eSpark-Consulting-Group/alastair-barones-salpha/Design-Files/Display-Interface-Board-v1.0/Deliverables/Renderings/3D-ISOMETRIC.png

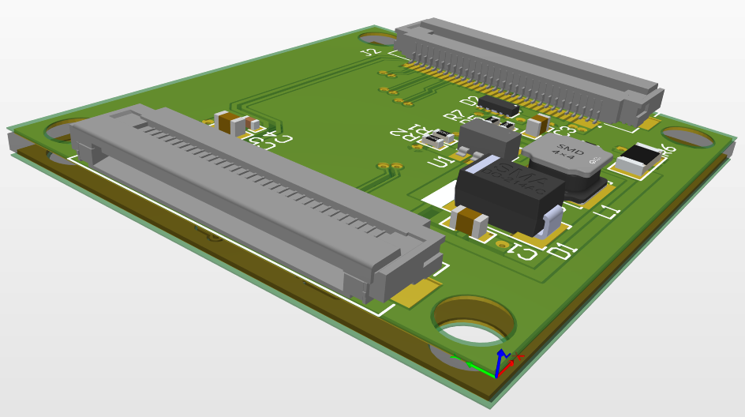
Design-Files/Display-Interface-Board-v1.0/Deliverables/Renderings/3D-ISOMETRIC.png
