eSpark-Consulting-Group/alastair-barones-salpha/README.md

# Baroness Alpha (Bike Gadget - Alastair)

## PRD
PRD is available at [this](https://github.com/eSpark-Consultants/alastair-baronessalpha/blob/main/docs/SD-MVP%20Hardware%20Build-290124-062334.pdf) link
