eSpark-Consulting-Group/alastair-barones-salpha/Design-Files/Breakout_Board/Breakout_Board/Deliverables/Renderings/Isometric_View.PNG

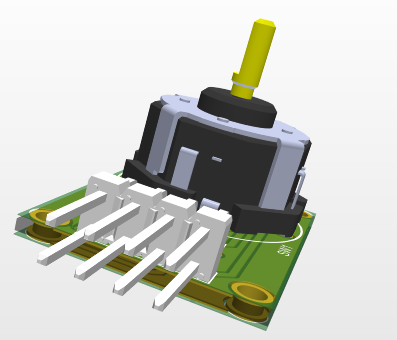
Design-Files/Breakout_Board/Breakout_Board/Deliverables/Renderings/Isometric_View.PNG
