eSpark-Consulting-Group/alastair-barones-salpha/Design-Files/Display-Interface-Board-v1.0/Deliverables/Renderings/2D-BOTTOM.png

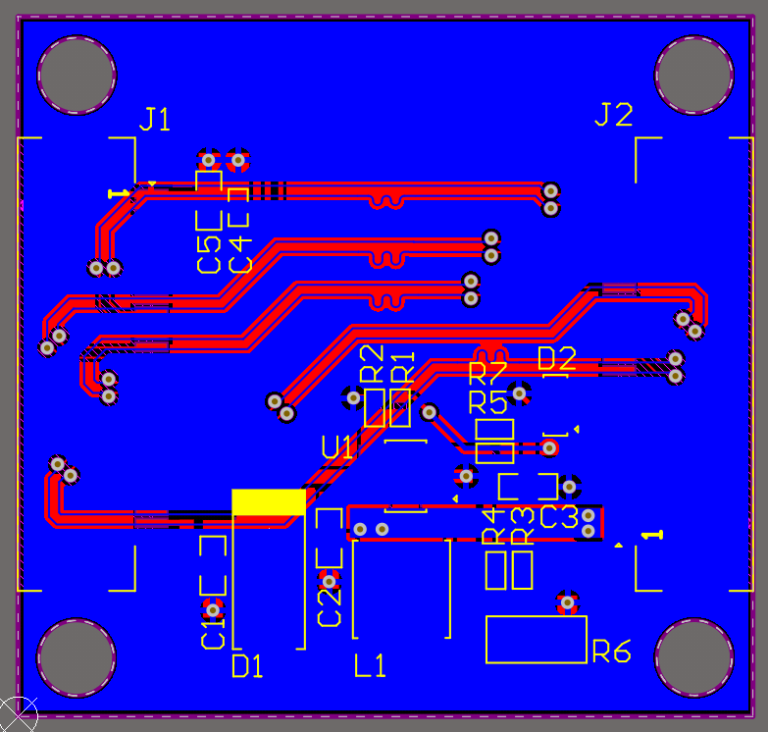
Design-Files/Display-Interface-Board-v1.0/Deliverables/Renderings/2D-BOTTOM.png
