eSpark-Consulting-Group/alastair-barones-salpha/Design-Files/Display-Interface-Board-v1.0/Deliverables/Renderings/2D-TOP.png

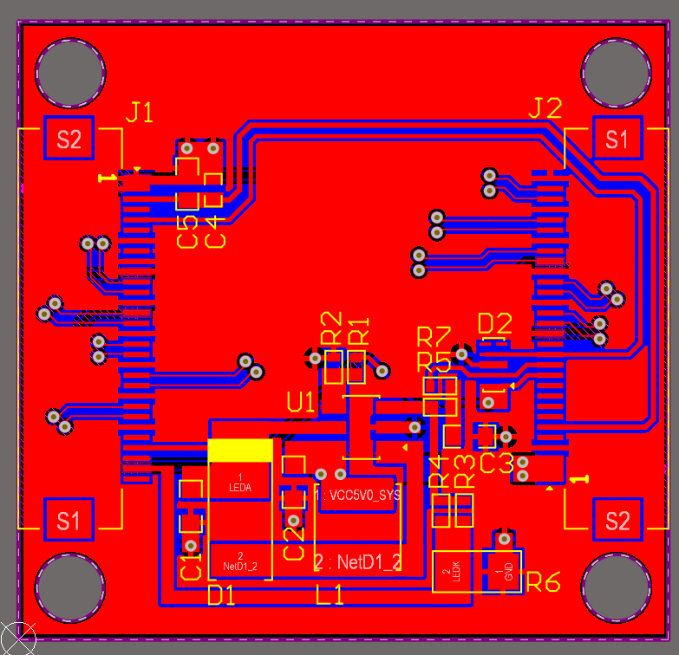
Design-Files/Display-Interface-Board-v1.0/Deliverables/Renderings/2D-TOP.png
