eSpark-Consulting-Group/alastair-barones-salpha/Design-Files/MVP-Dash-v1.0/Deliverables/Gerber File/Impedance Profile/Differential CAN (120 OHM).png

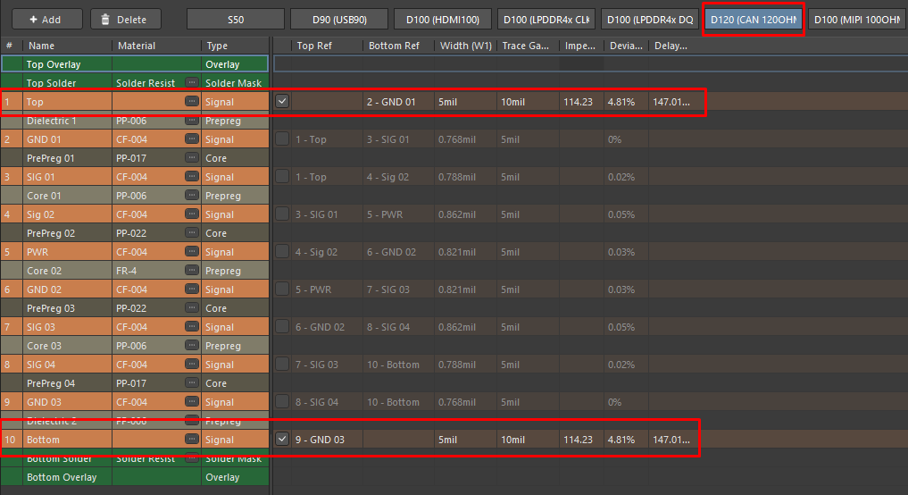
Design-Files/MVP-Dash-v1.0/Deliverables/Gerber File/Impedance Profile/Differential CAN (120 OHM).png
