eSpark-Consulting-Group/alastair-barones-salpha/Design-Files/MVP-Dash-v1.0/Deliverables/Gerber File/Impedance Profile/Differential HDMI (100 OHM).png

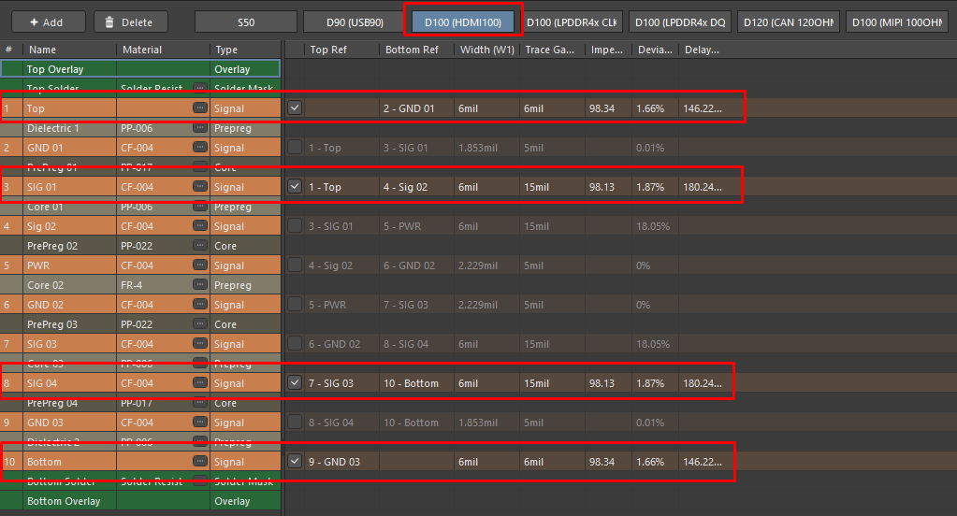
Design-Files/MVP-Dash-v1.0/Deliverables/Gerber File/Impedance Profile/Differential HDMI (100 OHM).png
