eSpark-Consulting-Group/alastair-barones-salpha/Design-Files/MVP-Dash-v1.0/Deliverables/Gerber File/Impedance Profile/DIfferential LPDDR4x CLK (100 OHM).png

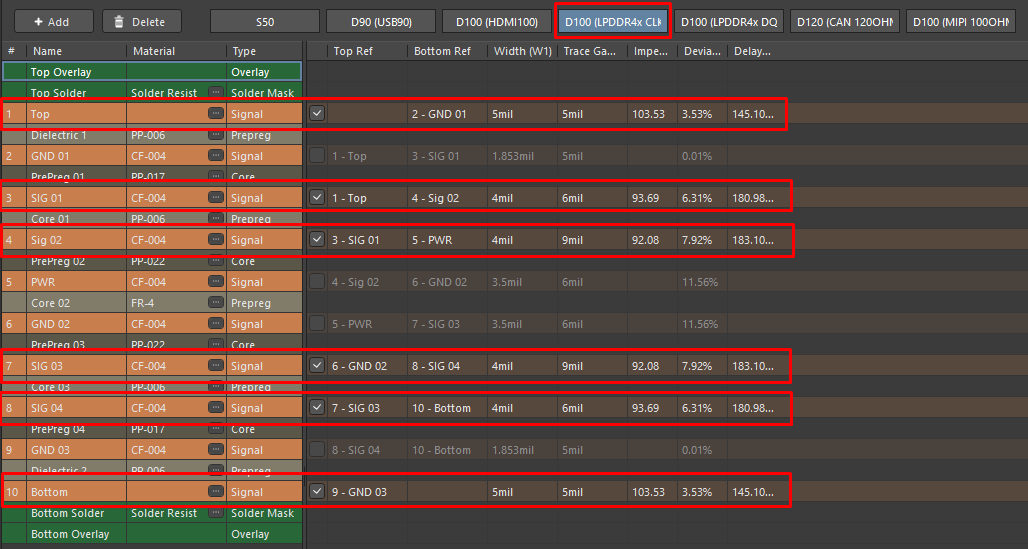
Design-Files/MVP-Dash-v1.0/Deliverables/Gerber File/Impedance Profile/DIfferential LPDDR4x CLK (100 OHM).png
