eSpark-Consulting-Group/alastair-barones-salpha/Design-Files/MVP-Dash-v1.0/Deliverables/Gerber File/Impedance Profile/Differential USB (90 OHM).png

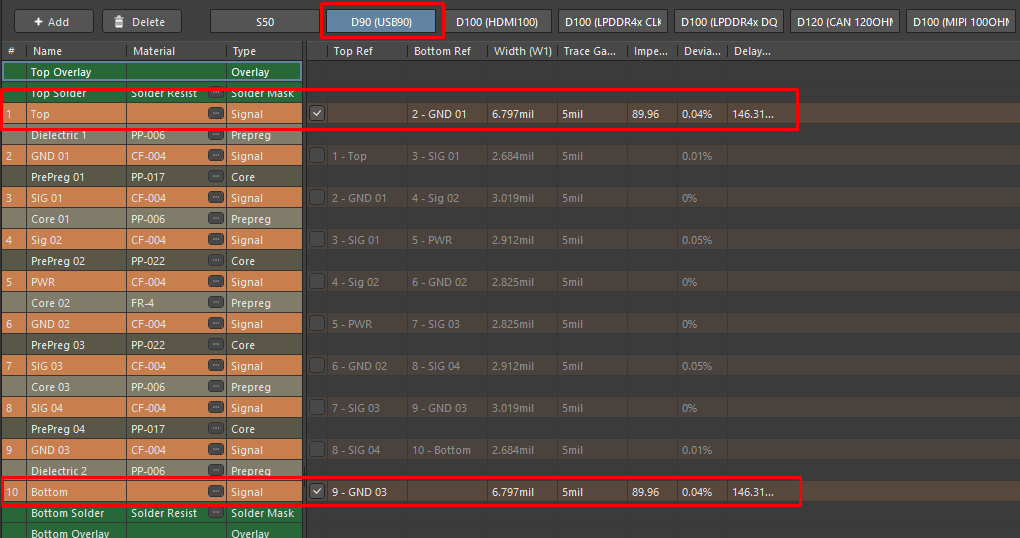
Design-Files/MVP-Dash-v1.0/Deliverables/Gerber File/Impedance Profile/Differential USB (90 OHM).png
