eSpark-Consulting-Group/alastair-barones-salpha/Design-Files/MVP-Dash-v1.0/Deliverables/Renderings/3D-BottomView.png

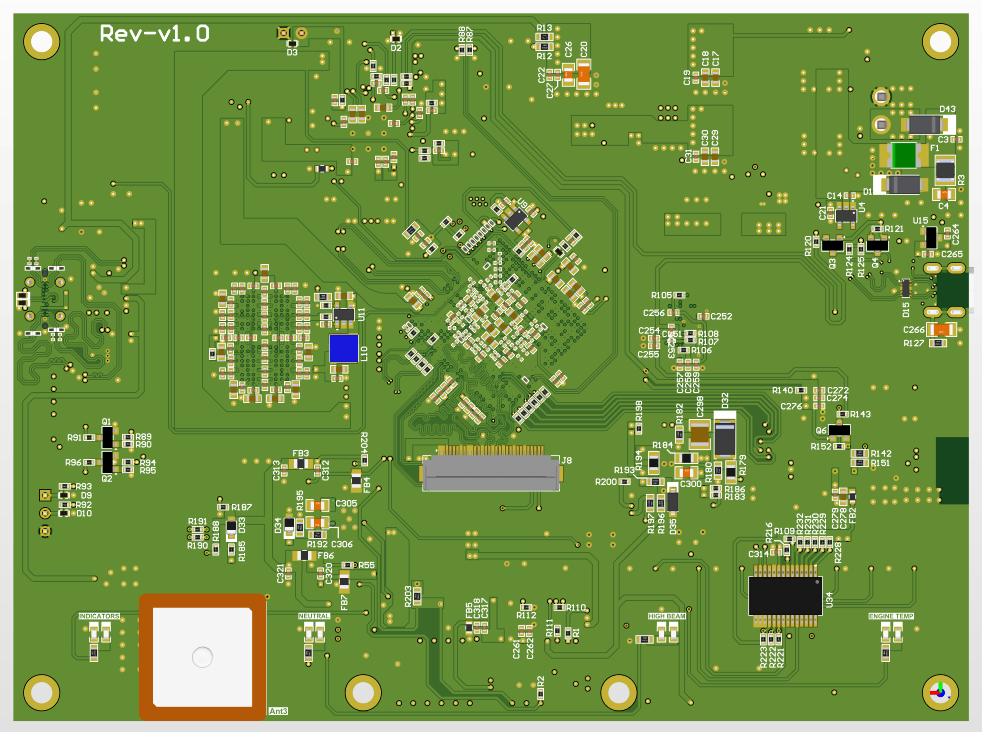
Design-Files/MVP-Dash-v1.0/Deliverables/Renderings/3D-BottomView.png
