eSpark-Consulting-Group/alastair-barones-salpha/Design-Files/MVP-Dash-v1.0/Deliverables/Renderings/3D-TopView.png

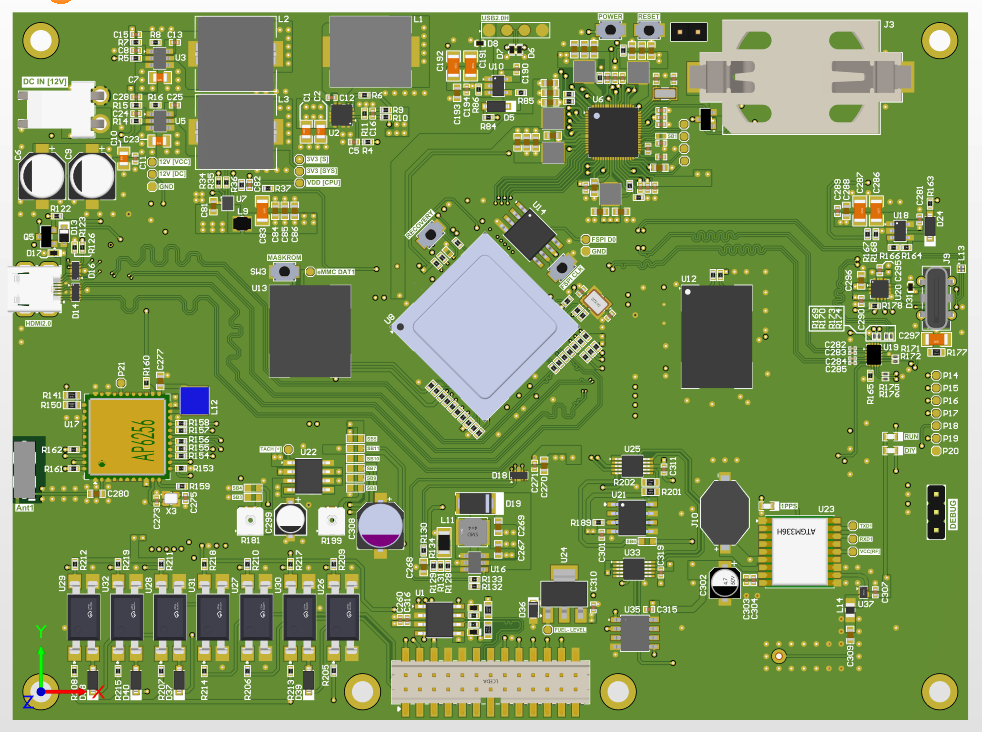
Design-Files/MVP-Dash-v1.0/Deliverables/Renderings/3D-TopView.png
