eSpark-Consulting-Group/alastair-barones-salpha/Design-Files/Pukk MVP Controller Module-v1.0/Deliverables/Renderings/2D Top View.png

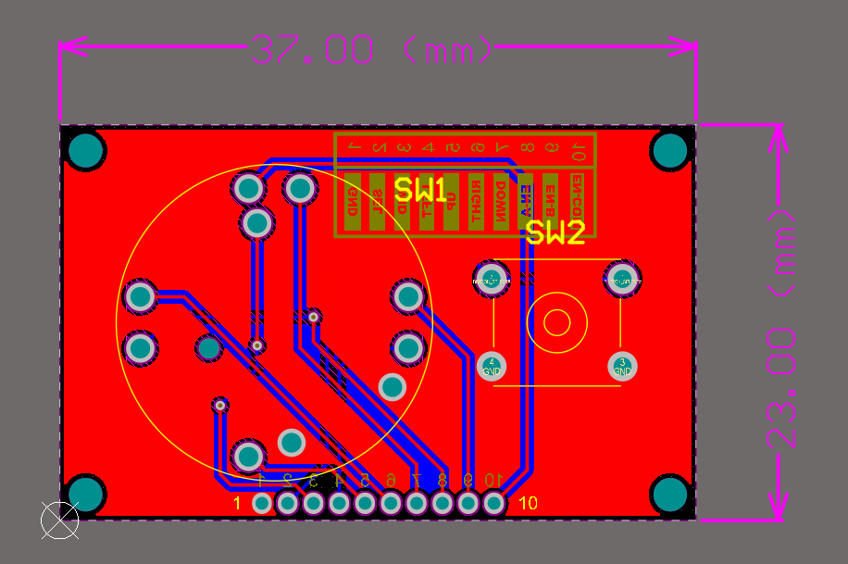
Design-Files/Pukk MVP Controller Module-v1.0/Deliverables/Renderings/2D Top View.png
