eSpark-Consulting-Group/alastair-barones-salpha/Design-Files/Pukk MVP Controller Module-v1.0/Deliverables/Renderings/3D Bottom View.png

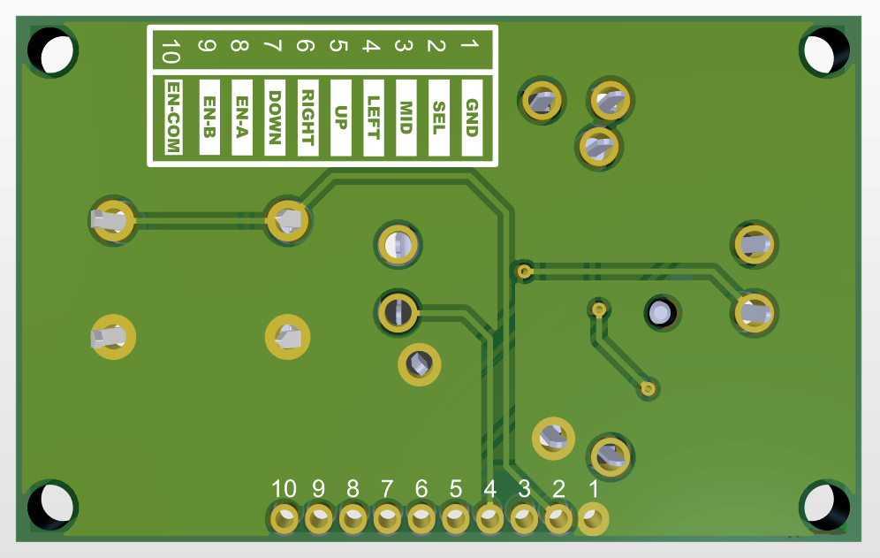
Design-Files/Pukk MVP Controller Module-v1.0/Deliverables/Renderings/3D Bottom View.png
