eSpark-Consulting-Group/alastair-barones-salpha/Design-Files/Pukk MVP Controller Module-v1.0/Deliverables/Renderings/Isometric View.png

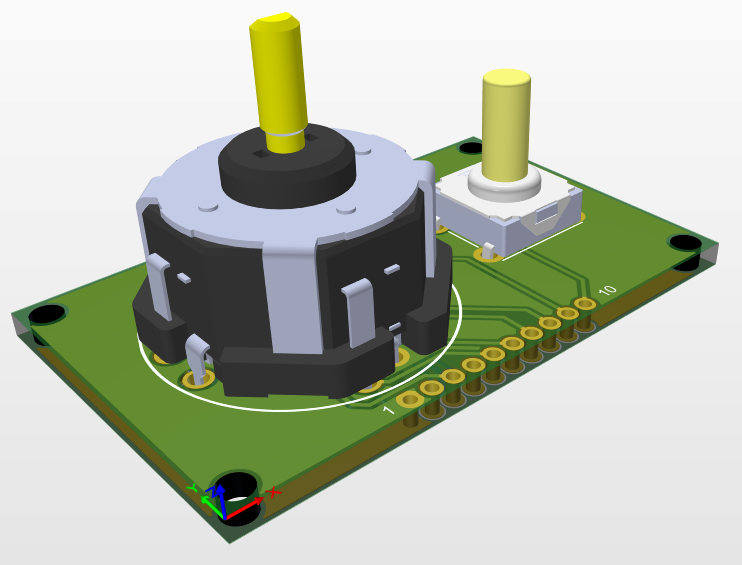
Design-Files/Pukk MVP Controller Module-v1.0/Deliverables/Renderings/Isometric View.png
