eSpark-Consulting-Group/alastair-barones-salpha/Design-Files/Pukk-Display-Module-v1.0/Deliverables/_Renderings/2D_Bottom_View.png

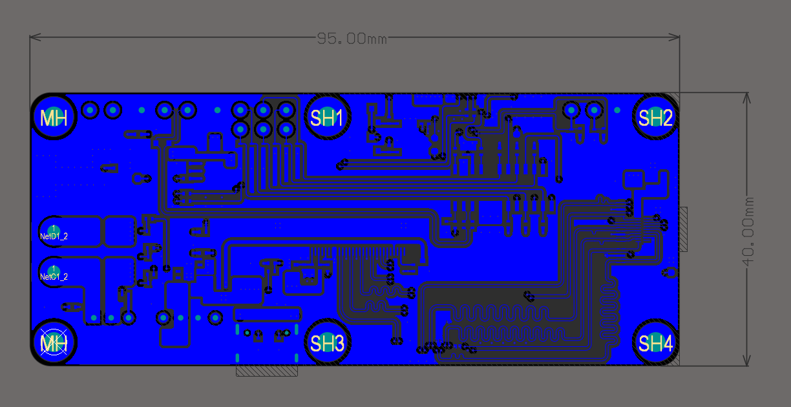
Design-Files/Pukk-Display-Module-v1.0/Deliverables/_Renderings/2D_Bottom_View.png
