eSpark-Consulting-Group/alastair-barones-salpha/Design-Files/Pukk-Display-Module-v1.0/Deliverables/_Renderings/3D_Isometric_View.png

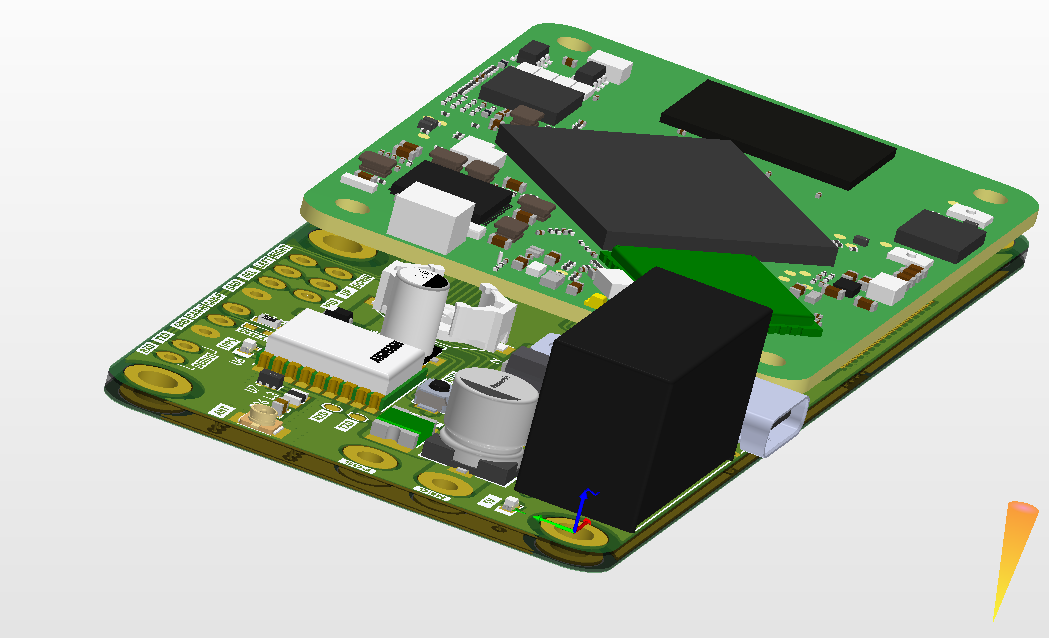
Design-Files/Pukk-Display-Module-v1.0/Deliverables/_Renderings/3D_Isometric_View.png
