eSpark-Consulting-Group/alastair-barones-salpha/Design-Files/Pukk-Display-Module-v1.0/BOM/Client-BOM-Pukk-Display-Module-v1.0.xlsx

# | Item Type | Designator | Description | Footprint | Manufacturer Part Number | Manufacturer | Value | Quantity | Link | Remarks
1 | Capacitor | C1 | CAP ALUM POLY 47UF 20% 25V SMD | 25SVPF47M | 25SVPF47M | Panasonic | 47uF | 1
2 | Capacitors | C2, C6 | CAP CER 10UF 25V X5R 0603 | Cap-0603 | GRM188R61E106MA73D | Murata | 10uF | 2
3 | Capacitors | C3 | CAP CER 1UF 25V X7R 0603 | Cap-0603 | C1608X7R1E105K080AB | TDK | 1uF | 1
4 | Capacitors | C4 | CAP CER 0.1UF 25V X7R 0603 | Cap-0603 | CC0603JRX7R8BB104 | Yageo | 0.1uF | 1
5 | Capacitor | C5 | CAP CER 22UF 10V X7R 0805 | Cap-0805 | GRM21BZ71A226ME15L | Murata | 22uF | 1
6 | Capacitor | C7, C9, C10, C12, C14, C15, C17 | CAP CER 0.1UF 16V X5R 0402 | Cap-0402 | CC0402KRX5R7BB104 | Yageo | 100nF | 7
7 | Capacitor | C8 | CAP CER 22UF 10V X5R 0402 | Cap-0402 | GRM158R61A226ME15D | Murata | 22uF | 1
8 | Capacitor | C11, C13, C24 | CAP CER 4.7UF 10V X5R 0402 | Cap-0402 | CC0402KRX5R6BB475 | Yageo | 4.7uF | 3
9 | Capacitor | C16, C18 | CAP CER 10UF 10V X5R 0402 | Cap-0402 | CC0402MRX5R6BB106 | Yageo | 10uF | 2
10 | Capacitor | C19, C20, C25, C33, C35 | CAP CER 0.1UF 50V X7R 0402 | Cap-0402 | GRM155R71H104ME14D | Murata | 0.1uF | 5
11 | Capacitor | C21, C22 | CAP CER 1UF 50V X5R 0603 | Cap-0603 | CL10A105KB8NNNC | Samsung | 1uF | 2
12 | Capacitor | C23 | CAP CER 0.22UF 25V X5R 0402 | Cap-0402 | CC0402KRX5R8BB224 | Yageo | 220nF | 1
13 | Capacitor | C26 | CAP CER 100PF 50V C0G/NPO 0603 | Cap-0603 | CC0603JRNPO9BN101 | Yageo | 100pF | 1
14 | Capacitor | C27, C29, C80 | CAP CER 0.1UF 10V X5R 0402 | Cap-0402 | CC0402KRX5R6BB104 | Yageo | 0.1uF | 3
15 | Capacitor | C28 | CAP ALUM 10uF 25V SMD | Custom | RVT1E100M0405 | ROQANG | 10uF | 1
16 | Capacitor | C30 | CAP CER 0.033UF 25V X7R 0402 | Cap-0402 | CC0402KRX7R8BB333 | Yageo | 33nF | 1
17 | Capacitor | C32, C34 | CAP CER 4.7UF 16V X5R 0402 | Cap-0402 | CL05A475MO5NUNC | Samsung | 4.7uF | 2
18 | Diode | D1 | DIODE SCHOTTKY 60V 5A SMA | SMA | SS56 | MDD | - | 1
19 | Diode | D2 | 24V 350W 13.3V 12V SOD-323 ESD and Surge Protection (TVS/ESD) ROHS | SOD-323 (Bi-directional) | SD12C.TCT | SEMTECH | - | 1
20 | Diode | D3 | TVS DIODE 5VWM 9.2VC SMA | SMA Bi Directional | SMAJ5.0CA | FTR | - | 1
21 | TVS Diodes | D4 | TVS DIODE 24VWM 40VC SOT23-3 | SOT-23 | CDSOT23-T24CAN-Q | Bourns | - | 1
22 | Diode | D5, D14, D15, D17, D18, D19, D20, D21, D22, D23 | DFN1006-2(0402) ESD Protection Devices ROHS | DFN1006-2L (Bi-Directional) | ESD5451N | TECH PUBLIC | - | 10
23 | Diode | D6, D7, D11 | 4A@8/20us 15V 7V 5V Unidirectional DFN1006-2L TVS ROHS | DFN1006-2L_ | ESD5341N-2/TR | WILLSEMI | - | 3
24 | Diode | D8, D9, D10 | 4A@8/20us 12V 7V 5V Unidirectional DFN2510-10L TVS ROHS | DFN2510-10L_ | ESD5304D-10/TR | WILLSEMI | - | 3
25 | Schottky Diode | D12 | 60V 700mV@1A 1A SMA(DO-214AC) Schottky Barrier Diodes (SBD) ROHS | SMA | SS16 | MDD | - | 1
26 | Diode | D13 | DIODE SCHOTTKY 40V 1A SOD323 | SOD-323 | B5819WS-TP | MDD | - | 1
27 | Fuse | F1 | 33V 1.5A 40A 3A 1812 Resettable Fuses ROHS | Fuse-1812_ | BSMD1812-150-33V | BHFUSE | - | 1
28 | Ferrite Bead | FB1 | 0603 180Ω ±25% DCR=0.09Ω 1.5A | IND-0603 (1608 Metric) | BLM18PG181SN1D | Murata | - | 1
29 | Connector | J2 | SMD HDMI Connectors ROHS | Custom | HDMI-101W | XUNPU | - | 1
30 | FFC / FPC Connector | J3 | CONN FFC BOTTOM 30POS 0.5MM R/A | Custom | TF31-30S-0.5SH(800) | Hirose | - | 1
31 | Battery Connector | J4 | SMD Button And Strip Battery Connector ROHS | Custom | PB-621SR13-TF | JST | - | 1
32 | RF / Coaxial Connectors | J6 | CONN U.FL RCPT STR 50 OHM SMD | Custom | U.FL-R-SMT-1(10) | Hirose | - | 1
33 | Common Mode Filter | L1 | 90Ω@100MHz 4Ω 2 0302 Common Mode Filters ROHS | 302 | SDMM0806H-2-900T | Sunlord | - | 1
34 | Inductors | L2 | FIXED IND 22UH 750MA 496MOHM SMD | Custom | VLCF5020T-220MR75-1 | TDK | 22uH | 1
35 | Inductor | L3 | 600mA 6.8nH ±5% 110mΩ 0805 Inductors (SMD) ROHS | Ind-0805 | BKW0805UC6N8JGT | FH-BK | 6.8nH | 1
36 | LED | LED1, LED4 | RED LED 0603 Light Emitting Diodes | LED-0603 | NCD0603R3 | Foshan NationStar Optoelectronics | - | 2
37 | LED | LED2 | Emerald 0603 Light Emitting Diodes (LED) ROHS | LED-0603 | NCD0603G2 | Foshan NationStar Optoelectronics | - | 1
38 | LED | LED3 | yellow 0603 Light Emitting Diodes (LED) ROHS | LED-0603 | NCD0603Y2 | Foshan NationStar Optoelectronics | - | 1
39 | Transistor | Q1, Q2 | Trans Gp Bjt NPN 25V 1.5A 300MW 3-PIN SOT-23 T/r | SOT-23 | SS8050-G | Comchip | - | 2
40 | Resistor | R1 | RES 499 OHM 1% 1/16W 0402 | Res-0402 | RC0402FR-07499RL | Yageo | 499R | 1
41 | Resistor | R2 | RES 0 OHM JUMPER 1/8W 0805 | Res-0805 | RC0805FR-070RL | Yageo | 0R | 1
42 | Resistor | R3, R19, R33, R34 | RES 10K OHM 1% 1/16W 0402 | Res-0402 | RC0402FR-0710KL | Yageo | 10K | 4
43 | Resistors | R4 | RES SMD 6.8K OHM 0.1% 1/16W 0402 | Res-0402 | RT0402BRC076K8L | Yageo | 6.8K | 1
44 | Resistor | R5 | RES 4.7K OHM 1% 1/16W 0402 | Res-0402 | RC0402FR-074K7L | Yageo | 4.7K | 1
45 | Resistor | R6, R7, R8, R9, R10, R17, R23, R24, R25, R27, R28, R32 | RES 0 OHM JUMPER 1/16W 0402 | Res-0402 | RC0402FR-070RL | Yageo | 0R | 12
46 | Resistor | R11 | RES 120 OHM 1% 1/10W 0603 | Res-0603 | RC0603FR-07120RL | Yageo | 120R | 1
47 | Resistor | ~~R12~~ | ~~RES 0 OHM JUMPER 1/8W 0805~~ | ~~Res-0805~~ | ~~RC0805FR-070RL~~ | ~~Yageo~~ | ~~DNP~~ | ~~1~~ |  | ~~DO NOT PLACE~~
48 | Resistor | R13, R14 | RES 5.1K OHM 1% 1/16W 0402 | Res-0402 | RC0402FR-075K1L | Yageo | 5.1K | 2
49 | Resistor | R15, R37, R121, R122, R123, R124, R125 | RES 1K OHM 1% 1/16W 0402 | Res-0402 | RC0402FR-071KL | Yageo | 1K | 7
50 | Resistors | ~~R16, R20~~ | ~~RES 0 OHM JUMPER 1/16W 0402~~ | ~~Res-0402~~ | ~~RC0402FR-070RL~~ | ~~Yageo~~ | ~~DNP~~ | ~~2~~ |  | ~~DO NOT PLACE~~
51 | Resistor | R18 | RES 5.1 OHM 5% 1/8W 0805 | RES-0805 | RC0805JR-075R1L | Yageo | 5.1R | 1
52 | Resistor | R21 | RES 1.5K OHM 1% 1/16W 0402 | Res-0402 | RC0402FR-071K5L | Yageo | 1.5K | 1
53 | Resistor | R22, R26, R29, R30, R31 | RES 100 OHM 1% 1/16W 0402 | Res-0402 | RC0402FR-07100RL | Yageo | 100R | 5
54 | Resistor | R35, R36 | RES 100K OHM 1% 1/16W 0402 | Res-0402 | RC0402FR-07100KL | Yageo | 100K | 2
55 | Switch | SW1, SW2, SW3 | SWITCH TACTILE SPST-NO 0.05A 12V | Custom | B3U-1000P | Omron | - | 3
56 | Power Module | U1 | SIP Isolated Power Modules ROHS | Custom | VRB1205S-10WR3 | YLPTEC | - | 1
57 | IC | U2 | IC TRANSCEIVER 1/1 8SOIC | SOIC-8(0.154", 3.90mm Width) | TCAN1044VDRQ1 | Texas Instruments | - | 1
58 | USB Connector | U3 | 5A 1 16P Female Type-C SMD USB Connectors ROHS | Custom | TYPE-C-31-M-12 | Korean Hroparts Elec | - | 1
59 | IC | U4 | IC CURRENT SWITCH SOT23-3 | SOT-23 | AP2331SA-7 | Diodes | - | 1
60 | IC | U5 | IC LED DRV RGLTR PWM 700MA 6WSON | WSON-6-EP(2x2) | TPS61161ADRVR | Texas Instruments | - | 1
61 | IC | U6 | SMD,10.1x9.7mm Satellite Positioning Modules ROHS | Custom | ATGM336H-6N-74 | ZHONGKEWEI | - | 1
62 | LNA | U7 | 1.4V~3.6V 4.3mA DFN-6(1x1.6) Low Noise Amplifiers (LNA) - RF ROHS | DFN-6(1x1.6) | AT2659 | ZHONGKEWEI | - | 1
63 | IC | U8 | IC REG LINEAR 3.3V 1.3A 6DFN | DFN-6(3x3) | ST1L05APU33R | STMicroelectronics | - | 1
64 | Headers and Wire Housings | U13A, U13B | CONN RCPT 100POS SMD GOLD | Custom | DF40C-100DS-0.4V(51) | Hirose | - | 2
65 | IC | U16 | IC INVERT SCHMITT 6CH 1IN 14SOIC | SOIC-14 | SN74HC14QDRQ1 | Texas Instruments | - | 1
66 | Peripheral | Compute Module | Radxa CM3J RK3568J 4-core CPU, Industrial Compute Module, GPU, NPU, 4K HDMI and 2x100-Pin B2B Connector | Custom | CM3J (Color: 2GB 8GB) | Radxa | - | 1 | Aliexpress (https://vi.aliexpress.com/item/1005008626884786.html) | Need to select the module with 2GB RAM and 8GB storage.
67 | Peripheral | Antenna | Active Antenna Active Ceramic Antenna With Our GPS MINI Use Ipex Interface 6M Series Universal | Custom | - | Mingwudianzi | - | 1 | Aliexpress (https://vi.aliexpress.com/i/1005004493081586.html?gatewayAdapt=glo2vnm4itemAdapt)
68 | Peripheral | Battery Cell | MC621 621 Button lithium Industrial Lithium Battery | Custom | MC621 | - | - | 1 | Aliexpress (https://vi.aliexpress.com/item/32855104889.html?pdp_)
69 | Peripheral | LCD | FHD 5.0 inch 1920x1080 SC5010 full viewing angle high brightness MIPI interface tft lcd panel display | Custom | KD050FHFID103 | - | - | 1 | Alibaba (https://www.alibaba.com/product-detail/FHD-5-0-inch-1920x1080-SC5010_1601156448052.html)
