eSpark-Consulting-Group/alastair-barones-salpha/Design-Files/Pukk-Sensor-Module-v1.0/BOM/JLCPCB-BOM-Pukk-Sensor-Module-v1.0.xlsx

Comment | Designator | Footprint | LCSC Part Number
22uF | C1, C9, C10 | Cap-0805 | C907991
100uF | C2 | EEE-FK1E101XP | C128510
330uF | C3, C43, C44, C45 | UWT1E331MNL1GS | C445067
10uF | C4 | Cap-0805 | C89831
1uF | C5 | Cap-0805 | C2167382
0.1uF | C6 | Cap-0805 | C1760
0.1uF | C7 | Cap-0603 | C307348
10uF | C8 | Cap-1210 | C596319
4.7uF | C11 | Cap-1206 | C92853
4.7uF | C12, C31, C34 | Cap-0603 | C90057
2.2uf | C13, C14 | Cap-0402 | C385032
4.7uF | C15, C30 | Cap-0402 | C326586
0.1uF | C16, C17, C18, C19, C20, C23, C25, C26, C29, C32, C33 | Cap-0402 | C541464
1uF | C21, C22, C24, C39, C40 | Cap-0402 | C326568
12pF | C27, C28 | Cap-0402 | C161305
0.1uF | C35, C36, C37, C38, C41, C42 | Cap-0402 | C105883
22uF | C46 | Cap-0805 | C86816
4.7uF | C47 | Cap-0805 | C354262
SS26 | D1 | SMA(DO-214AC) | C14238
SMAJ5.0CA | D2, D4 | SMA Bi Directional | C693487
SD15C.TCT | D3 | SOD-323 (Bi-directional) | C780130
MSP3V3HM3/89A | D5 | MicroSMP | C241899
ESDM2033MX4T5G | D6, D7, D8, D9, D10 | DFN-2(0.3x0.6) | C896720
ESDALC6V1W5 | D11 | SOT-323-5 | C703691
ESDALC6V1-1U2 | D12 | Diode-0201 | C1974498
1N4148W | D13, D16, D18, D19, D20, D22, D23, D24, D25 | SOD-123 | C917030
ES1B | D14 | SMA(DO-214AC) | C232818
1SMB5949BT3G | D15 | SMB_ | C150045
1N4148W-7-F | D17 | SOD-123 | C83528
MSP3V3HM3/89A | D21 | MicroSMP | C241899
CDSOT23-T24CAN-Q | D26, D27 | SOT-23 | C350941
1SMA4755A | D28 | SMA | C438373
0805L110SLYR | F1, F4 | Fuse-0805 | C207024
1210L075/24PR | F2 | FUSE-1210 | C207045
0805L050WR | F3 | Fuse-0805 | C207022
MMZ2012R102ATD25 | FB1, FB2 | Ind-0805 | C307765
X6511WV-03H-C60D30 | J1 | HDR1X3_ | C706875
U-E-051N-4BH21-S1B | J3 | U-E-051N-4BH21-S1B | C319153
5000 | J15 | 5000 | C5199900
5001 | J16 | 5001 | C238122
5012 | J17 | 5012 | C2906766
4.7uH | L1 | SRN4018-4R7M | C780206
RED | LED1, LED2, LED3, LED4 | LED-0603 | C3151730
Yellow | LED5 | LED-0603 | C89811
10K | R1, R11, R28, R47, R55, R61, R68, R74, R78, R83 | Res-0402 | C60490
3.9K | R2, R94 | Res-0402 | C131467
6.8K | R3 | Res-0402 | C852943
499R | R4, R6 | Res-0402 | C137970
240R | R5, R29 | Res-0402 | C114755
0R | R7, R8, R9, R10, R12, R13, R14, R15, R16, R17, R18, R19, R20, R21, R22, R23, R24, R25, R26, R27, R30, R31, R32, R33, R34, R35, R36, R37, R38, R39, R40, R41, R42, R43, R44, R45, R46, R48, R49, R50, R51, R52, R54, R56, R57, R58, R59, R84 | Res-0402 | C106231
120R | R53, R60 | Res-0603 | C114640
4.7K | R62, R72, R97, R98, R99, R100, R101 | Res-0402 | C105871
1K | R63, R69, R75, R80, R85, R89, R95 | Res-0402 | C106235
680R | R64, R65, R70, R71, R73, R76, R77, R81, R82, R86, R88, R90, R92, R96 | Res-0402 | C137948
1K | R66 | Res-1206 | C131398
330R | R67 | Res-1206 | C114944
75R | R79 | Res-0603 | C112309
49.9K | R87 | Res-0402 | C137969
10K | R91, R93 | Res-0603 | C95204
DNP | R102, R103 | Res-0603 | C95177
B3U-1000P | SW1, SW2 | B3U-1000P | C231329
VRB1205S-6WR3 | U1 | VRB1205S-6WR3 | C5369846
AP63205WU-7 | U2 | TSOT-23-6 | C2071056
ST1L05APU33R | U3 | DFN-6(3x3) | C283488
STM32H723VGT6 | U4 | LQFP-100 | C730142
USBLC6-2SC6 | U5 | SOT-23-6 | C2827654
TCAN3414DR | U6 | SOIC-8(0.154", 3.90mm Width) | C22396693
ISO1042DWR | U7 | SOIC-16-300mil | C1848126
SN74AHC1G14DBVR | U8, U14 | SOT-23-5 | C7469
VOS617A-4T | U9, U10, U11, U12, U13, U15, U16, U17, U19, U20, U21, U22, U24, U25, U27 | SOIC-4-175mil | C4749236
LM317MDCYR | U18 | SOT- 223 | C840113
ADS1115IDGSR | U23 | VSSOP-10 | C37593
ISO1540DR | U26 | SOIC-8(0.154", 3.90mm Width) | C179739
48MHz | X1 | SMD2016-4P | C3013790
