eSpark-Consulting-Group/alastair-barones-salpha/Design-Files/MVP-Dash-v1.0/BOM/Client_BOM.xlsx

# | Item Type | Designator | Description | Footprint | Manufacturer Part Number | Manufacturer | Comment | Quantity | #Column Name Error:' Remarks
1 | RF Antennas | Ant1 | RF ANT 2.4GHZ/5GHZ CHIP SLDR SMD | M830520 | M830520 | Kyocera AVX | 2.4GHZ/5GHZ | 1
2 | Antenna | Ant3 | GPS passive ceramic antenna, size 18*18* | KH-GPS181804-WY | KH-GPS181804-WY | Shenzhen Kinghelm Elec | KH-GPS181804-WY | 1
3 |  | C1, C2, C7, C10, C23, C26, C305, C306 | CAP CER 10UF 50V X5R 0805 | Cap-0805 | GRM21BR61H106ME43L | Murata | 10uF | 8
4 | Capacitor | C3, C5, C8, C11, C12, C13, C19, C22, C24, C25, C27, C31, C264, C265, C301 | CAP CER 0.1UF 50V X7R 0402 | Cap-0402 | GRM155R71H104ME14D | Murata | 0.1uF | 15
5 | Capacitor | C4 | CAP CER 2.2UF 50V X5R 0805 | Cap-0805 | CC0805KKX5R9BB225 | Yageo | 2.2uF | 1
6 | Capacitor | C6, C9 | 100uF 50V ±20% SMD,D6.3xL7.7mm Aluminum Electrolytic Capacitors - SMD ROHS | RVT1H101M0607 | RVT1H101M0607 | ROQANG | 100uF | 2
7 |  | C14, C21 | CAP CER 1UF 25V X5R 0402 | Cap-0402 | CC0402KRX5R8BB105 | Yageo | 1uF | 2
8 | Capacitor | C15, C28 | CAP CER 56PF 50V C0G/NPO 0402 | Cap-0402 | CC0402FRNPO9BN560 | Yageo | 56pF | 2
9 | Capacitor | C16 | CAP CER 100PF 50V C0G/NPO 0402 | Cap-0402 | CC0402JRNPO9BN101 | Yageo | 100pF | 1
10 | Capacitor | C17, C18, C29, C30, C43, C81, C193, C288 | CAP CER 22UF 10V X5R 0603 | Cap-0603 | CC0603MRX5R6BB226 | Yageo | 22uF | 8
11 | Capacitor | C20, C83, C191, C192, C286, C287 | CAP CER 47UF 25V X5R 1206 | Cap-1206 | GRM31CR61E476ME44L | Murata | 47uF | 6
12 | Capacitor | C32, C33, C38, C39, C45, C46, C52, C53, C55, C56, C66, C77, C80, C196 | CAP CER 10UF 10V X5R 0603 | Cap-0603 | CC0603KRX5R6BB106 | Yageo | 10uF | 14
13 | Capacitor | C34, C35, C44, C47, C49, C54, C82, C88, C194, C203, C206, C207, C208, C209, C210, C211, C212, C213, C214, C215, C217, C218, C219, C220, C221, C222, C223, C224, C225, C226, C227, C228, C229, C232, C233, C234, C235, C236, C237, C239, C240, C241, C242, C243, C244, C245, C246, C247, C248, C249, C250, C253, C254, C256, C257, C258, C261, C263, C271, C276, C279, C289, C303, C307, C314, C315, C316, C318 | CAP CER 0.1UF 10V X5R 0402 | Cap-0402 | CC0402KRX5R6BB104 | Yageo | 0.1uF | 68
14 |  | C36, C37, C50, C51, C78, C79, C84, C85, C86, C95, C96, C98, C99, C100, C101, C102, C103, C104, C197, C198, C216 | CAP CER 22UF 6.3V X5R 0603 | Cap-0603 | CC0603MRX5R5BB226 | Yageo | 22uF | 21
15 | Capacitor | C40, C41 | CAP CER 18PF 50V C0G/NP0 0402 | Cap-0402 | GCM1555C1H180GA16D | Murata | 18pF | 2
16 |  | C42, C87, C255, C259, C260, C262 | CAP CER 4.7UF 10V X5R 0402 | Cap-0402 | CC0402KRX5R6BB475 | Yageo | 4.7uF | 6
17 | Capacitor | C48, C57, C59, C60, C62, C63, C64, C65, C67, C68, C69, C71, C72, C73, C74, C75, C76, C119, C120, C121, C122, C132, C152, C153, C166, C167, C169, C173, C175, C176, C177, C183, C185, C188, C190, C204, C205, C272, C274, C281, C290, C295 | CAP CER 1UF 10V X5R 0402 | Cap-0402 | CC0402KRX5R6BB105 | Yageo | 1uF | 42
18 | Capacitor | C58, C61, C252 | CAP CER 2.2UF 6.3V X5R 0402 | Cap-0402 | C1005X5R0J225KTJA0E | TDK | 2.2uF | 3
19 | Capacitor | C70, C92, C93, C94, C112, C113, C114, C115, C117, C139, C142, C148, C149, C182, C184 | CAP CER 4.7UF 6.3V X5R 0402 | Cap-0402 | CC0402KRX5R5BB475 | Yageo | 4.7uF | 15
20 |  | C89, C90, C91, C108, C109, C110, C111, C124, C125, C126, C127, C128, C129, C130, C131, C133, C134, C135, C136, C137, C138, C140, C141, C143, C144, C145, C146, C147, C150, C151, C154, C155, C164, C165, C168, C170, C171, C172, C174, C178, C179, C180, C181, C186, C187, C189, C251, C282, C283, C284, C285, C291, C292, C293, C294 | CAP CER 0.1UF 10V X5R 0201 | CAP-0201 | CC0201KRX5R6BB104 | Yageo | 100nF | 55
21 | Capacitor | C97 | CAP CER 1UF 6.3V X5R 0201 | Cap-0201 | CC0201KRX5R5BB105 | Yageo | 1uF | 1
22 | Capacitor | C105, C106, C107, C116, C199, C200, C201, C202, C230, C231, C270, C278 | CAP CER 10UF 6.3V X5R 0603 | Cap-0603 | GRM188R60J106ME47D | Murata | 10uF | 12
23 | Capacitor | C118, C123 | CAP CER 10PF 50V C0G/NP0 0402 | Cap-0402 | GRM1555C1H100JA01D | Murata | 10pF | 2
24 | Capacitor | C156, C157, C158, C159, C160, C161, C162, C163 | 50V 1nF X7R ±10% 0201 Multilayer Ceramic Capacitors MLCC - SMD/SMT ROHS | CAP-0201 | 0201B102K500NT | FH | 1nF | 8
25 | Capacitor | C195 | CAP CER 1000PF 50V C0G/NP0 0402 | Cap-0402 | GRM1555C1H102JA01D | Murata | 1nF | 1
26 | Capacitor | C238 | CAP CER 1000PF 50V C0G/NP0 0402 | Cap-0402 | GRM1555C1H102JA01D | Murata | DNP | 1 | Do Not Place
27 | Capacitor | C266, C297 | CAP CER 4700PF 1KV X7R 1206 | Cap-1206 | CC1206KKX7RCBB472 | Yageo | 4.7nF | 2
28 | Capacitor | C267 | CAP CER 2.2UF 25V X5R 0603 | CAP-0603 | CC0603KRX5R8BB225 | Yageo | 2.2uF | 1
29 | Capacitor | C268, C269, C296 | CAP CER 1UF 50V X5R 0603 | Cap-0603 | CL10A105KB8NNNC | Samsung | 1uF | 3
30 |  | C273, C275 | CAP CER 12PF 50V C0G/NP0 0402 | Cap-0402 | GJM1555C1H120GB01D | Murata | 12pF | 2
31 | Capacitor | C277 | CAP CER 4.7UF 16V X5R 0603 | Cap-0603 | CC0603KRX5R7BB475 | Yageo | 4.7uF | 1
32 |  | C280 | CAP CER 10PF 50V C0G/NPO 0603 | Cap-0603 | CC0603JRNPO9BN100 | Yageo | 10pF | 1
33 | Capacitors | C298 | CAP CER 0.22UF 250V X7R 1210 | Cap-1210 | CC1210KKX7RYBB224 | Yageo | 220nF | 1
34 |  | C299 | 1uF 50V 8mA@120Hz ±20% SMD,D4xL5.4mm Aluminum Electrolytic Capacitors - SMD ROHS | RVT1H1R0M0405 | RVT1H1R0M0405 | Roqang | 1uF | 1
35 | Capacitor | C300 | CAP CER 10000PF 200V X7R 0805 | Cap-0805 | CC0805KKX7RABB103 | Yageo | 10nF | 1
36 | Capacitor | C302 | CAP ALUM 10uF 25V SMD | RVT1E100M0405_ | RVT1E100M0405 | ROQANG | 10uF | 1
37 | Capacitor | C304 | CAP CER 0.033UF 25V X7R 0402 | Cap-0402 | CC0402KRX7R8BB333 | Yageo | 33nF | 1
38 | Capacitor | C308 | CAP ALUM POLY 10UF 20% 50V SMD | 50SVPF10M | 50SVPF10M | Panasonic | 10uF | 1
39 |  | C309 | CAP CER 100PF 50V C0G/NPO 0603 | Cap-0603 | CC0603JRNPO9BN101 | Yageo | 100pF | 1
40 |  | C310, C311, C319 | CAP CER 0.1UF 50V X7R 0402 | Cap-0402 | CL05B104KB54PNC | Samsung | 0.1uF | 3
41 | Capacitor | C312, C313, C320, C321 | CAP CER 1UF 25V X5R 0402 | Cap-0402 | CL05A105KA5NQNC | Samsung | 1uF | 4
42 | Capacitor | C317 | CAP CER 4700PF 50V X7R 0402 | Cap-0402 | CC0402KRX7R9BB472 | Yageo | 4.7nF | 1
43 | Diode | D1, D43 | 0.5mA@40V 40V Single 3A 0.55V@3A SMA(DO-214AC) Schottky Barrier Diodes (SBD) ROHS | SMA | SS34 | MDD | SS34 | 2
44 |  | D2, D3, D6, D7, D8, D9, D10, D11, D31 | DFN1006-2(0402) ESD Protection Devices ROHS | DFN1006-2L (Bi-Directional) | ESD5451N | TECH PUBLIC | ESD5451N | 9
45 | Diode | D4 | 30V Dual Common Cathode 1V@100mA 200mA SOT-23(TO-236) Schottky Barrier Diodes (SBD) ROHS | SOT-23 | BAT54C | Shandong Jingdao Microelectronics | BAT54C | 1
46 | Diode | D5, D24 | DIODE SCHOTTKY 40V 1A SOD123 | SOD-123 | 1N5819HW-7-F | Diodes | 1N5819HW-7-F | 2
47 | Diode | D12, D17, D29, D30, D42 | 4A@8/20us 15V 7V 5V Unidirectional DFN1006-2L TVS ROHS | DFN1006-2L_ | ESD5341N-2/TR | WILLSEMI | ESD5341N-2/TR | 5
48 | Diode | D13, D33 | DIODE SCHOTTKY 40V 1A SOD323 | SOD-323 | B5819WS-TP | MDD | B5819WS | 2
49 | Diode | D14, D15, D16, D18 | 4A@8/20us 12V 7V 5V Unidirectional DFN2510-10L TVS ROHS | DFN2510-10L_ | ESD5304D-10/TR | WILLSEMI | ESD5304D-10/TR | 4
50 | Diode | D19 | 60V 700mV@2A 2A SMA(DO-214AC) Schottky Barrier Diodes (SBD) ROHS | SMA(DO-214AC) | SS26 | MDD | SS26 | 1
51 | Diode | D20, D21, D22, D23, D25, D26, D27, D28 | DFN0603-D ESD Protection Devices ROHS | DFN0603-D | ESD5311Z-2/TR | WILLSEMI | ESD5311Z-2/TR | 8
52 | Diode | D32 | 1A Single 1kV 1.1V@1A SMA(DO-214AC) Diodes - General Purpose ROHS | SMA(DO-214AC) | 1N4007 | TWGMC | 1N4007- SMD | 1
53 | Diode | D34 | 15A@8/20us 9V 5V 3.3V Unidirectional SOD-323 TVS ROHS | SOD-323 | PESDHC3D3V3U | Shanghai Prisemi Elec | PESDHC3D3V3U | 1
54 | Zener Diode | D35 | ±5% Single 15.3V~17.1V 500mW 16V SOD-123 Zener Diodes ROHS | SOD-123 | BZT52C16 | Shikues | BZT52C16 | 1
55 | TVS Diode | D36 | TVS DIODE 3.3VWM 11.5VC MICROSMP | MicroSMP |  |  | MSP3V3HM3/89A | 1
56 | Diode | D37, D38, D39, D40 | 100V 400mW Single 1.25V@150mA 8ns 300mA SOD-123 Switching Diode ROHS | SOD-123 | 1N4148W | JSMSEMI | 1N4148W | 4
57 | Fuse | F1 | 24V 3A 40A 6A 1812 Resettable Fuses ROHS | Fuse-1812_ | BSMD1812-300-24V | BHFUSE | BSMD1812-300-24V | 1
58 | Ferrite Bead | FB1, FB5 | Ferrite Beads Multi-Layer 120Ohm 25% 100MHz 2A 50mOhm DCR 0603 Paper T/R | IND-0603 (1608 Metric) | BLM18PG121SN1D | Murata Electronics | 120R | 2
59 | Ferrite Bead | FB2 | 0603 180Ω ±25% DCR=0.09Ω 1.5A | IND-0603 (1608 Metric) | BLM18PG181SN1D | Murata | BLM18PG181SN1D | 1
60 | Ferrite Bead | FB3, FB4, FB6, FB7 | FERRITE BEAD 1K OHM 0805 1LN | Ind-0805 | MMZ2012R102ATD25 | TDK | MMZ2012R102ATD25 | 4
61 | Male Header | J2 | Gold 250V 3A Straight Square Pins 2.5mm 2P 260℃ 6mm -40℃~+105℃ 3mm 2.54mm Plugin Black Brass 1x2P Plugin,P=2.54mm Pin Headers ROHS | HDR1X2_ | X6511WV-02H-C60D30 | XKB | X6511WV-02H-C60D30 | 1
62 | Connector | J3 | Battery base CR2032 SMD Battery Connectors ROHS | CR2032-BS-6-1 | CR2032-BS-6-1 | Q&J | CR2032-BS-6-1 | 1
63 | Pogo Connector | J4 | Pogo Pad 2.5mm 4 Pin | Pogo 4 Pin | POGO Connector 4 Pin |  | POGO Connector 4 Pin | 1 | Do Not Place
64 | Male Header | J5 | Gold 250V 3A Straight Square Pins 2.5mm 3P 260℃ 6mm -40℃~+105℃ 3mm 2.54mm Plugin Black Brass 1x3P Plugin,P=2.54mm Pin Headers ROHS | HDR1X3_ | X6511WV-03H-C60D30 | XKB | X6511WV-03H-C60D30 | 1
65 | Headers and Wire Housings | J6 | CONN HEADER SMD 26POS 2MM | 98424-G52-26ALF | 98424-G52-26ALF | Amphenol ICC / FCI | 98424-G52-26ALF | 1
66 | Connector | J7 | CONN RCP MICRO HDMI 19POS SMD RA | 46765-1001 | 46765-1001 | Molex | 46765-1001 | 1
67 | FFC / FPC Connector | J8 | CONN FFC BOTTOM 30POS 0.5MM R/A | TF31-30S-0.5SH(800) | TF31-30S-0.5SH(800) | Hirose | TF31-30S-0.5SH(800) | 1
68 | Type-C SMD USB Connector | J9 | 5A USB 3.1 1 260℃ Brick nogging 24P Female -45℃~+85℃ Type-C SMD USB Connectors ROHS | TYPEC-501S-ACP24H92 | TYPEC-501S-ACP24H92 | XUNPU | TYPEC-501S-ACP24H92 | 1
69 | Battery Connector | J10 | SMD Button And Strip Battery Connector ROHS | PB-621SR13-TF | PB-621SR13-TF | JST | PB-621SR13-TF | 1
70 | Wire To Board Connector | J11 | 2.00mm Pitch MicroClasp Wire-to-Board Header, Dual Row, Vertical, 24 Circuits, with PCB Locator | VH-2A | VH-2A | BOOMELE | VH-2A | 1
71 | Inductor | L1 | 13A 3.3uH Molding Choke ±20% 16A - Power Inductors ROHS | FAUL1050-3R3MT | FAUL1050-3R3MT | cjiang | 3.3uH | 1
72 | Inductor | L2, L3 | 8A 4.7uH ±20% SMD,10x10.1mm Power Inductors ROHS | YSPI1050-4R7M | YSPI1050-4R7M | YJYCOIN | 4.7uH | 2
73 | Inductor | L4, L5, L6, L7, L8 | 4.2A 470nH 合金磁胶电感 ±20% 8A SMD,3x3mm Power Inductors ROHS | YHNR3012-R47M | YHNR3012-R47M | YJYCOIN | 470nH | 5
74 | Inductor | L9 | 4.05A 240nH ±20% 19mΩ SMD Power Inductors ROHS | WPN252012HR24MT_ | WPN252012HR24MT | Sunlord | 240nH | 1
75 | Inductor | L10 | Fixed Ind 2.2UH 4.3A 48MOHM SMD | WPN4020H2R2MT_ | WPN4020H2R2MT | Sunlord | 2.2uH | 1
76 | Inductor | L11 | 590mA 22uH ±20% SMD,4x4x1.8mm Power Inductors ROHS | YNR4018-220M | YNR4018-220M | YJYCOIN | 22uH | 1
77 |  | L12 | Fixed Ind 3.3UH 2A 66 Mohm SMD | SPH4018H3R3MT_ | SPH4018H3R3MT | Sunlord | 3.3uH | 1
78 | Common Mode Filter | L13 | 90Ω@100MHz 4Ω 2 0302 Common Mode Filters ROHS | 302 | SDMM0806H-2-900T | Sunlord | SDMM0806H-2-900T | 1
79 | Inductor | L14 | 600mA 6.8nH ±5% 110mΩ 0805 Inductors (SMD) ROHS | Ind-0805 | BKW0805UC6N8JGT | FH-BK | 6.8nH | 1
80 | LED | LED1 | yellow 0603 Light Emitting Diodes (LED) ROHS | LED-0603 | NCD0603Y2 | Foshan NationStar Optoelectronics | Yellow | 1
81 | LED | LED2, LED6, LED7 | RED LED 0603 Light Emitting Diodes | LED-0603 | NCD0603R3 | Foshan NationStar Optoelectronics | Red | 3
82 | LED | LED3, LED8, LED9 | Emerald 0603 Light Emitting Diodes (LED) ROHS | LED-0603 | NCD0603G2 | Foshan NationStar Optoelectronics | Emerald | 3
83 | LED | LED4, LED5 | 20mA 100mcd~220mcd 600nm~610nm -30℃~+85℃ Orange 130° 65mW 1.6V~2.6V 0603 Light Emitting Diodes (LED) ROHS | LED-0603 | NCD0603O2 | FOSHAN Nationstar Optoelectronics | NCD0603O2 | 2
84 | LED | LED10, LED11 | blue 0603 Light Emitting Diodes (LED) ROHS | LED-0603 | NCD0603B3 | Foshan NationStar Optoelectronics | Blue | 2
85 | Transistor | Q1, Q2 | Trans Gp Bjt NPN 25V 1.5A 300MW 3-PIN SOT-23 T/r | SOT-23 | SS8050-G | Comchip | S8050 | 2
86 | MOSFET | Q3, Q4, Q5, Q6 | 30V 100mA 200mW 8Ω@4V,10mA N Channel SOT-23 MOSFETs ROHS | SOT-23 | 2SK3018 | KUU | 2SK3018 | 4
87 |  | R1, R33, R37, R45, R56, R104, R115, R116, R133, R140, R188, R190, R191 | RES 0 OHM JUMPER 1/16W 0402 | Res-0402 | RC0402FR-070RL | Yageo | 0R | 13
88 | Resistor | R2 | RES 49.9K OHM 1% 1/16W 0402 | Res-0402 | RC0402FR-0749K9L | Yageo | 49.9K | 1
89 |  | R3 | RES 2 OHM 5% 1/2W 1210 | Res_1210 | RC1210JR-072RL | Yageo | 2R | 1
90 | Resistor | R4, R5, R14, R17, R23, R30, R31, R39, R42, R52, R55, R59, R84, R89, R94, R97, R105, R106, R107, R108, R109, R117, R118, R119, R120, R121, R131, R132, R143, R152, R153, R163, R165, R167, R178, R198, R200, R204, R209, R210, R211, R212, R216, R217, R218, R219, R221, R222, R223, R228, R229, R230, R231, R232 | RES 10K OHM 1% 1/16W 0402 | Res-0402 | RC0402FR-0710KL | Yageo | 10K | 54
91 | Resistor | R6, R50, R85, R90, R95, R99, R126, R164, R186 | RES 100K OHM 1% 1/16W 0402 | Res-0402 | RC0402FR-07100KL | Yageo | 100K | 9
92 | Resistor | R7, R15 | RES SMD 93.1KOHM 0.1% 1/16W 0402 | Res-0402 | RT0402BRE0793K1L | Yageo | 93.1K | 2
93 | Resistor | R8, R16 | RES SMD 30.1KOHM 0.1% 1/16W 0402 | Res-0402 | RT0402BRD0730K1L | Yageo | 30.1K | 2
94 | Resistor | R9 | RES 20K OHM 1% 1/16W 0402 | Res-0402 | RC0402FR-0720KL | Yageo | 20K | 1
95 | Resistor | R10 | RES SMD 73.2KOHM 0.1% 1/16W 0402 | Res-0402 | RT0402BRD0773K2L | Yageo | 73.2K | 1
96 | Resistor | R11 | RES SMD 10K OHM 0.1% 1/16W 0402 | Res-0402 | RT0402BRD0710KL | Yageo | 10K | 1
97 | Resistor | R12, R13 | RES 0 OHM JUMPER 1/10W 0603 | Res-0603 | RC0603JR-070RL | Yageo | 0R | 2
98 | Resistor | R18, R19, R29, R32, R36, R91, R92, R93, R96, R187 | RES 100 OHM 1% 1/16W 0402 | Res-0402 | RC0402FR-07100RL | Yageo | 100R | 10
99 | Resistor | R20 | RES 560 OHM 1% 1/16W 0402 | Res-0402 | RC0402FR-07560RL | Yageo | 560R | 1
100 | Resistor | R21 | RES 9.1K OHM 1% 1/16W 0402 | Res-0402 | RC0402FR-079K1L | Yageo | 9.1K | 1
101 | Resistor | R22, R24, R25, R26, R35, R41, R53, R54, R98, R110, R111, R144, R145, R146, R147, R148, R149, R159, R160, R161, R162 | RES 22 OHM 1% 1/16W 0402 | Res-0402 | RC0402FR-0722RL | Yageo | 22R | 21
102 | Resistor | R27 | RES 51K OHM 0.1% 1/16W 0402 | Res-0402 | AT0402BRD0751KL | Yageo | 51K | 1
103 | Resistor | R28 | RES SMD 120K OHM 0.1% 1/16W 0402 | Res-0402 | RT0402BRD07120KL | Yageo | 120K | 1
104 | Resistor | R34 | RES 51K OHM 1% 1/16W 0402 | Res-0402 | RC0402FR-0751KL | Yageo | 51K | 1
105 | Resistor | R38 | RES SMD 0R, 1%, 0.1W, 0603 | Res-0603 | RC0603FR-070RL | Yageo | 0R | 1
106 | Resistor | R40, R44, R58, R68 | RES 120 OHM 1% 1/20W 0201 | Res-0201 | RC0201FR-07120RL | Yageo | 120R | 4
107 | Resistor | R43 | RES 1M OHM 1% 1/16W 0402 | Res-0402 | RC0402FR-071ML | Yageo | 1M | 1
108 |  | R46, R47, R48, R49, R69, R70, R80, R81, R82, R83 | RES SMD 2.2K OHM 1% 1/16W 0402 | Res-0402 | RC0402FR-072K2L | Yageo | 2.2K | 10
109 | Resistor | R51, R112, R166 | RES 4.7K OHM 1% 1/16W 0402 | Res-0402 | RC0402FR-074K7L | Yageo | 4.7K | 3
110 | Resistor | R57 | RES 200 OHM 1% 1/20W 0201 | Res-0201 | RC0201FR-07200RL | Yageo | 200R | 1
111 | Resistor | R60, R61, R62, R63, R64, R65, R66 | RES SMD 10K OHM 1% 1/20W 0201 | Res-0201 | RC0201FR-0710KL | Yageo | 10K | 7
112 | Resistor | R67 | RES SMD 10K OHM 1% 1/20W 0201 | Res-0201 | RC0201FR-0710KL | Yageo | DNP | 1 | Do Not Place
113 |  | R71, R72, R73, R74, R75, R76, R77, R78, R87, R88 | RES 2.2 OHM 1% 1/16W 0402 | Res-0402 | RC0402FR-072R2L | Yageo | 2.2R | 10
114 | Resistor | R79 | RES 1.62K OHM 0.5% 1/20W 0201 | Res-0201 | RC0201DR-071K62L | Yageo | 1.62K | 1
115 | Resistor | R86 | RES 3.3K OHM 1% 1/16W 0402 | Res-0402 | RC0402FR-073K3L | Yageo | 3.3K | 1
116 | Resistor | R100 | RES SMD 2K OHM 0.1% 1/10W 0603 | Res-0603 | RT0603BRE072KL | Yageo | 2K | 1
117 | Resistor | R101 | RES SMD 100K OHM 0.1% 1/16W 0402 | Res-0402 | RT0402BRD07100KL | Yageo | 100K | 1
118 |  | R102, R103 | RES 240 OHM 1% 1/16W 0402 | Res-0402 | RC0402FR-07240RL | Yageo | 240R | 2
119 |  | R113, R114 | 100mW Thick Film Resistors ±100ppm/℃ ±1% 60.4Ω 0603 Chip Resistor - Surface Mount ROHS | Res-0603 | RTT0360R4FTP |  | 60.4R | 2
120 |  | R122 | RES 27K OHM 0.5% 1/16W 0402 | Res-0402 | RC0402DR-0727KL | Yageo | 27K | 1
121 | Resistor | R123, R189, R205, R206, R207, R208, R213, R214, R215 | RES 1K OHM 1% 1/16W 0402 | Res-0402 | RC0402FR-071KL | Yageo | 1K | 9
122 | Resistors | R124, R125 | RES 1.8K OHM 1% 1/16W 0402 | Res-0402 | RC0402FR-071K8L | Yageo | 1.8K | 2
123 | Resistor | R127, R177 | RES SMD 1M OHM 1% 1/10W 0603 | Res-0603 | RC0603FR-071ML | Yageo | 1M | 2
124 |  | R128 | RES 0 OHM JUMPER 1/16W 0402 | Res-0402 | RC0402FR-070RL | Yageo | DNP | 1 | Do Not Place
125 | Resistor | R129 | RES 3K OHM 1% 1/16W 0402 | Res-0402 | RC0402FR-073KL | Yageo | 3K | 1
126 | Resistor | R130 | RES 82K OHM 1% 1/16W 0402 | Res-0402 | RC0402FR-0782KL | Yageo | 82K | 1
127 | Resistors | R134 | RES 8.2 OHM 1% 1/4W 1206 | Res-1206 | RC1206FR-078R2L | Yageo | 8.2R | 1
128 |  | R135, R136, R137, R138, R139 | RES 30K OHM 1% 1/16W 0402 | Res-0402 | RC0402FR-0730KL | Yageo | 30K | 5
129 | Resistor | R141, R142 | RES 15K OHM 1% 1/10W 0603 | Res-0603 | RC0603FR-0715KL | Yageo | 15K | 2
130 | Resistor | R150, R151 | RES 20K OHM 1% 1/10W 0603 | Res-0603 | RC0603FR-0720KL | Yageo | 20K | 2
131 |  | R154, R155, R156, R157, R158 | RES 33 OHM 1% 1/16W 0402 | Res-0402 | RC0402FR-0733RL | Yageo | 33R | 5
132 | Resistor | R168 | RES SMD 15K OHM 0.1% 1/16W 0402 | Res-0402 | RT0402BRD0715KL | Yageo | 15K | 1
133 |  | R169, R170, R171, R172, R173, R174, R175, R176 | RES SMD 0 OHM JUMPER 1/20W 0201 | Res-0201 | RC0201JR-070RL | Yageo | 0R | 8
134 | Resistor | R179 | RES 100K OHM 1% 1/8W 0805 | RES-0805 | RC0805FR-07100KL | Yageo | 100K | 1
135 | Resistor | R180, R197 | RES SMD 22K OHM 0.1% 1/10W 0603 | Res-0603 | RT0603BRD0722KL | Yageo | 22K | 2
136 | Potentiometer | R181, R199 | TRIMMER 100K OHM 0.1W J LEAD TOP | TC33X-2-104E_ | TC33X-2-104E | Bourns | 100k | 2
137 | Resistor | R182 | RES SMD 47K OHM 0.1% 1/10W 0603 | Res-0603 | RT0603BRD0747KL | Yageo | 47K | 1
138 |  | R183 | RES 200K OHM 0.5% 1/16W 0402 | Res-0402 | RC0402DR-07200KL | Yageo | 200K | 1
139 | Resistor | R184 | RES 1M OHM 1% 1/8W 0805 | RES-0805 | RC0805FR-071ML | Yageo | 1M | 1
140 |  | R185 | RES 1.5K OHM 1% 1/16W 0402 | Res-0402 | RC0402FR-071K5L | Yageo | 1.5K | 1
141 | Resistor | R192, R195 | RES SMD 1K OHM 0.1% 1/10W 0603 | Res-0603 | RT0603BRD071KL | Yageo | 1K | 2
142 |  | R193 | RES 470 OHM 1% 1/10W 0603 | Res-0603 | RC0603FR-07470RL | Yageo | 470R | 1
143 | Resistor | R194 | RES 0 OHM JUMPER 1/8W 0805 | Res-0805 | RC0805FR-070RL | Yageo | 0R | 1
144 | Resistor | R196 | RES SMD 10 OHM 1% 1/10W 0603 | Res-0603 | RC0603FR-0710RL | Yageo | 10R | 1
145 | Resistor | R201 | RES SMD 10K OHM 0.1% 1/10W 0603 | Res-0603 | RT0603BRD0710KL | Yageo | 10K | 1
146 | Resistor | R202 | RES SMD 2.7K OHM 0.1% 1/10W 0603 | Res-0603 | RT0603BRD07-2K7L | Yageo | 2.7K | 1
147 | Resistor | R203 | RES 75 OHM 1% 1/10W 0603 | Res-0603 | RC0603FR-0775RL | Yageo | 75R | 1
148 | Resistor | R224, R225 | RES SMD 100 OHM 1% 1/10W 0603 | Res-0603 | RC0603FR-07100RL | Yageo | 100R | 2
149 | Resistor | R226 | RES 22 OHM 1% 1/10W 0603 | Res-0603 | RC0603FR-0722RL | Yageo | 22R | 1
150 | Resistor | R227 | RES SMD 6.8 OHM 1% 1/10W 0603 | Res-0603 | RC0603FR-076R8L | Yageo | 6.8R | 1
151 | Switch | SW1, SW2, SW3, SW4, SW5 | SWITCH TACTILE SPST-NO 0.05A 12V | B3U-1000P | B3U-1000P | Omron | B3U-1000P | 5
152 | IC | U1 | IC TRANSCEIVER 1/1 8SOIC | SOIC-8(0.154", 3.90mm Width) | TCAN1044VDRQ1 | Texas Instruments | TCAN1044VDRQ1 | 1
153 | IC | U2 | IC REG BUCK ADJ 6A 10VQFN | 10-VQFN-HR (3x3) | TPS56637RPAR | Texas Instruments | TPS56637RPAR | 1
154 | IC | U3, U5 | IC REG BUCK ADJ 3A TSOT26 | SOT-23-6 | AP63300WU-7 | Diodes | AP63300WU-7 | 2
155 | IC | U4 | IC REG LIN 5V 150MA SOT25 T&R 3K | SOT-23-5 | AP7383-50WR-7 | Diodes | AP7383-50WR-7 | 1
156 | IC | U6 | QFN-68-EP(7x7) Power Management Specialized - PMIC ROHS | 68-QFN-(7x7) | RK809-5 | Rockchip | RK809-5 | 1
157 |  | U7 | Step-down type CSP1.56*1.96-20 DC-DC Converters ROHS | CSP1.56*1.96-20 | SYR838PKC | Silergy | SYR838PKC | 1
158 | IC | U8 | FCCSP-636L Microcontroller Units (MCUs/MPUs/SOCs) ROHS | FCCSP-636L | RK3568B2 | Rockchip | RK3568B2 | 1
159 | IC | U9 | IC REG LINEAR 1.8V 300MA SOT25 | SOT-23-5 | AP7331-18WG-7 | Diodes | AP7331-18WG-7 | 1
160 | IC | U10, U18 | SOT-23-5 Power Distribution Switches ROHS | SOT-23-5 | SY6280AAC | Silergy | SY6280AAC | 2
161 | IC | U11 | Step-down type SOT-23-5 DC-DC Converters ROHS | SOT-23-5 | SY8089AAAC | Silergy | SY8089AAAC | 1
162 | IC | U12 | FBGA-200 DDR SDRAM ROHS | 200-WFBGA (10x14.5) | K4UBE3D4AA-MGCL | Samsung | K4UBE3D4AA-MGCL | 1
163 | IC | U13 | eMMC 5.1 FBGA-153 eMMC ROHS | FBGA-153(11.5x13) | KLMAG1JETD-B041 | Samsung | KLMAG1JETD-B041 | 1
164 | IC | U14 | IC FLASH 128MBIT SPI/QUAD 8SOIC | SOIC-8 (208 mil) | W25Q128JWSIQ | Winbond | W25Q128JWSIQ | 1
165 | IC | U15 | IC CURRENT SWITCH SOT23-3 | SOT-23 | AP2331SA-7 | Diodes | AP2331SA-7 | 1
166 | IC | U16 | IC LED DRVR RGLTR PWM TSOT23-6 | SOT-23-6 | RT9293BGJ6 | Richtek | RT9293BGJ6 | 1
167 | IC | U17 | 802.11ac/a/b/g/n WiFi Combo Sip Module (WiFi 5), 1T1R | AP6256_ | AP6256 | SparkLan | AP6256 | 1
168 | USB Interface ICs | U19 | IC USB TYPE C CTLR PROGR 18TMLP | X2-QFN-18 | FUSB340TMX | ON Semiconductor / Fairchild | FUSB340TMX | 1
169 | IC | U20 | IC USB TYPE C CTLR PROGR 14-MLP | WFQFN-14(2.5x2.5) | FUSB302BMPX | ON Semiconductor / Fairchild | FUSB302BMPX | 1
170 | IC | U21 | ESOP-8 ADC/DAC - Specialized ROHS | ESOP-8 | GP8101S-TC50-EW | Guestgood | GP8101S-TC50-EW | 1
171 | IC | U22 | IC F/V CONV 10KHZ 8SOIC | SOIC-8(0.154", 3.90mm Width) | LM2917MX-8 | TI National Semiconductor | LM2917MX-8 | 1
172 |  | U23 | SMD,10.1x9.7mm Satellite Positioning Modules ROHS | ATGM336H-6N-74 | ATGM336H-6N-74 | ZHONGKEWEI | ATGM336H-6N-74 | 1
173 | IC | U24 | IC REG LIN POS ADJ 500MA SOT223 | SOT- 223 | LM317MDCYR | Texas Instruments | LM317MDCYR | 1
174 | IC | U25 | IC ADC 16BIT SIGMA-DELTA 10VSSOP | VSSOP-10 | ADS1115IDGSR | Texas Instruments | ADS1115IDGSR | 1
175 | IC | U26, U27, U28, U29, U30, U31, U32 | 70V 5kV 50mA 100mV@1mA,20mA 1 6V 1.2V DC SMD-4 Transistor Output Optocoupler ROHS | PC817C | PC817C | Slkor | PC817C | 7
176 | IC | U33 | IC ADC 12BIT SIGMA-DELTA 10VSSOP | VSSOP-10 | ADS1015IDGSR | Texas Instruments | ADS1015IDGSR | 1
177 | IC | U34 | IC XPNDR 1.7MHZ I2C 28SSOP | SSOP-28-208mil | MCP23017T-E/SS | Microchip | MCP23017T-E/SS | 1
178 | IC | U35 | 400kHz SO-8 I/O Expanders ROHS | SOP-8 | PCA9536D,118 | NXP Semiconductors | PCA9536D,118 | 1
179 | LNA | U37 | 1.4V~3.6V 4.3mA DFN-6(1x1.6) Low Noise Amplifiers (LNA) - RF ROHS | DFN-6(1x1.6) | AT2659 | ZHONGKEWEI | AT2659 | 1
180 | Crystal | X1 | 32.768kHz 贴片晶振 12.5pF ±20ppm ±20ppm SMD3215-2P Crystals ROHS | SMD3215-2P | XDMCZLNDDF-0.032768MHZ | TAITIEN Elec | 32.768kHz | 1
181 | Crystal | X2 | 24MHz 8pF ±10ppm SMD3225-4P Crystals ROHS | SMD3225-4P | E3SB24E000009E | Hosonic Elec | 24MHz | 1
182 |  | X3 | 37.4MHz SMD Crystal Resonator 9pF 60Ω ±10ppm -40℃~+85℃ SMD2016-4P Crystals | Q22FA12800078_ | Q22FA12800078 | Seiko | 37.4MHz | 1
183 | Peripherals | LCD | 7.0 inch 280*1424,HDMI Interfac | Custom | KD050FHFID103 | SHENZHEN STARTEK ELECTRONIC TECHNOLOGYCO.,LTD | - | 1
184 | Peripherals | Mating Connector | Rectangular Connector Housings Receptacle | Custom | 90311-026LF | Amphenol ICC | - | 1
185 | Peripherals | Mating pin Terminal | Rectangular Connector Pin | Custom | 77138-101LF | Amphenol ICC | - | 26
