eSpark-Consulting-Group/alastair-barones-salpha/Design-Files/Pukk MVP Controller Module-v1.0/Deliverables/BOM/JLCPCB-BOM-Pukk MVP Controller Module-v1.0.xlsx

Comment | Designator | Footprint | #Column Name Error:' LCSC Part Number
RKJXT1F42001 | SW1 | RKJXT1F42001
KSL0M512LFT | SW2 | KSL0M512 LFT
