eSpark-Consulting-Group/alastair-barones-salpha/Design-Files/Pukk MVP Controller Module-v1.0/Deliverables/BOM/Client-BOM-Pukk MVP Controller Module-v1.0.xlsx

# | Item Type | Designator | Description | Footprint | Manufacturer Part Number | Manufacturer | Value | Quantity | Remarks
1 | Switch | SW1 | Electromechanical Switch 4-Directional Stick Switch 0.01A Bulk | Custom | RKJXT1F42001 | Alps Alpine | - | 1
2 | Tactile Switches | SW2 | SWITCH TACTILE SPST-NO 0.05A 32V | Custom | KSL0M512LFT | ITT C&K | - | 1
