eSpark-Consulting-Group/alastair-barones-salpha/Design-Files/Breakout_Board/Breakout_Board/BOM/Client_Bom .xlsx

# | Item Type | Designator | Description | Footprint | Manufacturer Part Number | Manufacturer | Comment | Quantity | Remarks
1 | Header | J1 | 3A Right-Angle Square Pins 2.5mm 260℃@10S 8P 6mm -40℃~+105℃ 2.54mm 双排 Black 2.54mm 2x4P Push-Pull,P=2.54mm Pin Headers ROHS | Custom | PZ254-2-04-W-8.5 | HCTL | PZ254-2-04-W-8.5 | 1
2 | Switch | SW1 | Electromechanical Switch 4-Directional Stick Switch 0.01A Bulk | Custom | RKJXT1F42001 | Alps Alpine | RKJXT1F42001 | 1
