eSpark-Consulting-Group/alastair-barones-salpha/Design-Files/Breakout_Board/Breakout_Board/Deliverables/Supporting_Files/Breakout_Board.step

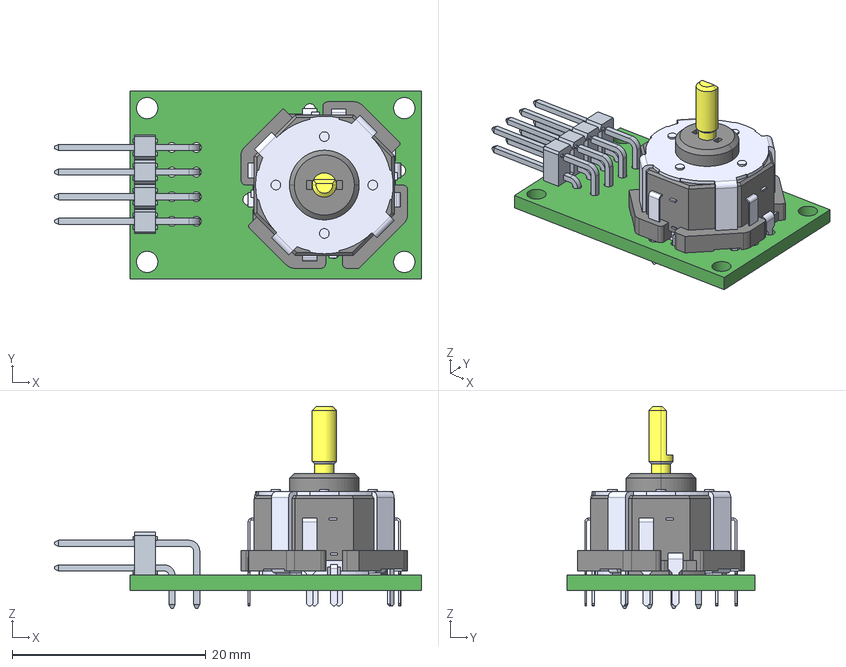
[picture p42: CAD file, 2024-06-10]
Design-Files/Breakout_Board/Breakout_Board/Deliverables/Supporting_Files/Breakout_Board.step
37.9 x 19.4 x 20.9 mm
s10129382-X08003XLF
RKJXT1F42001
