eSpark-Consulting-Group/alastair-barones-salpha/Design-Files/Pukk MVP Controller Module-v1.0/Deliverables/Supporting Files/Pukk MVP Controller_PCB.step

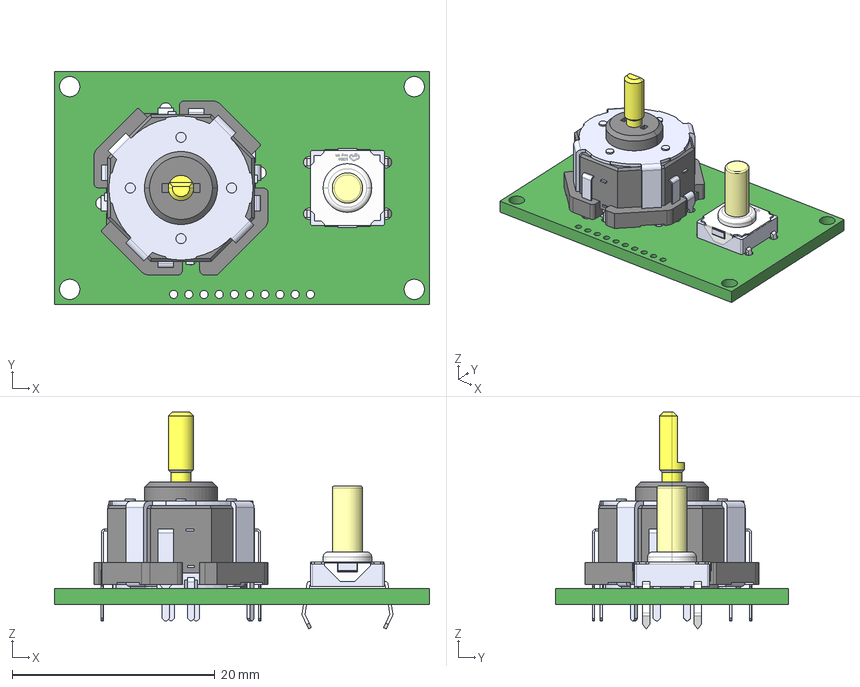
[picture p43: CAD file, 2025-04-28]
Design-Files/Pukk MVP Controller Module-v1.0/Deliverables/Supporting Files/Pukk MVP Controller_PCB.step
37.0 x 23.0 x 21.4 mm
KSL0M512 LFT
RKJXT1F42001
