eSpark-Consulting-Group/alastair-barones-salpha/Design-Files/Pukk-Display-Module-v1.0/Deliverables/_Supporting Files/Pukk-Display-Module-v1.0.DXF

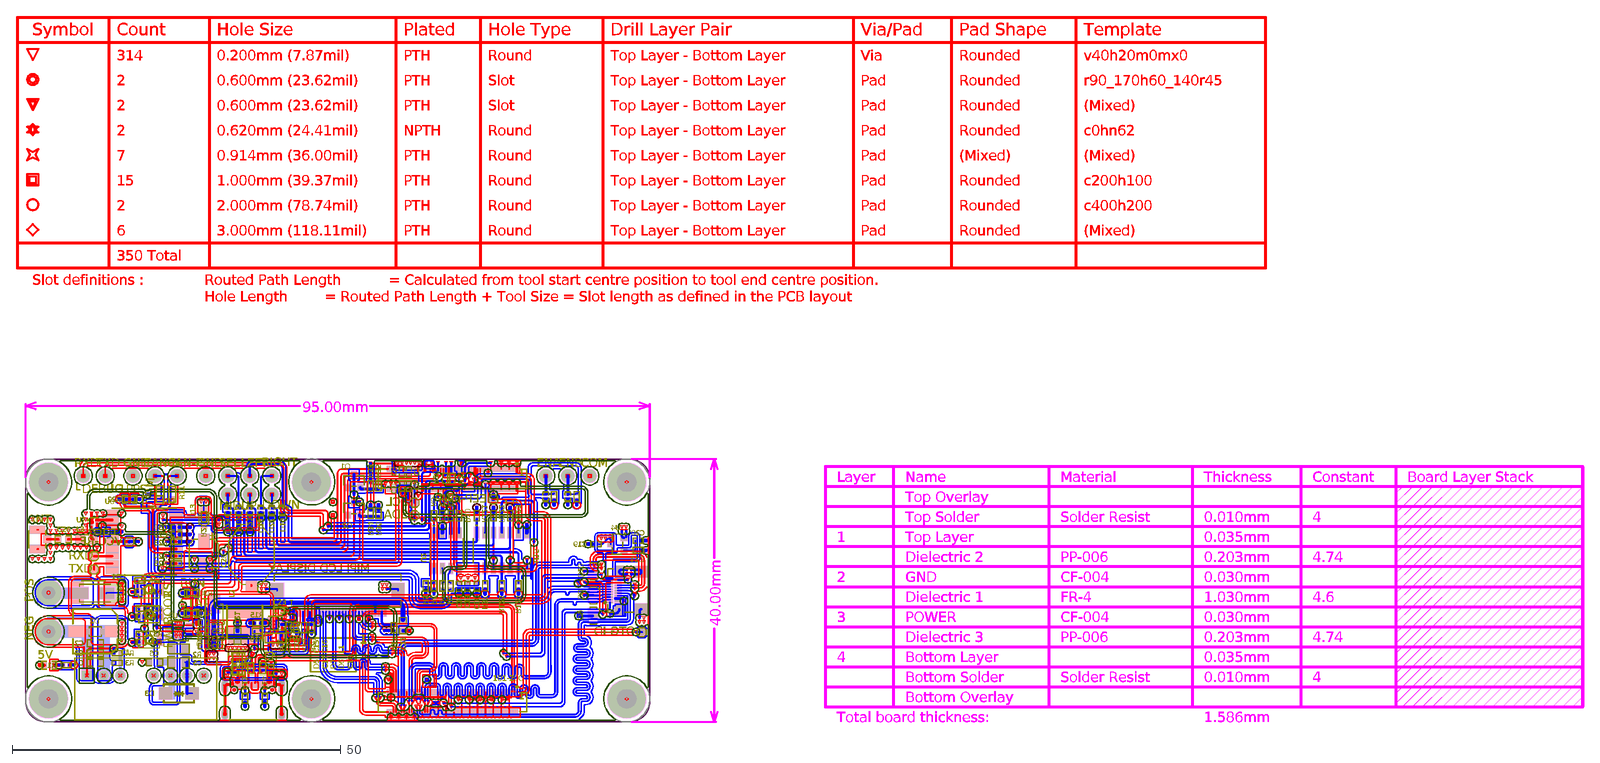
[picture p44: CAD file, 2025-04-28]
Design-Files/Pukk-Display-Module-v1.0/Deliverables/_Supporting Files/Pukk-Display-Module-v1.0.DXF
UP
CAN-N
FUSE
SEL
STAT
GND
TXD
RUN
RXD
TRM
5V
POS
DEBUG
NEG
MID
1PPS
BOOT
RST
CAN-P
PWR
ANT
LEFT
COM
ENA
ENB
1-100
101-200
1
DOWN
RIGHT
Layer
4
3
2
Name
Bottom Overlay
Bottom Solder
Bottom Layer
Dielectric 3
POWER
Dielectric 1
Dielectric 2
Top Layer
Top Solder
Top Overlay
Material
Solder Resist
PP-006
CF-004
FR-4
Thickness
0.010mm
0.035mm
0.203mm
0.030mm
1.030mm
Constant
4.74
4.6
Board Layer Stack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
