eSpark-Consulting-Group/alastair-barones-salpha/Design-Files/Pukk-Sensor-Module-v1.0/Deliverables/_Supporting Files/Pukk-Sensor-PCB.step

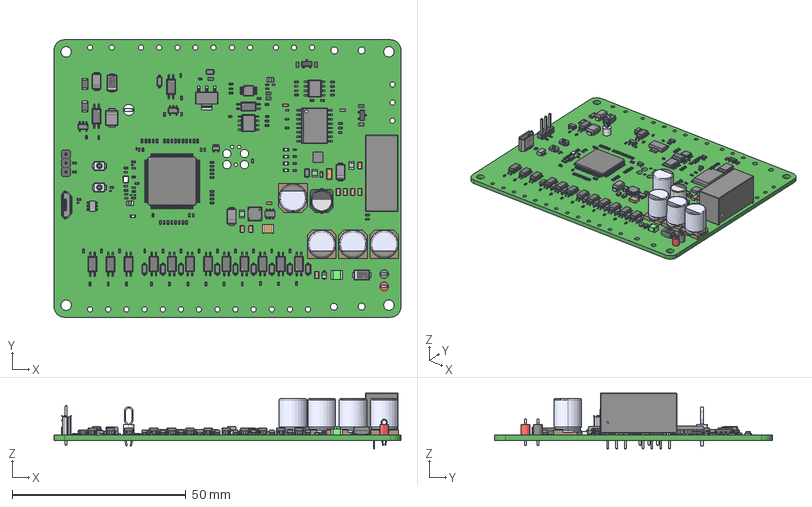
[picture p45: CAD file, 2025-03-27]
Design-Files/Pukk-Sensor-Module-v1.0/Deliverables/_Supporting Files/Pukk-Sensor-PCB.step
100.0 x 80.0 x 16.1 mm
User Library-RESC1608X05N x 7
UWT1E331MNL1GS x 4
ISO1050DWR
5012--3DModel-STEP-630548
5001--3DModel-STEP-630548
5000--3DModel-STEP-630548
User Library-DO-214AC SMA x 3
CircuitWorks-SOT-23 x 2
User Library-0805 SMD Capacitor x 8
BODY-SO x 2
LEAD-D0008A x 16
LTC2634HMSE-LMI10#PBF
User Library-SOT-223-1
SN74LV1T34DBVR x 2
21-0058I_MXM
User Library-LQFP100_05
ST1L05APU33R
User Library-TSOT-23-6(S6)
User Library-OMRON B3U1000P x 2
User Library-RES_1005-0402 x 94
User Library-CR3216-1206 x 2
User Library-LED SMD0603 x 5
User Library-Header_Male_3Pin_PinArray
User Library-Header_Male_3Pin_BodyArray
User Library-fuse0805L050WR x 3
term1
term2
1N5819HW-7-F--3DModel-STEP-56544 x 10
SOLID.step x 2
User Library-DO-214AA SMB
SMA (DO-214AC) x 2
User Library-SOT-323-5L
ESDM2032MX4T5G x 5
User Library-SOD323-1
User Library-Capacitor 0402 x 28
User Library-CAPC1608X09 x 4
User Library-1206 SMD Capacitor
User Library-CAPC3225X10
