eSpark-Consulting-Group/alastair-barones-salpha/Design-Files/Display-Interface-Board-v1.0/Deliverables/Supporting Files/DXF.DXF

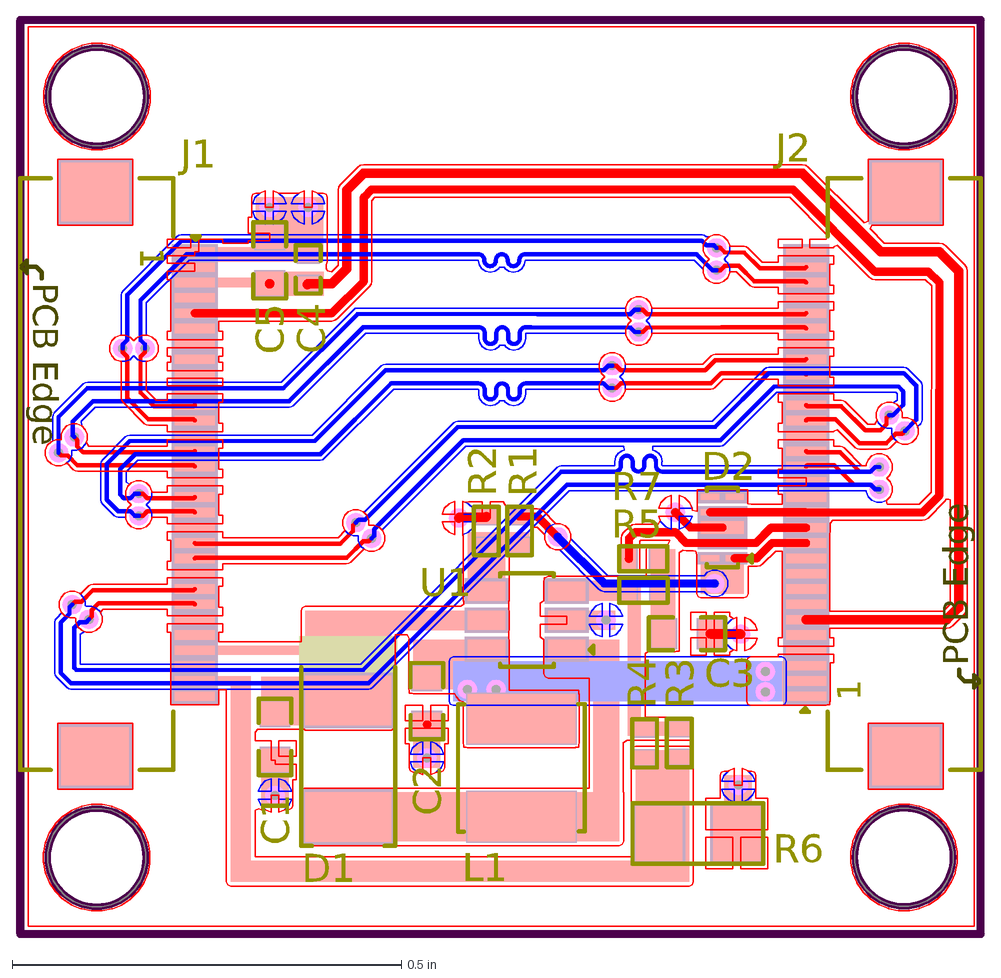
[picture p46: CAD file, 2024-05-16]
Design-Files/Display-Interface-Board-v1.0/Deliverables/Supporting Files/DXF.DXF
U1
R7
R6
R5
R4
R3
R2
R1
L1
1
PCB Edge
J2
J1
D2
D1
C5
C4
C3
C2
C1
