eSpark-Consulting-Group/alastair-barones-salpha/Design-Files/Display-Interface-Board-v1.0/Deliverables/Supporting Files/3D Step.step

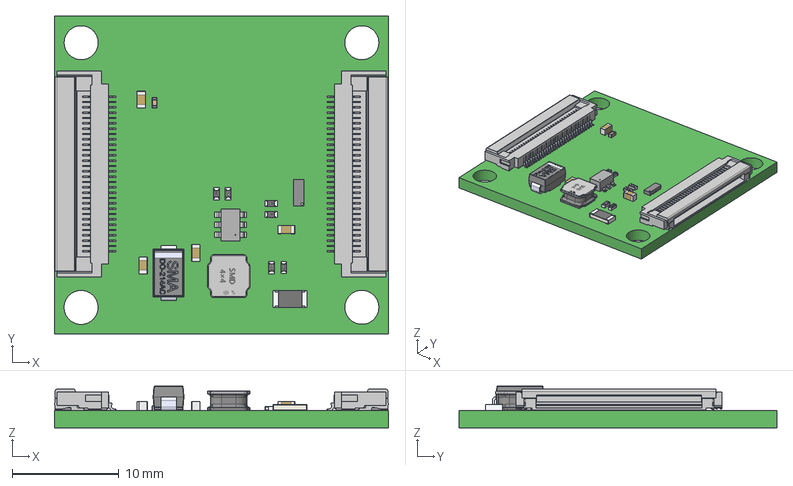
[picture p47: CAD file, 2024-05-16]
Design-Files/Display-Interface-Board-v1.0/Deliverables/Supporting Files/3D Step.step
31.3 x 29.8 x 3.90 mm
21-0058I_MXM
User Library-RES_1005-0402 x 6
User Library-CR3216-1206
TF31-30S-0_5SH-300930.PRT x 2
TPD4E05U06DQAR--3DModel-STEP-56544
SMA (DO-214AC)
User Library-CAPC1608X09 x 4
User Library-Capacitor 0402
