eSpark-Consulting-Group/alastair-barones-salpha/(list of files, cad)

Other CAD files:
Design-Files/Display-Interface-Board-v1.0/Deliverables/Supporting Files/DWG.DWG
Design-Files/Pukk MVP Controller Module-v1.0/Deliverables/Supporting Files/Pukk MVP Controller_PCB.DXF
Design-Files/Pukk-Display-Module-v1.0/Deliverables/_Supporting Files/Pukk-Display-Module-v1.0..DWG
Design-Files/Pukk-Sensor-Module-v1.0/Deliverables/_Supporting Files/Pukk-Sensor-PCB.DWG
Design-Files/Pukk-Sensor-Module-v1.0/Deliverables/_Supporting Files/Pukk-Sensor-PCB.DXF
