eSpark-Consulting-Group/alastair-barones-salpha/Design-Files/Pukk-Sensor-Module-v1.0/Schematic/Pukk-Sensor-Module-v1.0.pdf

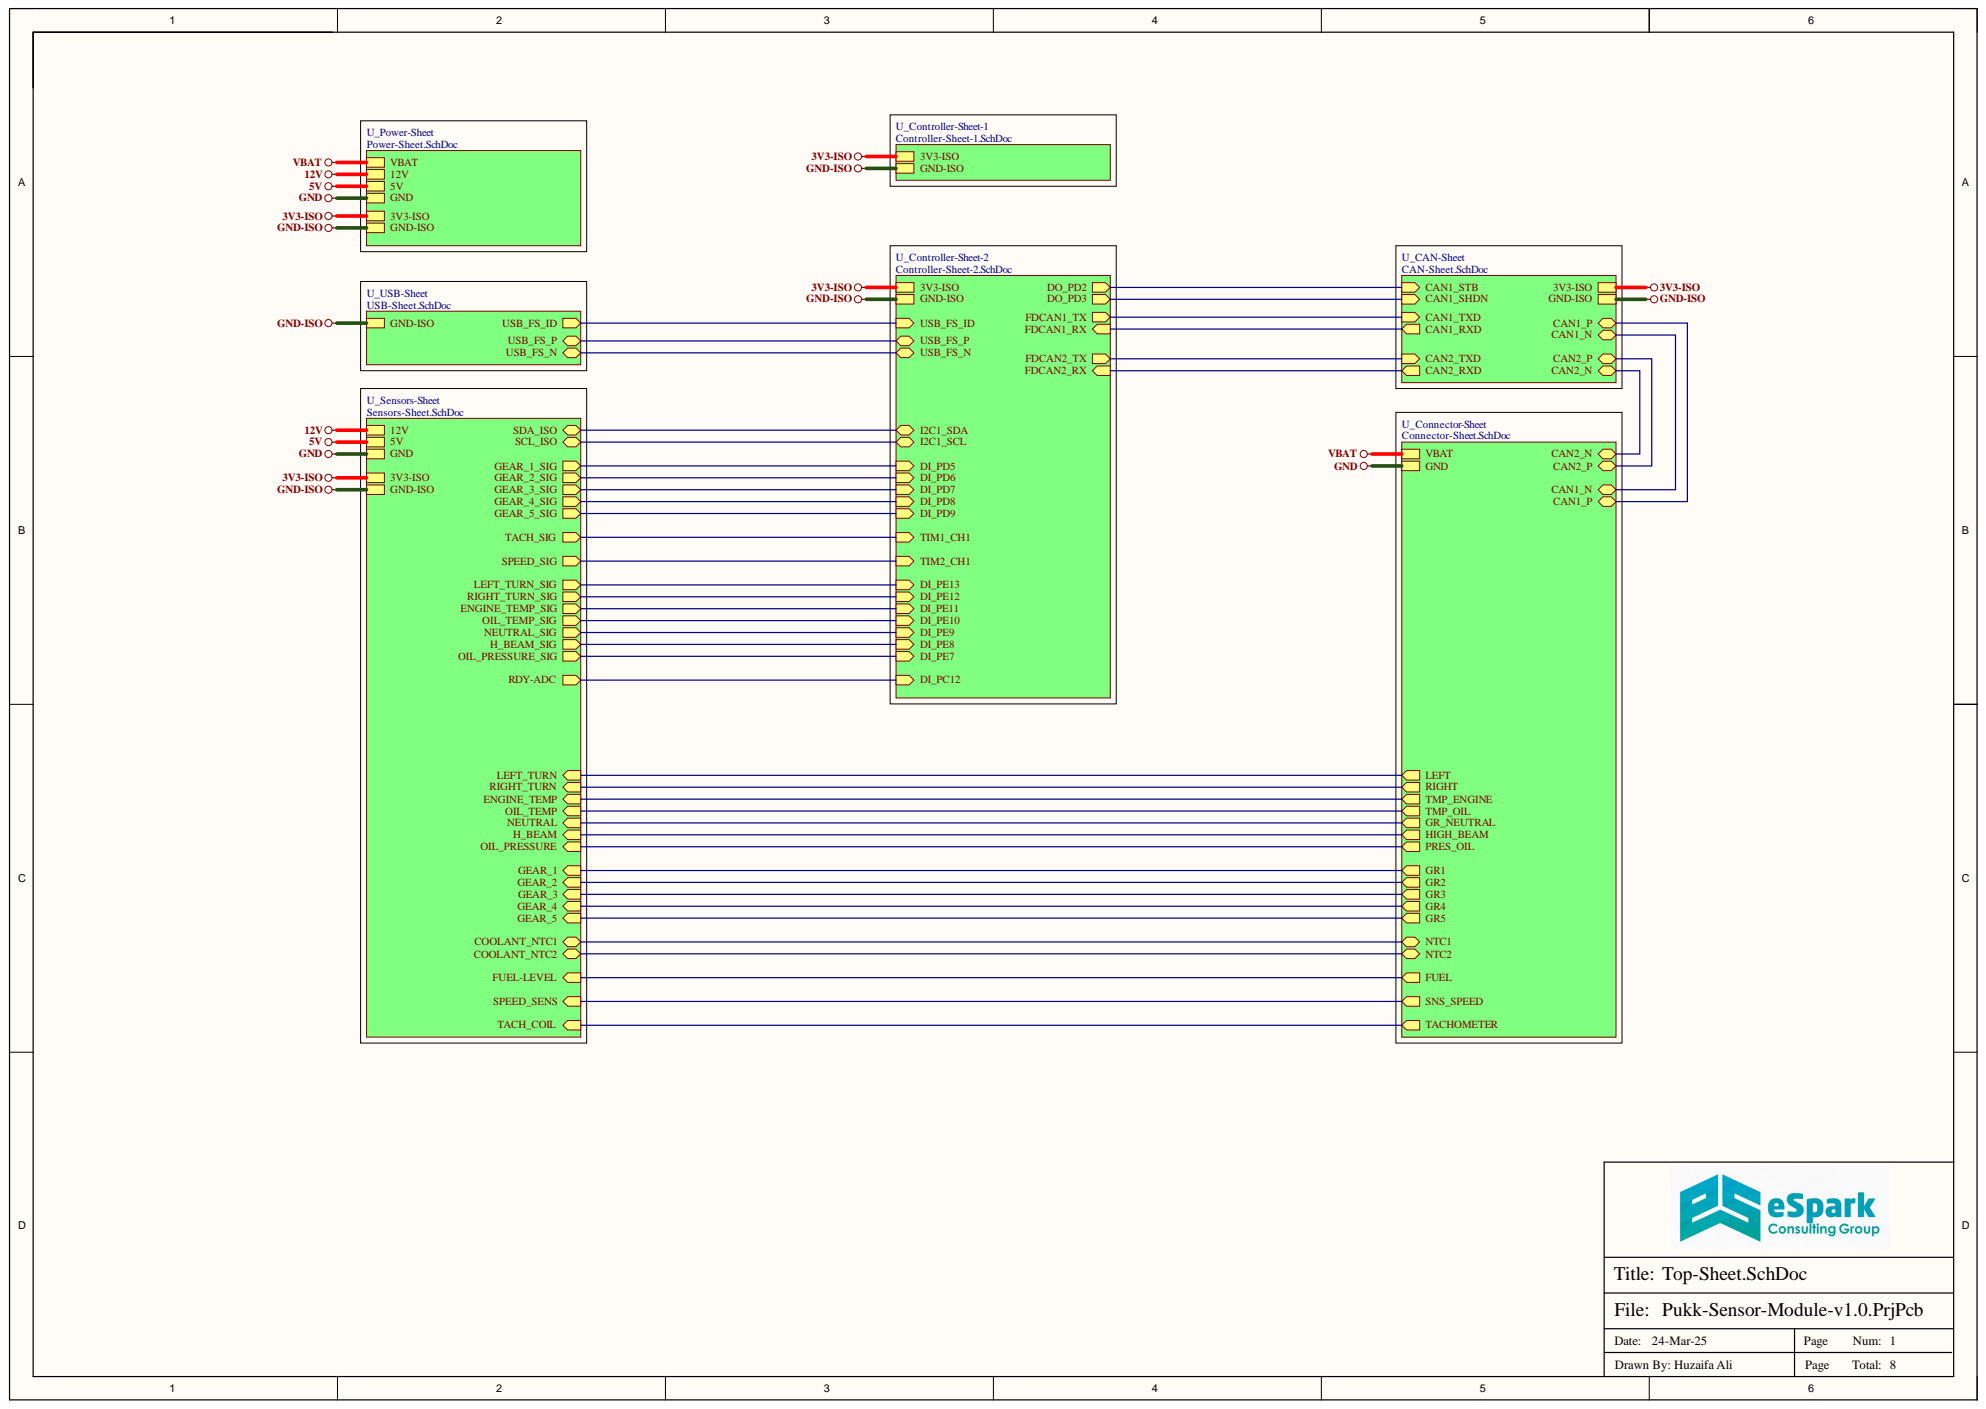
[picture p51: page 1]

Pukk-Sensor-Module-v1.0.PrjPcb

Date: 24-Mar-25 | Page Num: 1

Drawn By: Huzaifa Ali | Page Total:

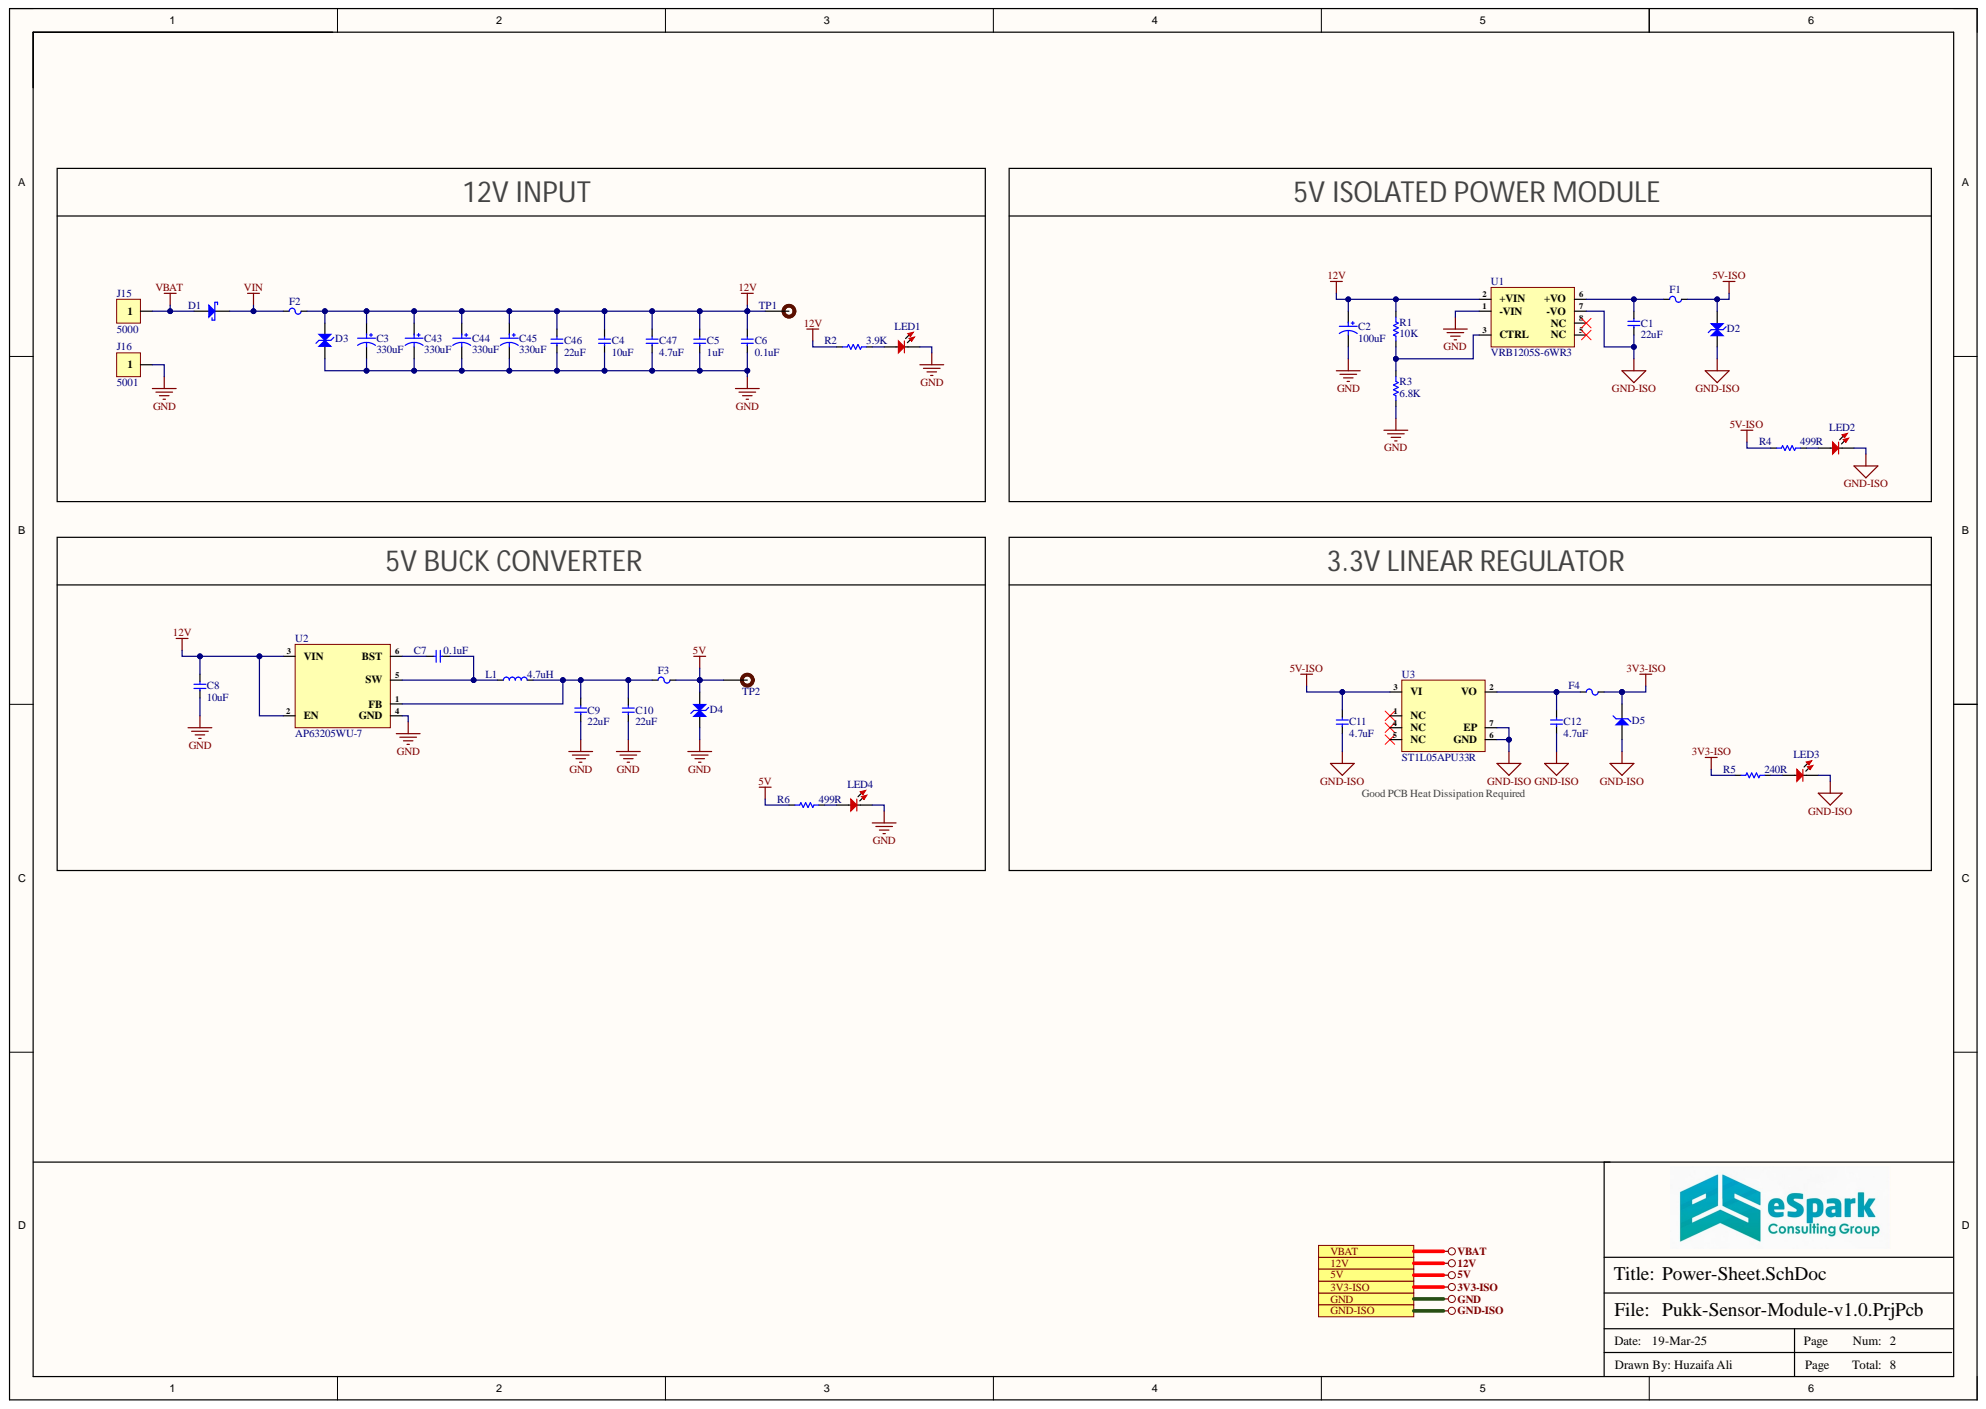
[picture p52: page 2]

Good PCB Heat Dissipation Required

Pukk-Sensor-Module-v1.0.PrjPcb

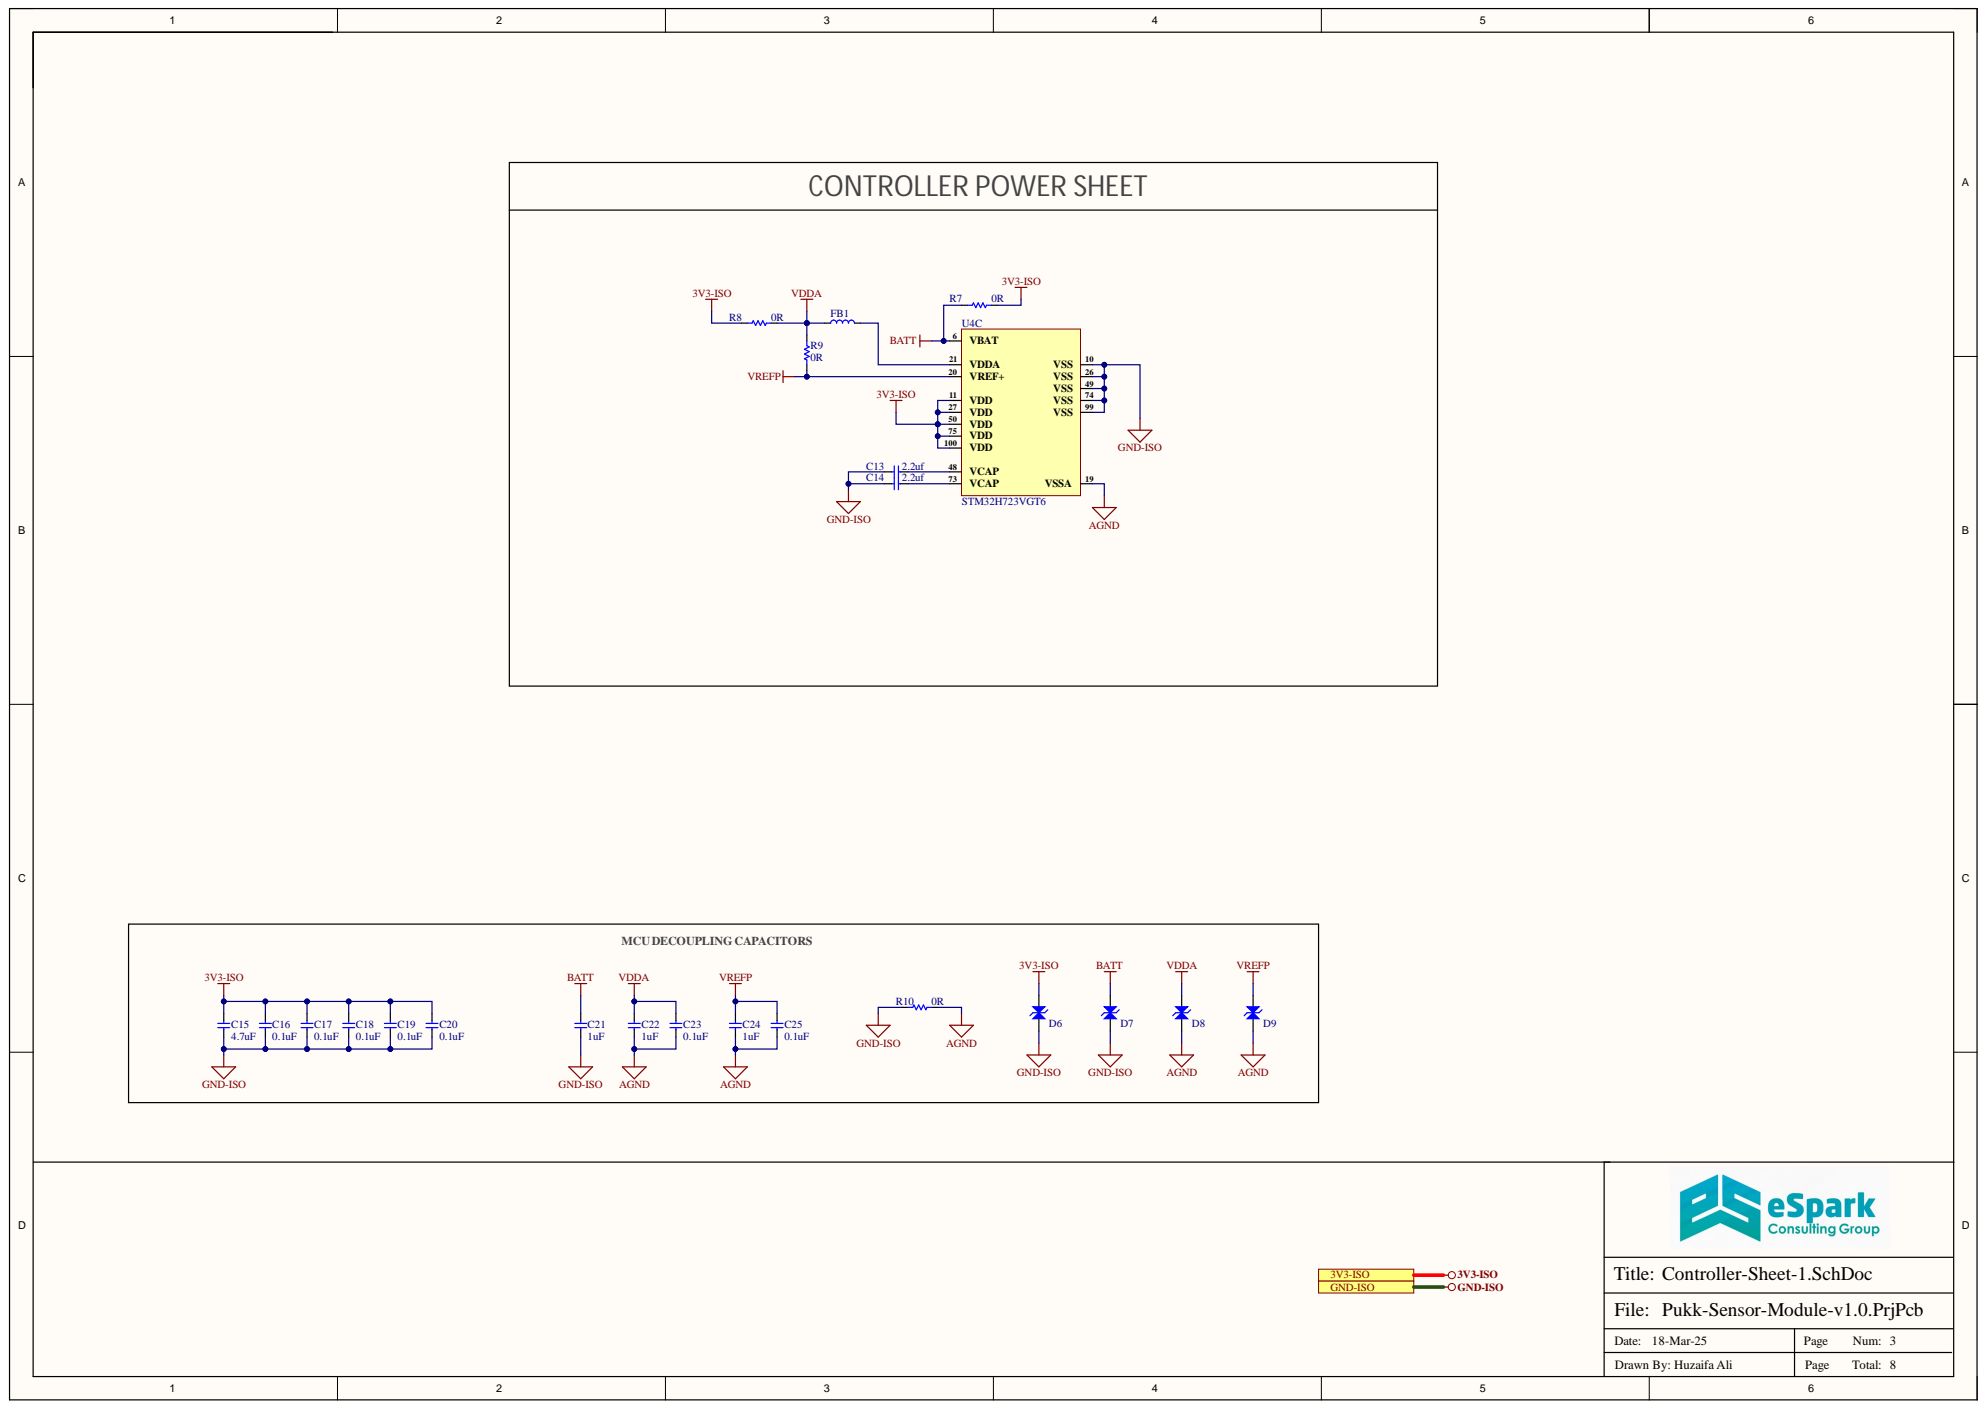
[picture p53: page 3]

VDD 27
VDD 50
VDD 75

Pukk-Sensor-Module-v1.0.PrjPcb

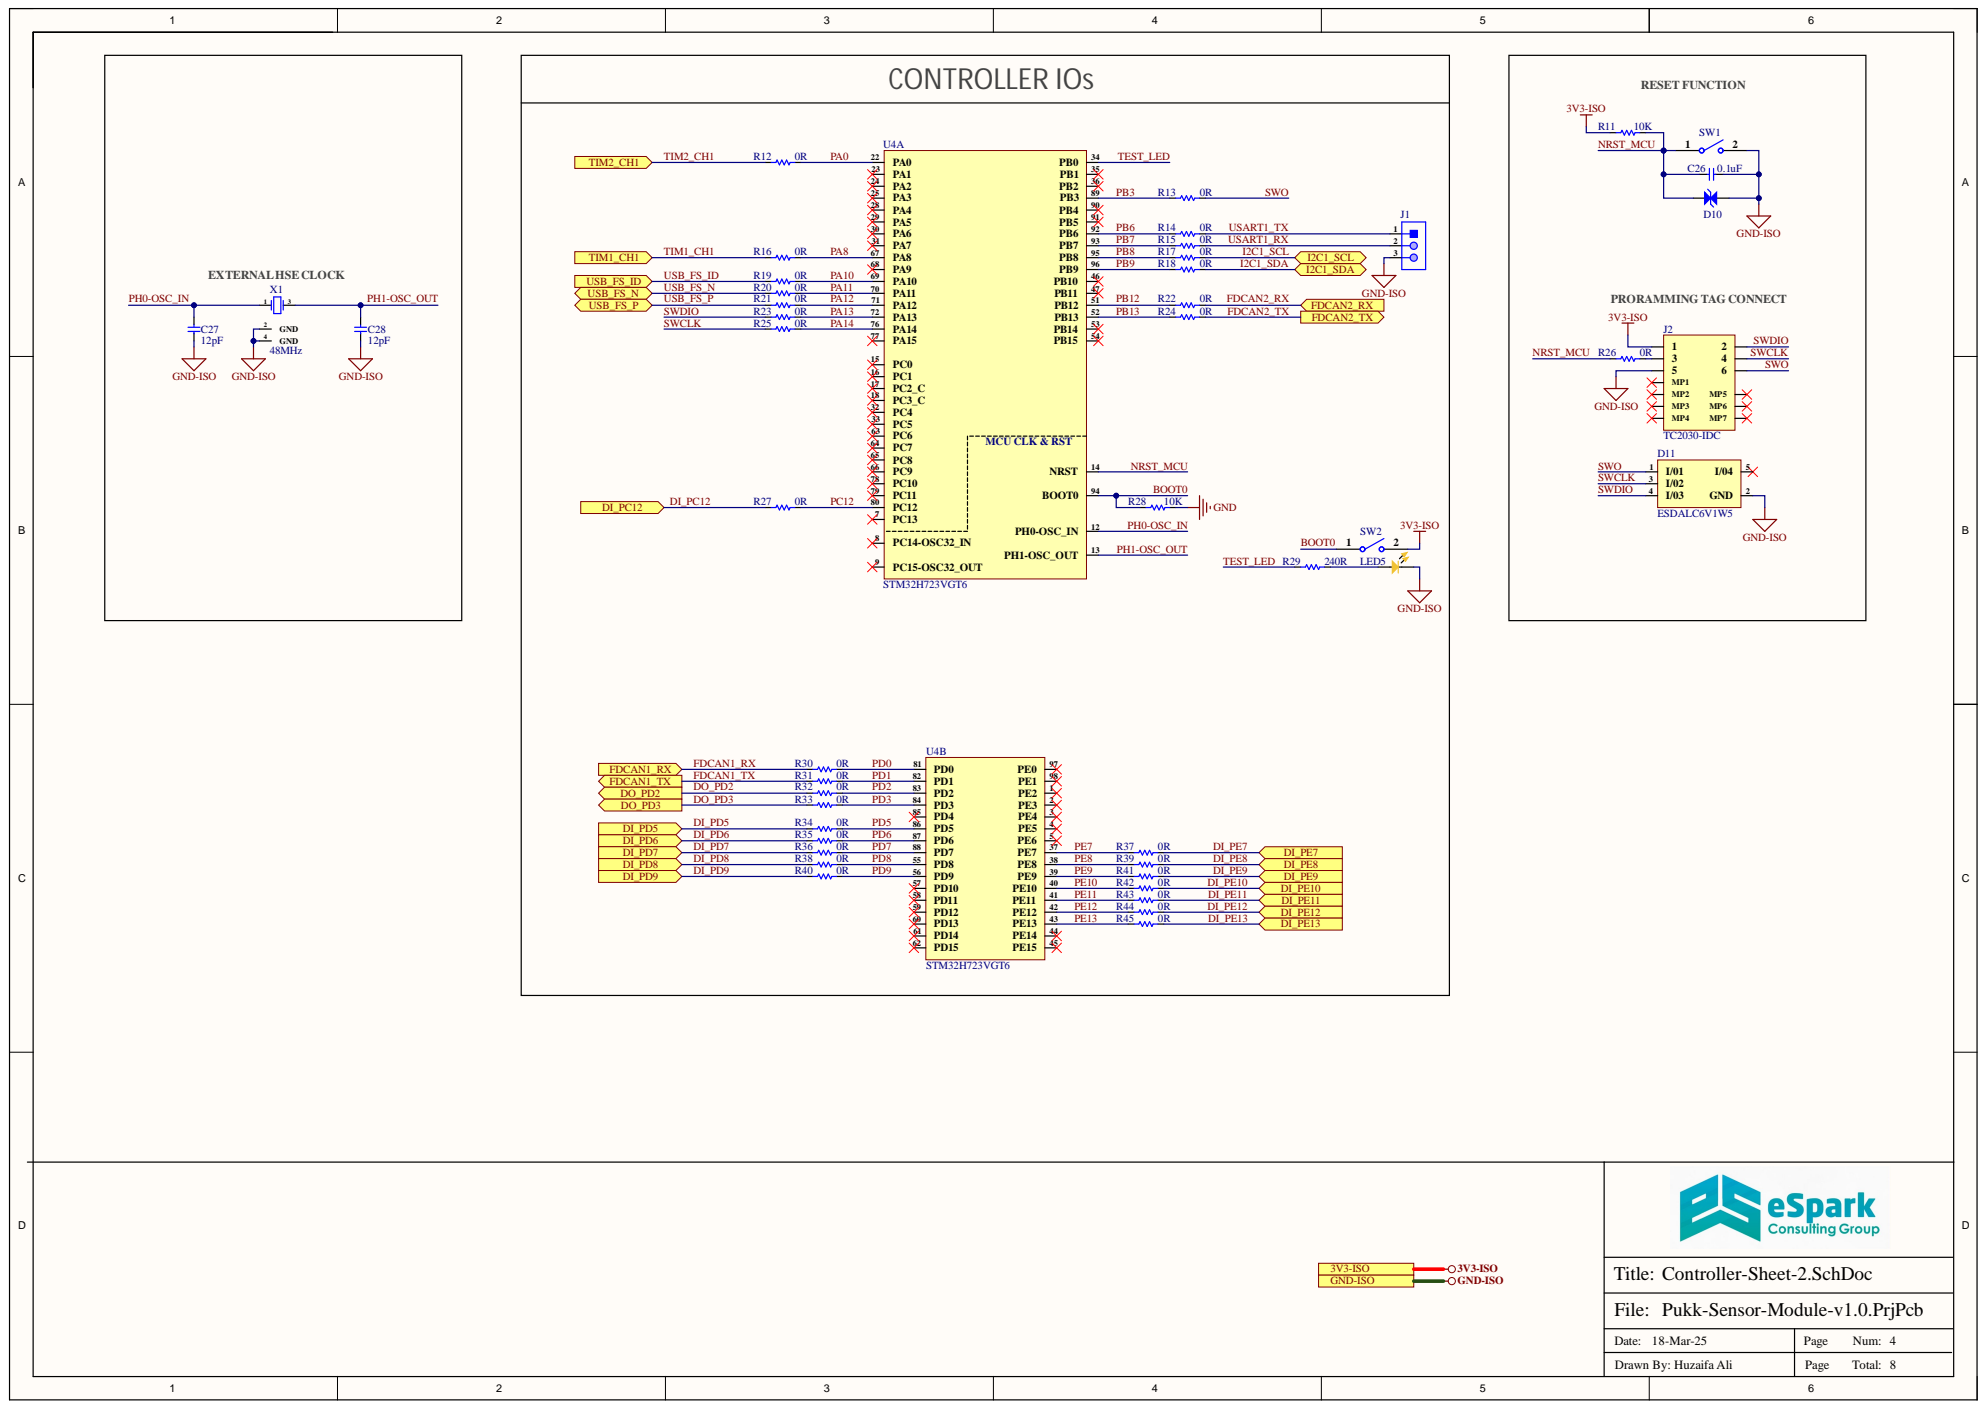
[picture p54: page 4]

Pukk-Sensor-Module-v1.0.PrjPcb

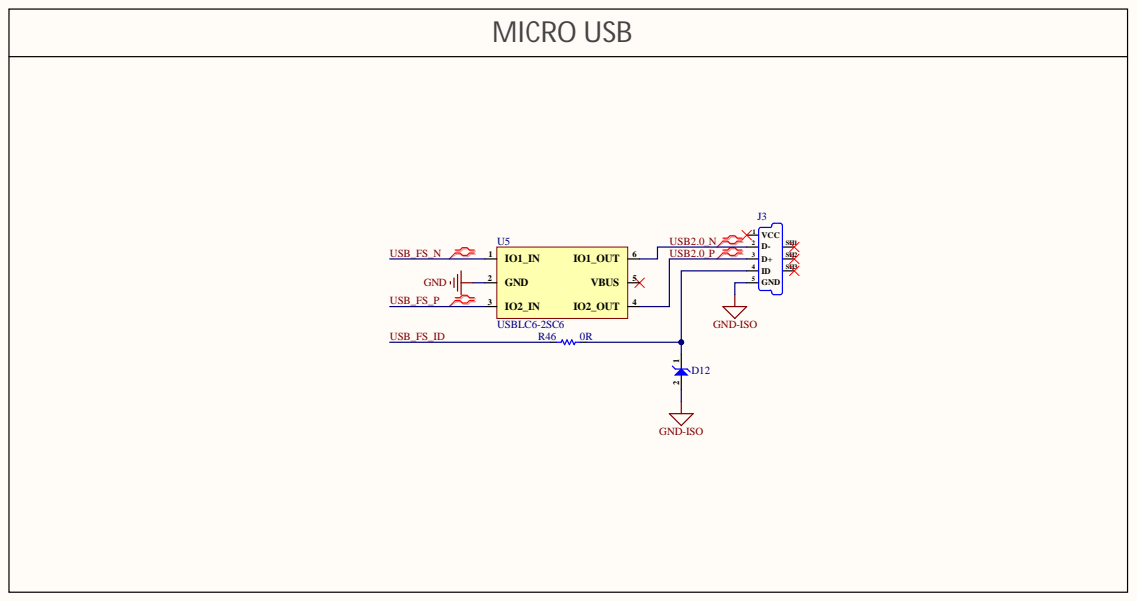
[picture p55: page 5]

Pukk-Sensor-Module-v1.0.PrjPcb

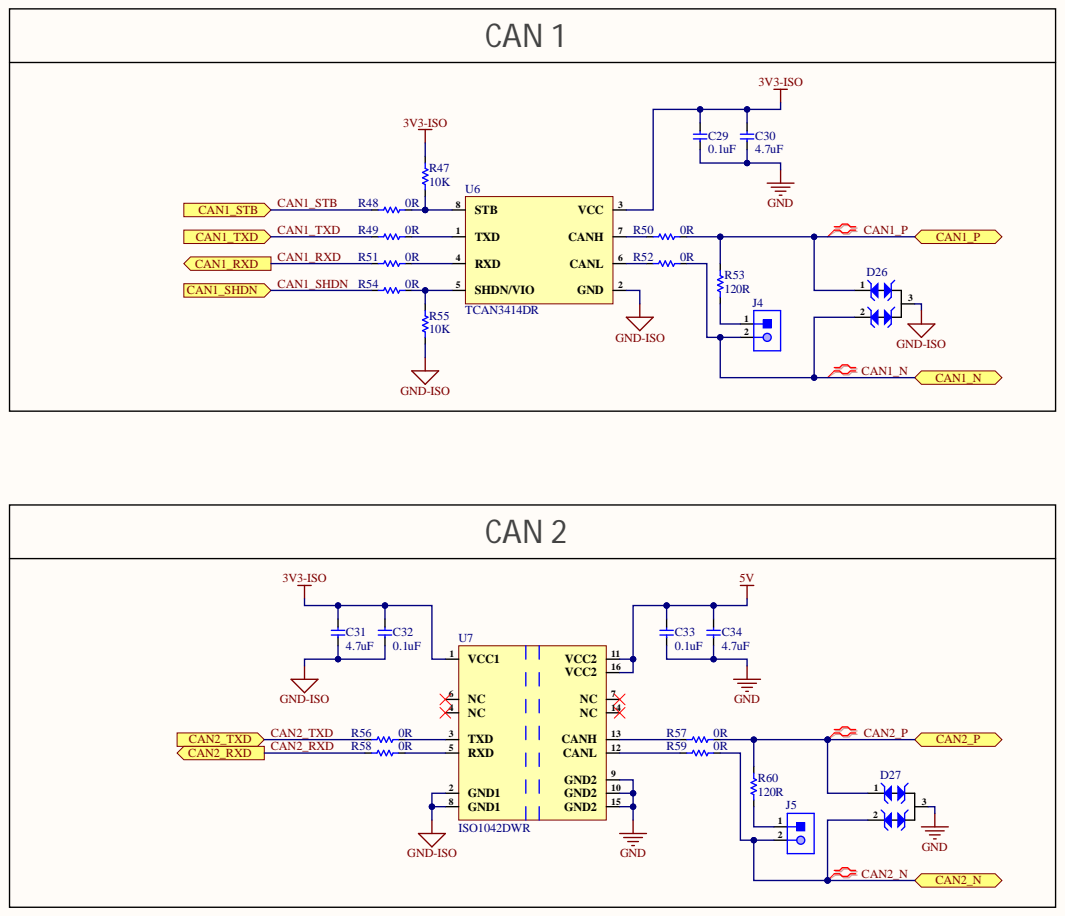
[picture p56: page 6]

Pukk-Sensor-Module-v1.0.PrjPcb

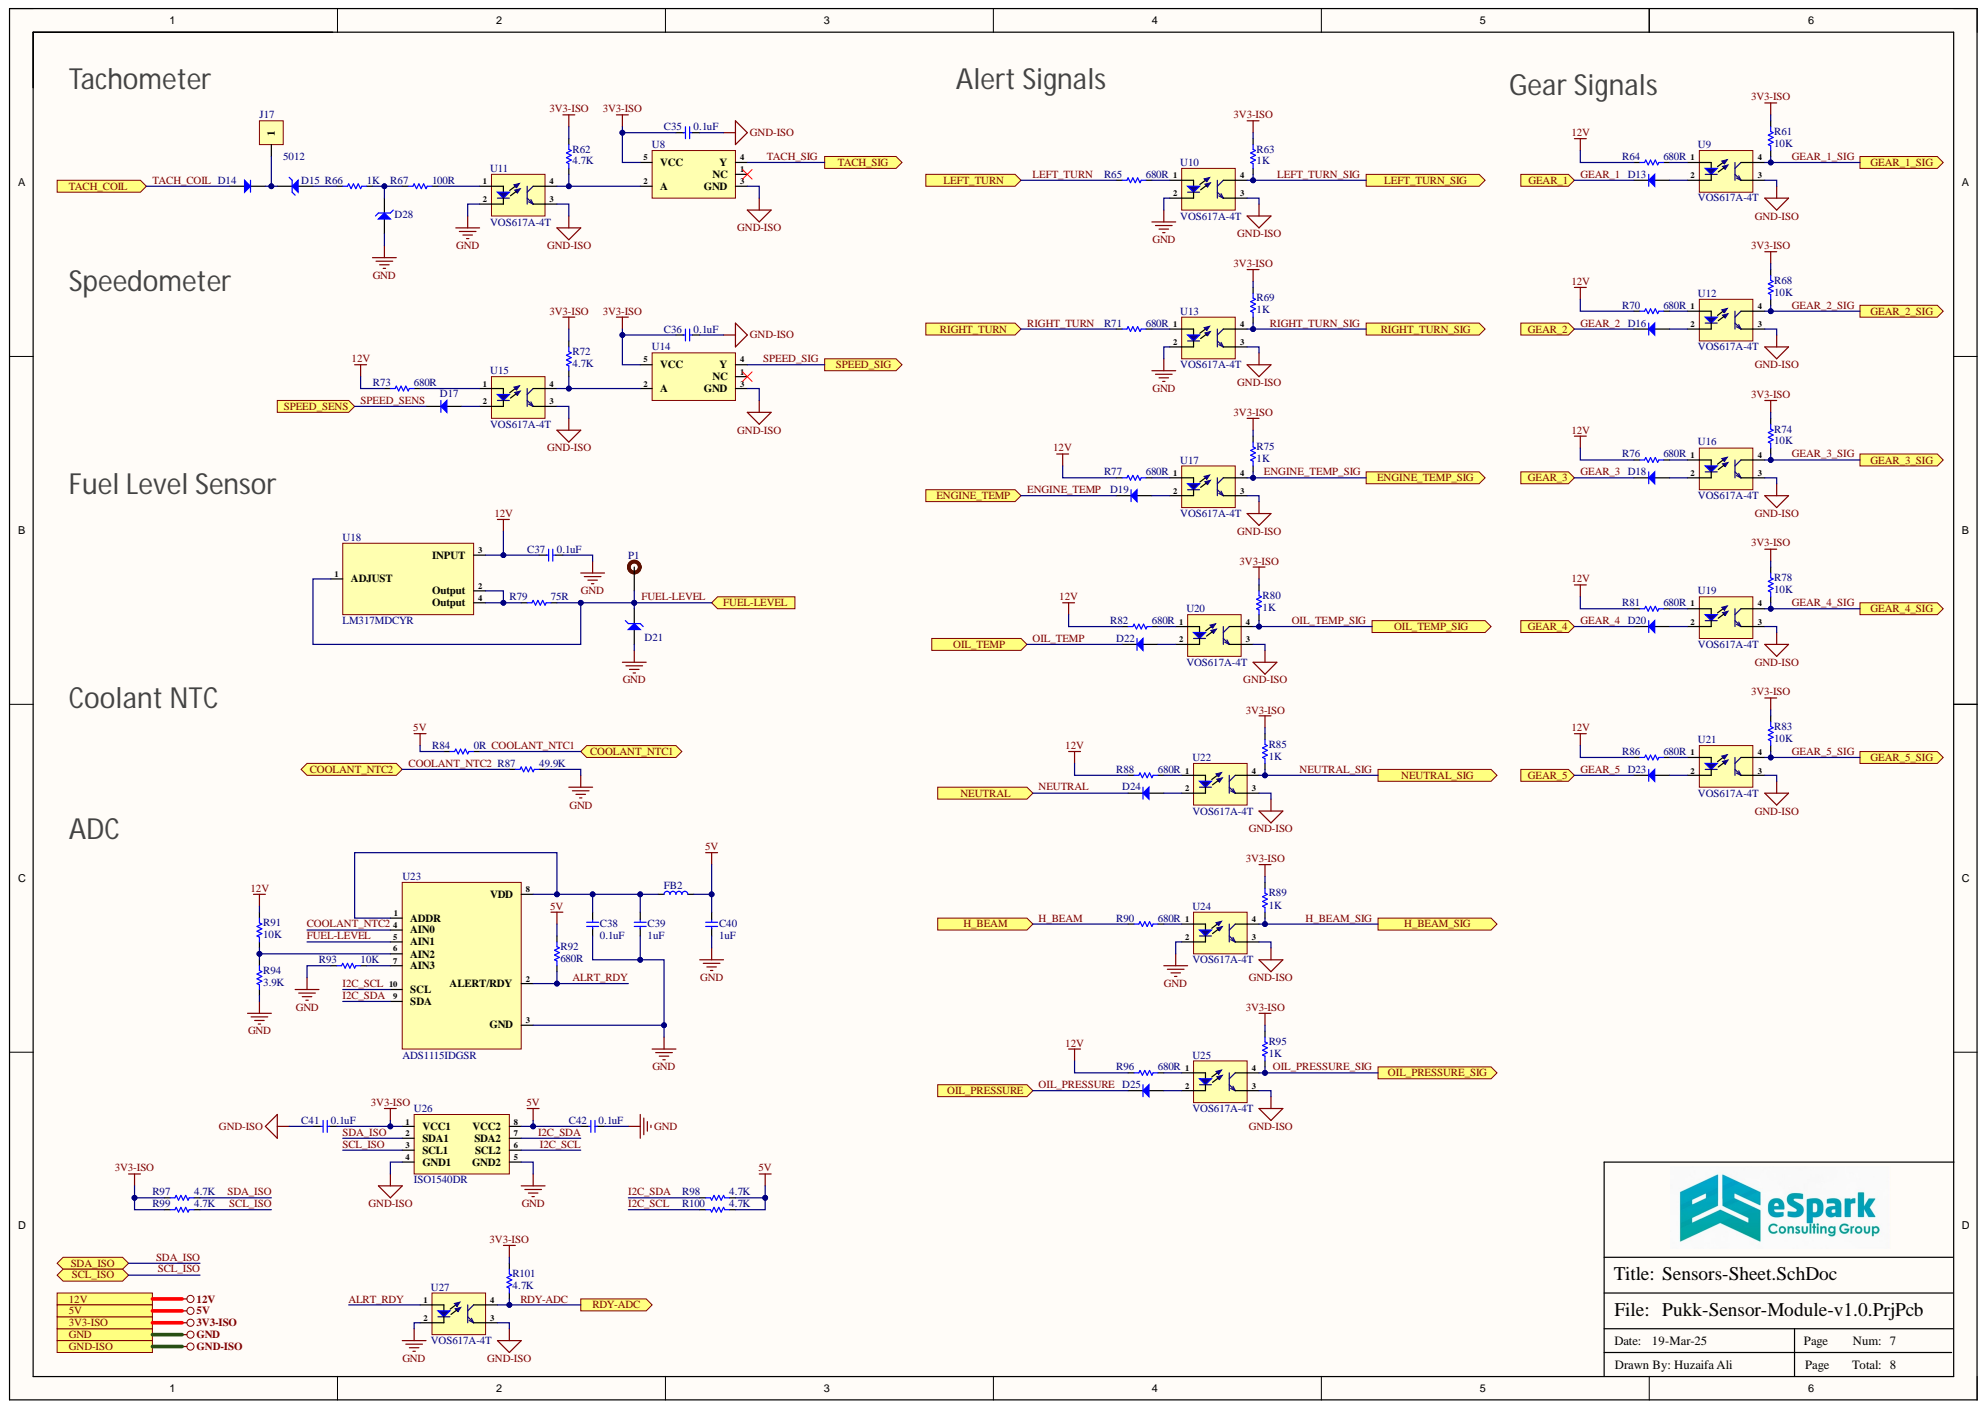
[picture p57: page 7]

AIN0 4

Pukk-Sensor-Module-v1.0.PrjPcb

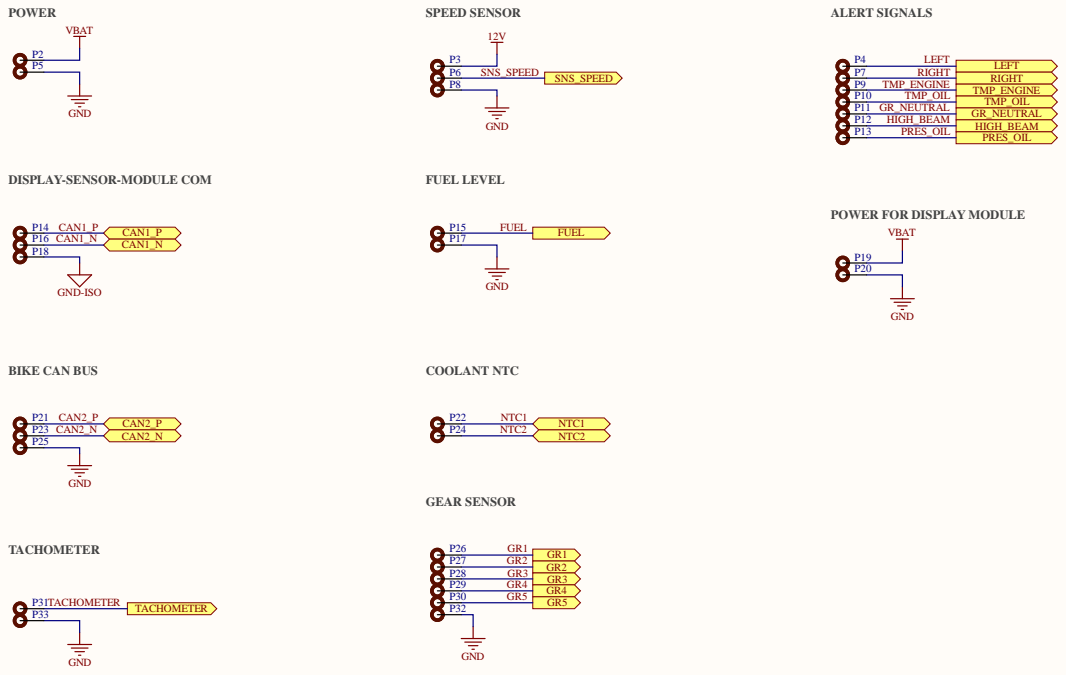
[picture p58: page 8]

DISPLAY-SENSOR-MODULE COM

POWER FOR DISPLAY MODULE

Pukk-Sensor-Module-v1.0.PrjPcb
