eSpark-Consulting-Group/alastair-barones-salpha/Design-Files/MVP-Module-Dash-v2.0/Schematic/MVP-Module-Dash-v1.0.pdf

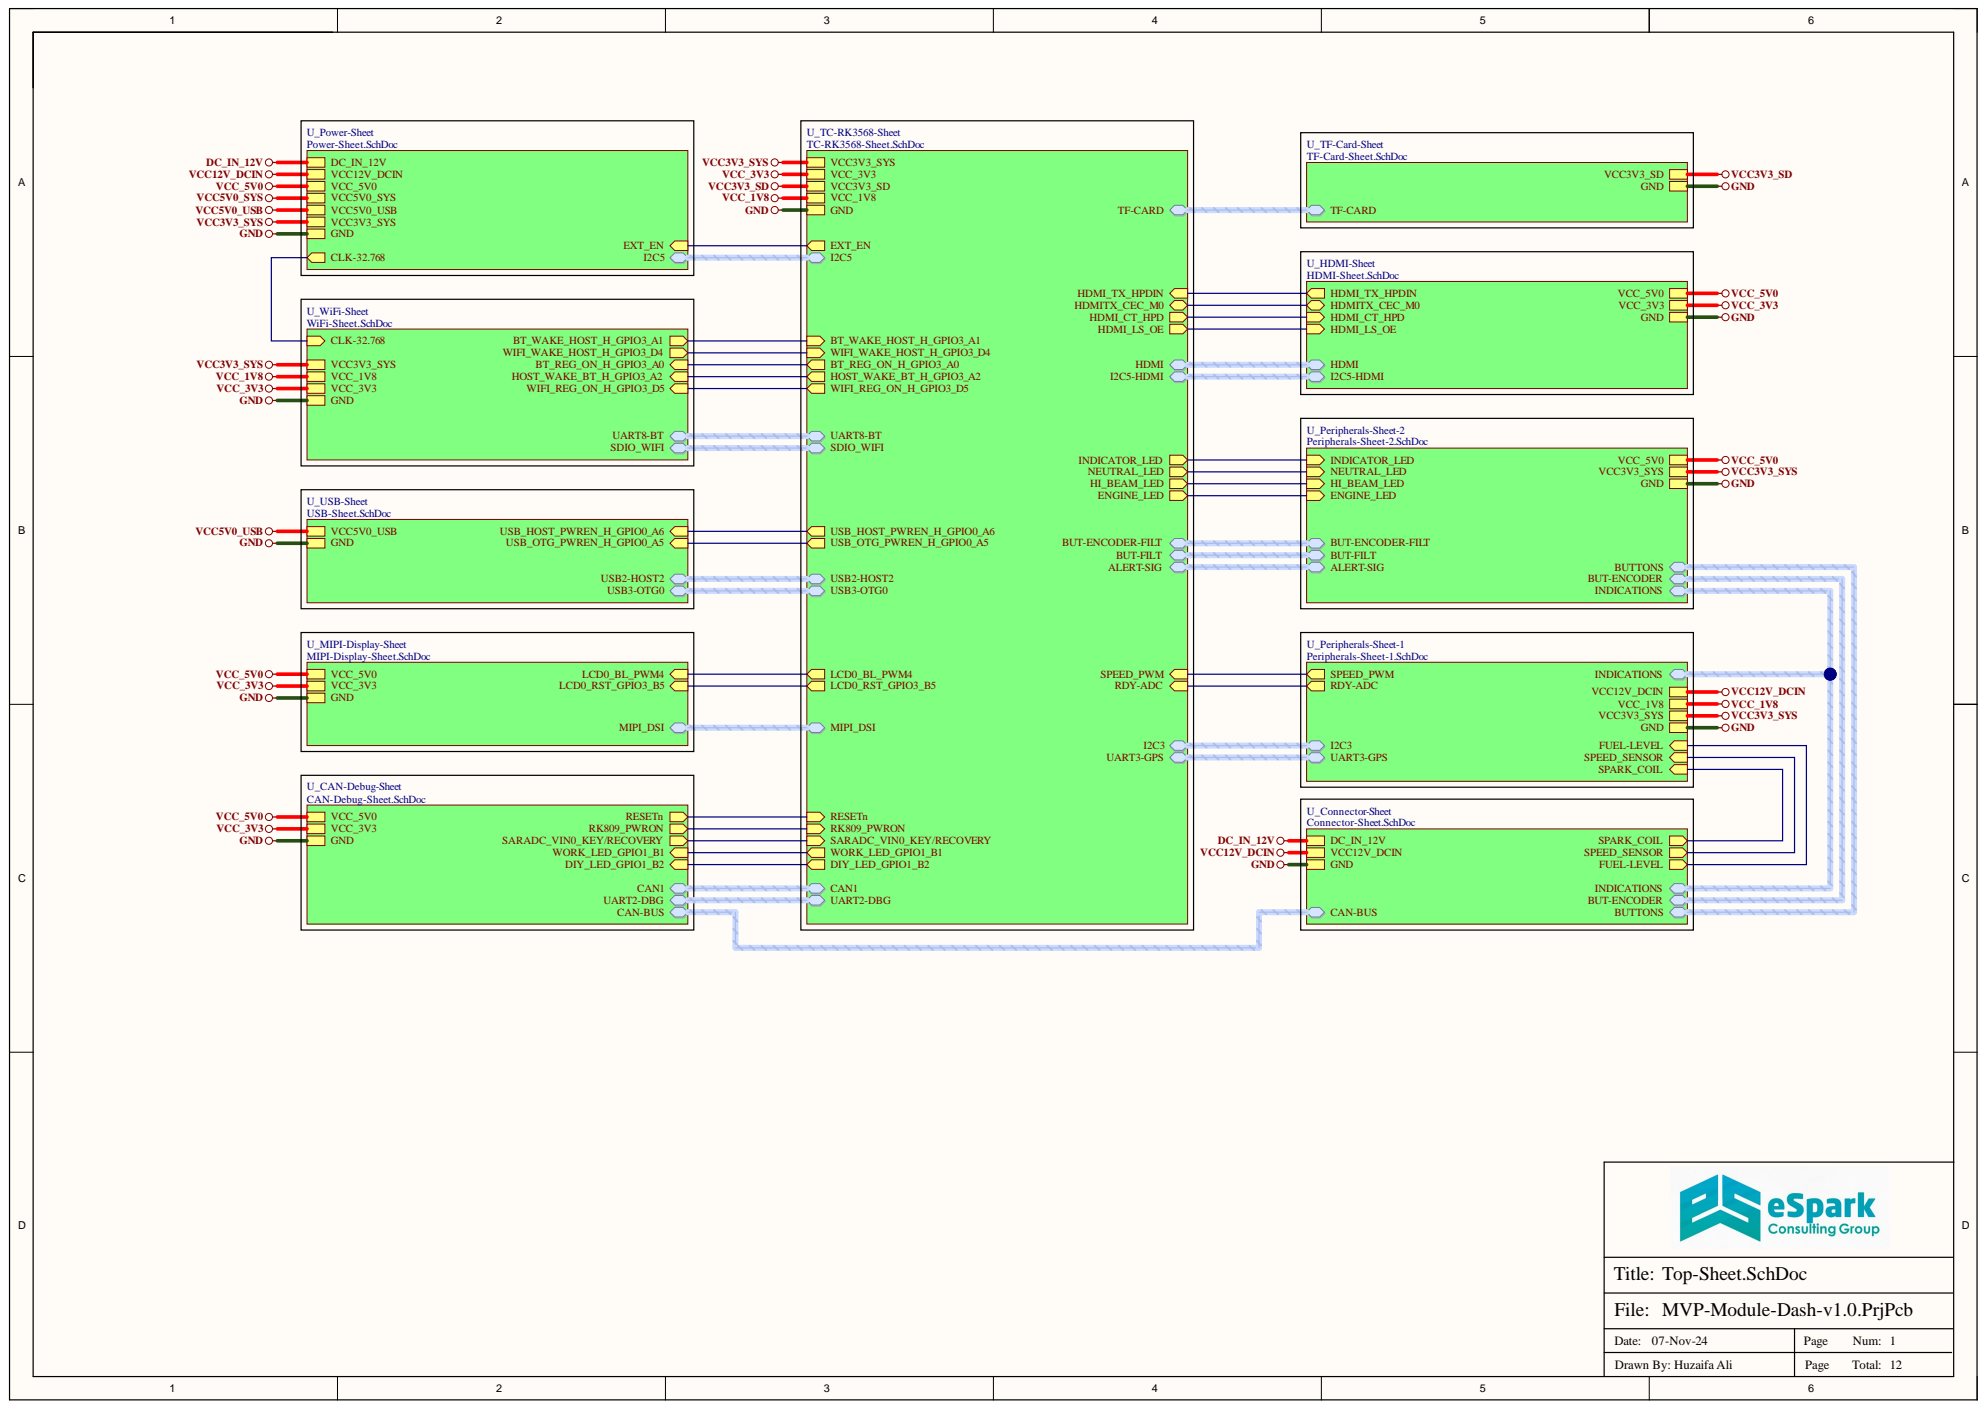
[picture p59: page 1]

U_TF-Card-Sheet
TF-Card-Sheet.SchDoc

MVP-Module-Dash-v1.0.PrjPcb

Date: 07-Nov-24 | Page Num: 1

Drawn By: Huzaifa Ali | Page Total:

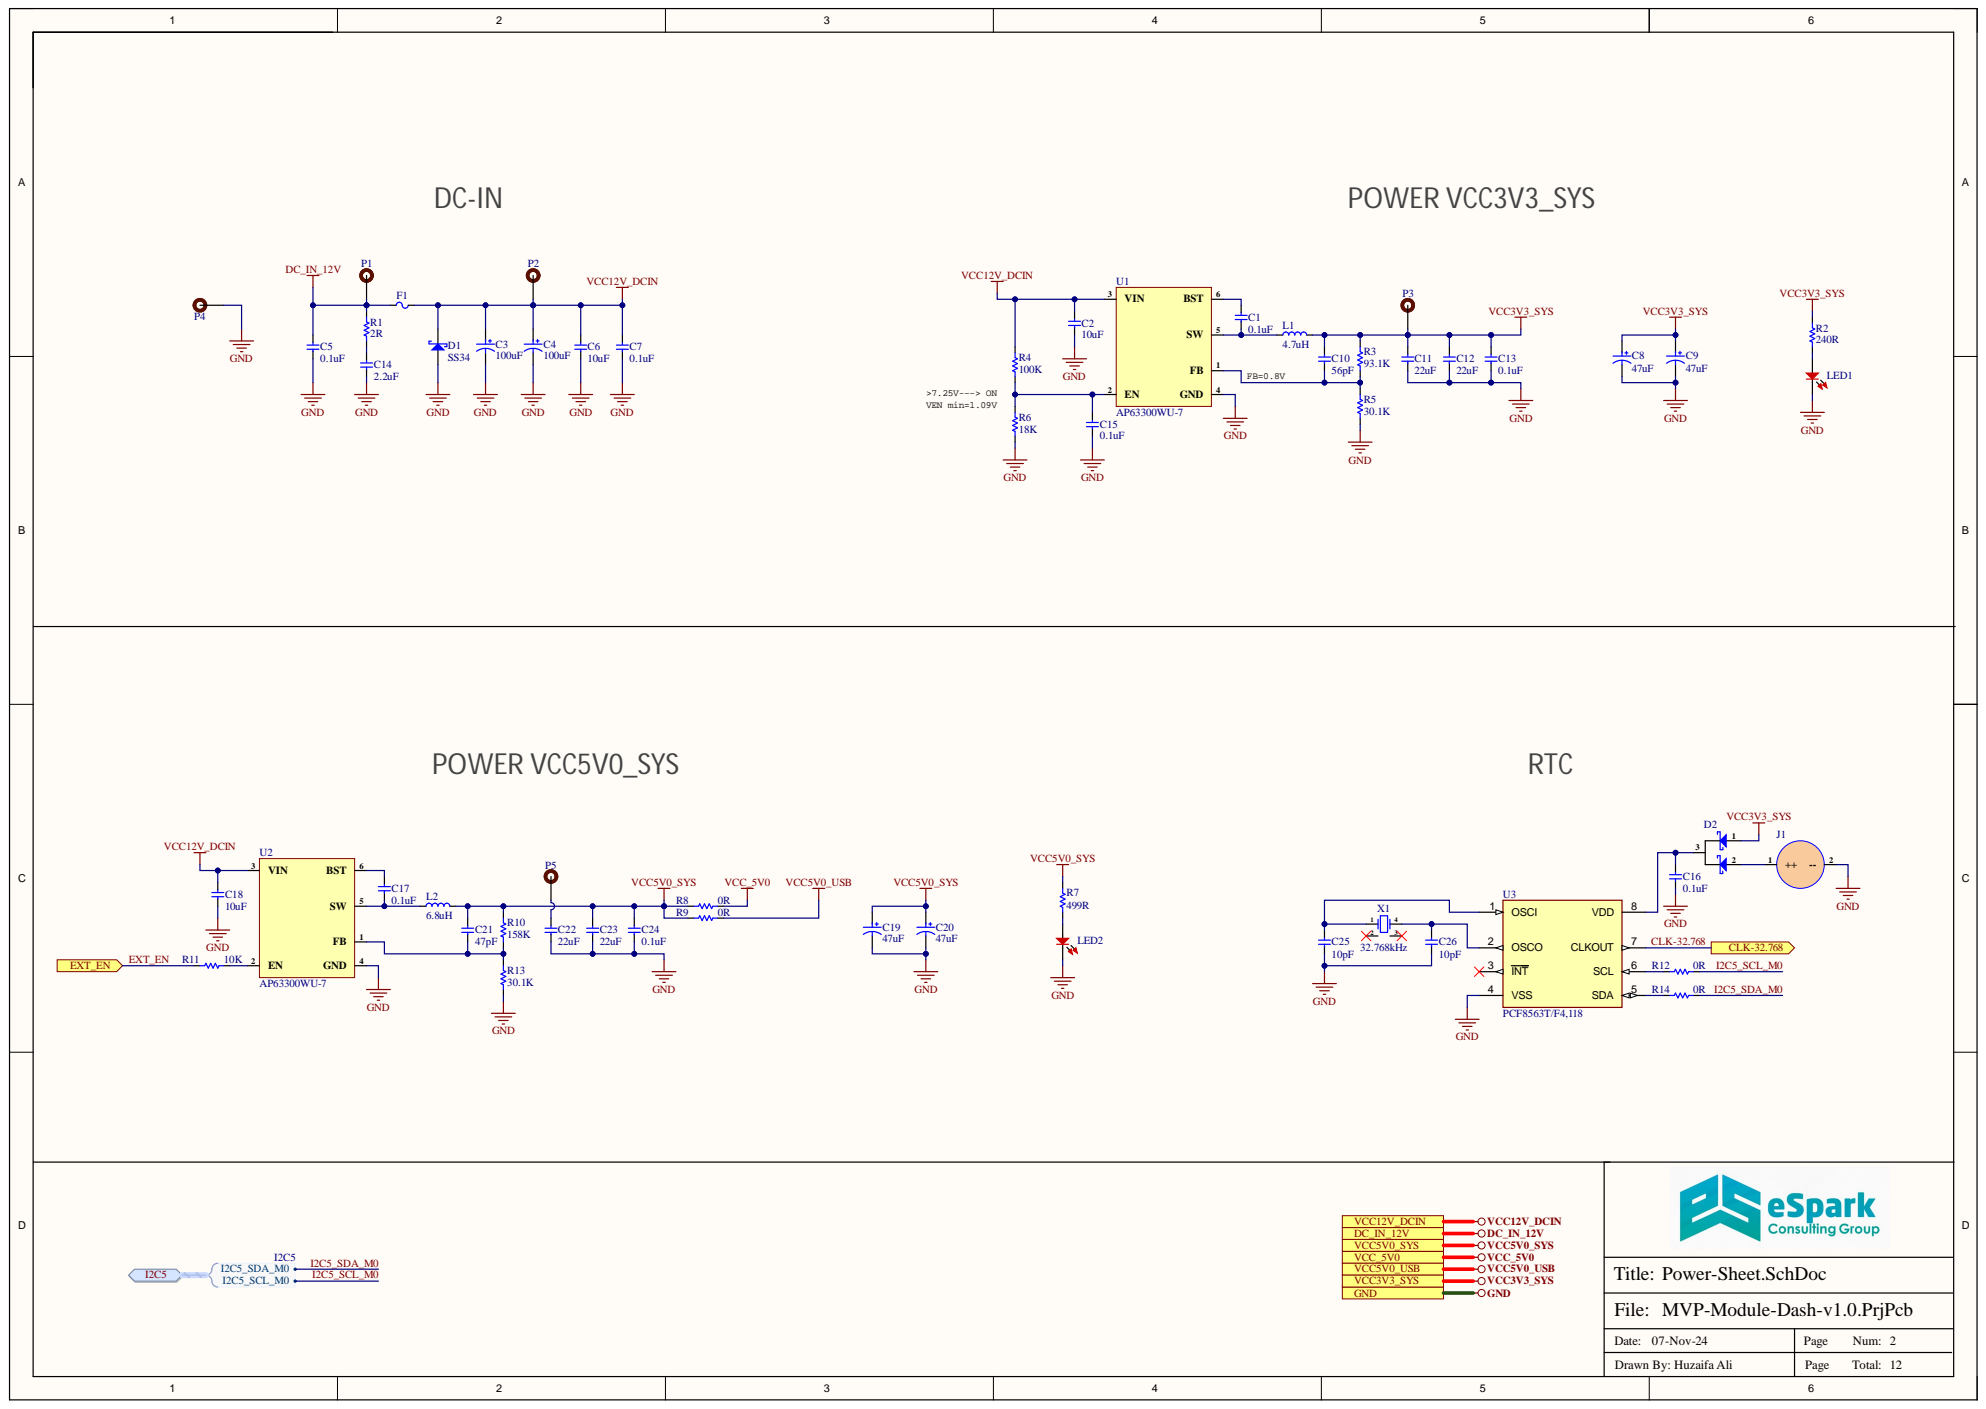
[picture p60: page 2]

MVP-Module-Dash-v1.0.PrjPcb

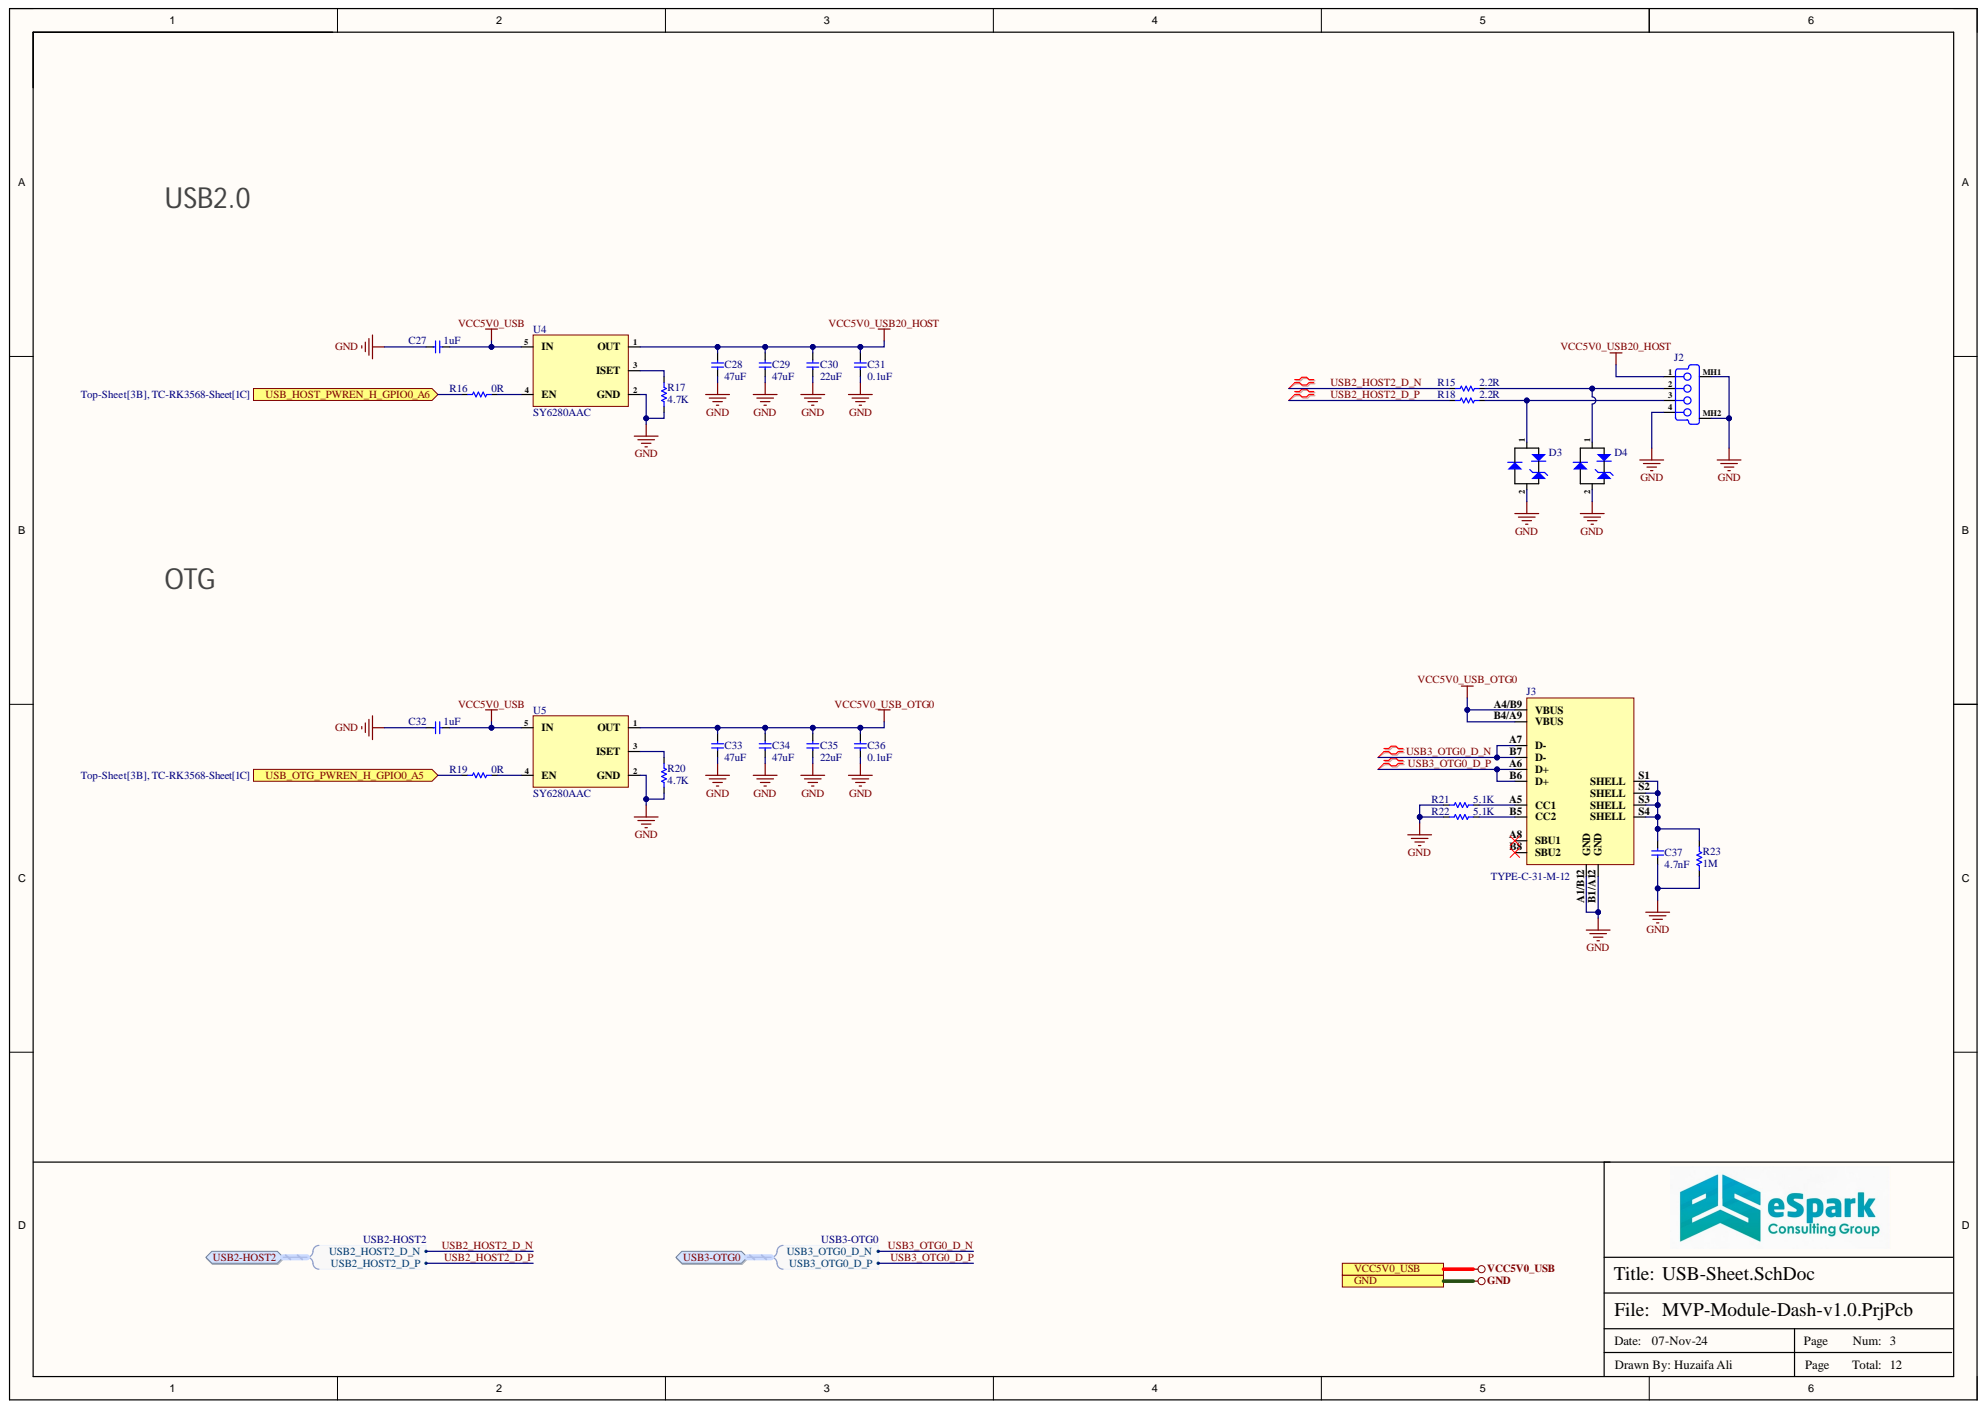
[picture p61: page 3]

MVP-Module-Dash-v1.0.PrjPcb

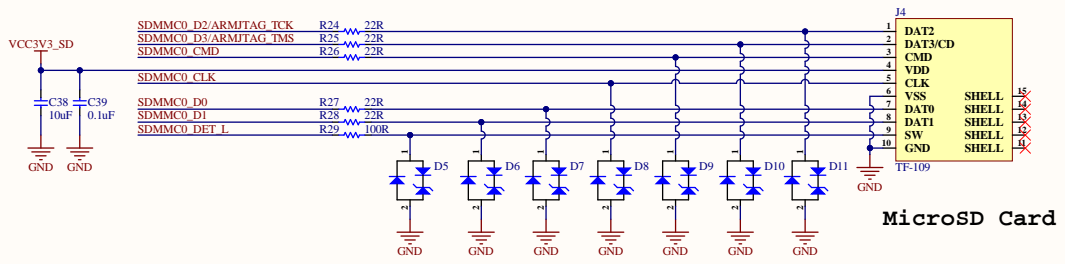
[picture p62: page 4]

TF-Card-Sheet.SchDoc

MVP-Module-Dash-v1.0.PrjPcb

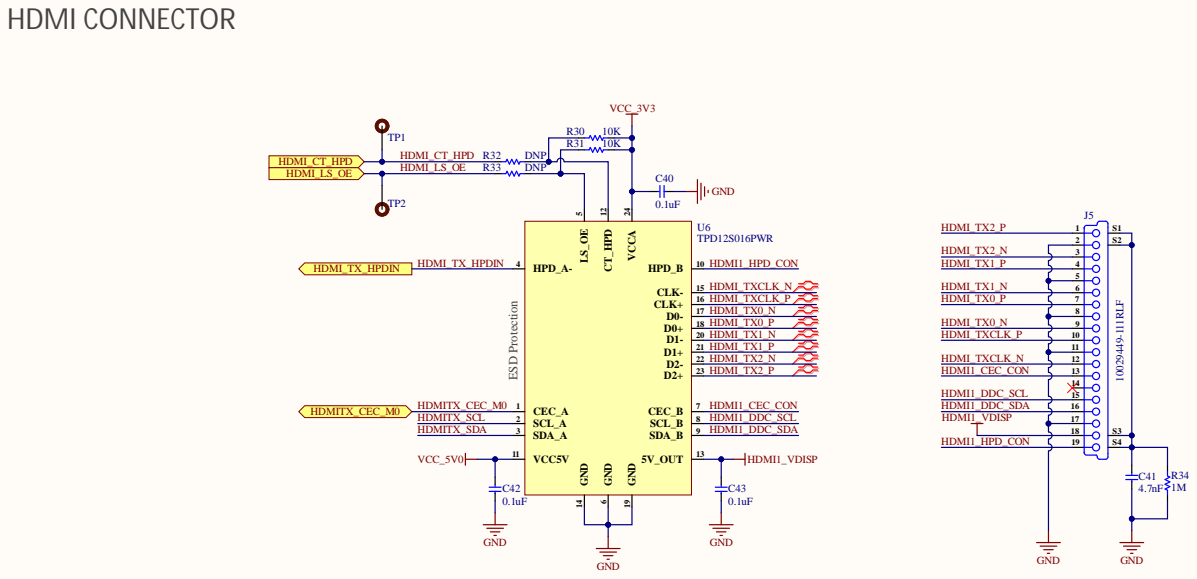
[picture p63: page 5]

MVP-Module-Dash-v1.0.PrjPcb

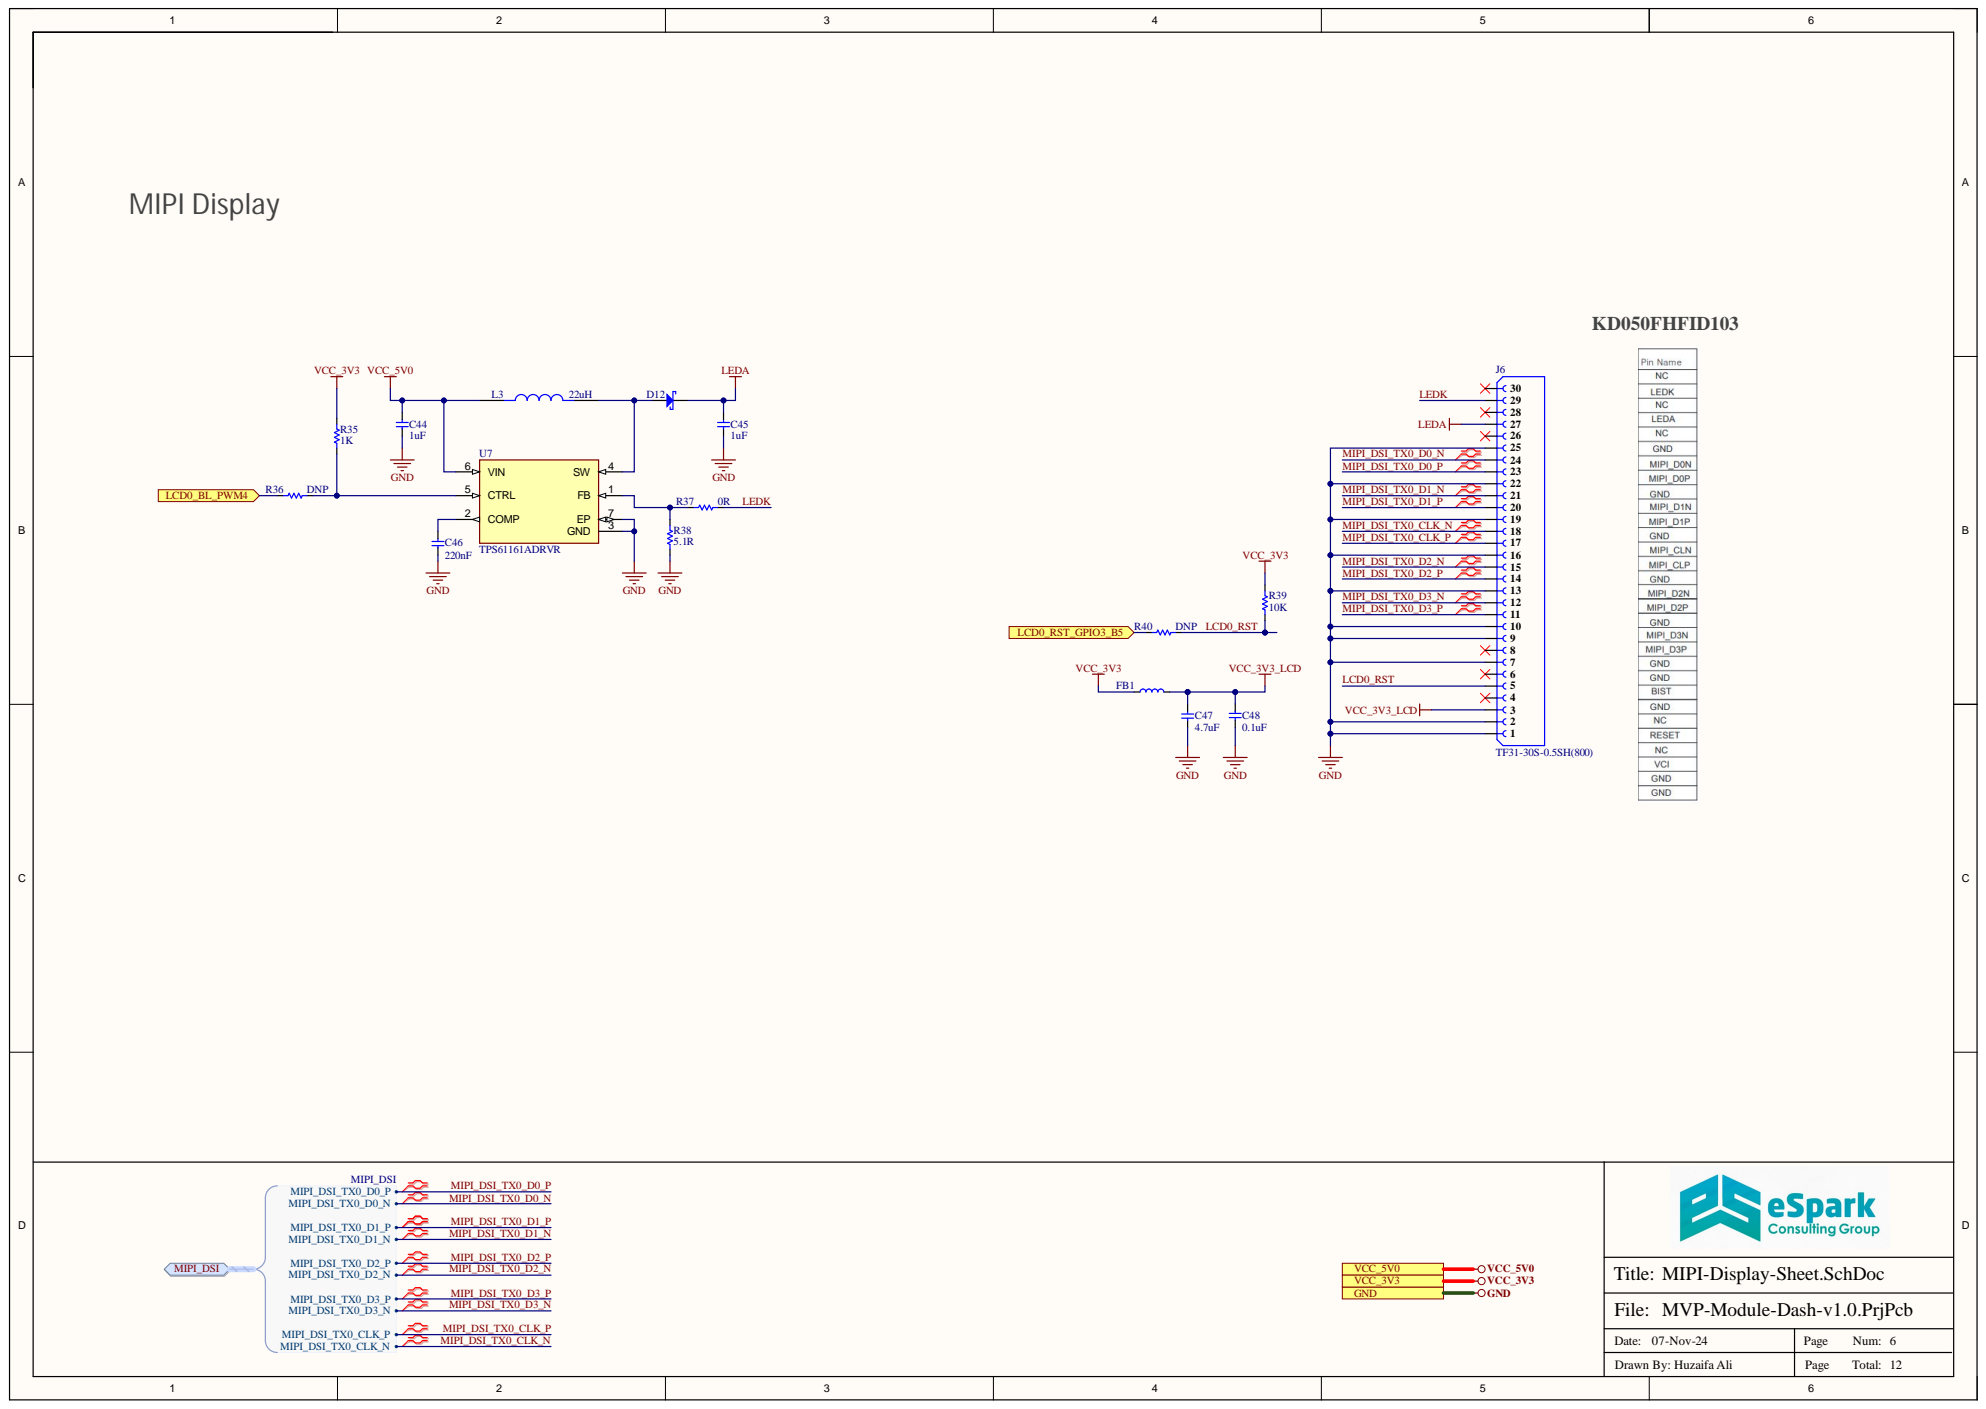
[picture p64: page 6]

MIPI-Display-Sheet.SchDoc

MVP-Module-Dash-v1.0.PrjPcb

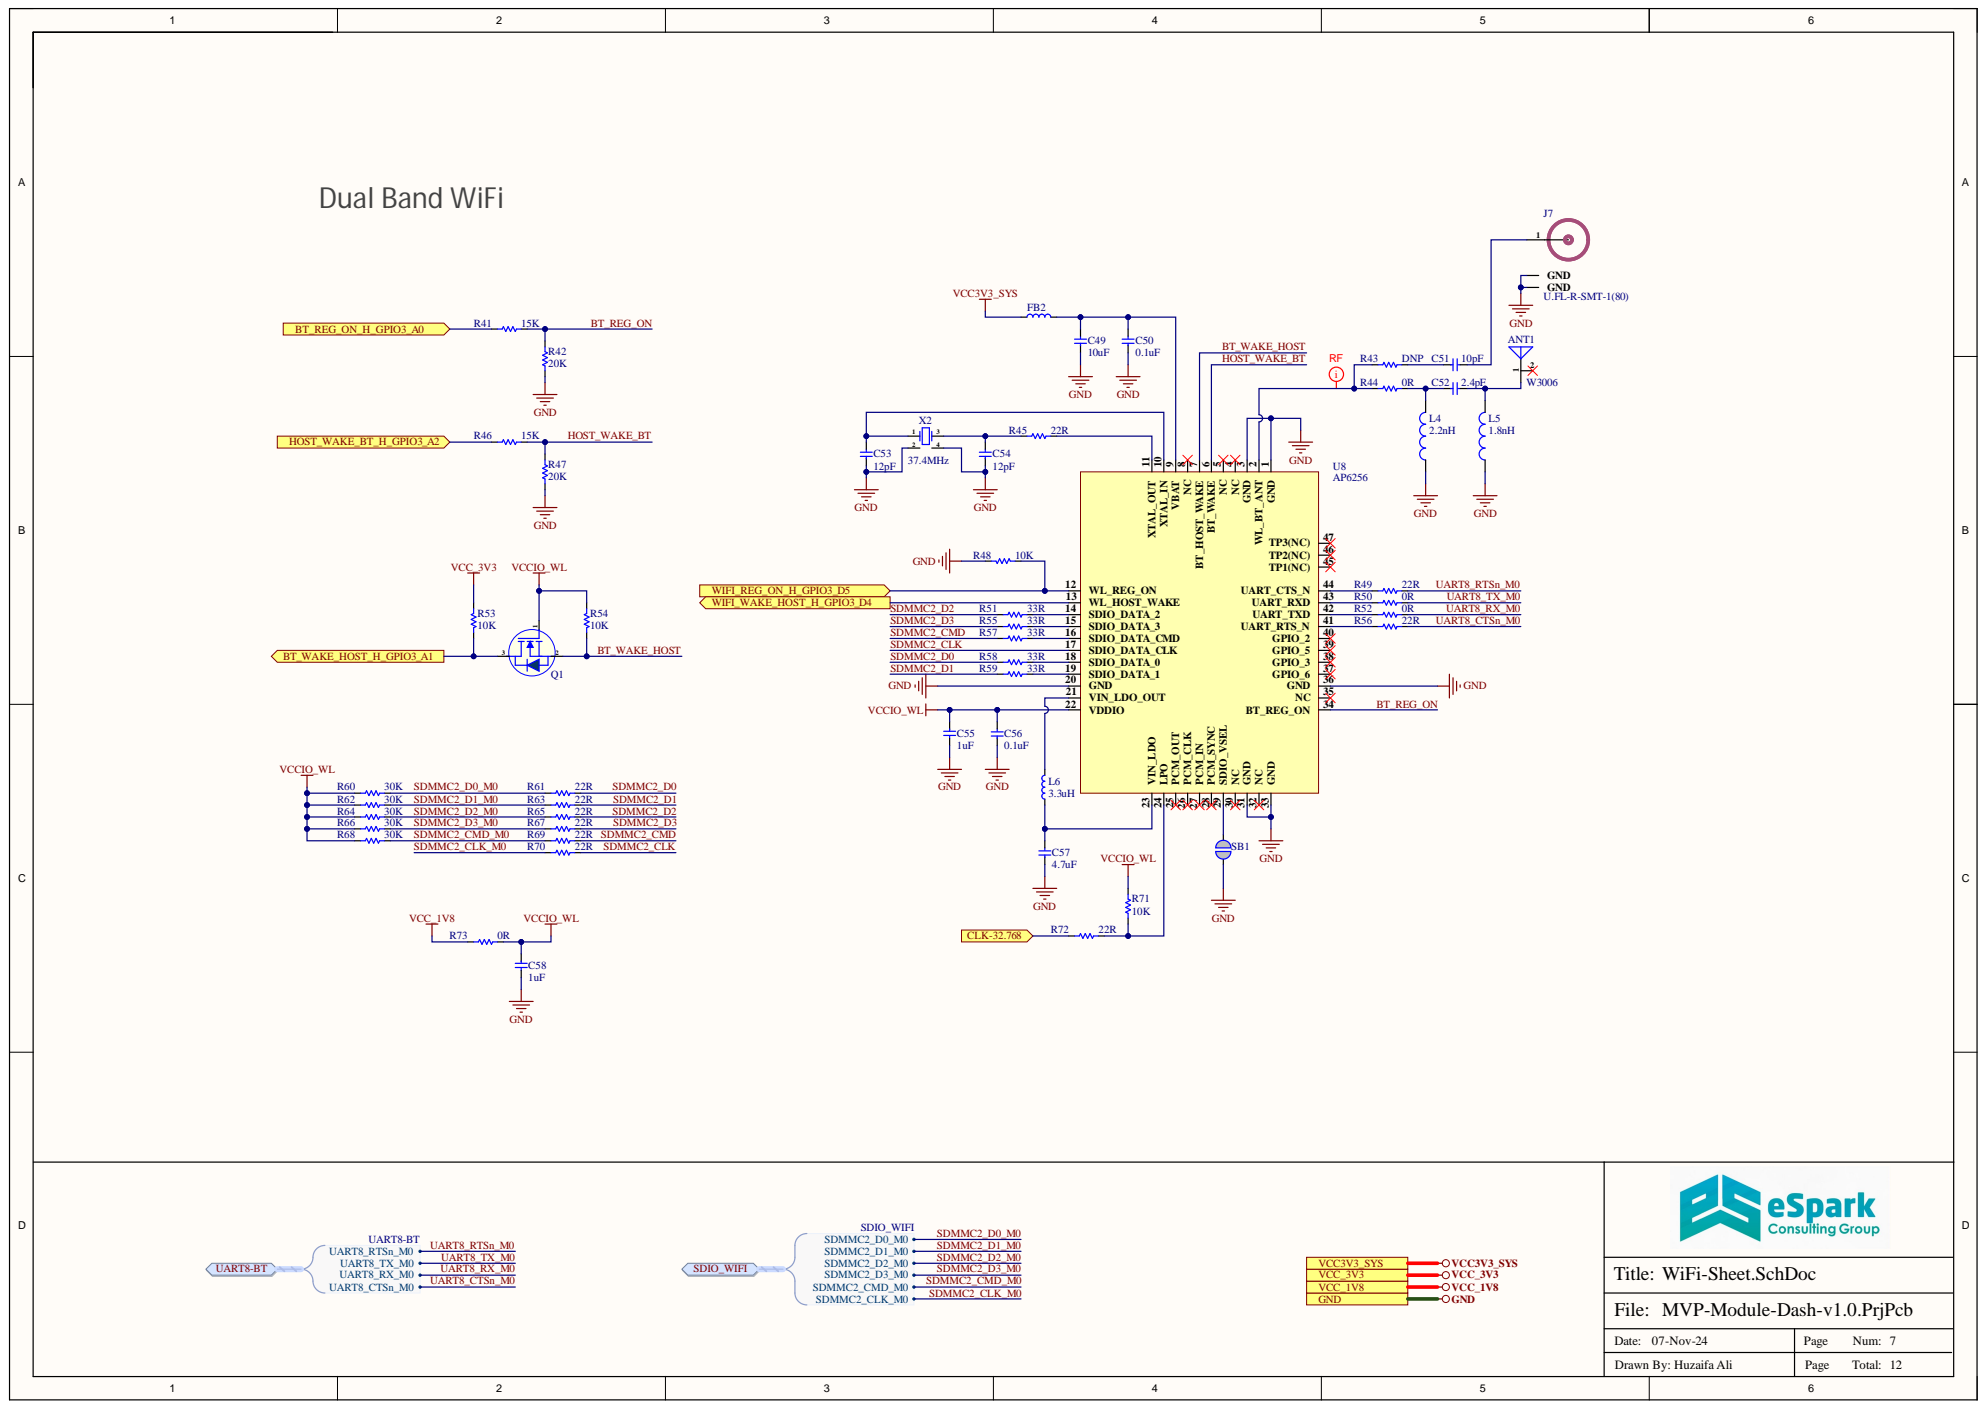
[picture p65: page 7]

GND 1 WL_BT_ANT 2 GND 3 NC 4 NC 5 BT_WAKE 6 BT_HOST_WAKE 7 NC 8 VBAT 9 XTAL_IN 10 XTAL_OUT 11

MVP-Module-Dash-v1.0.PrjPcb

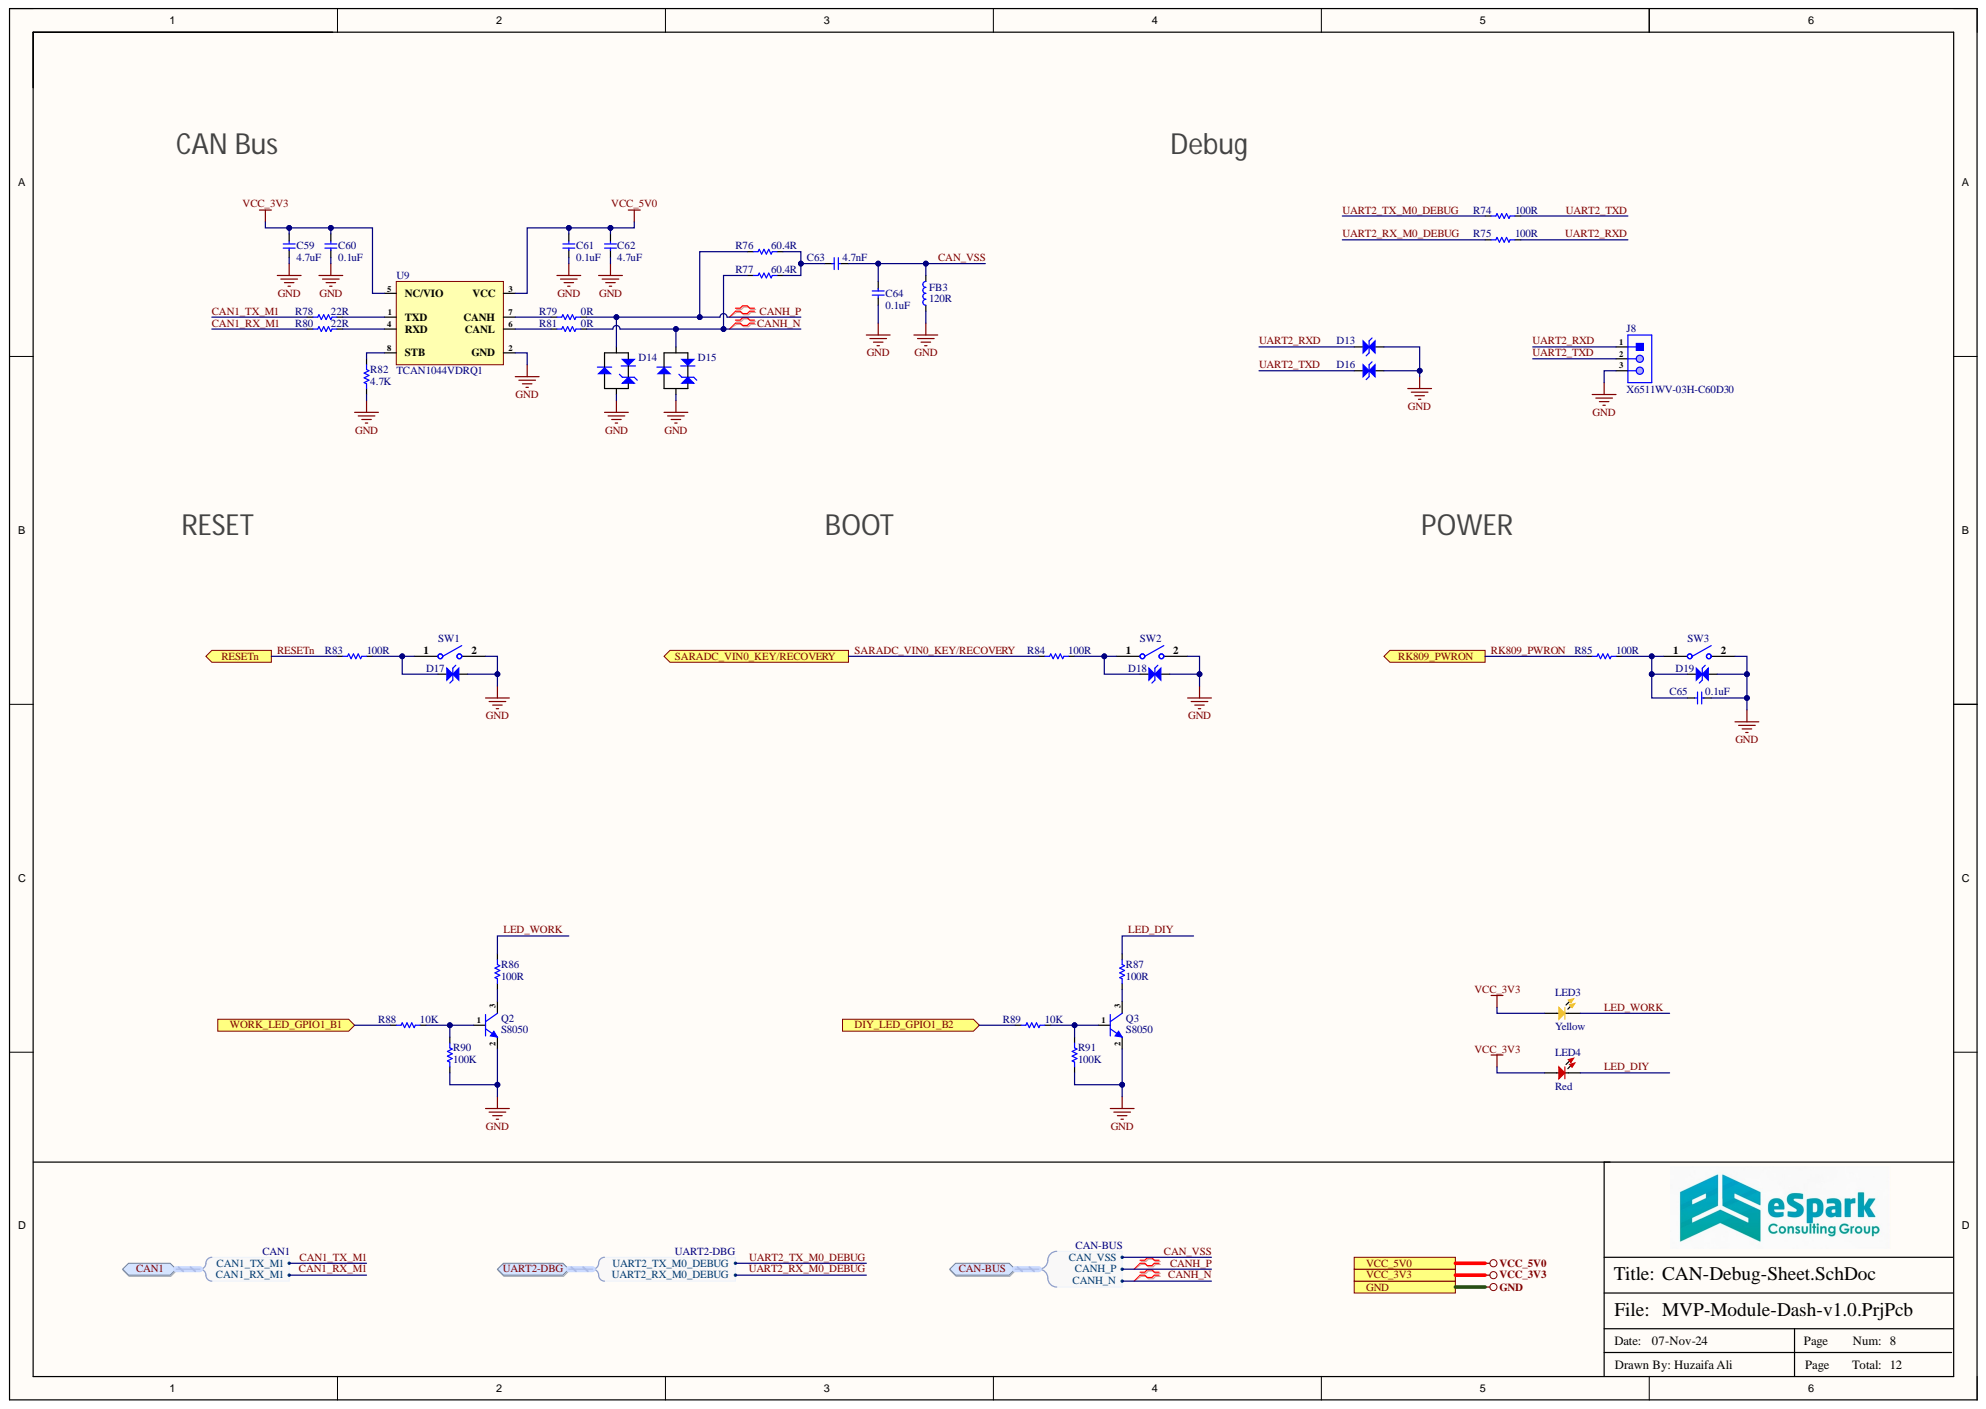
[picture p66: page 8]

CAN-Debug-Sheet.SchDoc

MVP-Module-Dash-v1.0.PrjPcb

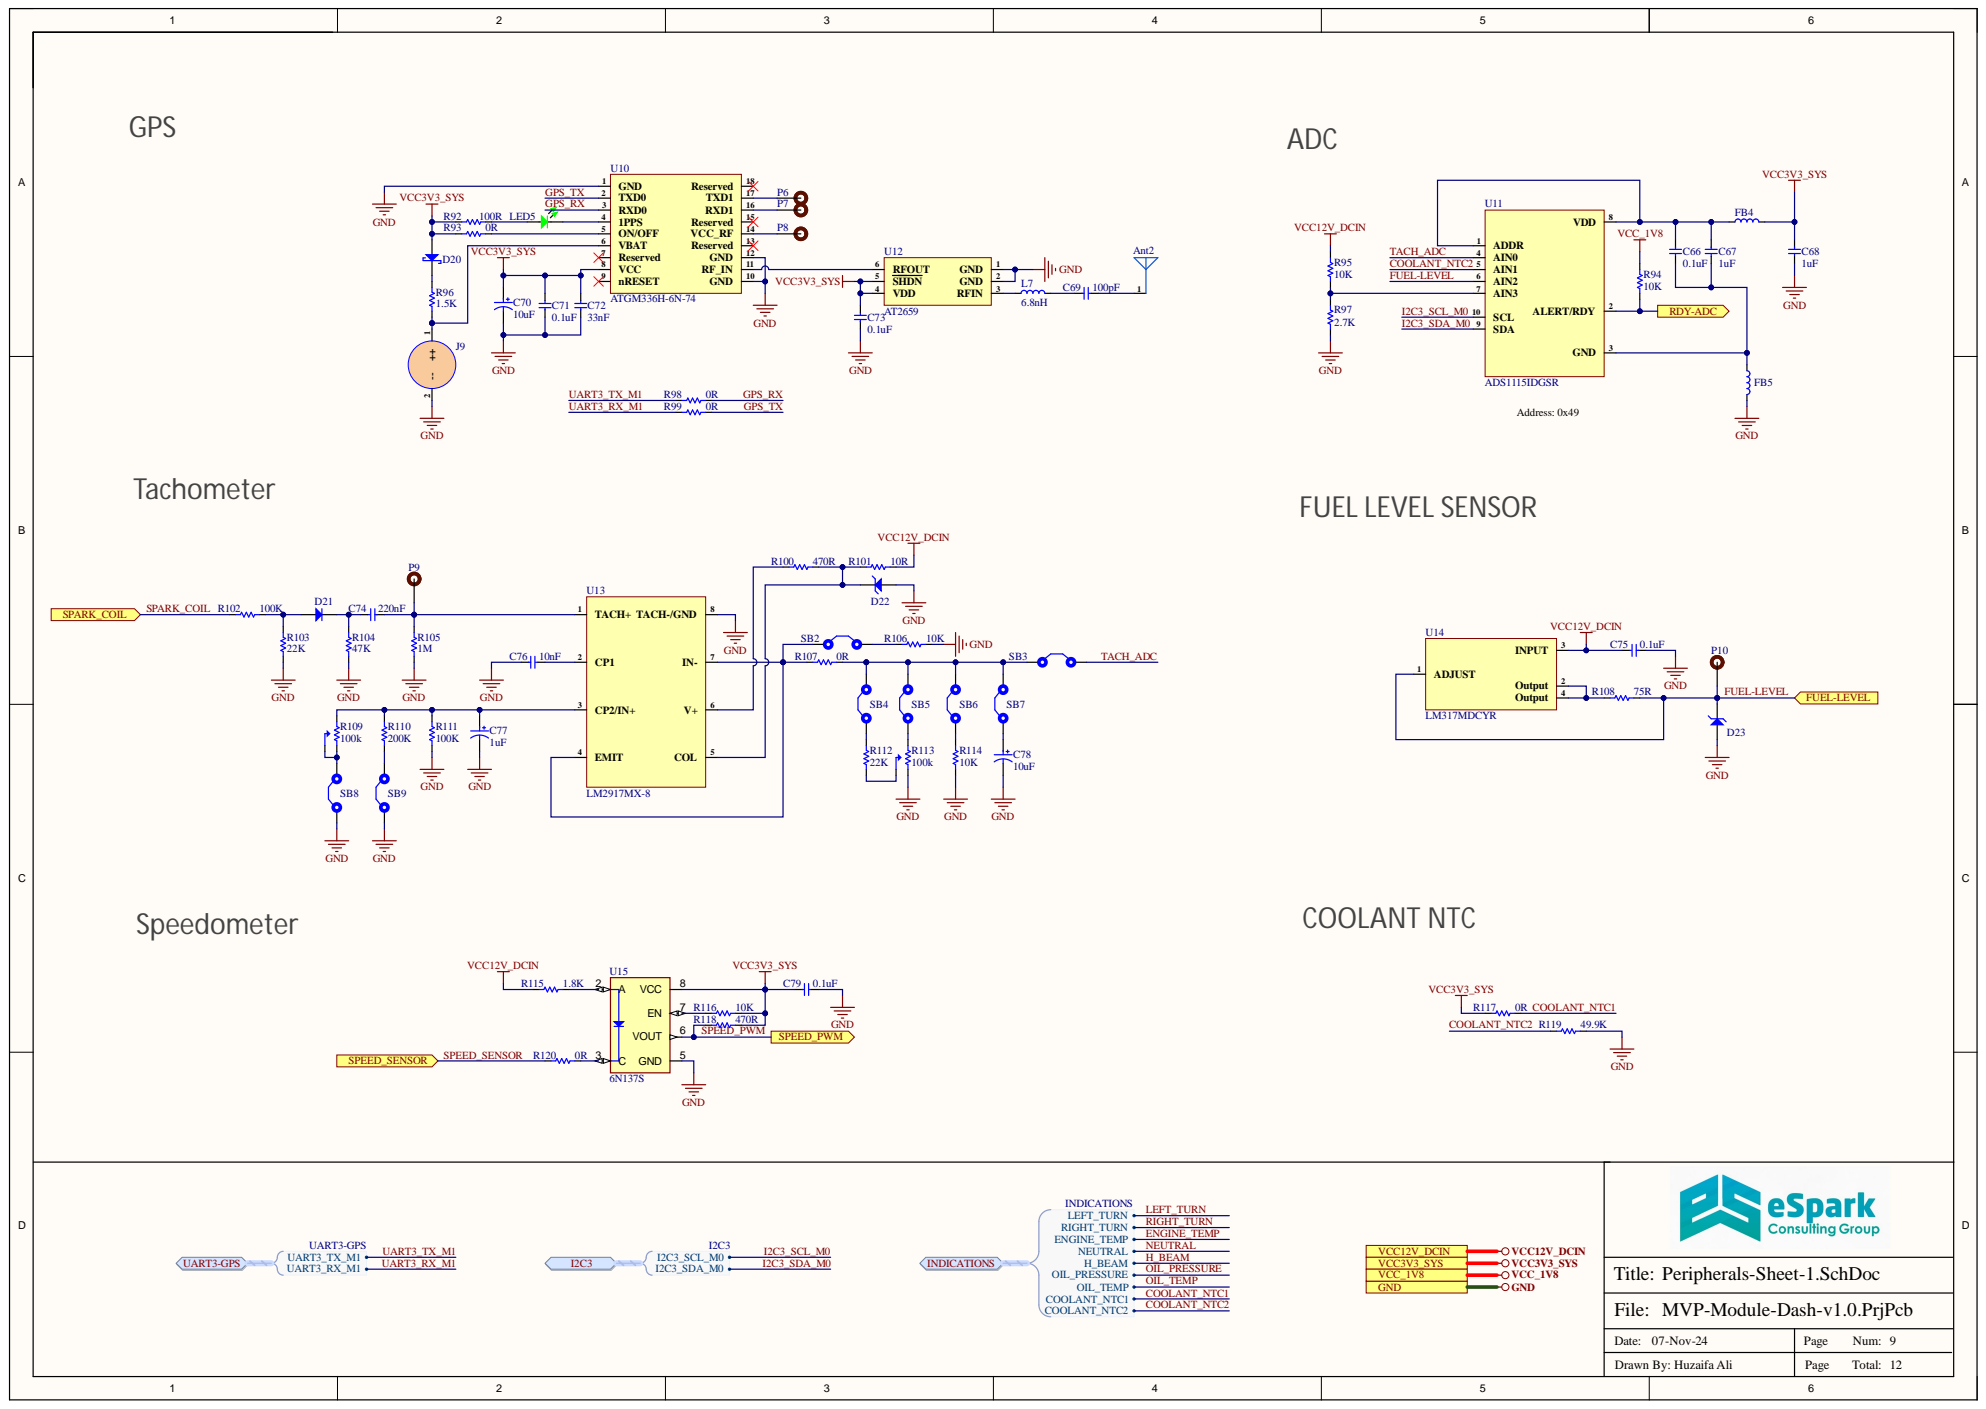
[picture p67: page 9]

MVP-Module-Dash-v1.0.PrjPcb

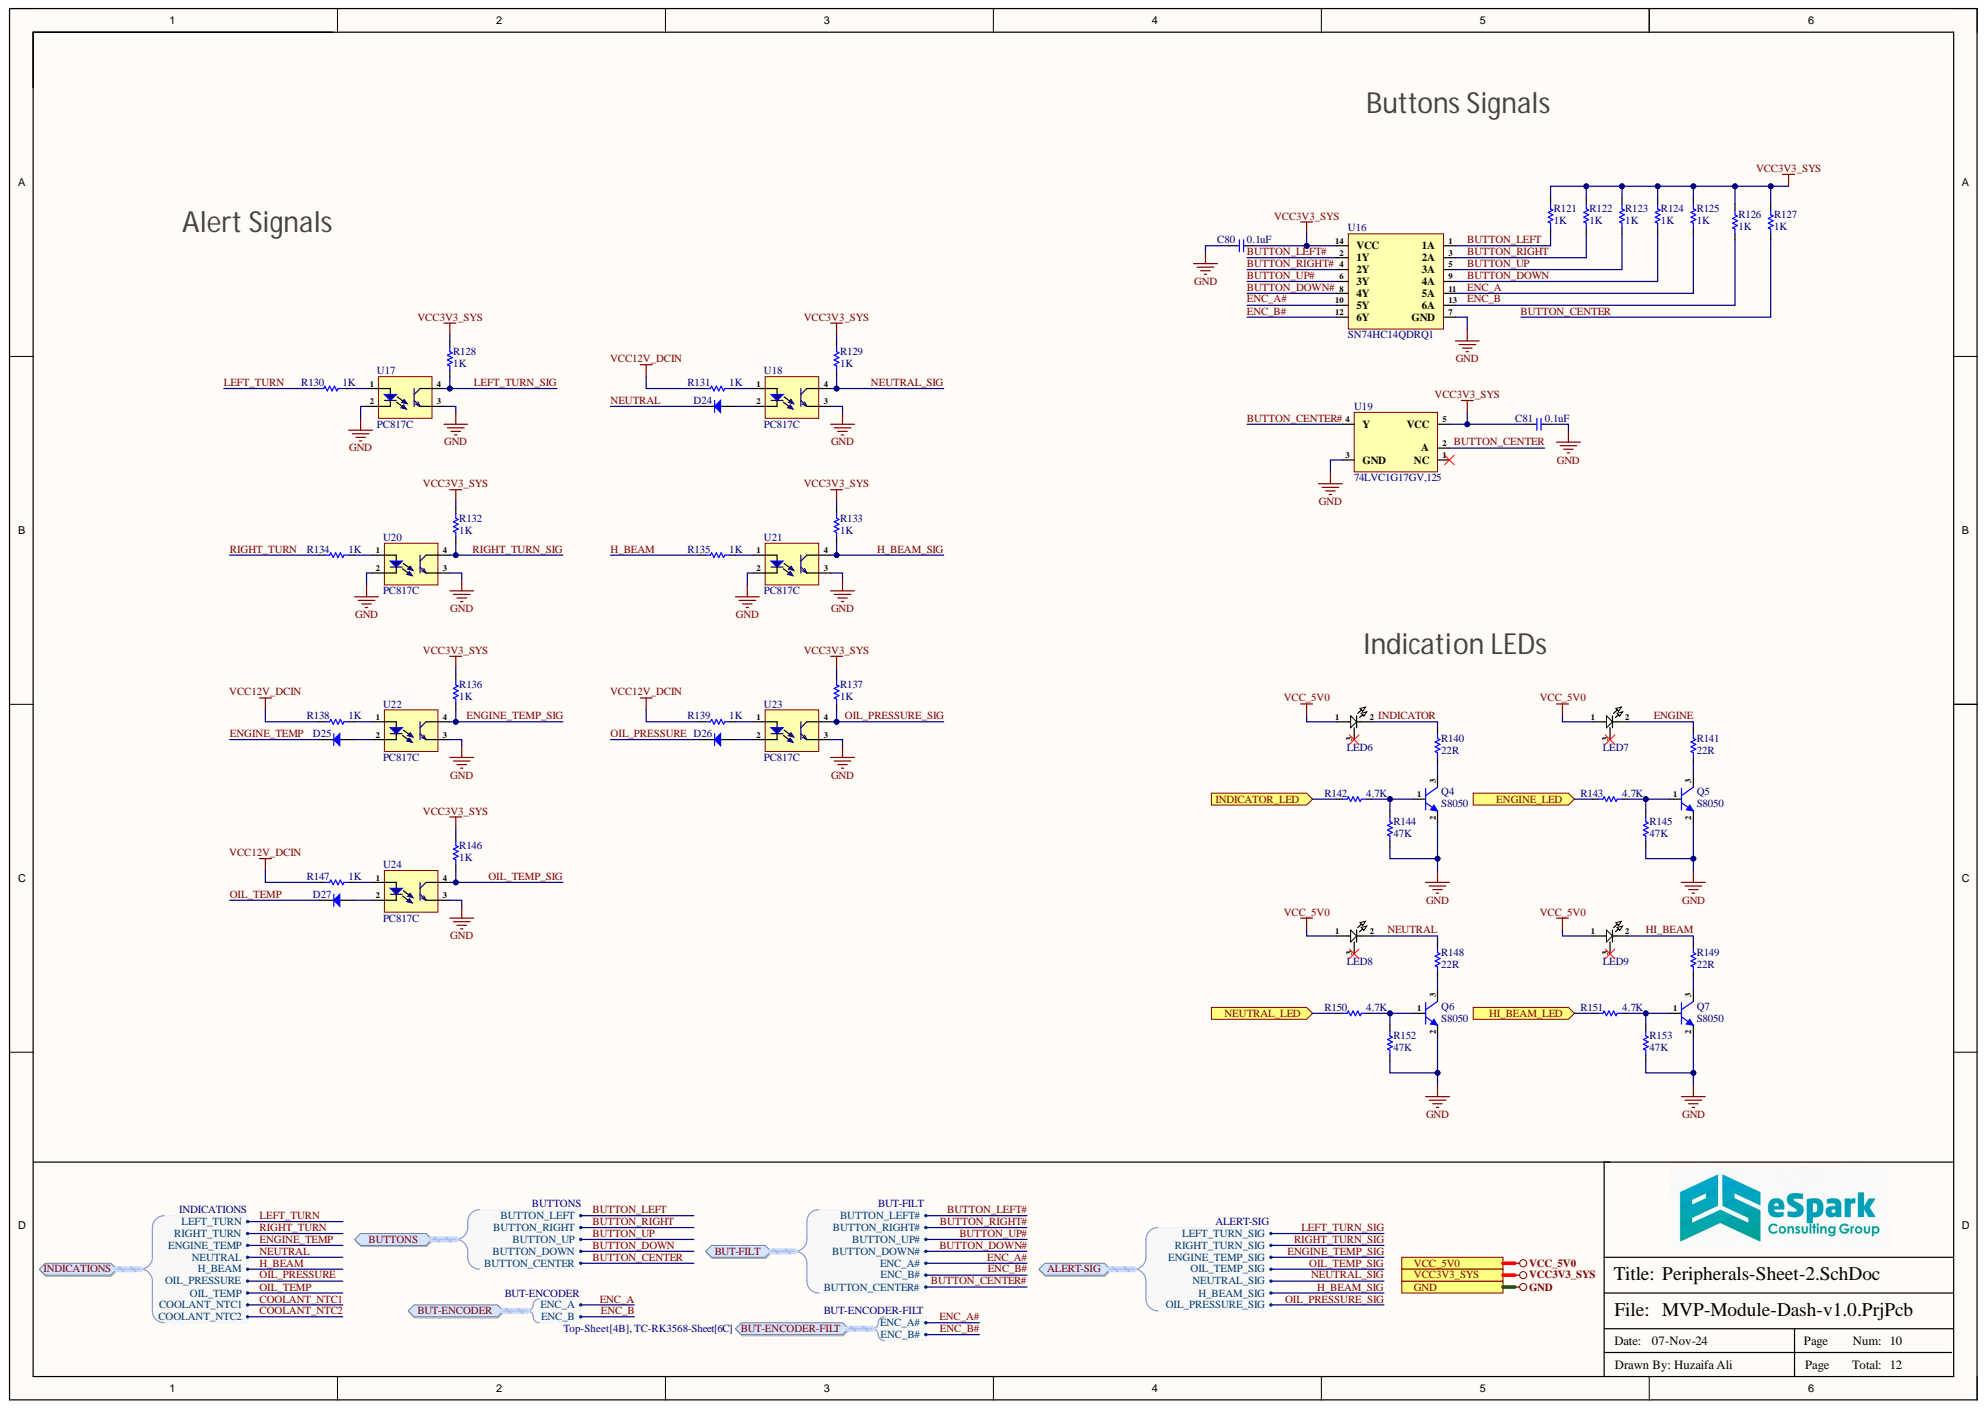
[picture p68: page 10]

ENC_A
ENC_B
Top-Sheet[4B], TC-RK3568-Sheet[6C] BUT-ENCODER-FILT

MVP-Module-Dash-v1.0.PrjPcb

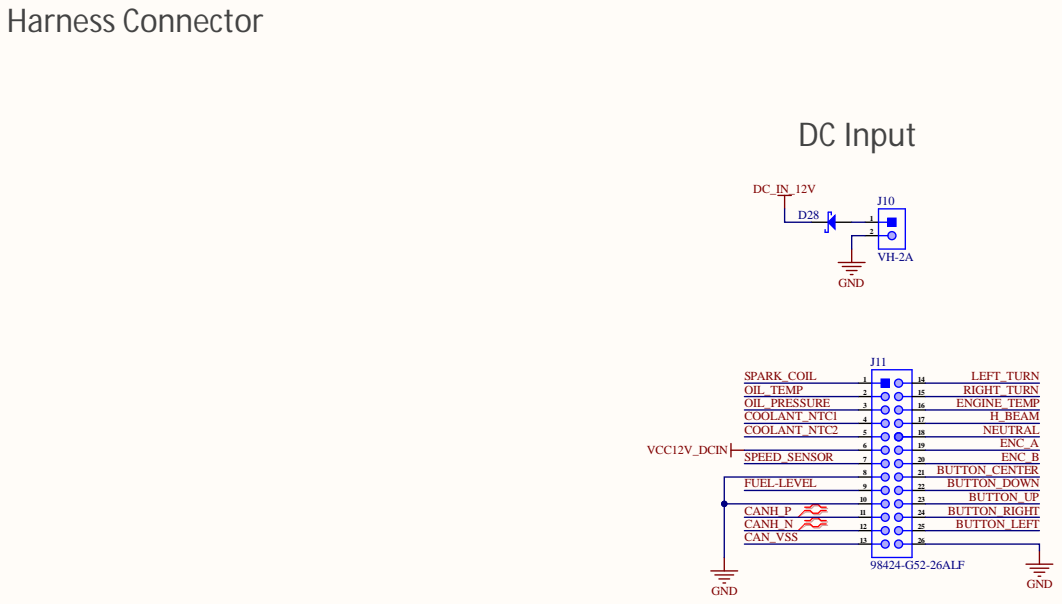
[picture p69: page 11]

C | GND | C

MVP-Module-Dash-v1.0.PrjPcb

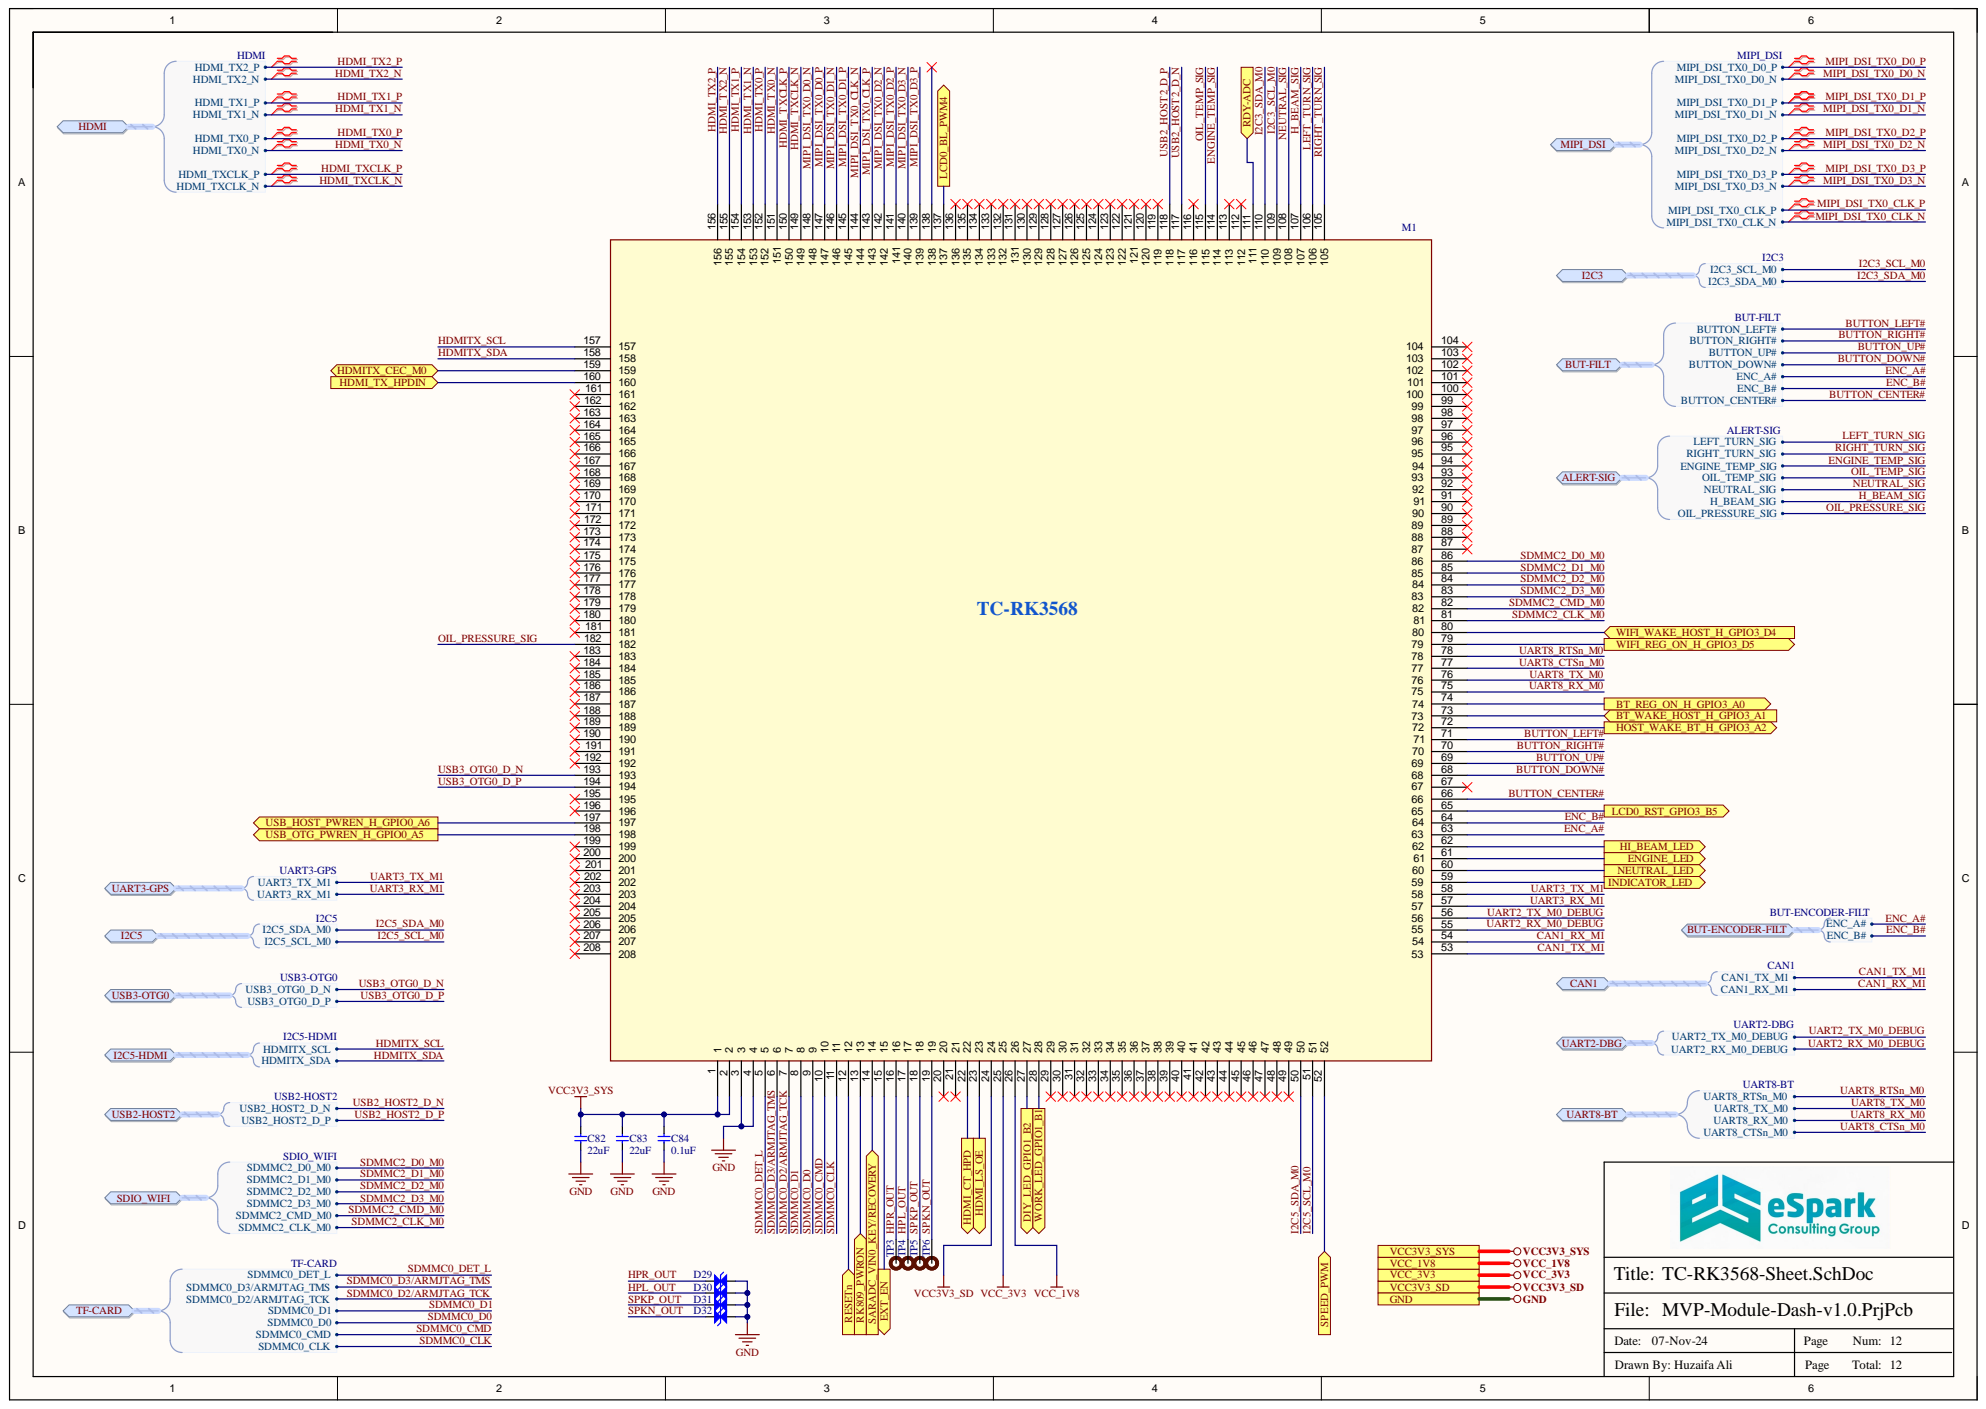
[picture p70: page 12]

MVP-Module-Dash-v1.0.PrjPcb
