eSpark-Consulting-Group/alastair-barones-salpha/Design-Files/MVP-Dash-v1.0/Schematic/MVP-Dash-v1.0.pdf

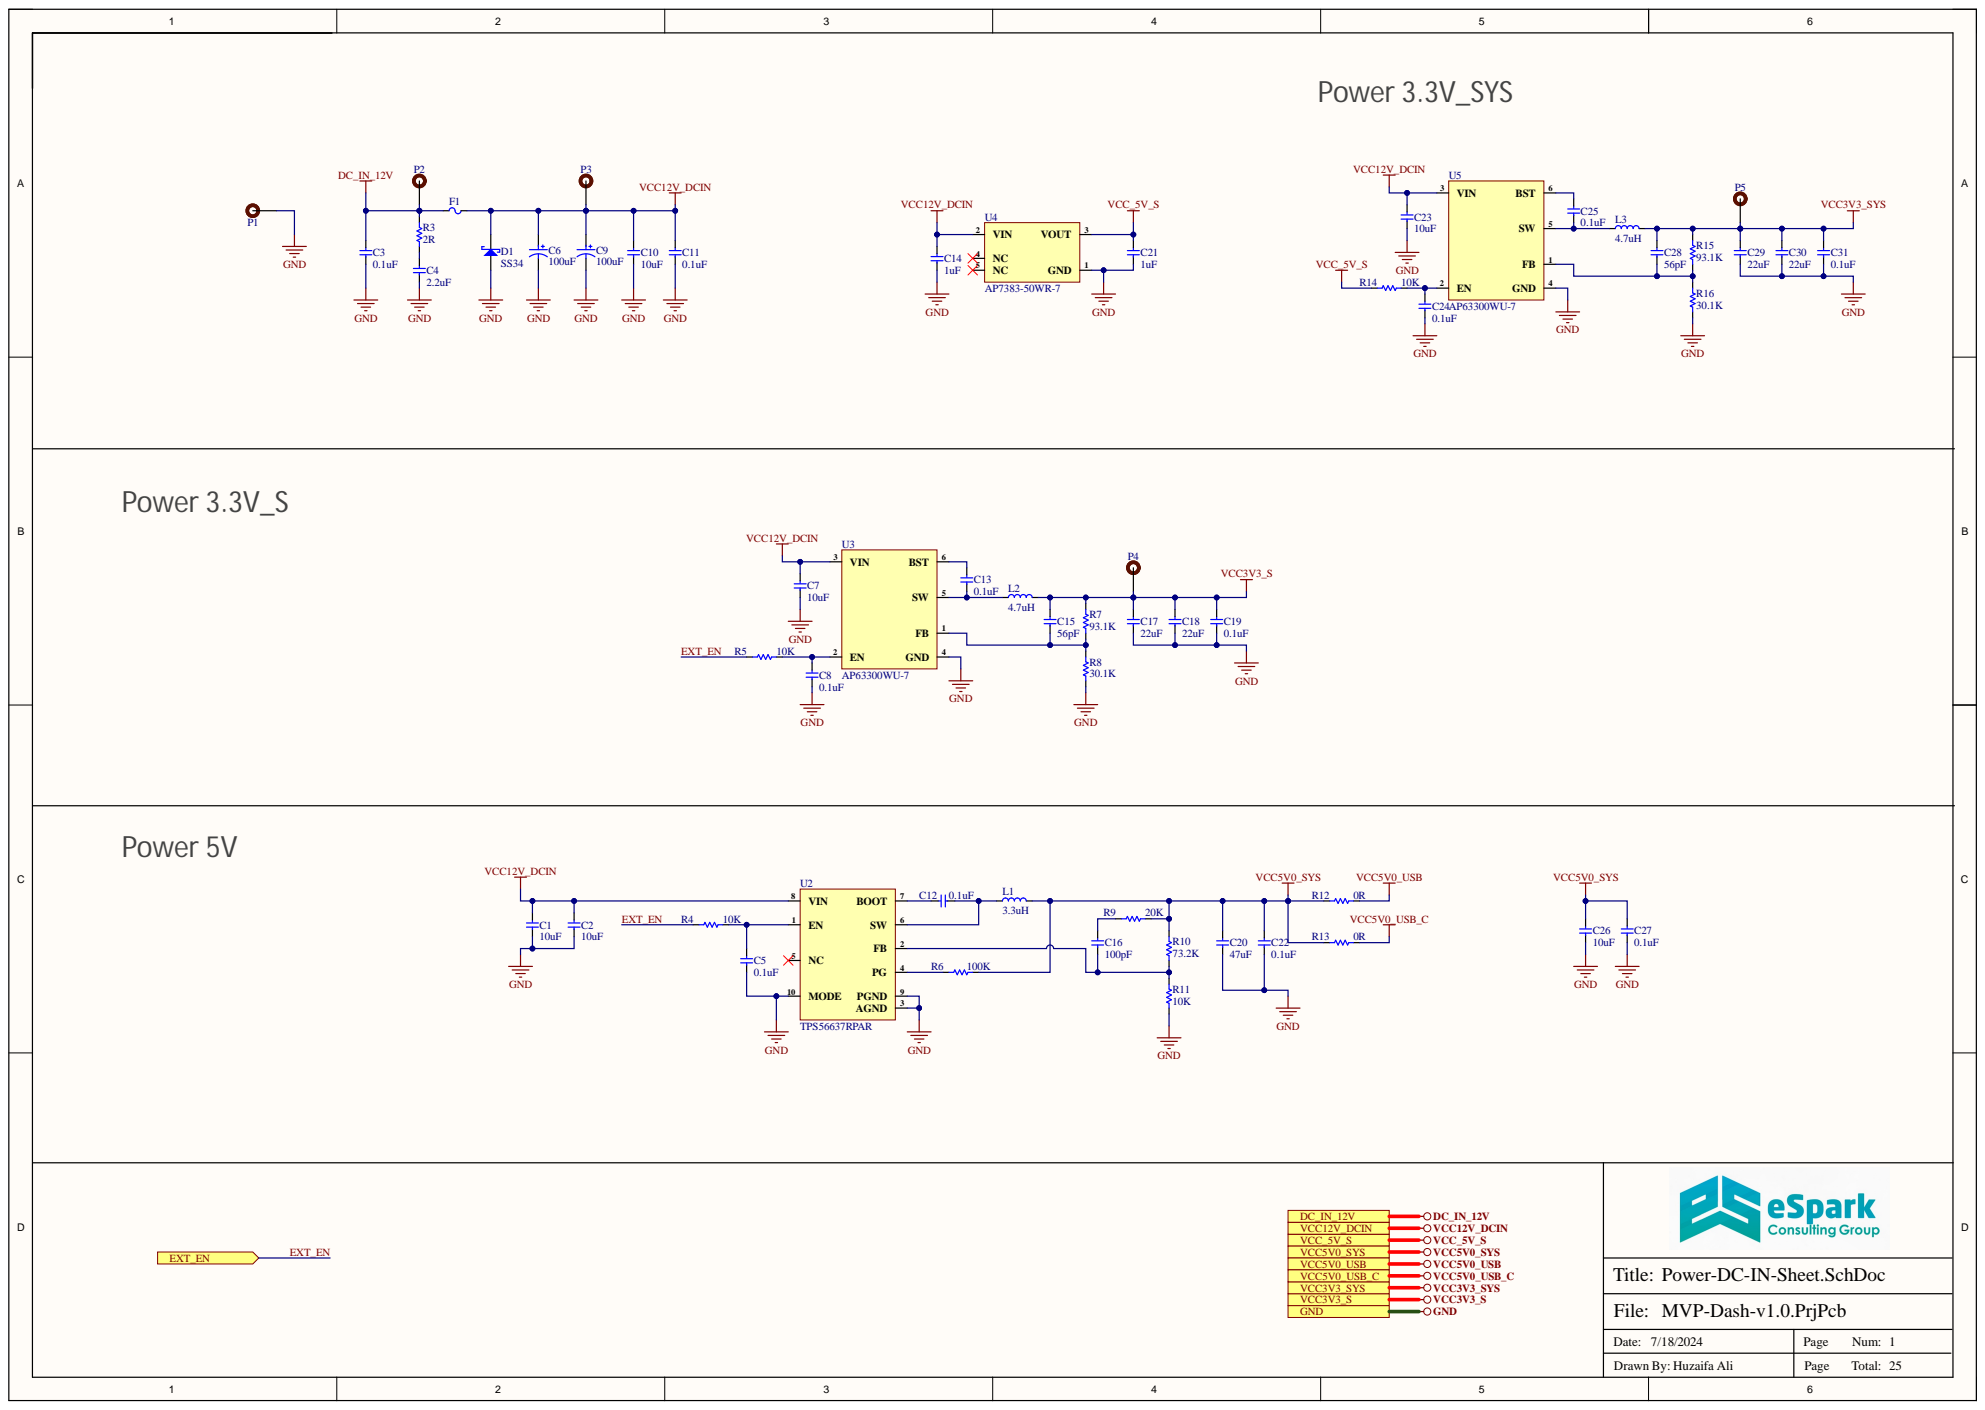
[picture p71: page 1]

C | GND | C

Power-DC-IN-Sheet.SchDoc

Date: 7/18/2024 | Page Num: 1

Drawn By: Huzaifa Ali | Page Total:

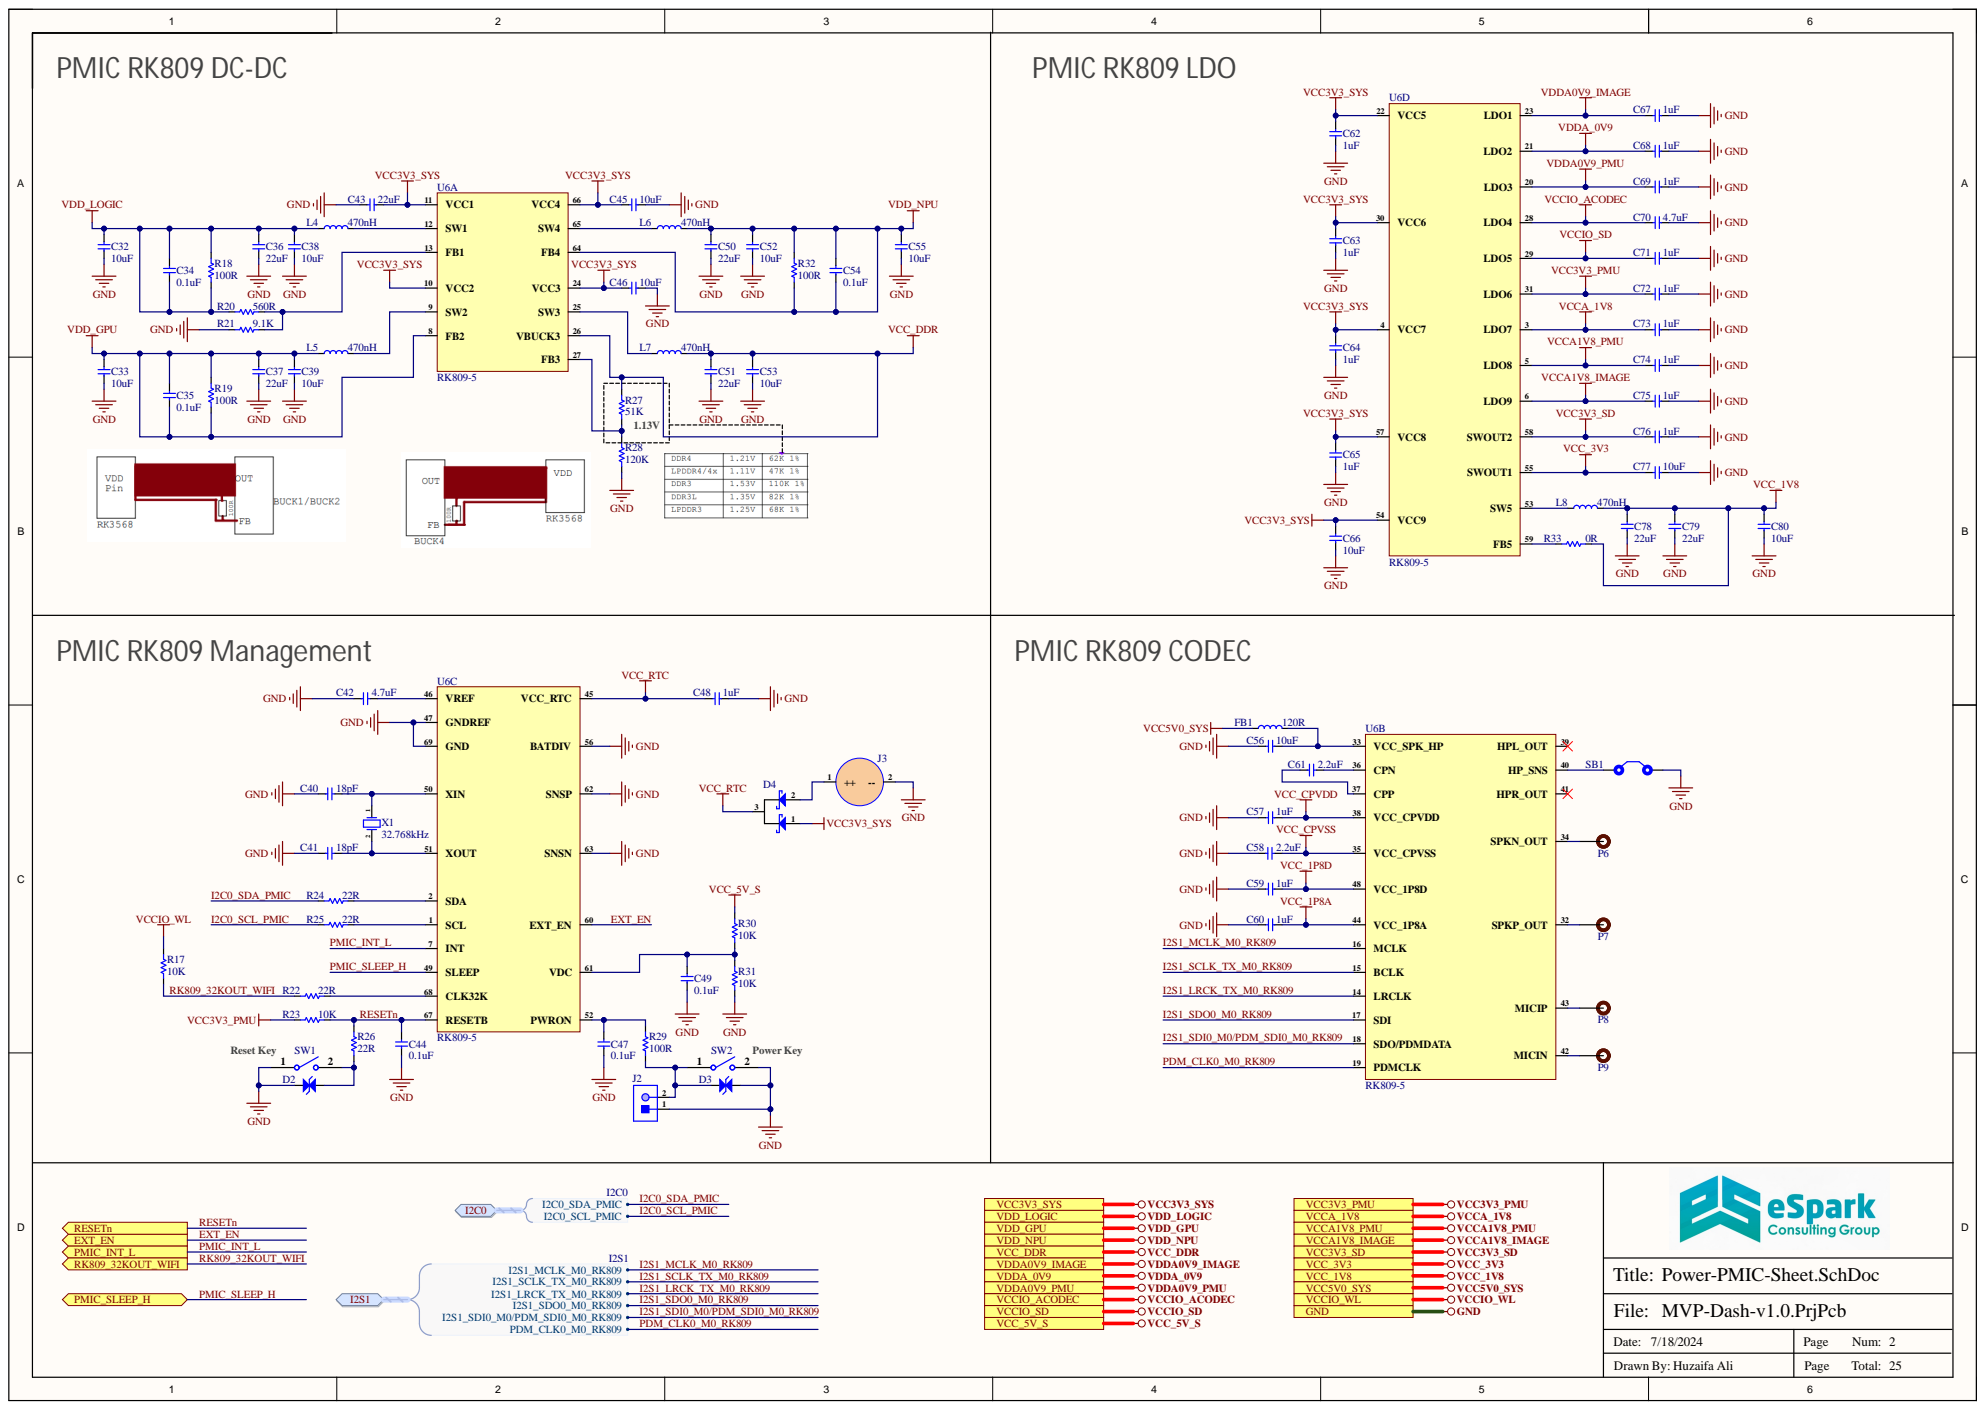
[picture p72: page 2]

Power-PMIC-Sheet.SchDoc

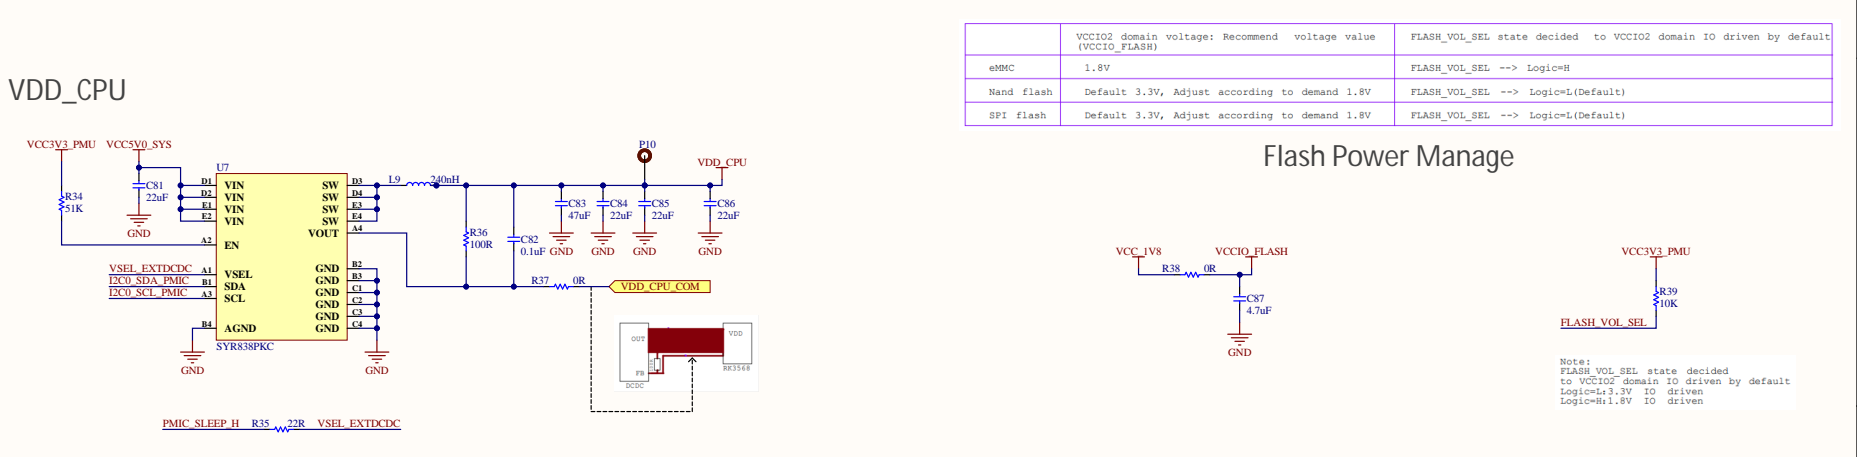
[picture p73: page 3]

Power-Others-Sheet.SchDoc

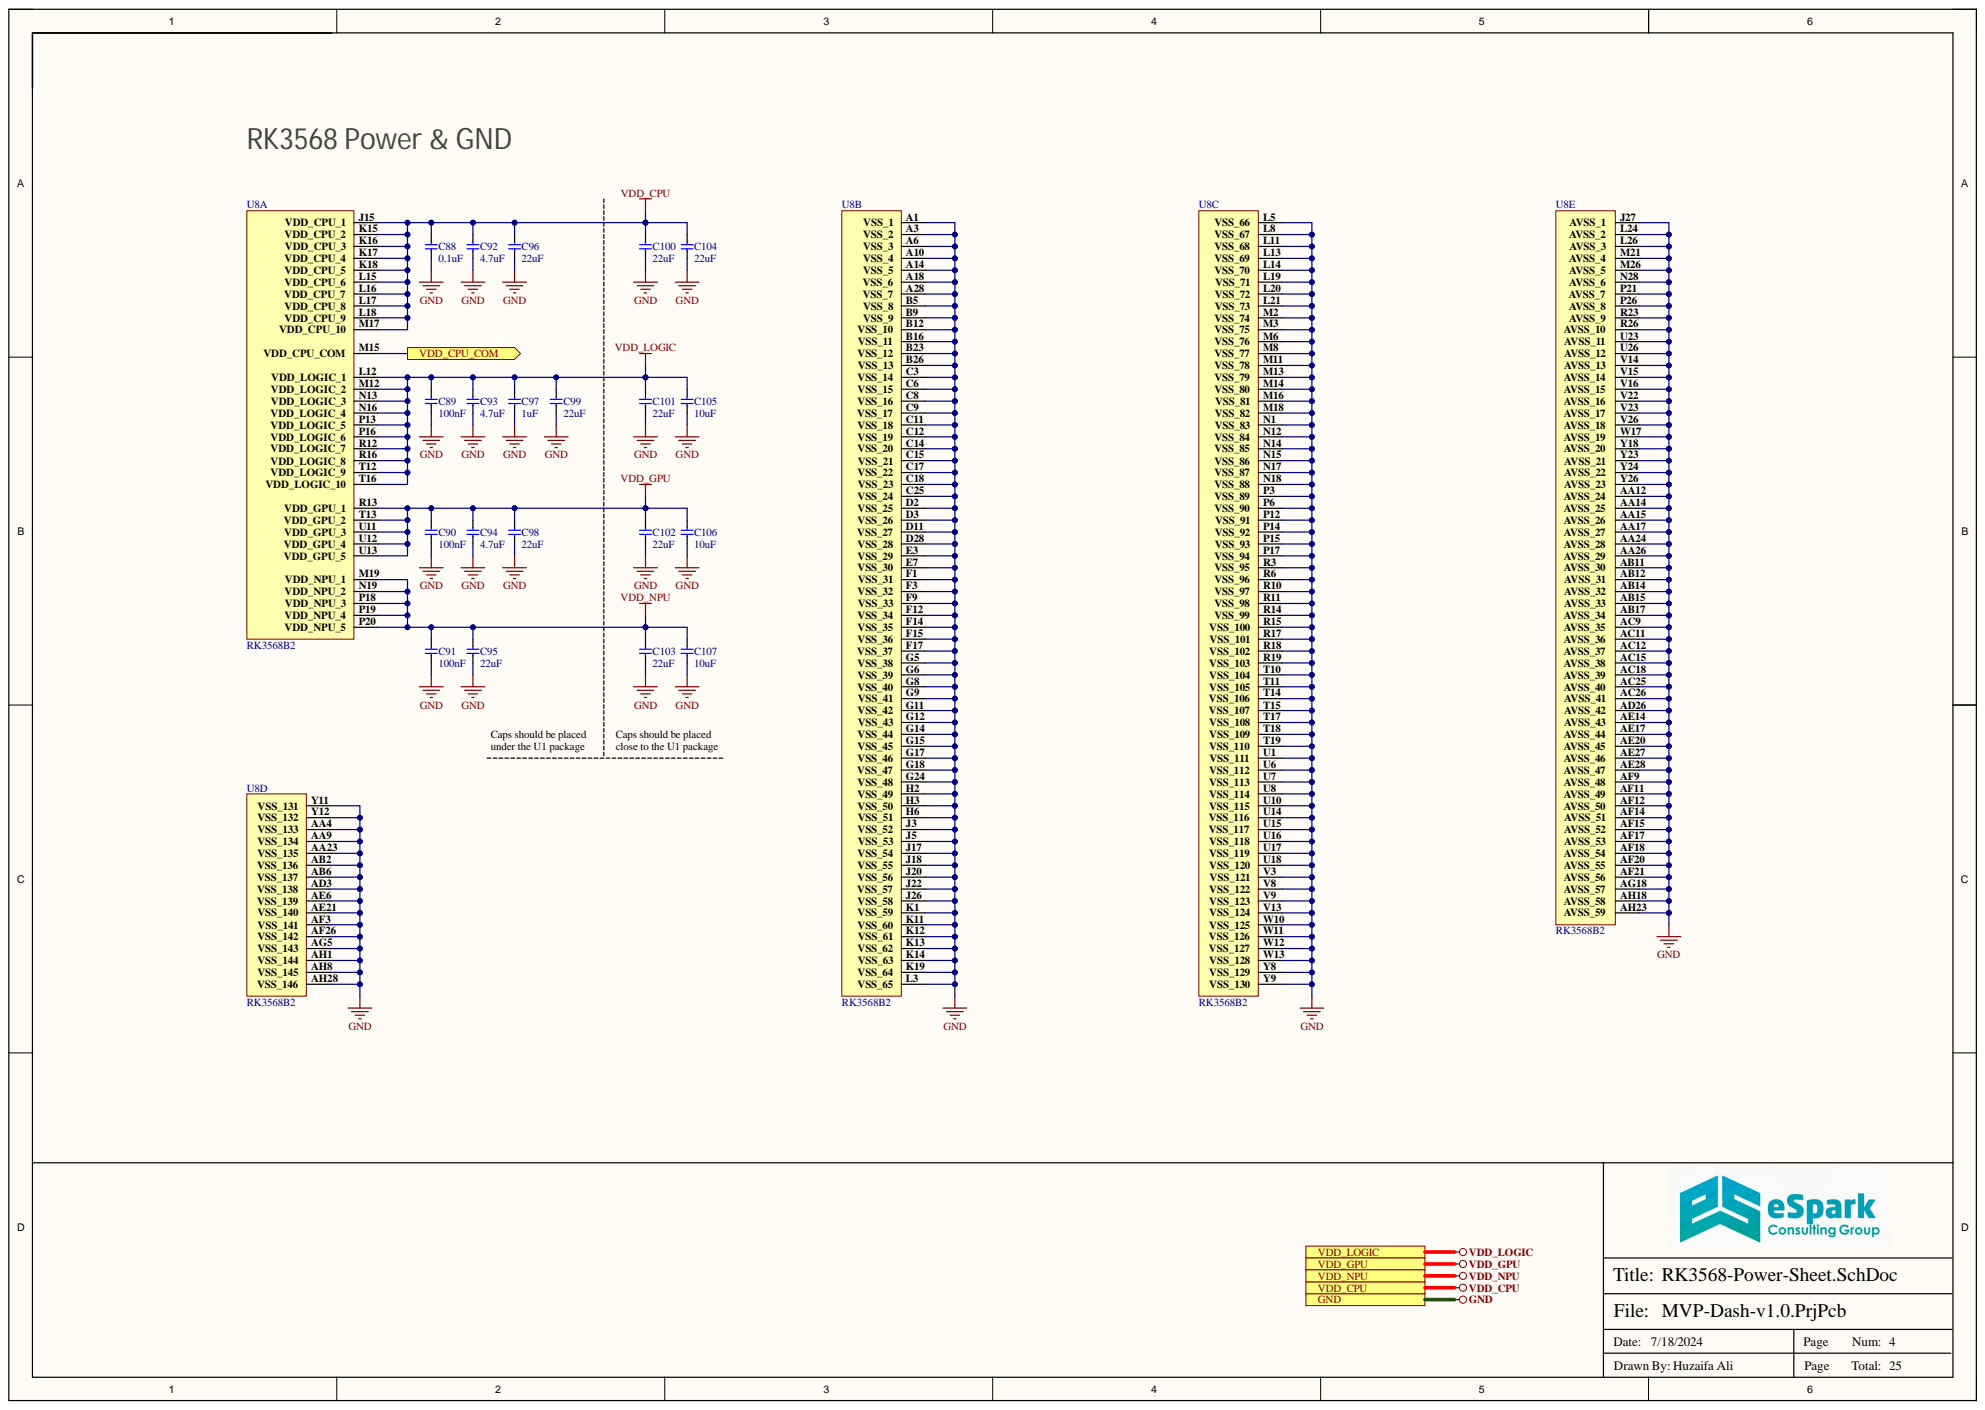
[picture p74: page 4]

Caps should be placed
under the U1 package

close to the U1 package

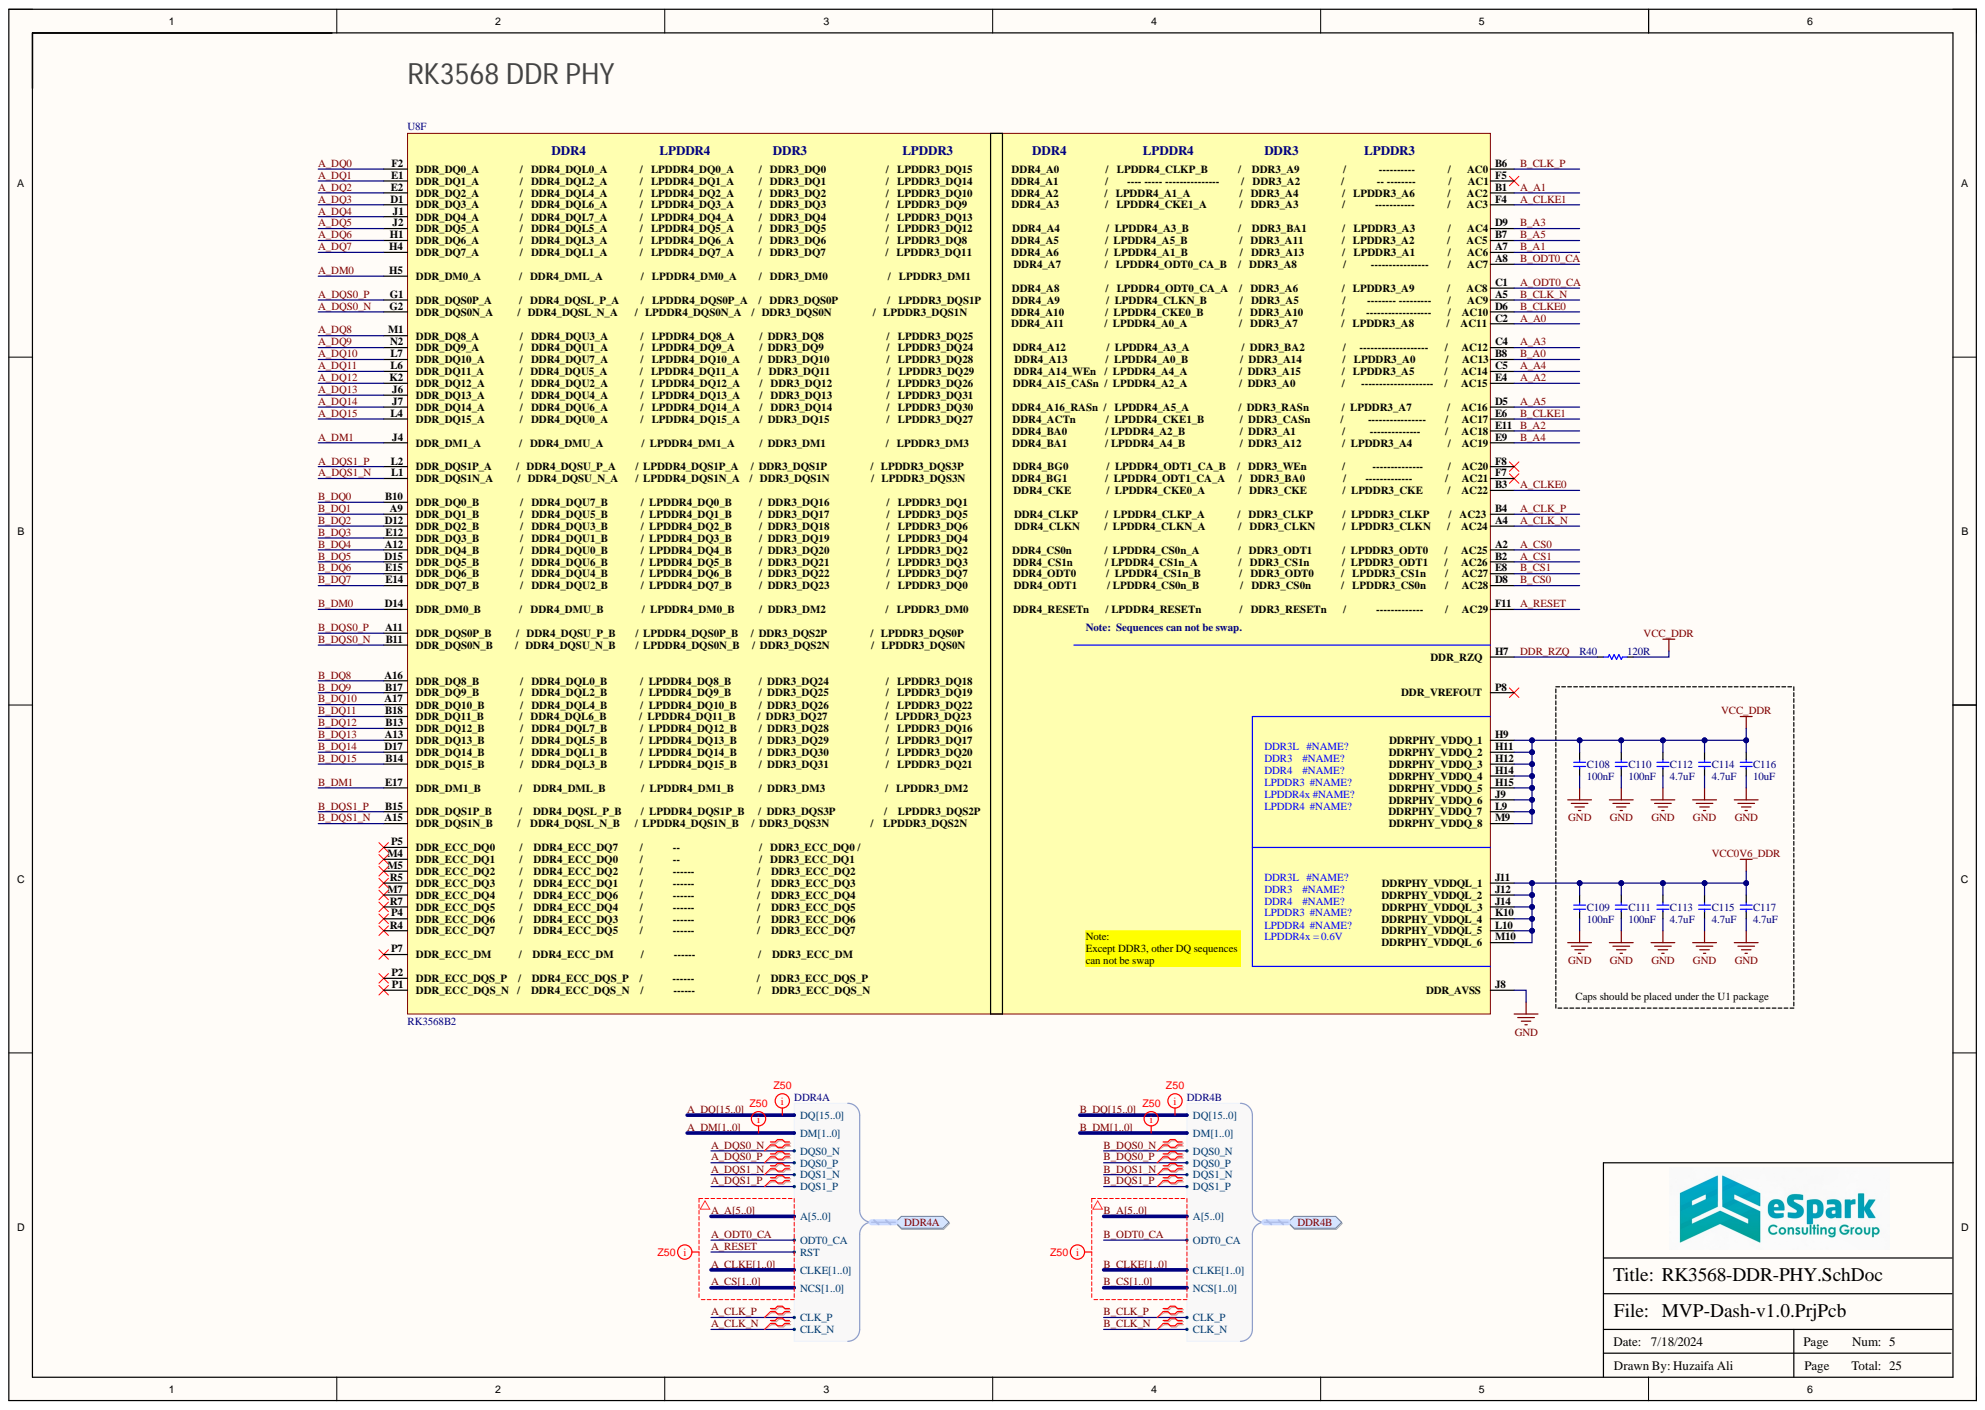
[picture p75: page 5]

Note: Sequences can not be swap.

Note
Except DDR3, other DQ sequences
can not be swap

Caps should be placed under the U1 package

Date : 7/1 8 /2 0 2 4 | Pag e Nu m : 52

Drawn By: Huzaifa Ali | Pag e Total :

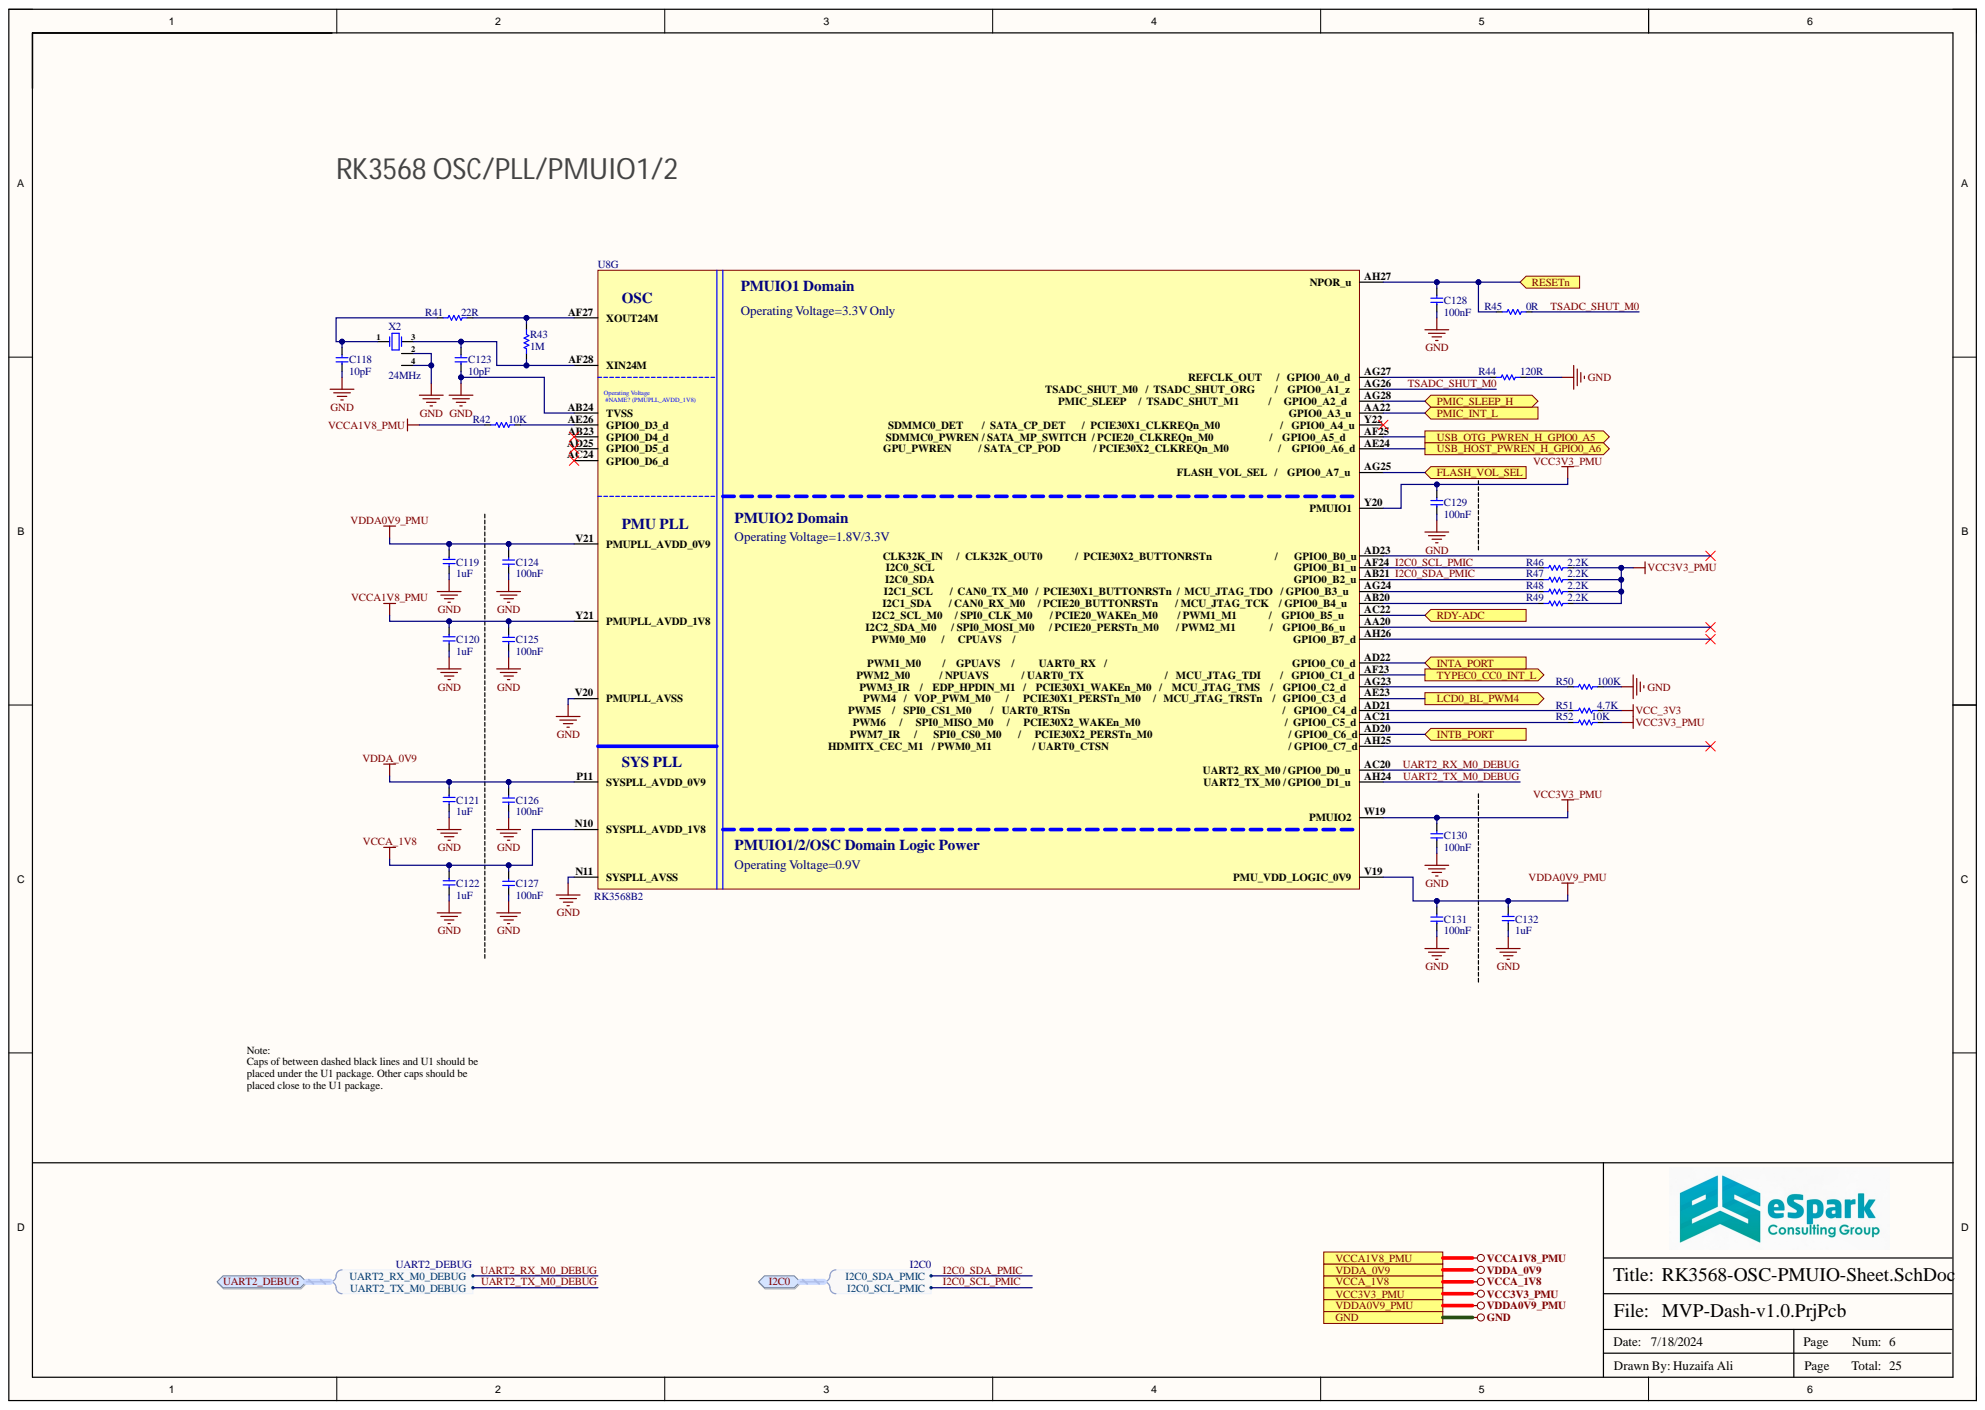
[picture p76: page 6]

PMUIO1/2/OSC Domain Logic Power
Operating Voltage=0.9V

Note:
Caps of between dashed black lines and U1 should be
placed under the U1 package. Other caps should be
placed close to the U1 package.

RK3568-OSC-PMUIO-Sheet.SchDoc

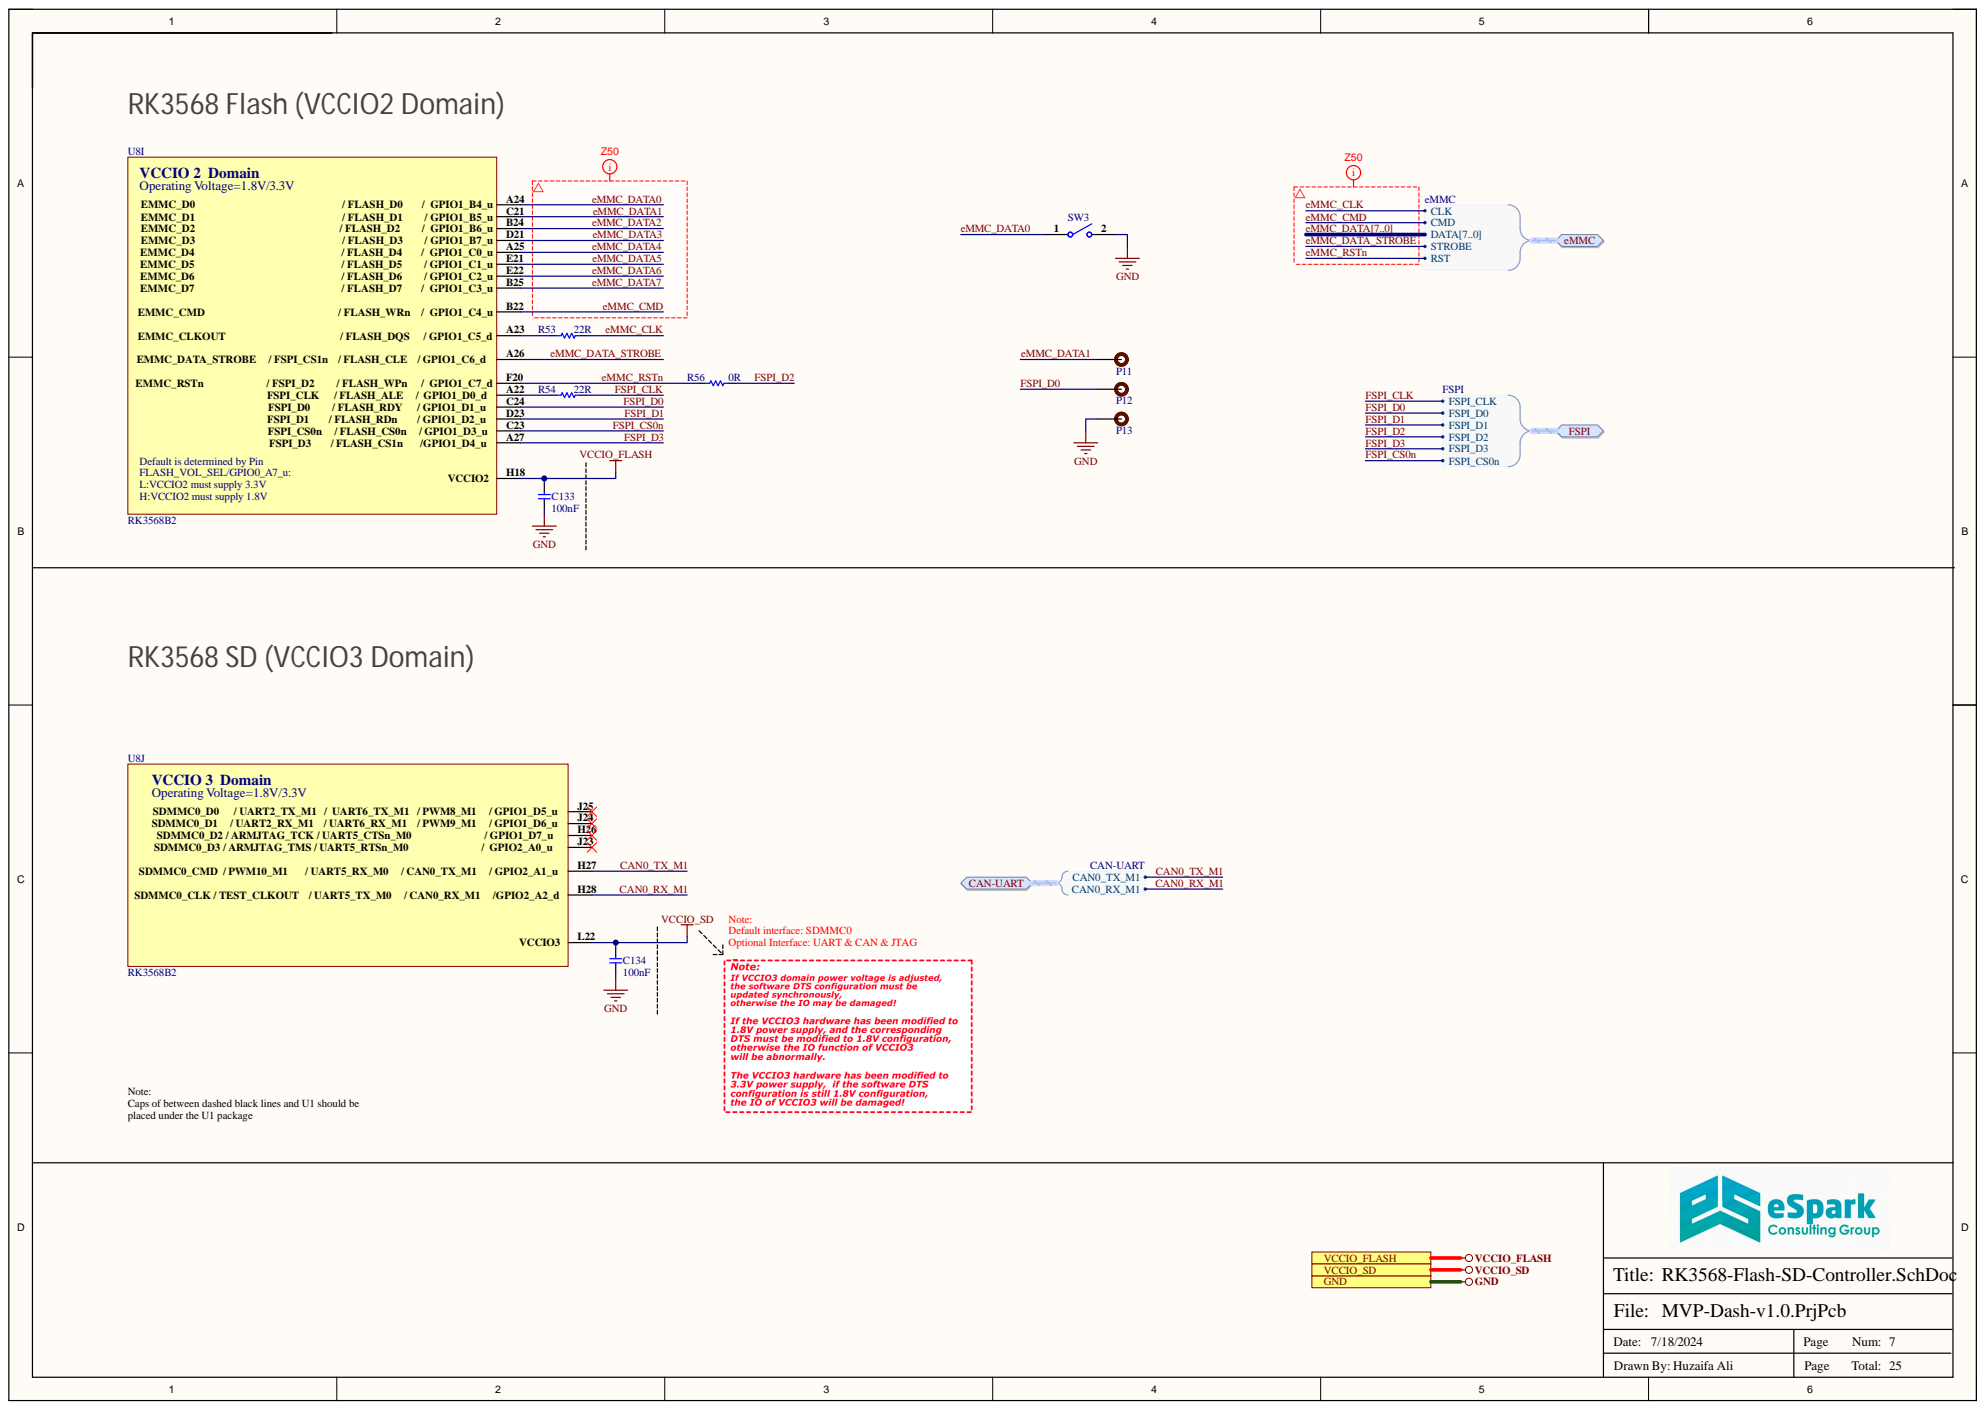
[picture p77: page 7]

VCCIO 2 Domain Operating Voltage=1.8V/3.3V

Default is determined by Pin
FLASH_VOL_SEL/GPIO0_A7_u:
L:VCCIO2 must supply 3.3V
H:VCCIO2 must supply 1.8V

VCCIO 3 Domain Operating Voltage=1.8V/3.3V

Note:
Default interface: SDMMC0
Optional Interface: UART & CAN & JTAG

Caps of between dashed black lines and U1 should be
placed under the U1 package

RK3568-Flash-SD-Controller.SchDoc

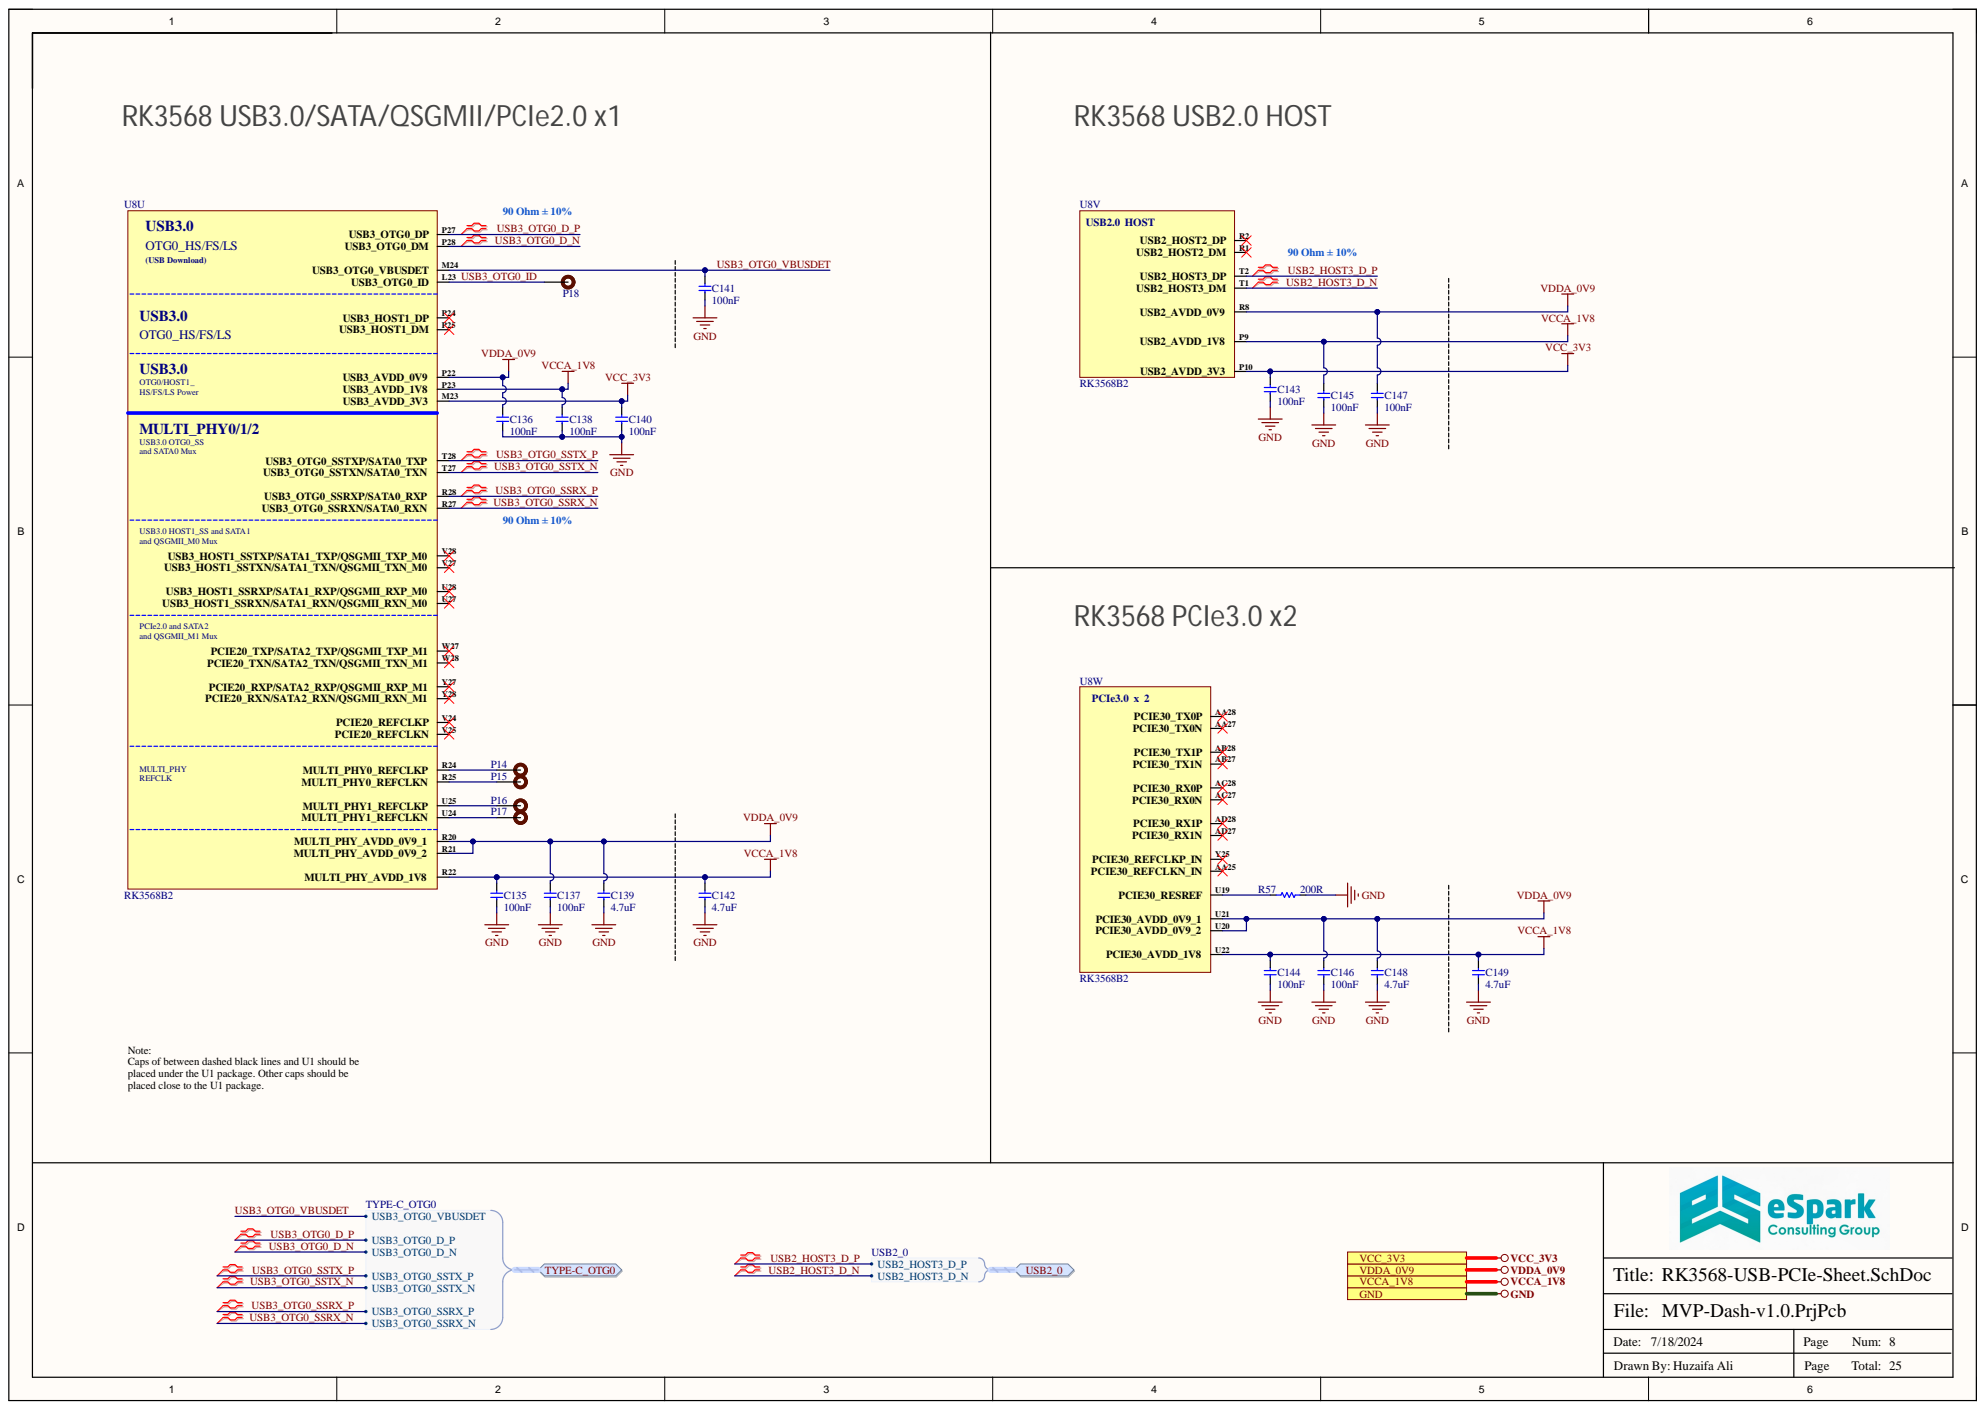
[picture p78: page 8]

HS/FS/LS Power

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

RK3568-USB-PCIe-Sheet.SchDoc

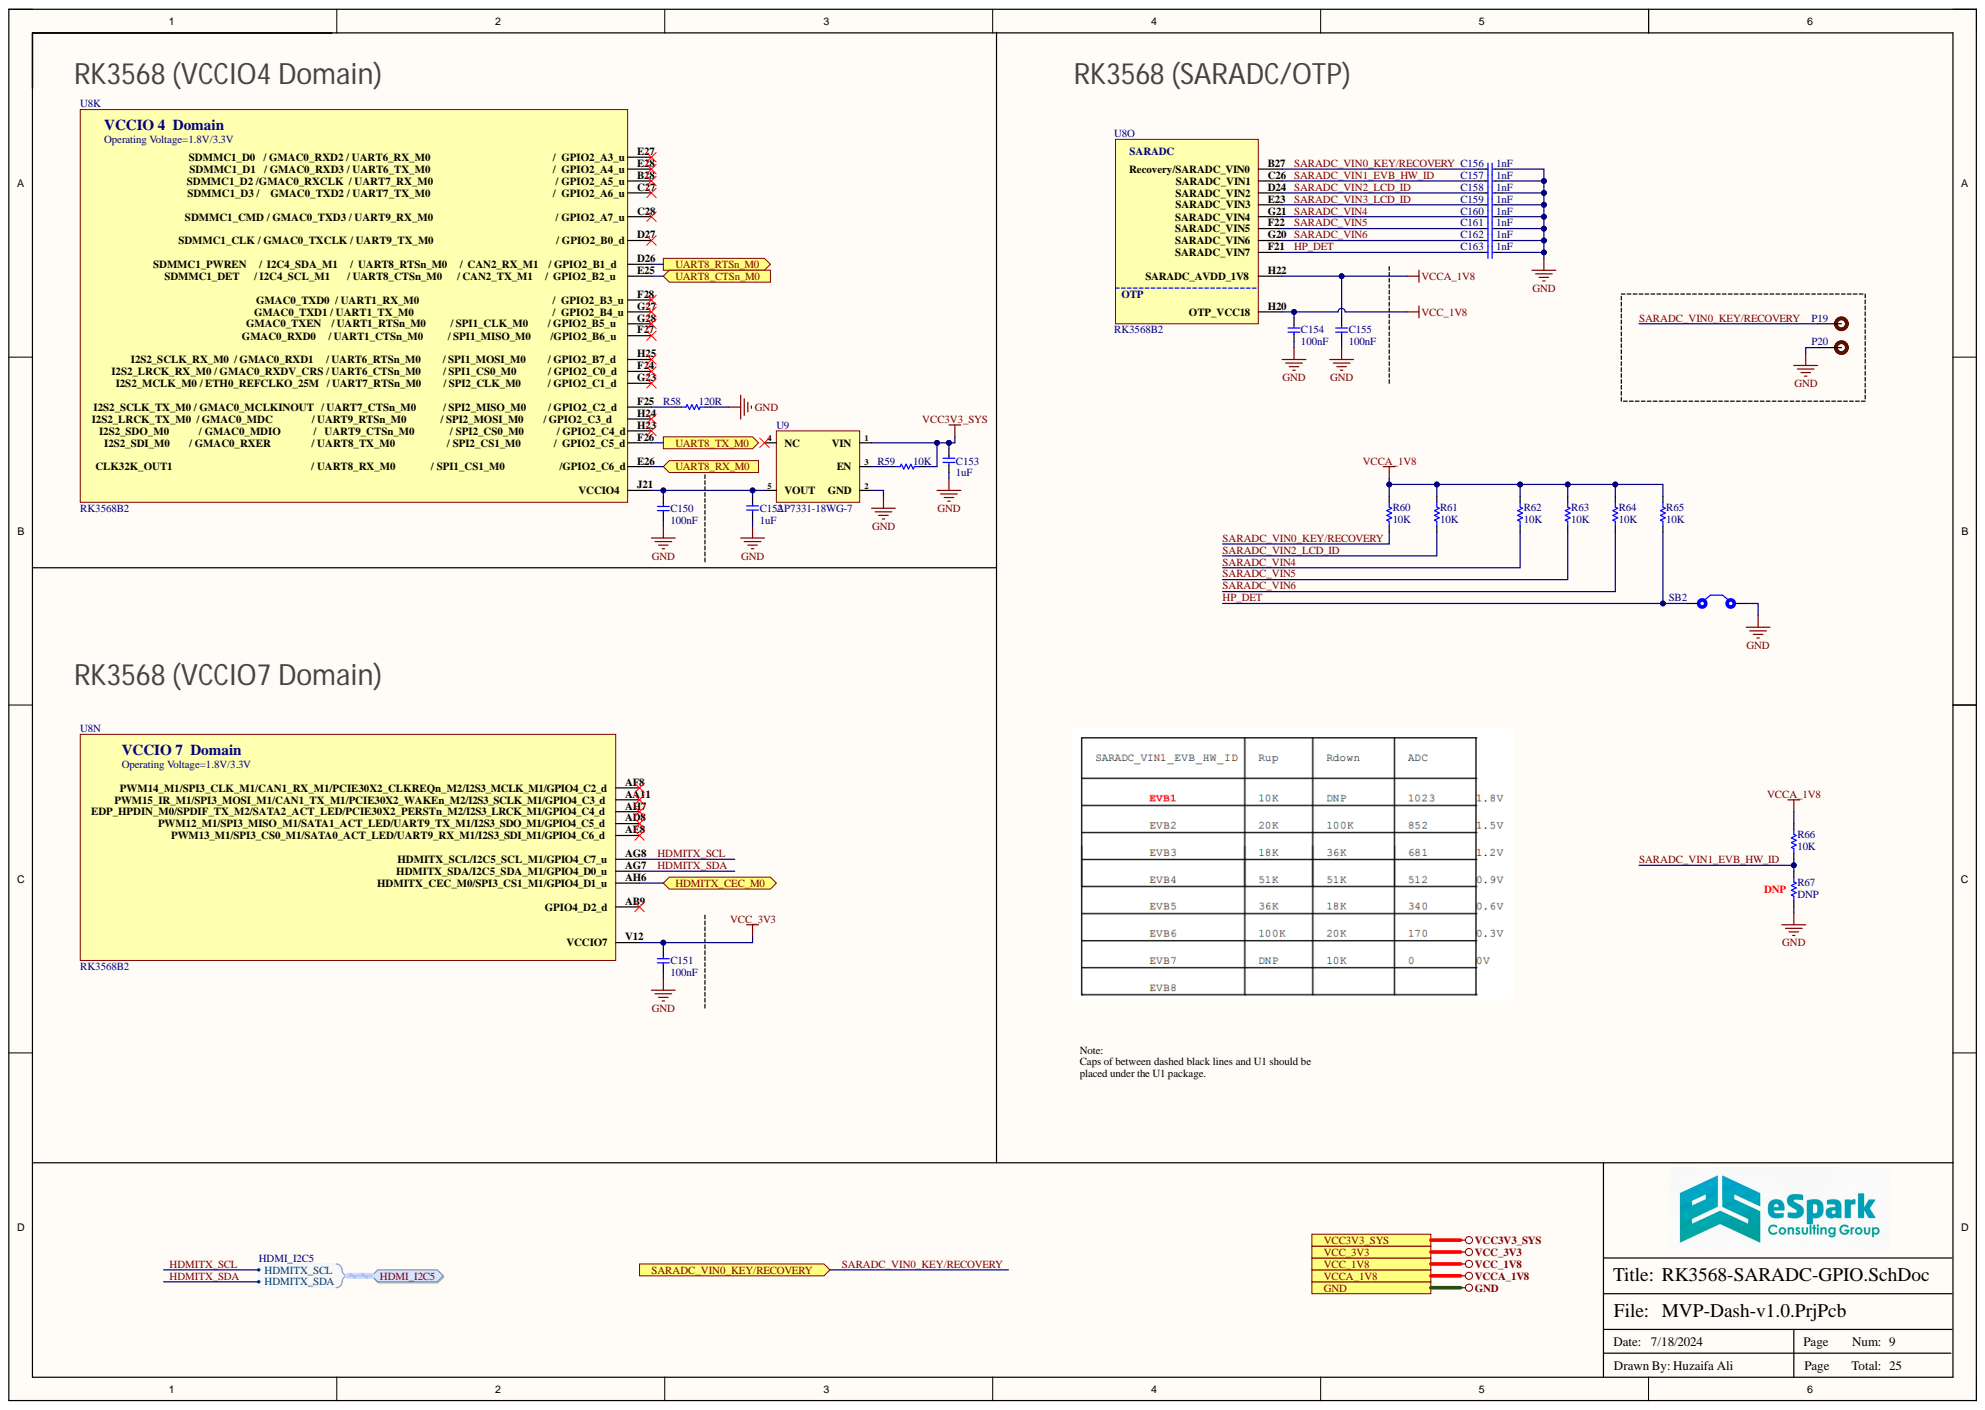
[picture p79: page 9]

VCCIO 4 Domain Operating Voltage=1.8V/3.3V

VCCIO 7 Domain Operating Voltage=1.8V/3.3V

Note:
Caps of between dashed black lines and U1 should be
placed under the U1 package.

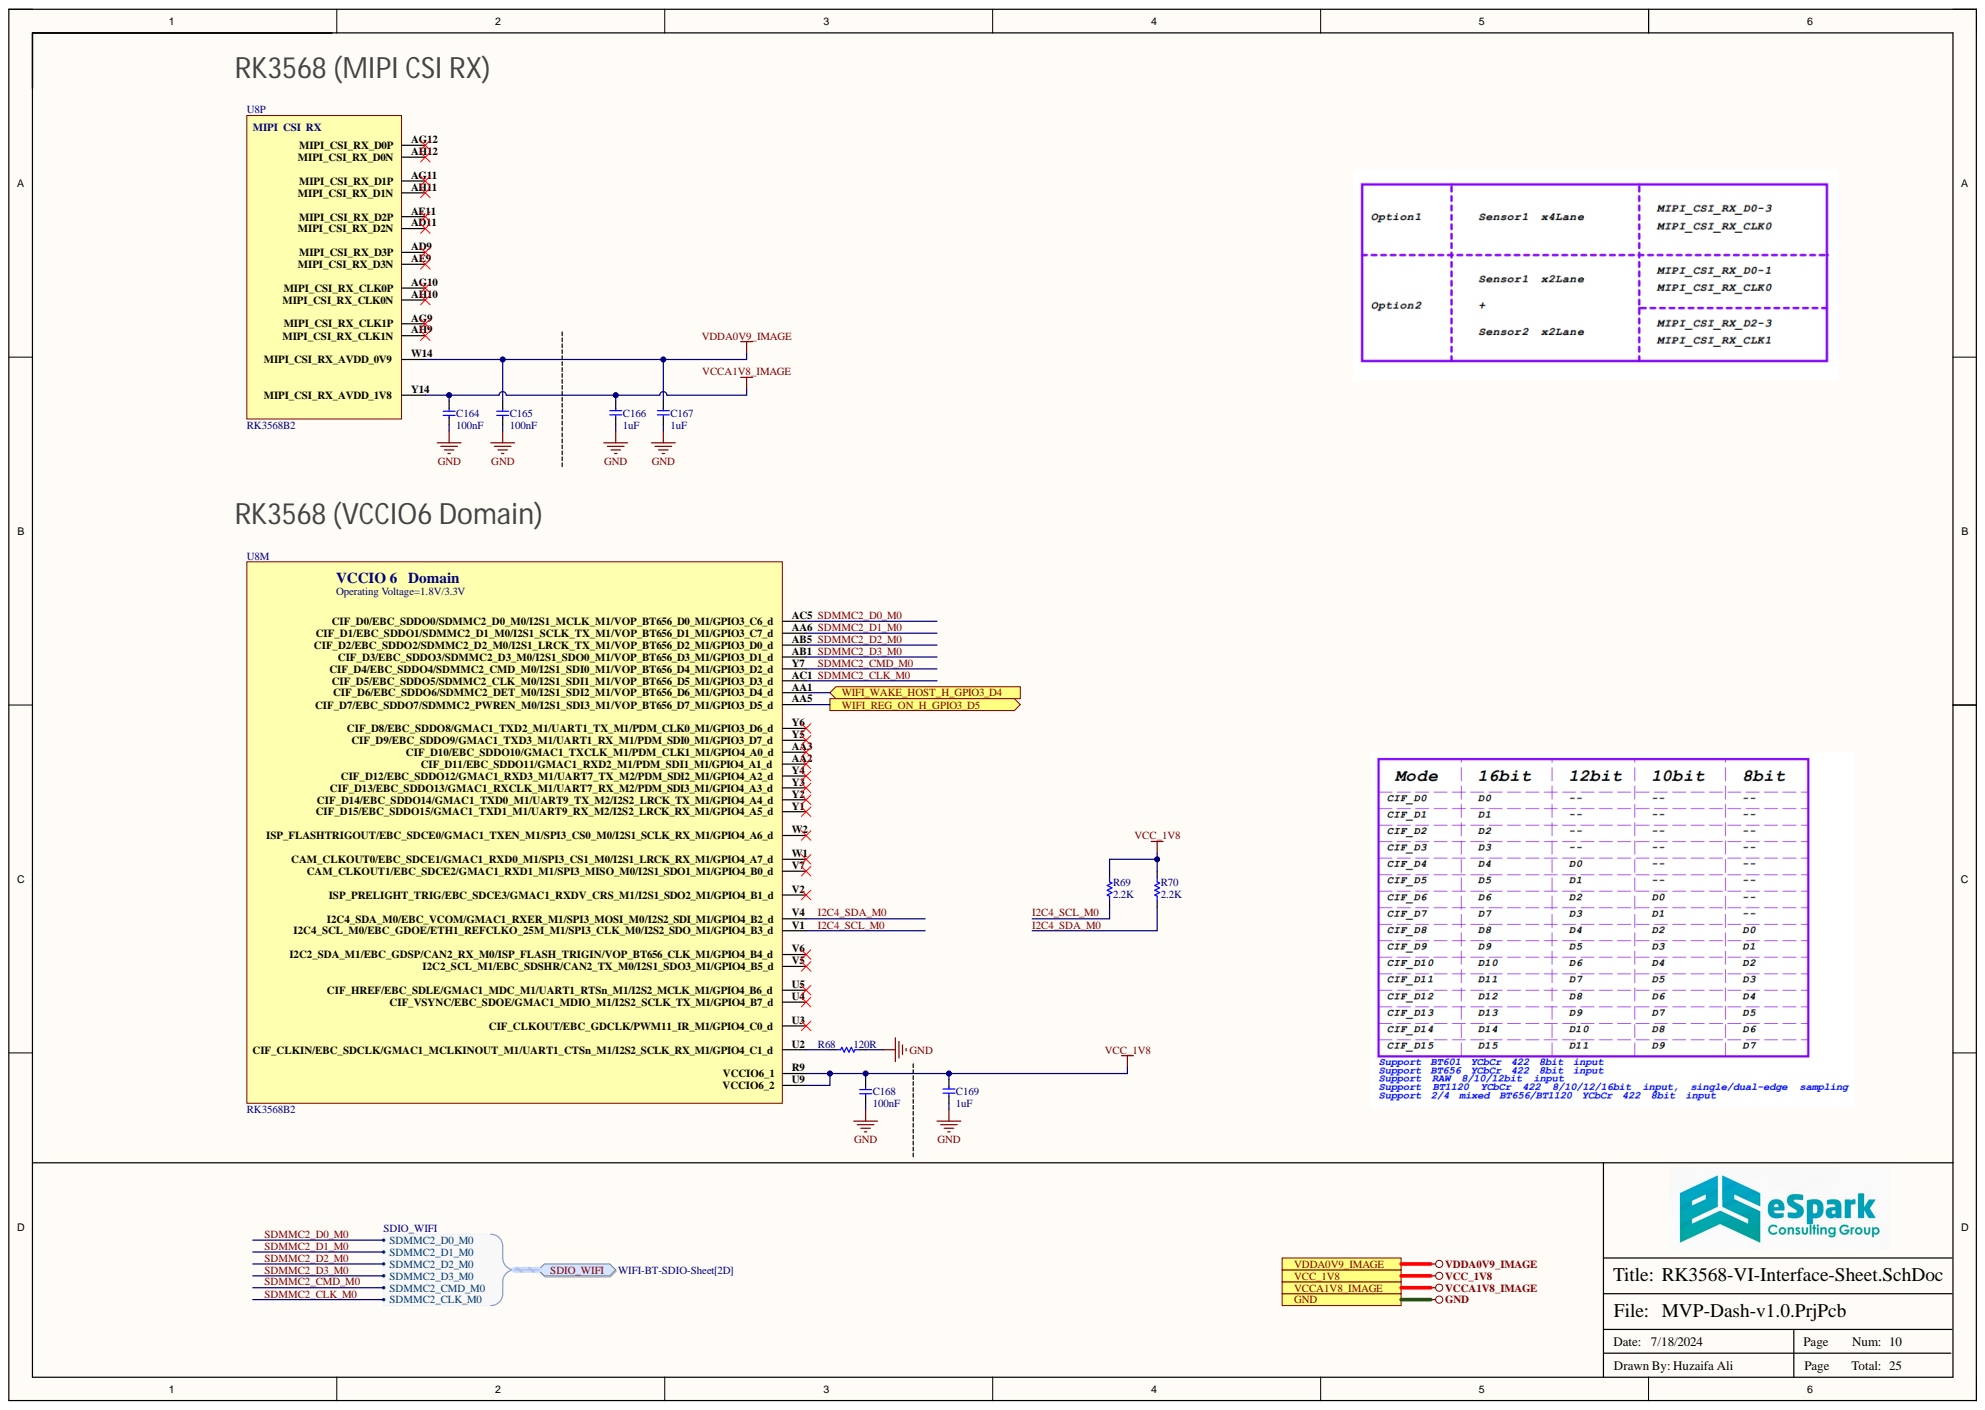
[picture p80: page 10]

VCCIO 6 Domain Operating Voltage=1.8V/3.3V

RK3568-VI-Interface-Sheet.SchDoc

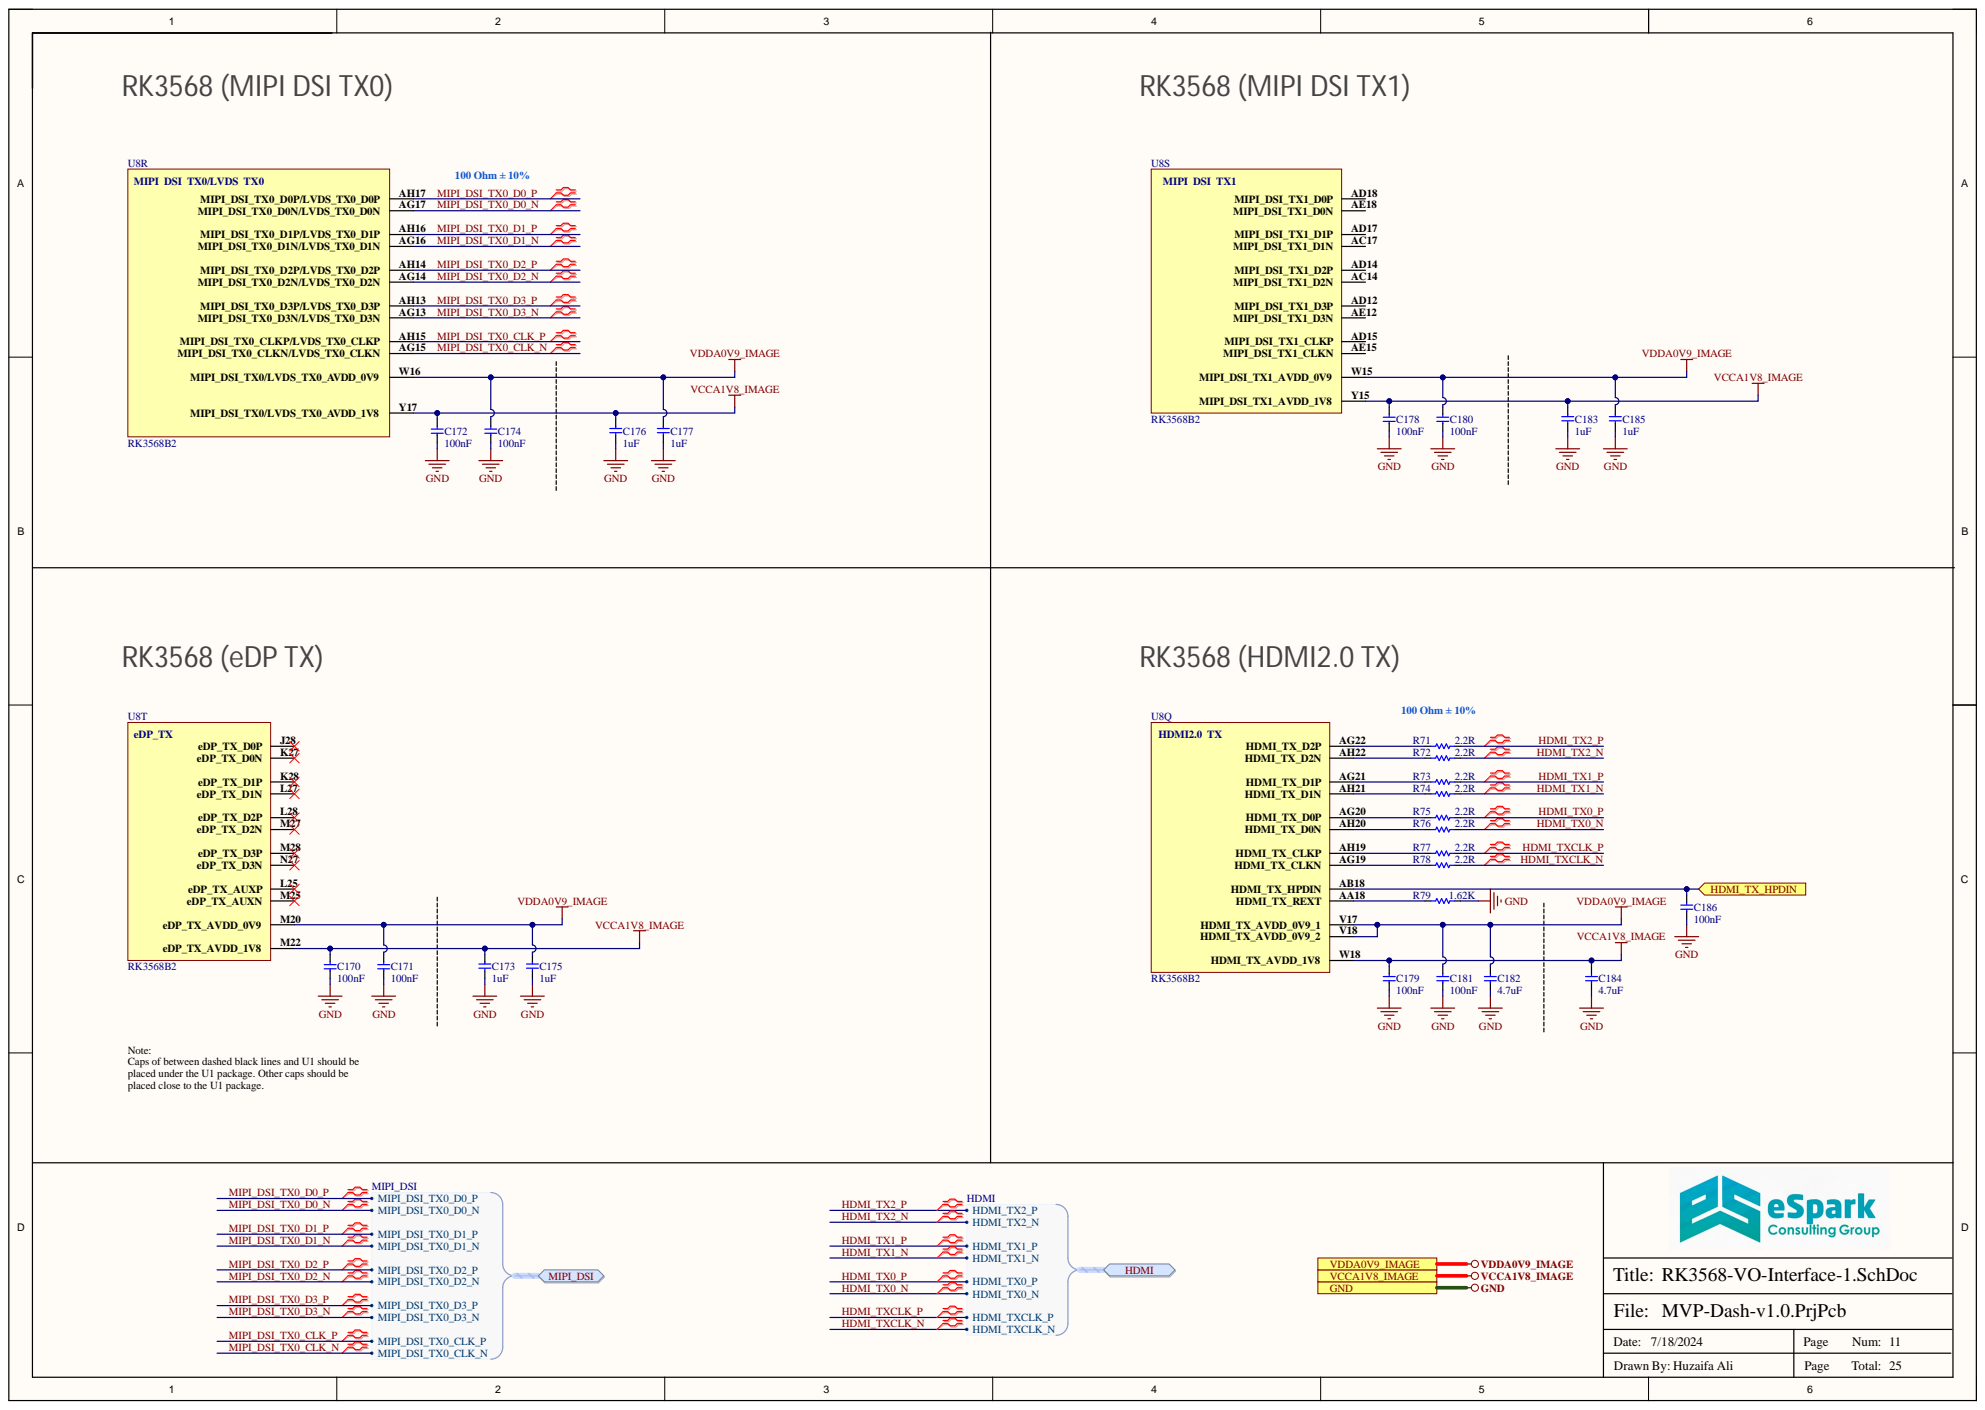
[picture p81: page 11]
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

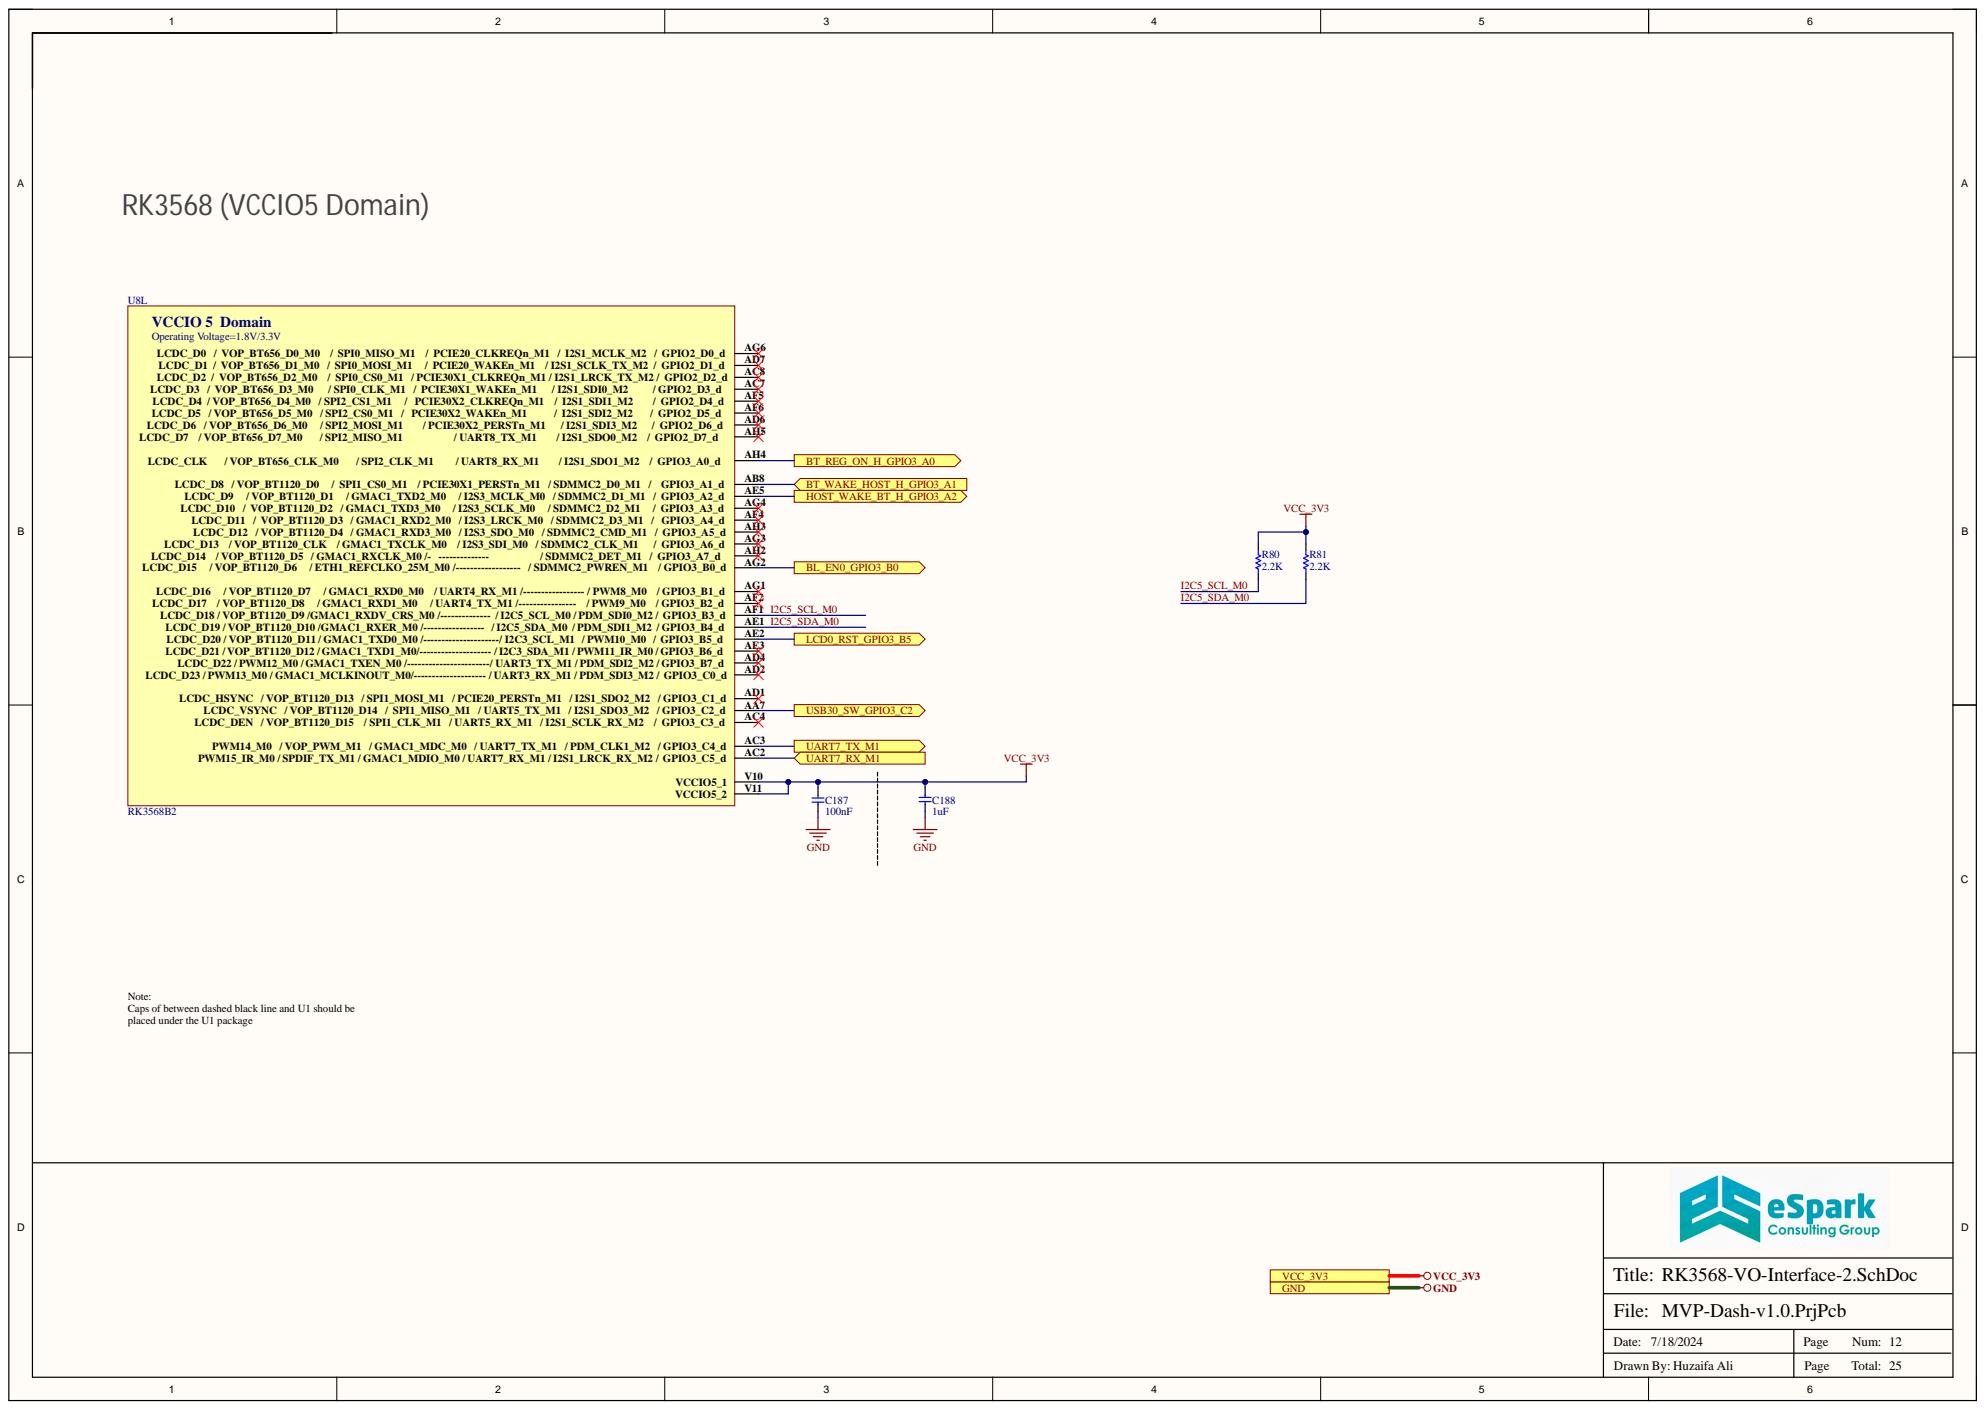
[picture p82: page 12]

VCCIO 5 Domain Operating Voltage=1.8V/3.3V

Note:
Caps of between dashed black line and U1 should be
placed under the U1 package

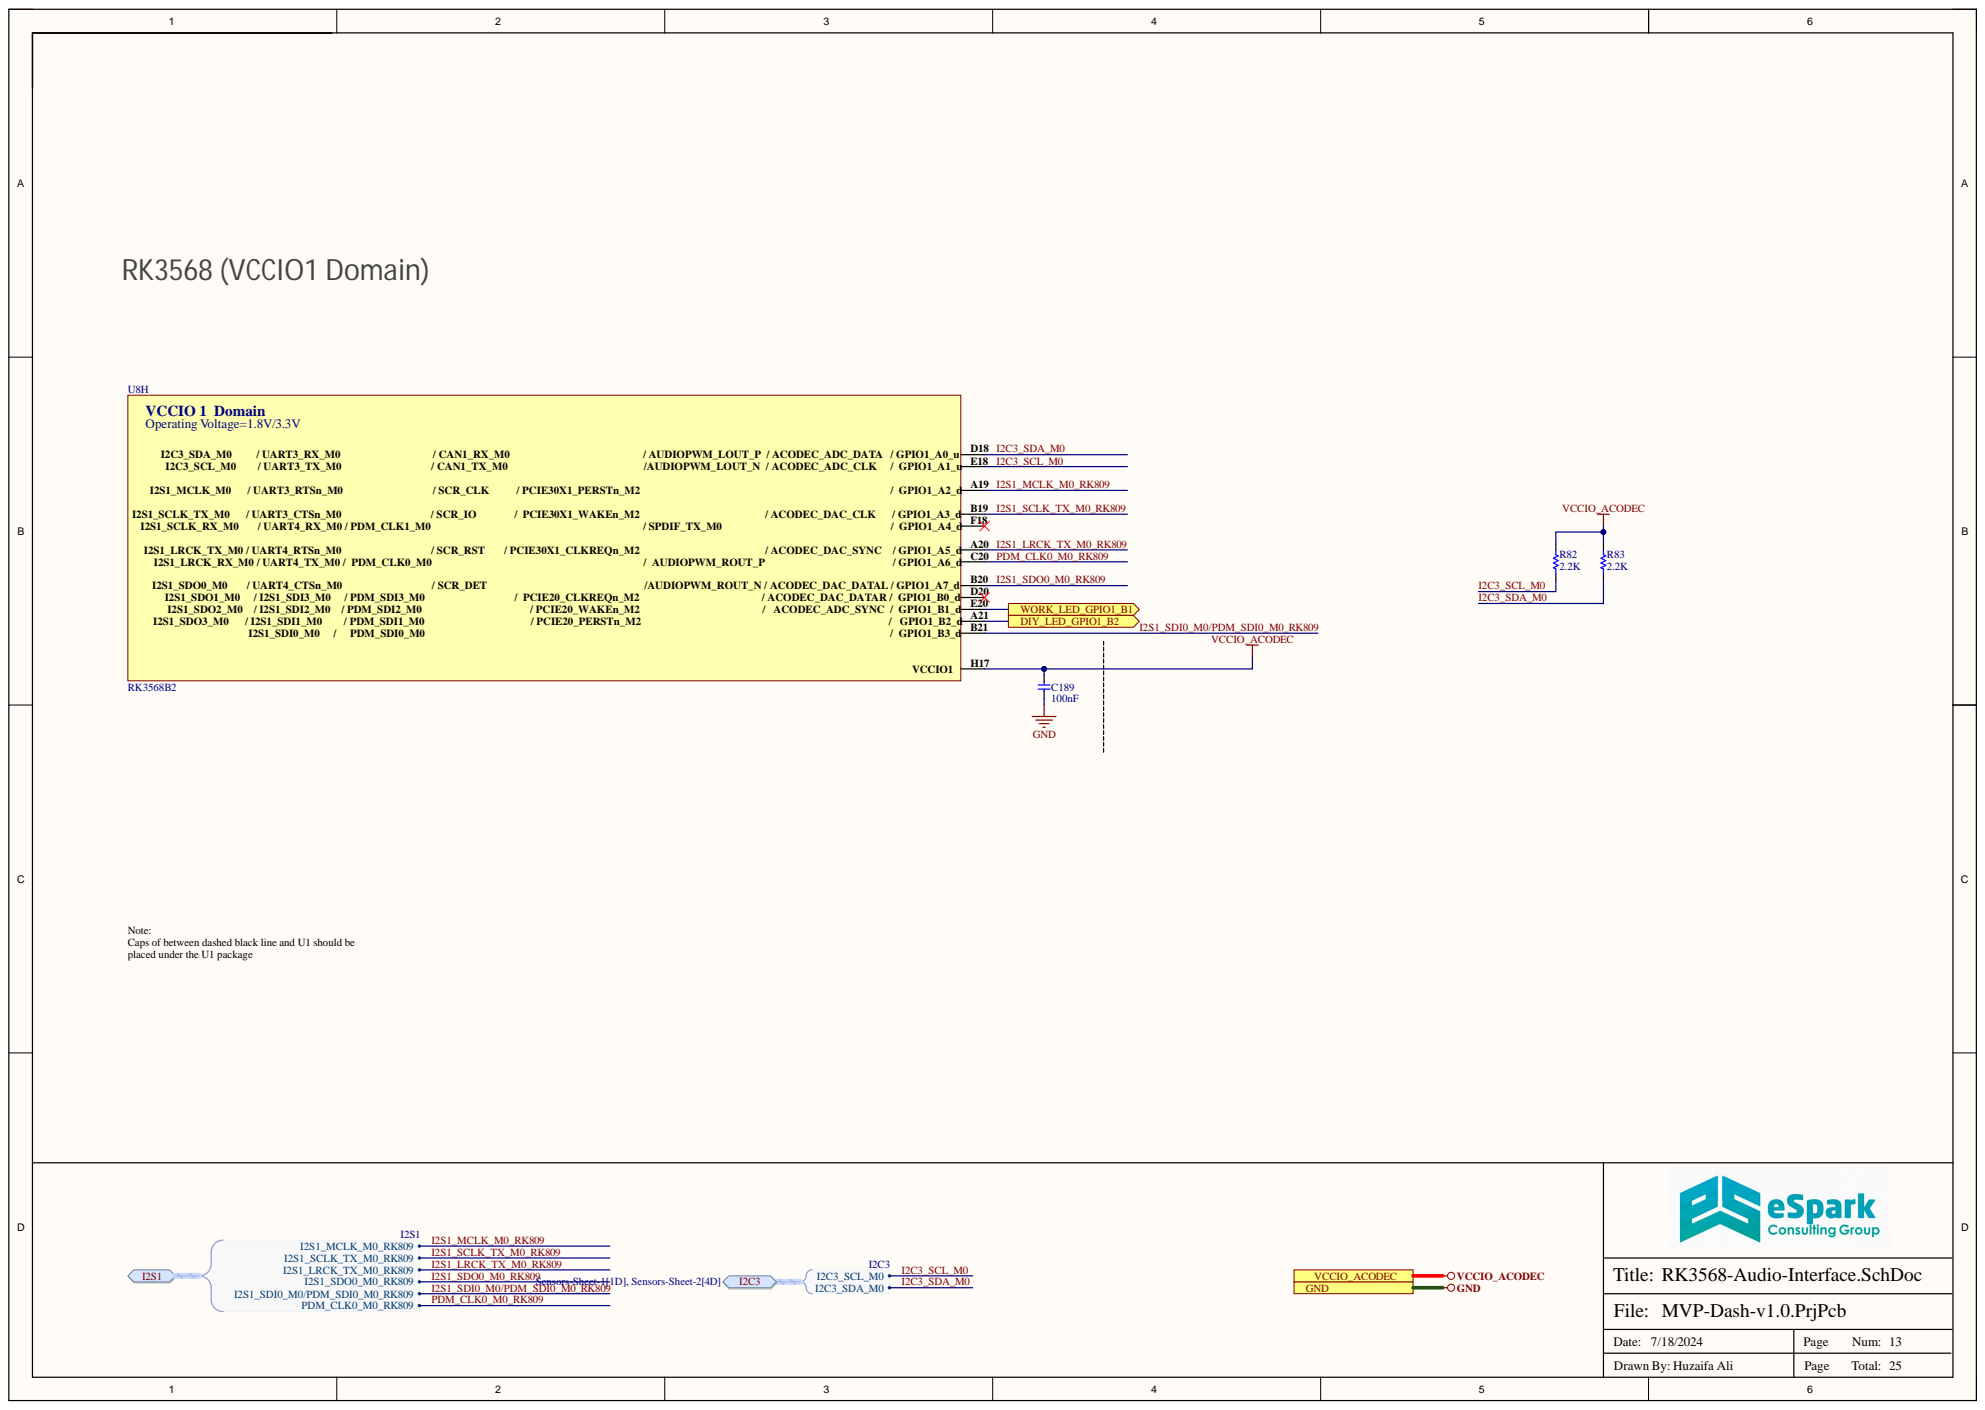
[picture p83: page 13]

VCCIO 1 Domain Operating Voltage=1.8V/3.3V

Note:
Caps of between dashed black line and U1 should be
placed under the U1 package

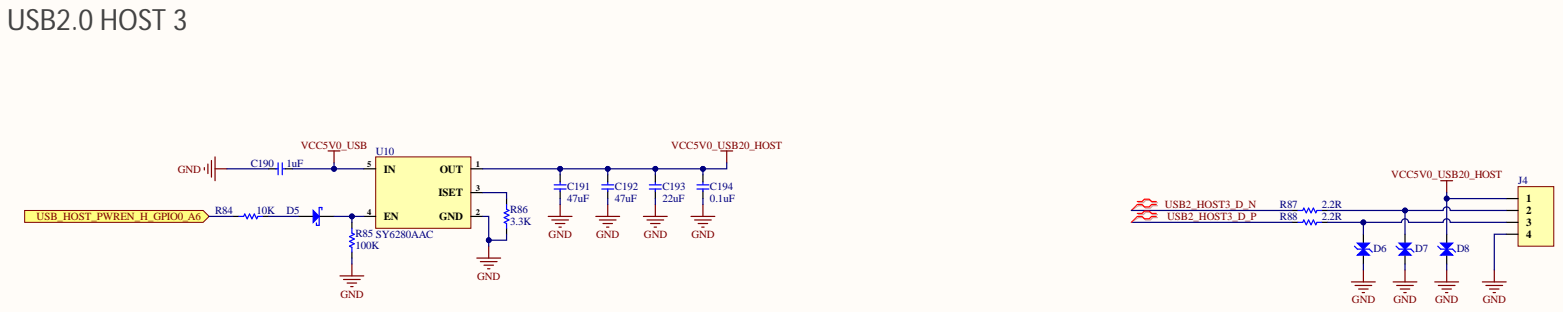
[picture p84: page 14]

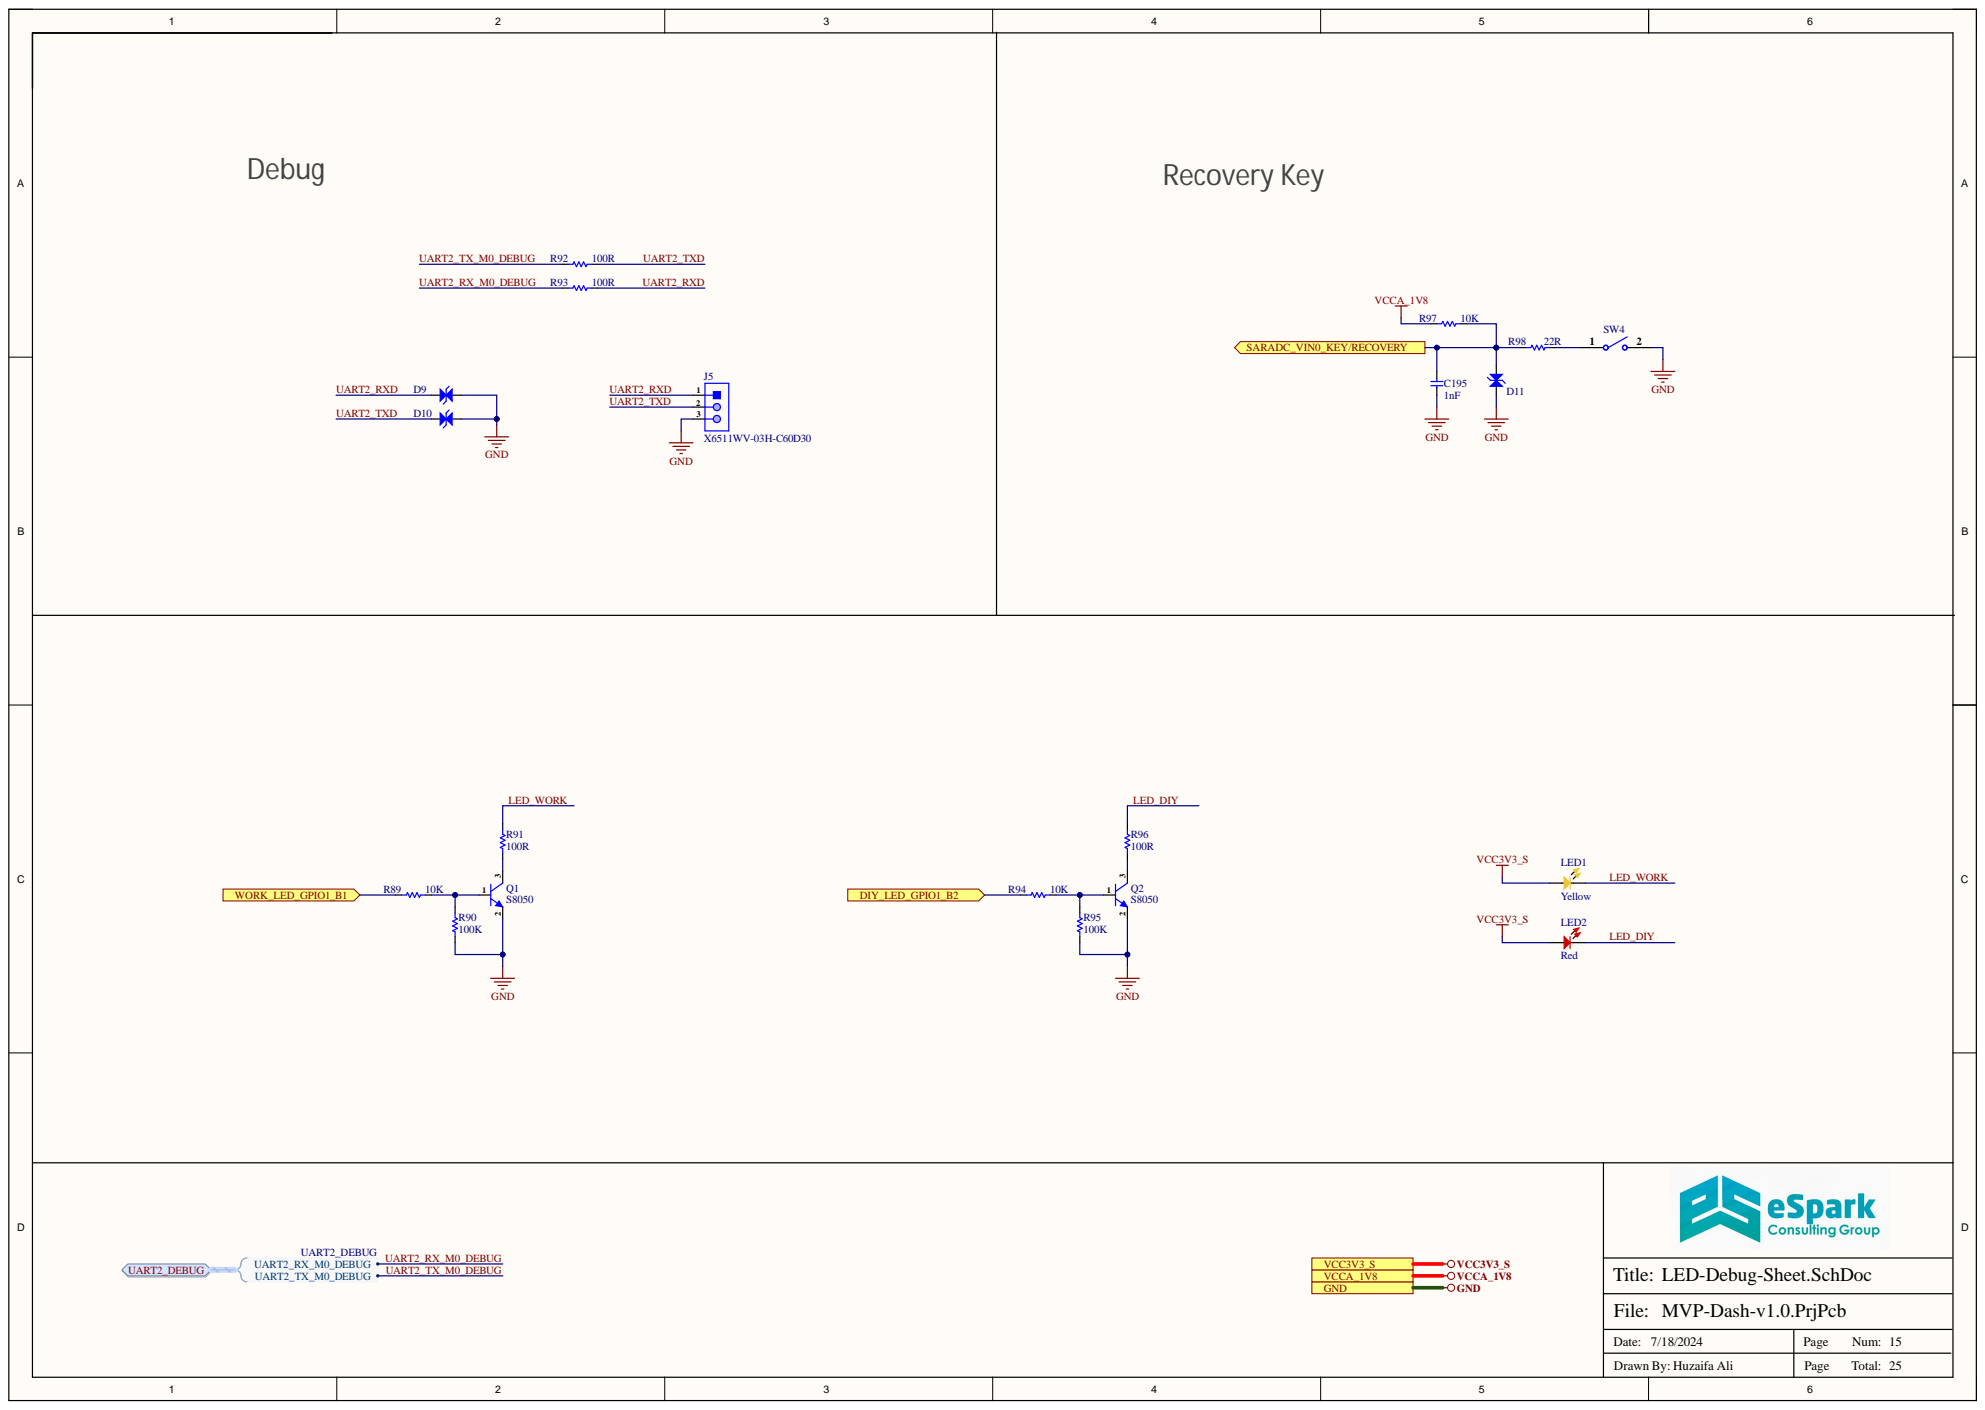
[picture p85: page 15]

LED-Debug-Sheet.SchDoc

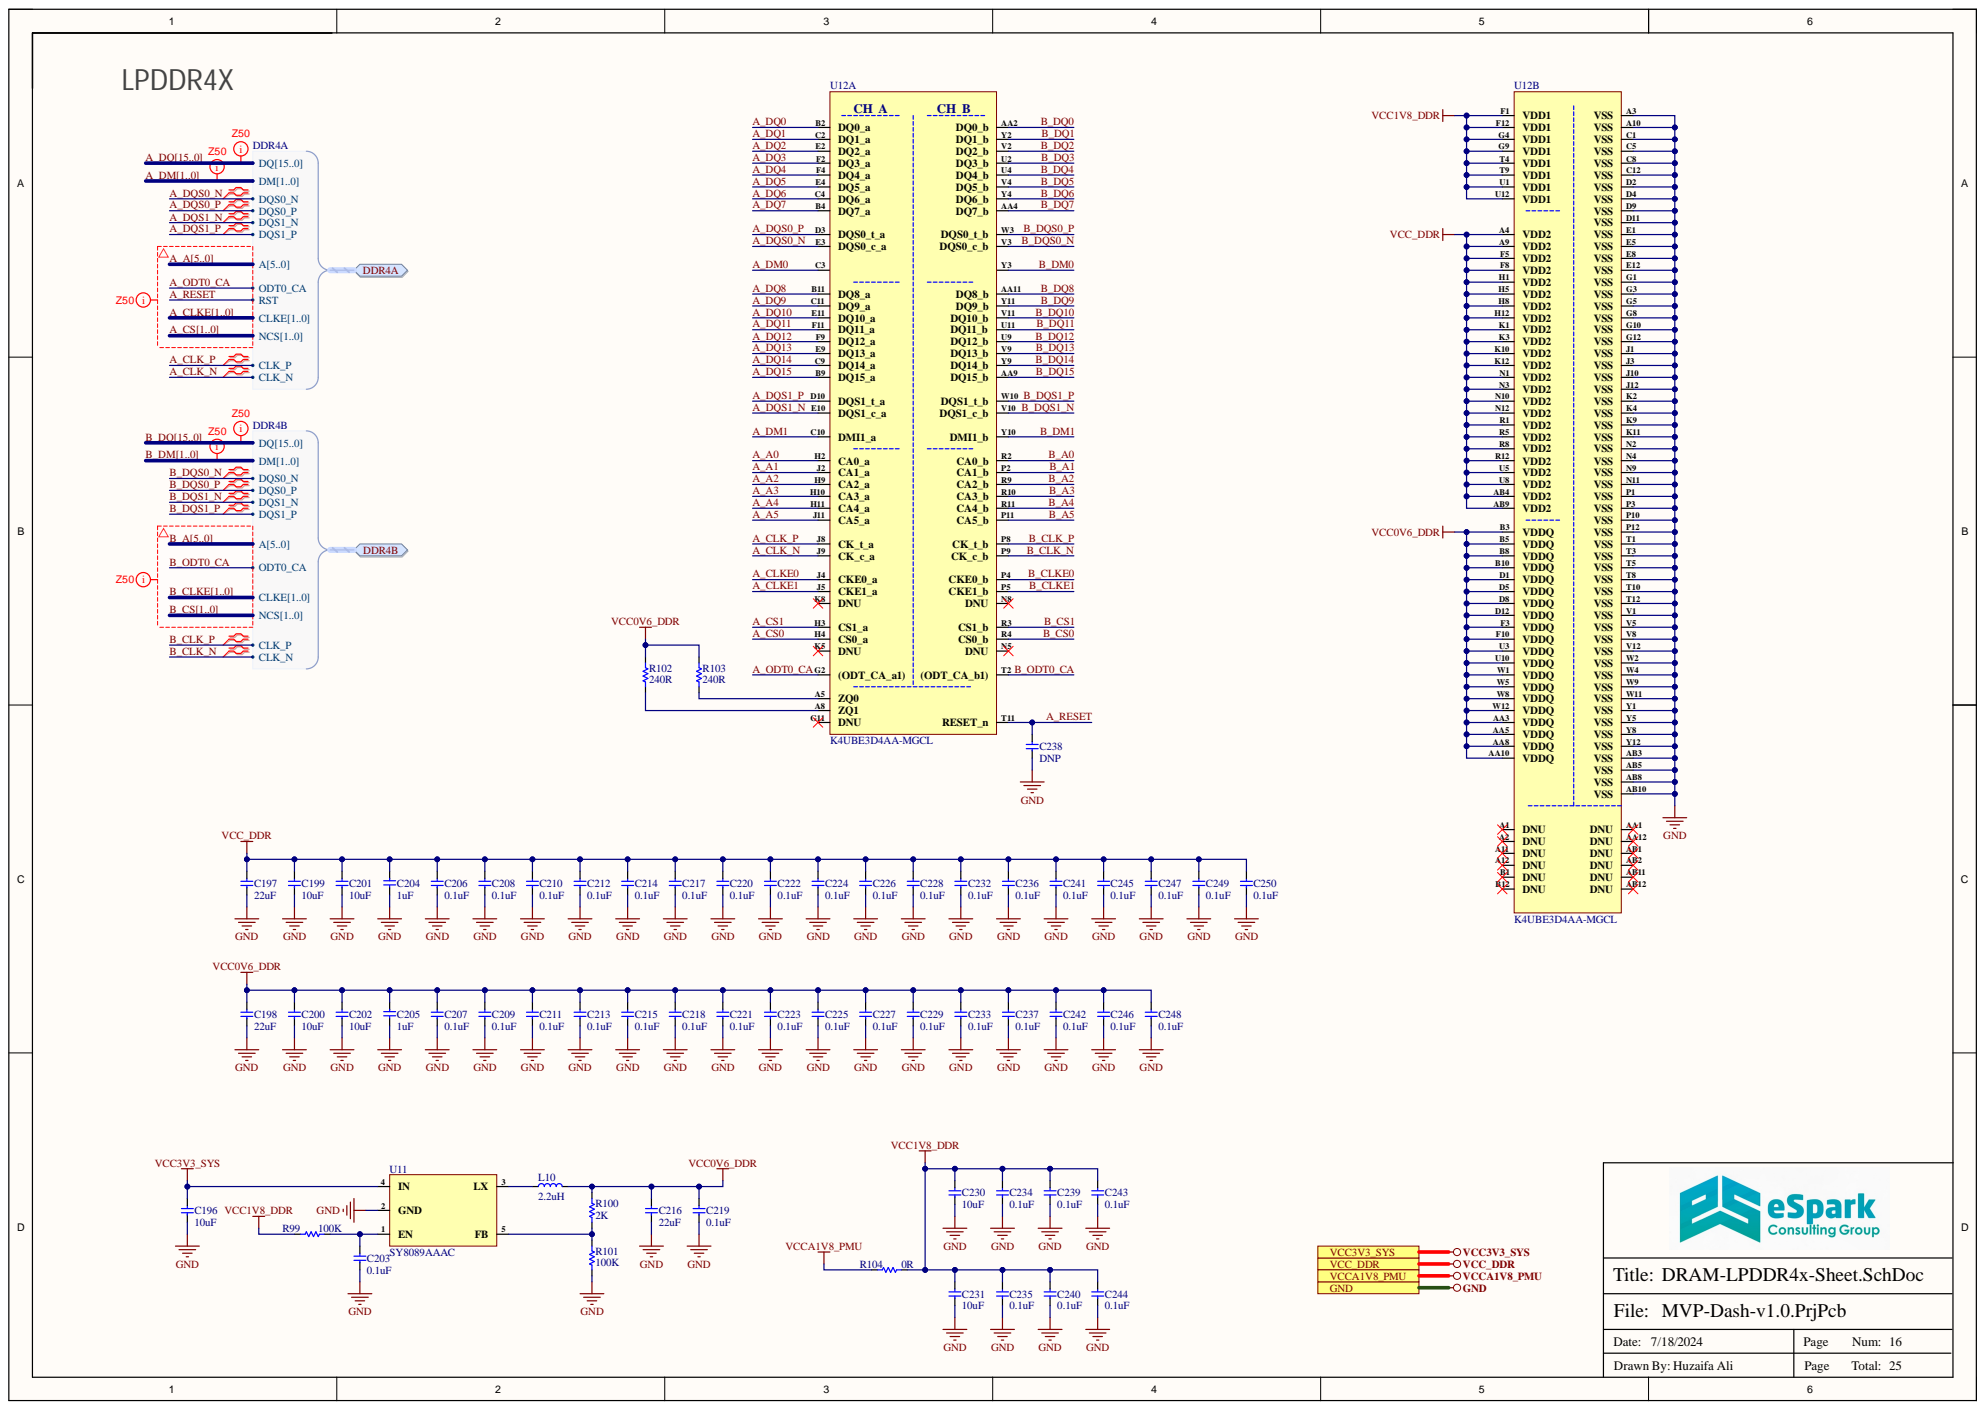
[picture p86: page 16]

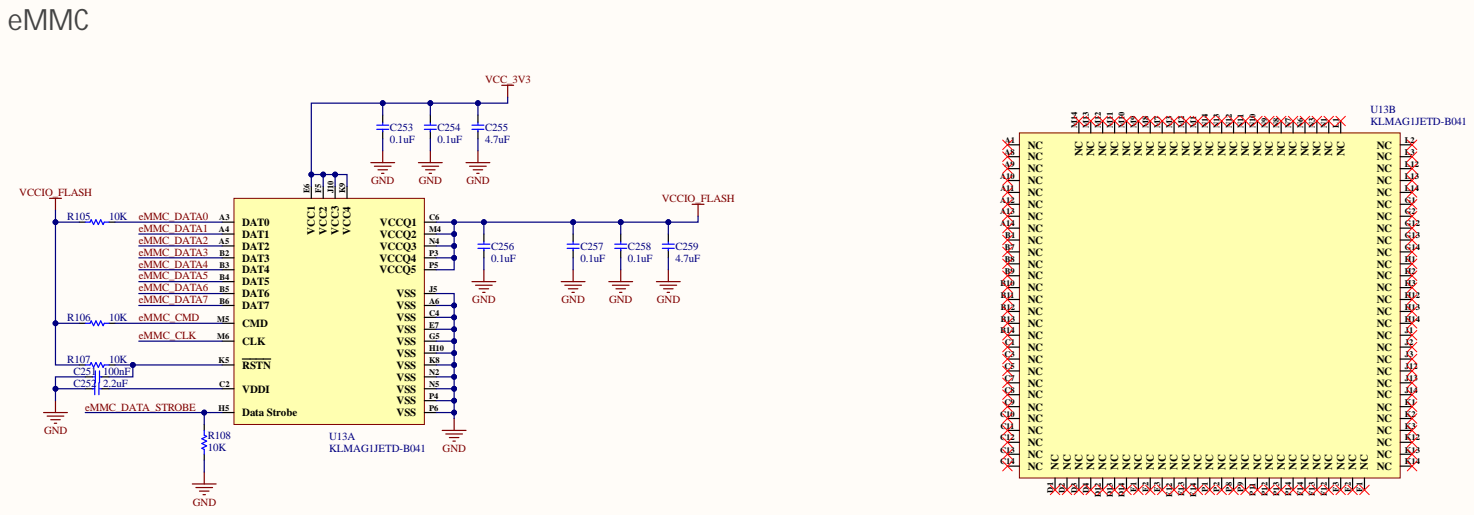
[picture p87: page 17]

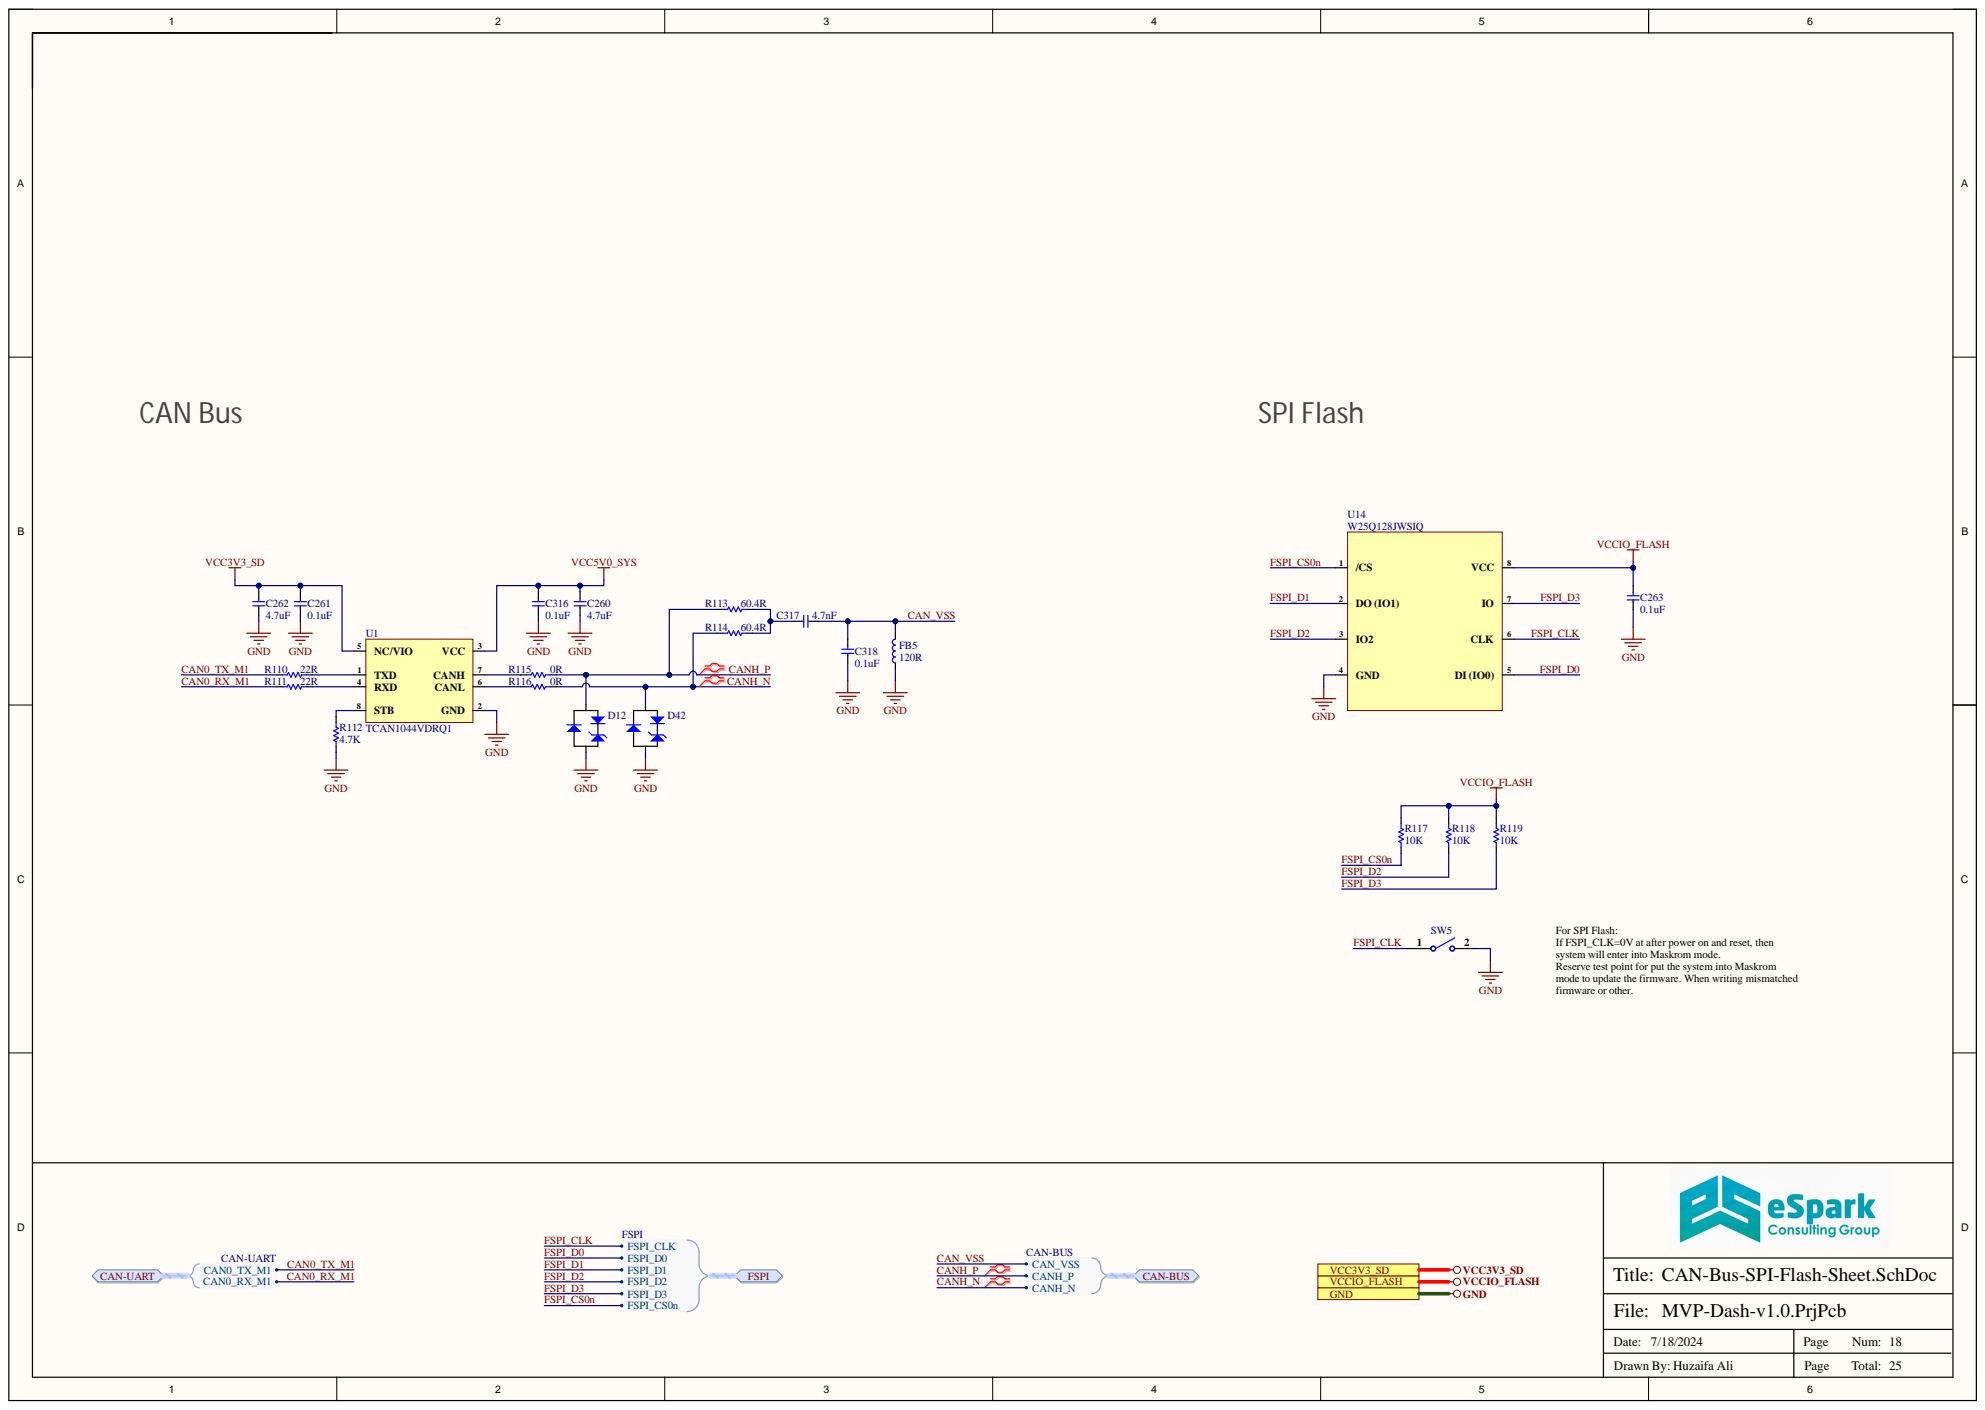
[picture p88: page 18]

C | VCCIO_FLASH | C

For SPI Flash:
If FSPI_CLK=0V at after power on and reset, then
system will enter into Maskrom mode.
Reserve test point for put the system into Maskrom
mode to update the firmware. When writing mismatched
firmware or other.

CAN-Bus-SPI-Flash-Sheet.SchDoc

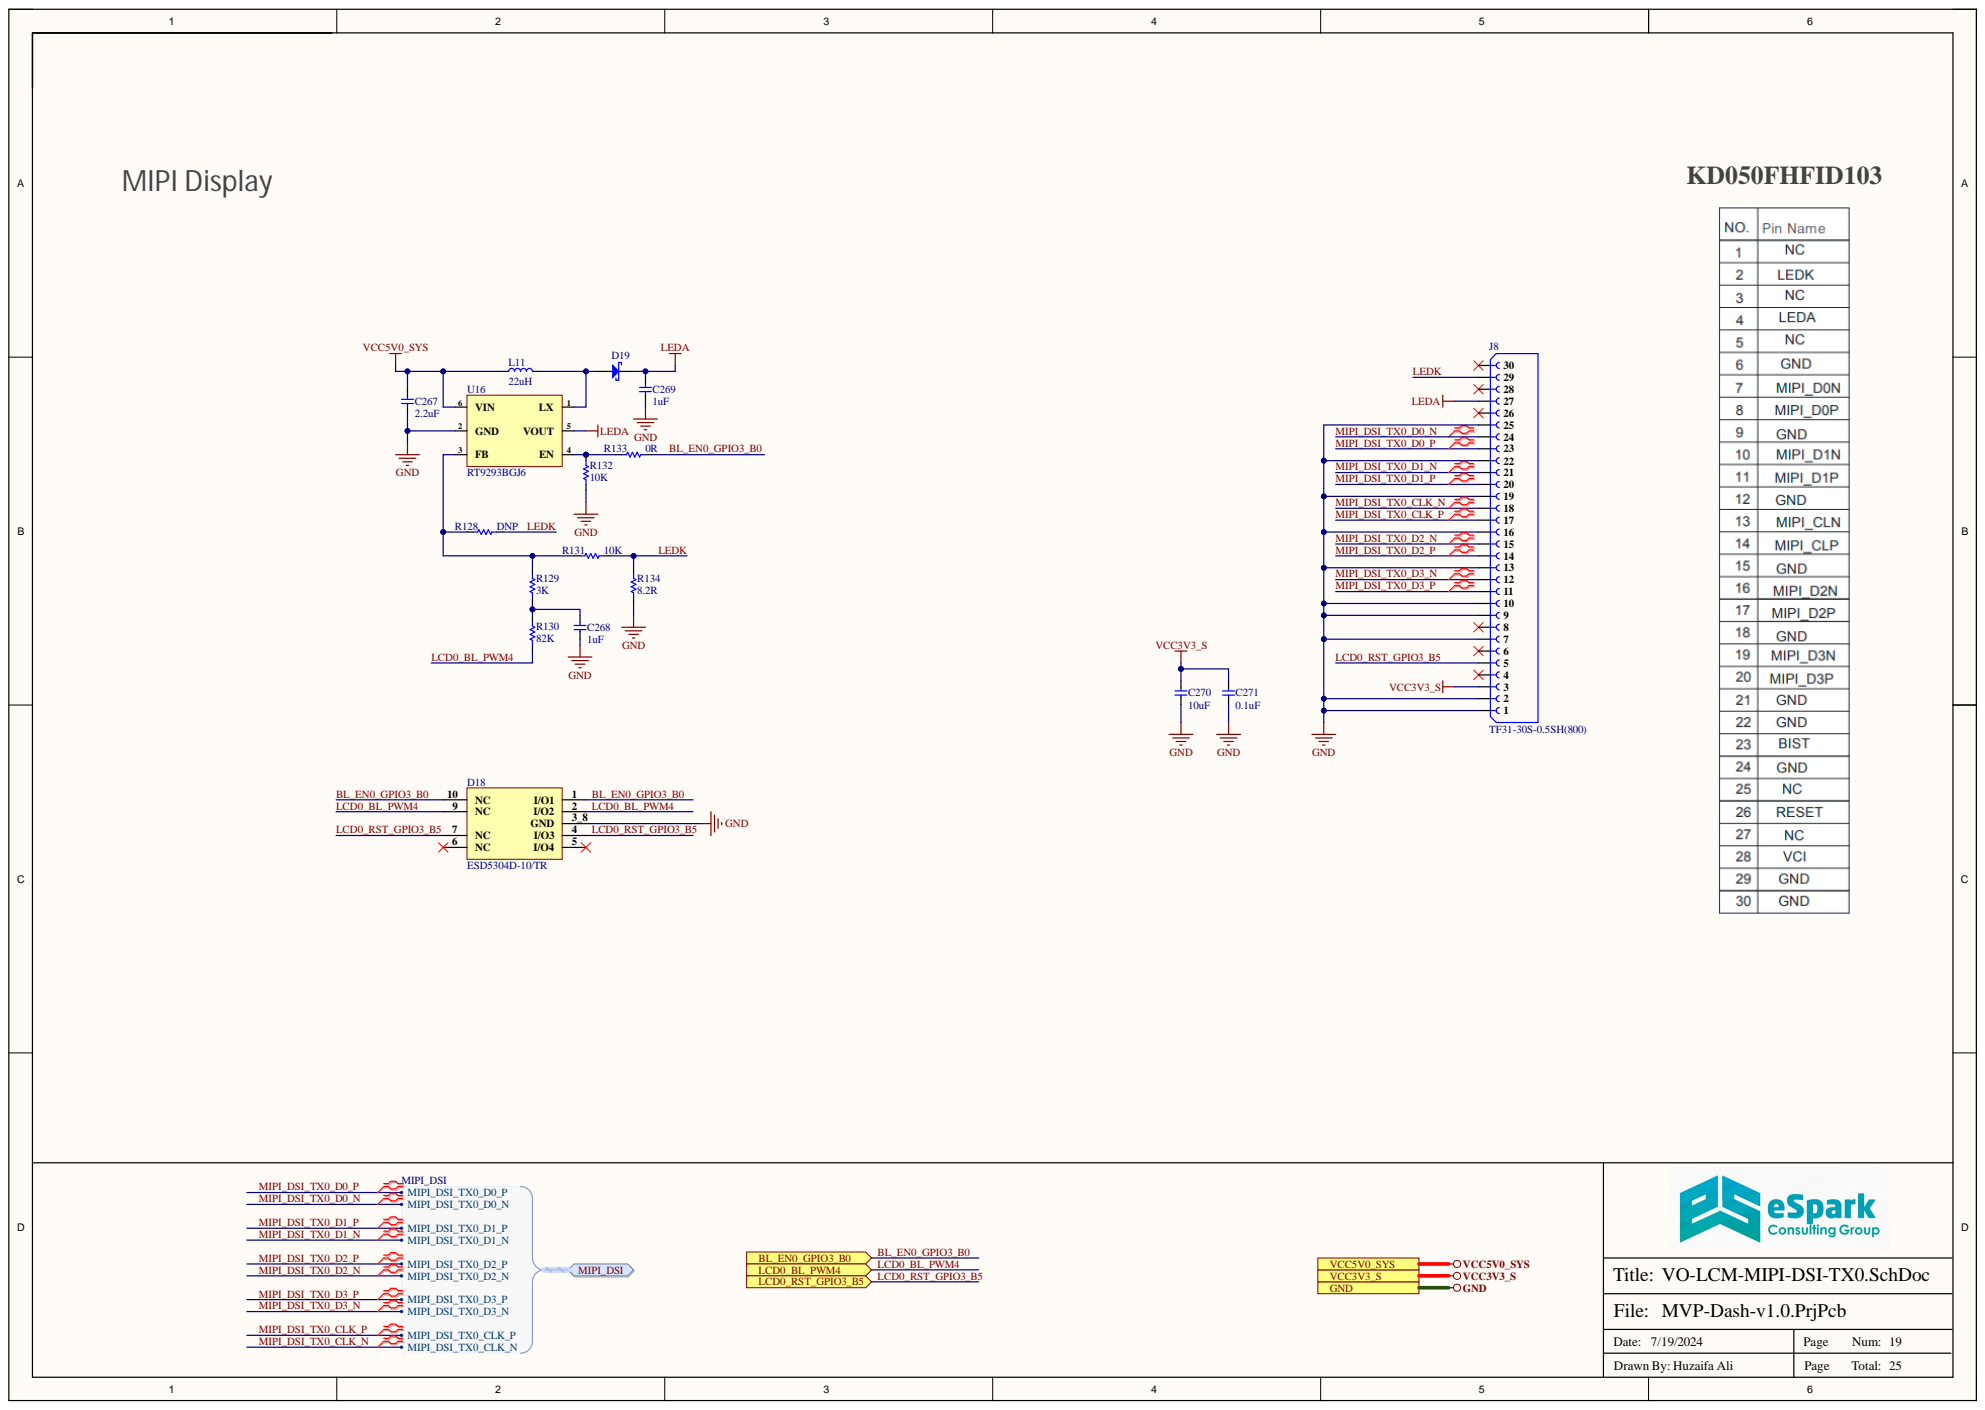
[picture p89: page 19]

VO-LCM-MIPI-DSI-TX0.SchDoc

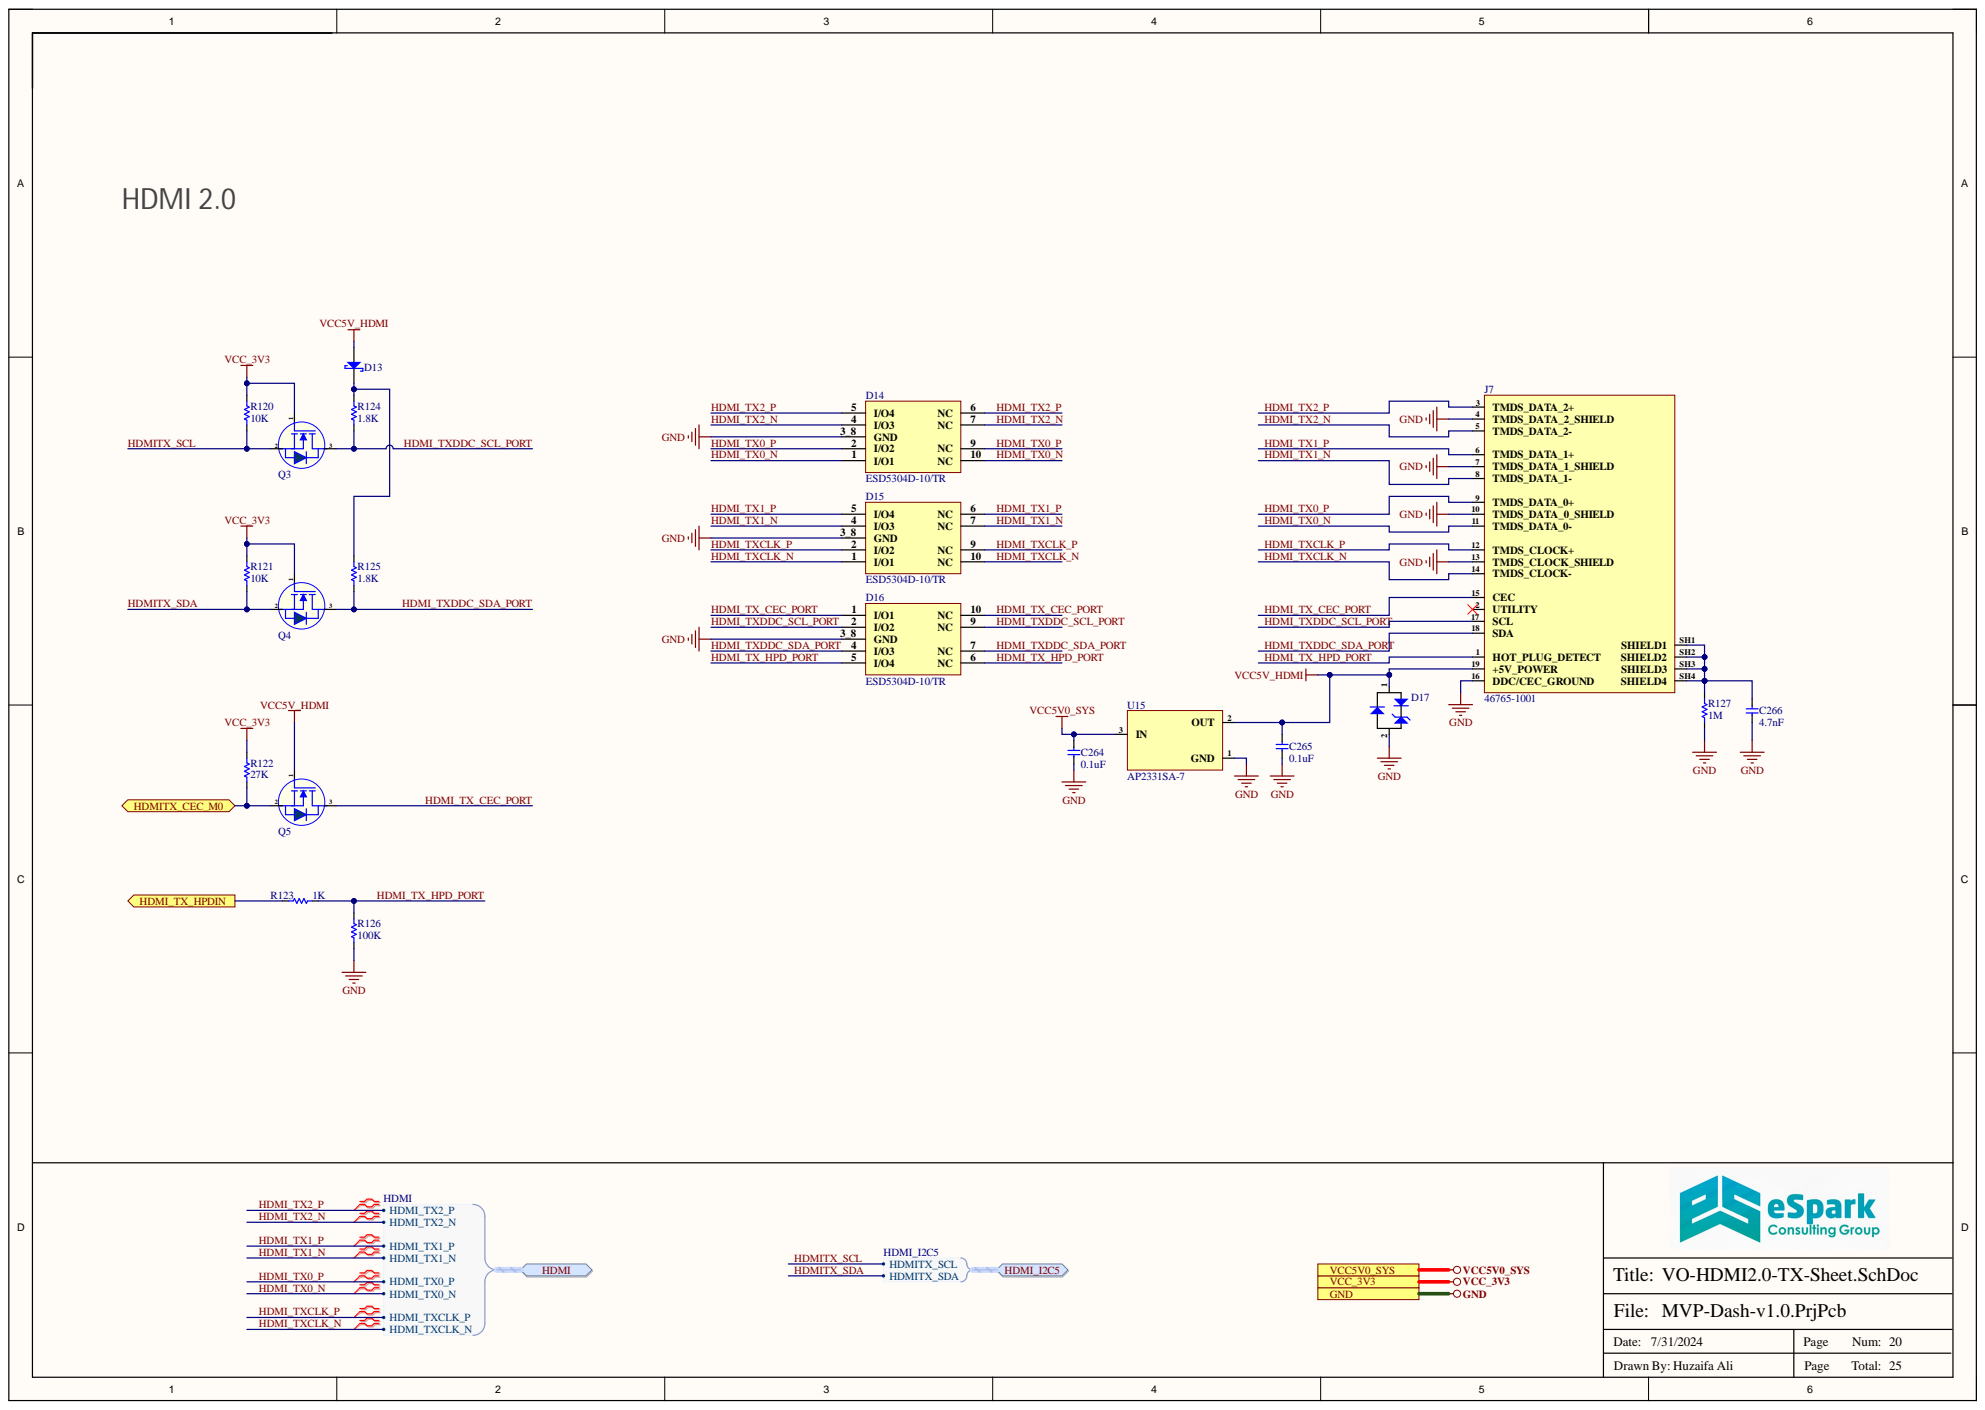
[picture p90: page 20]

VO-HDMI2.0-TX-Sheet.SchDoc

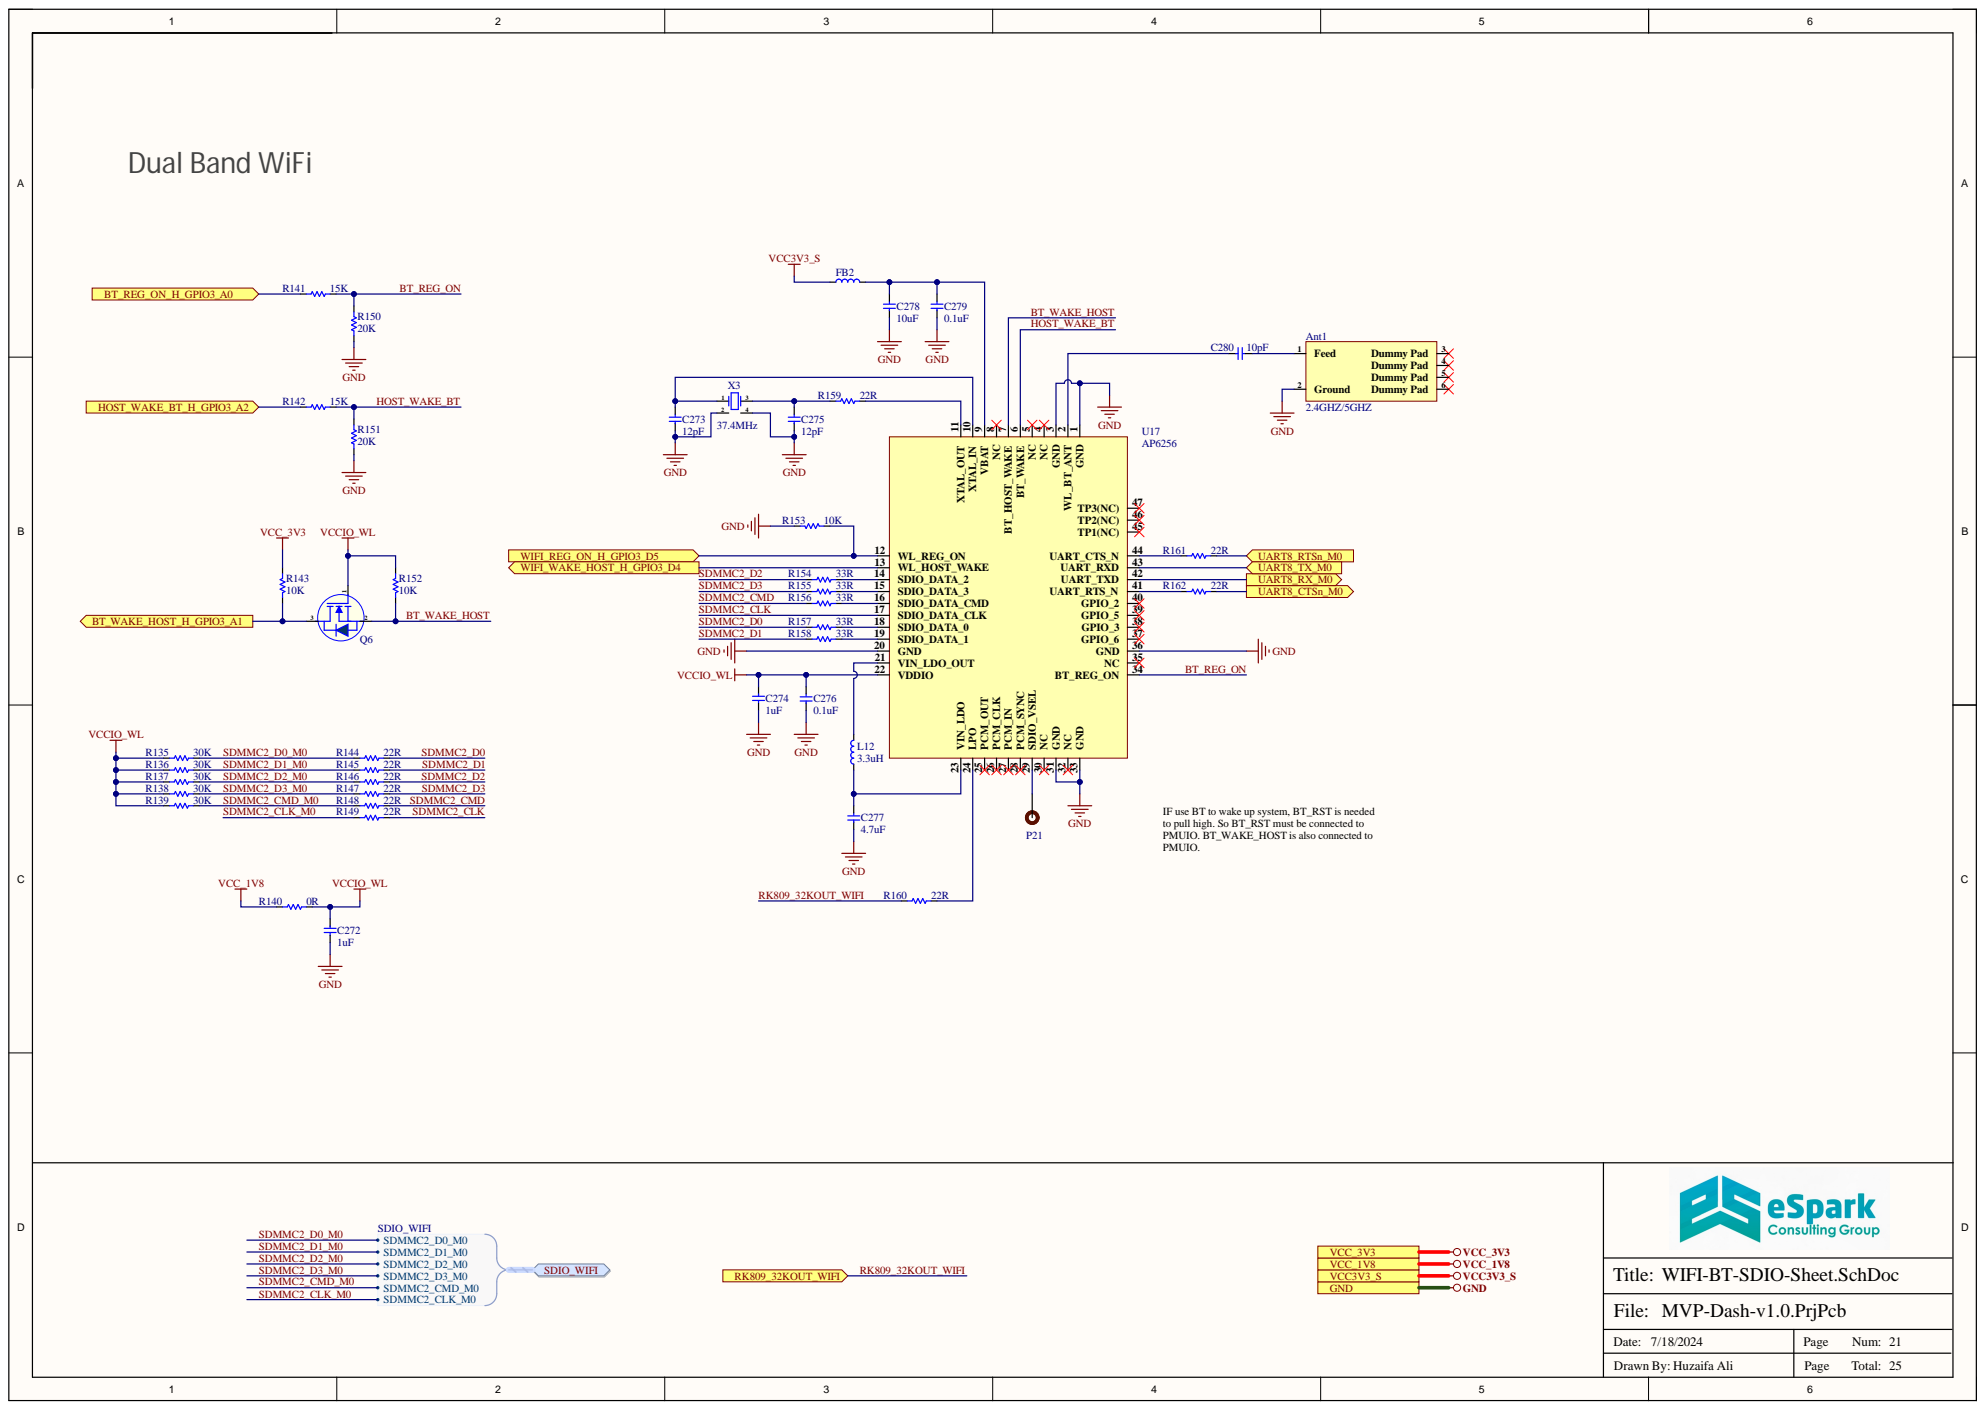
[picture p91: page 21]

GND 1 WL_BT_ANT 2 GND 3 NC 4 NC 5 BT_WAKE 6 BT_HOST_WAKE 7 NC 8 VBAT 9 XTAL_IN 10 XTAL_OUT 11

IF use BT to wake up system, BT_RST is needed
to pull high. So BT_RST must be connected to
PMUIO. BT_WAKE_HOST is also connected to
PMUIO.

WIFI-BT-SDIO-Sheet.SchDoc

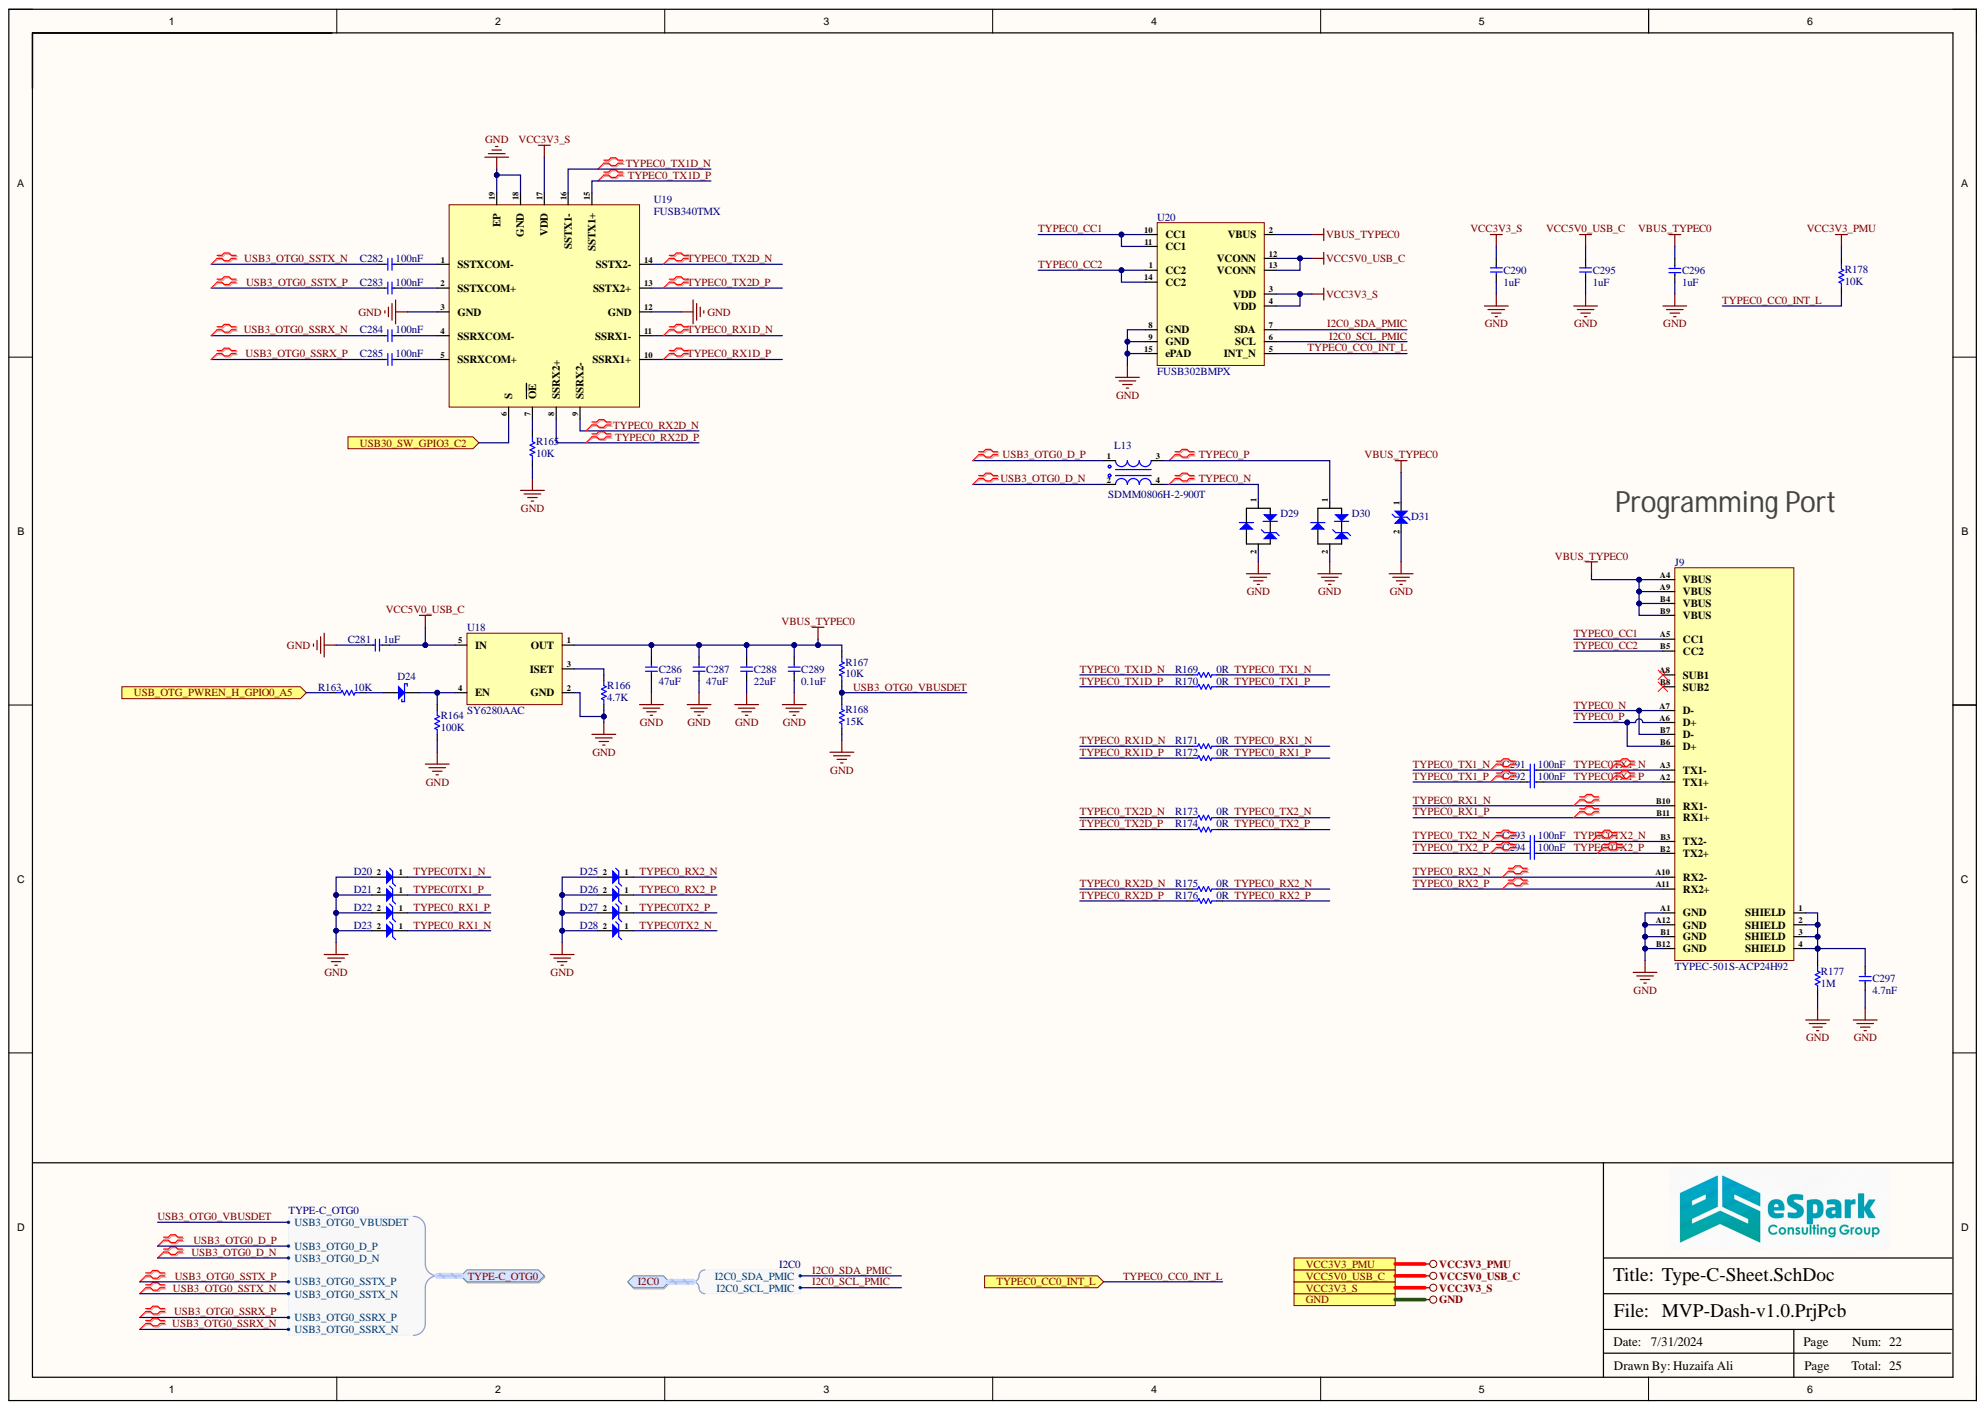
[picture p92: page 22]

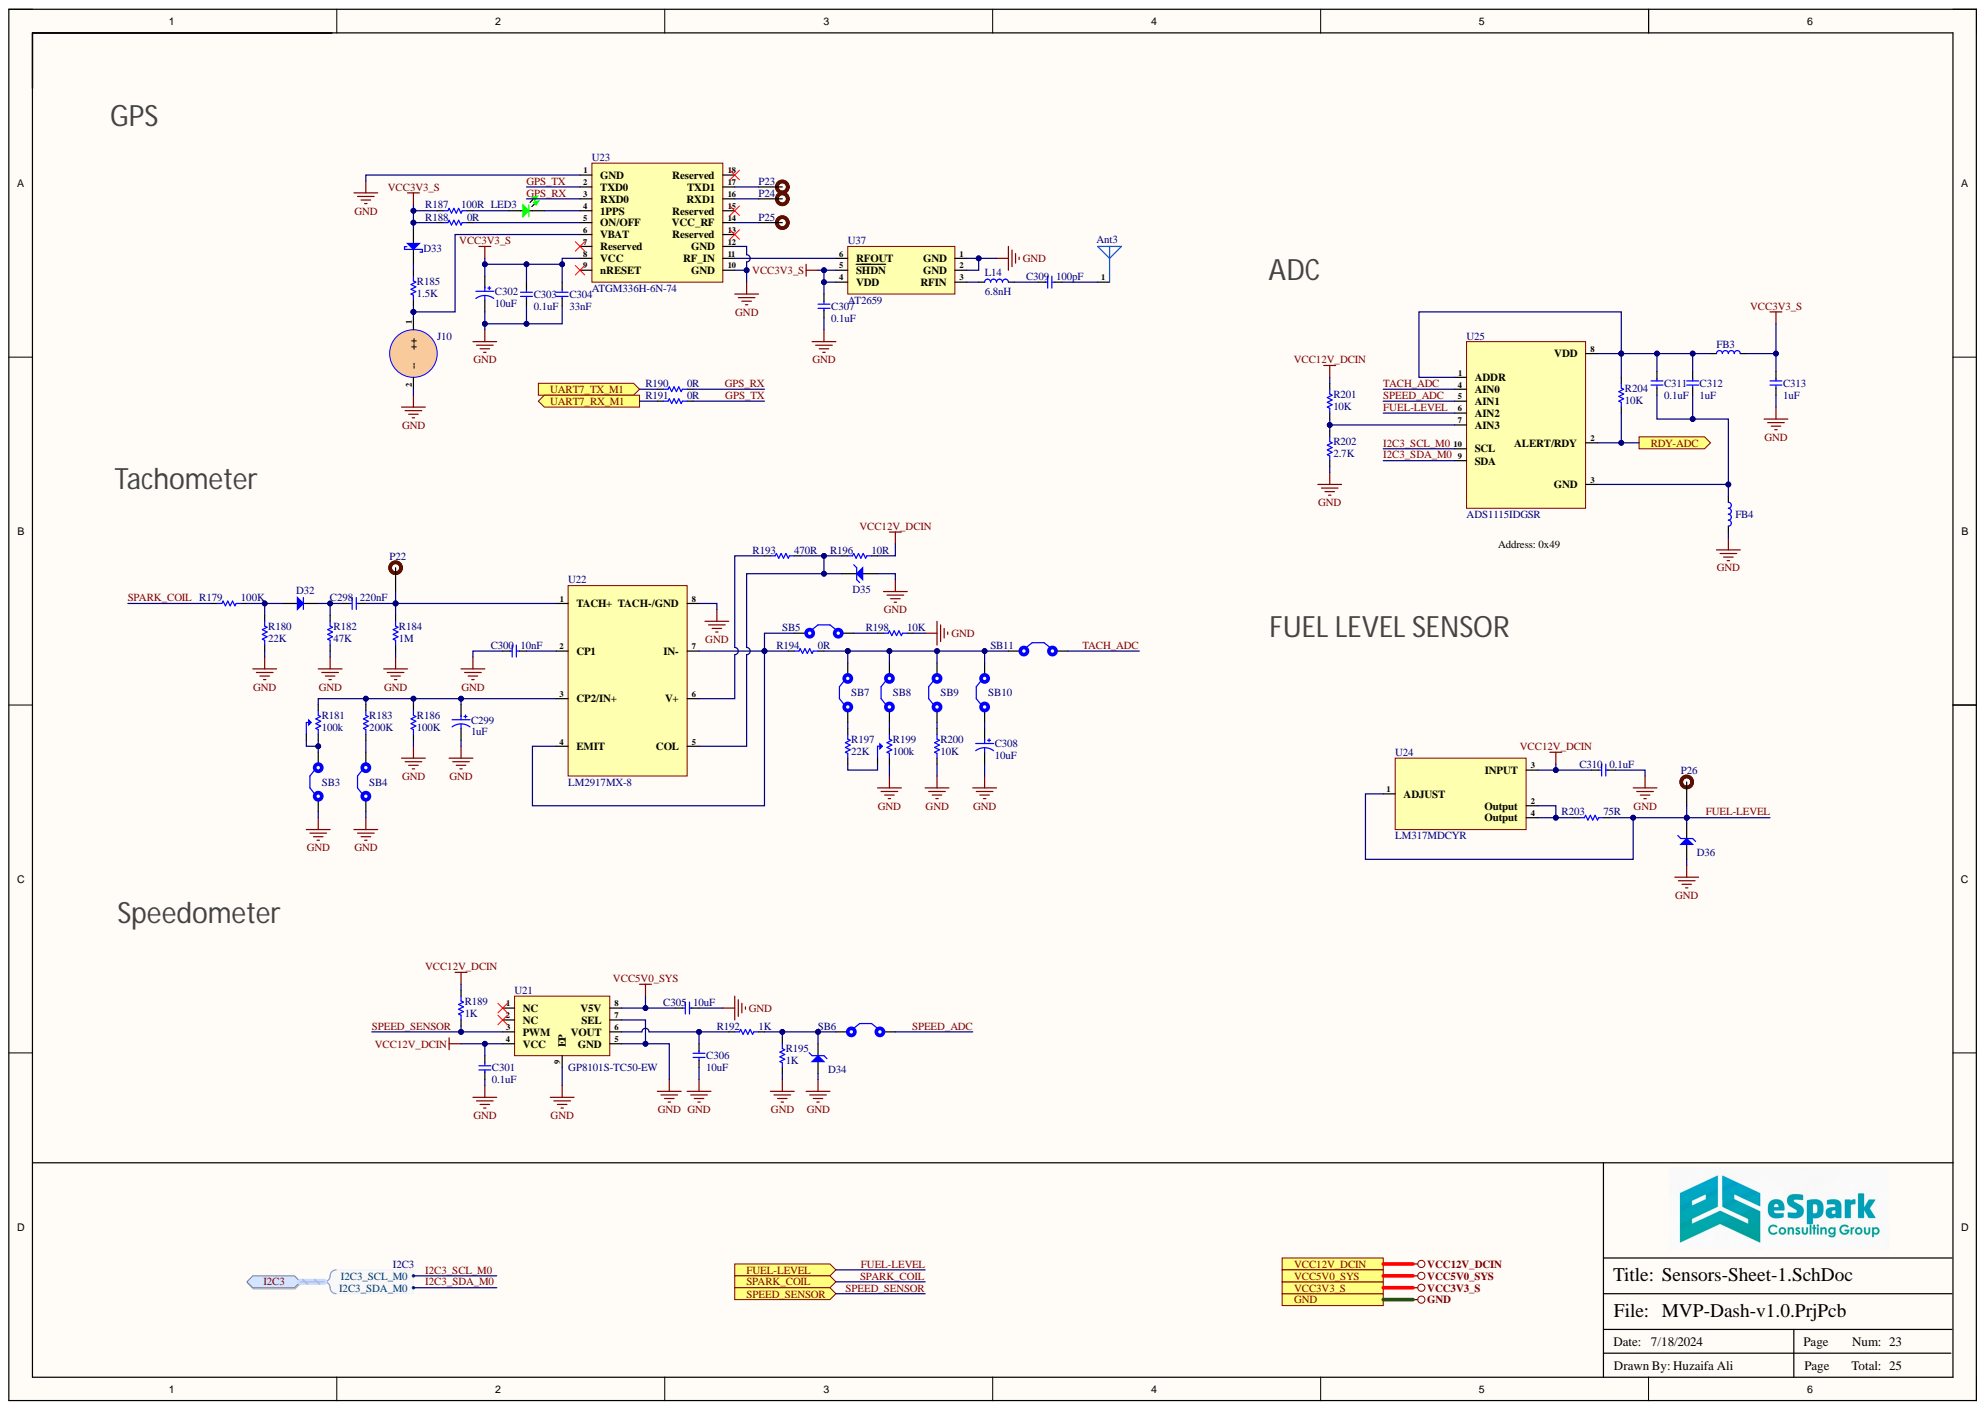
[picture p93: page 23]

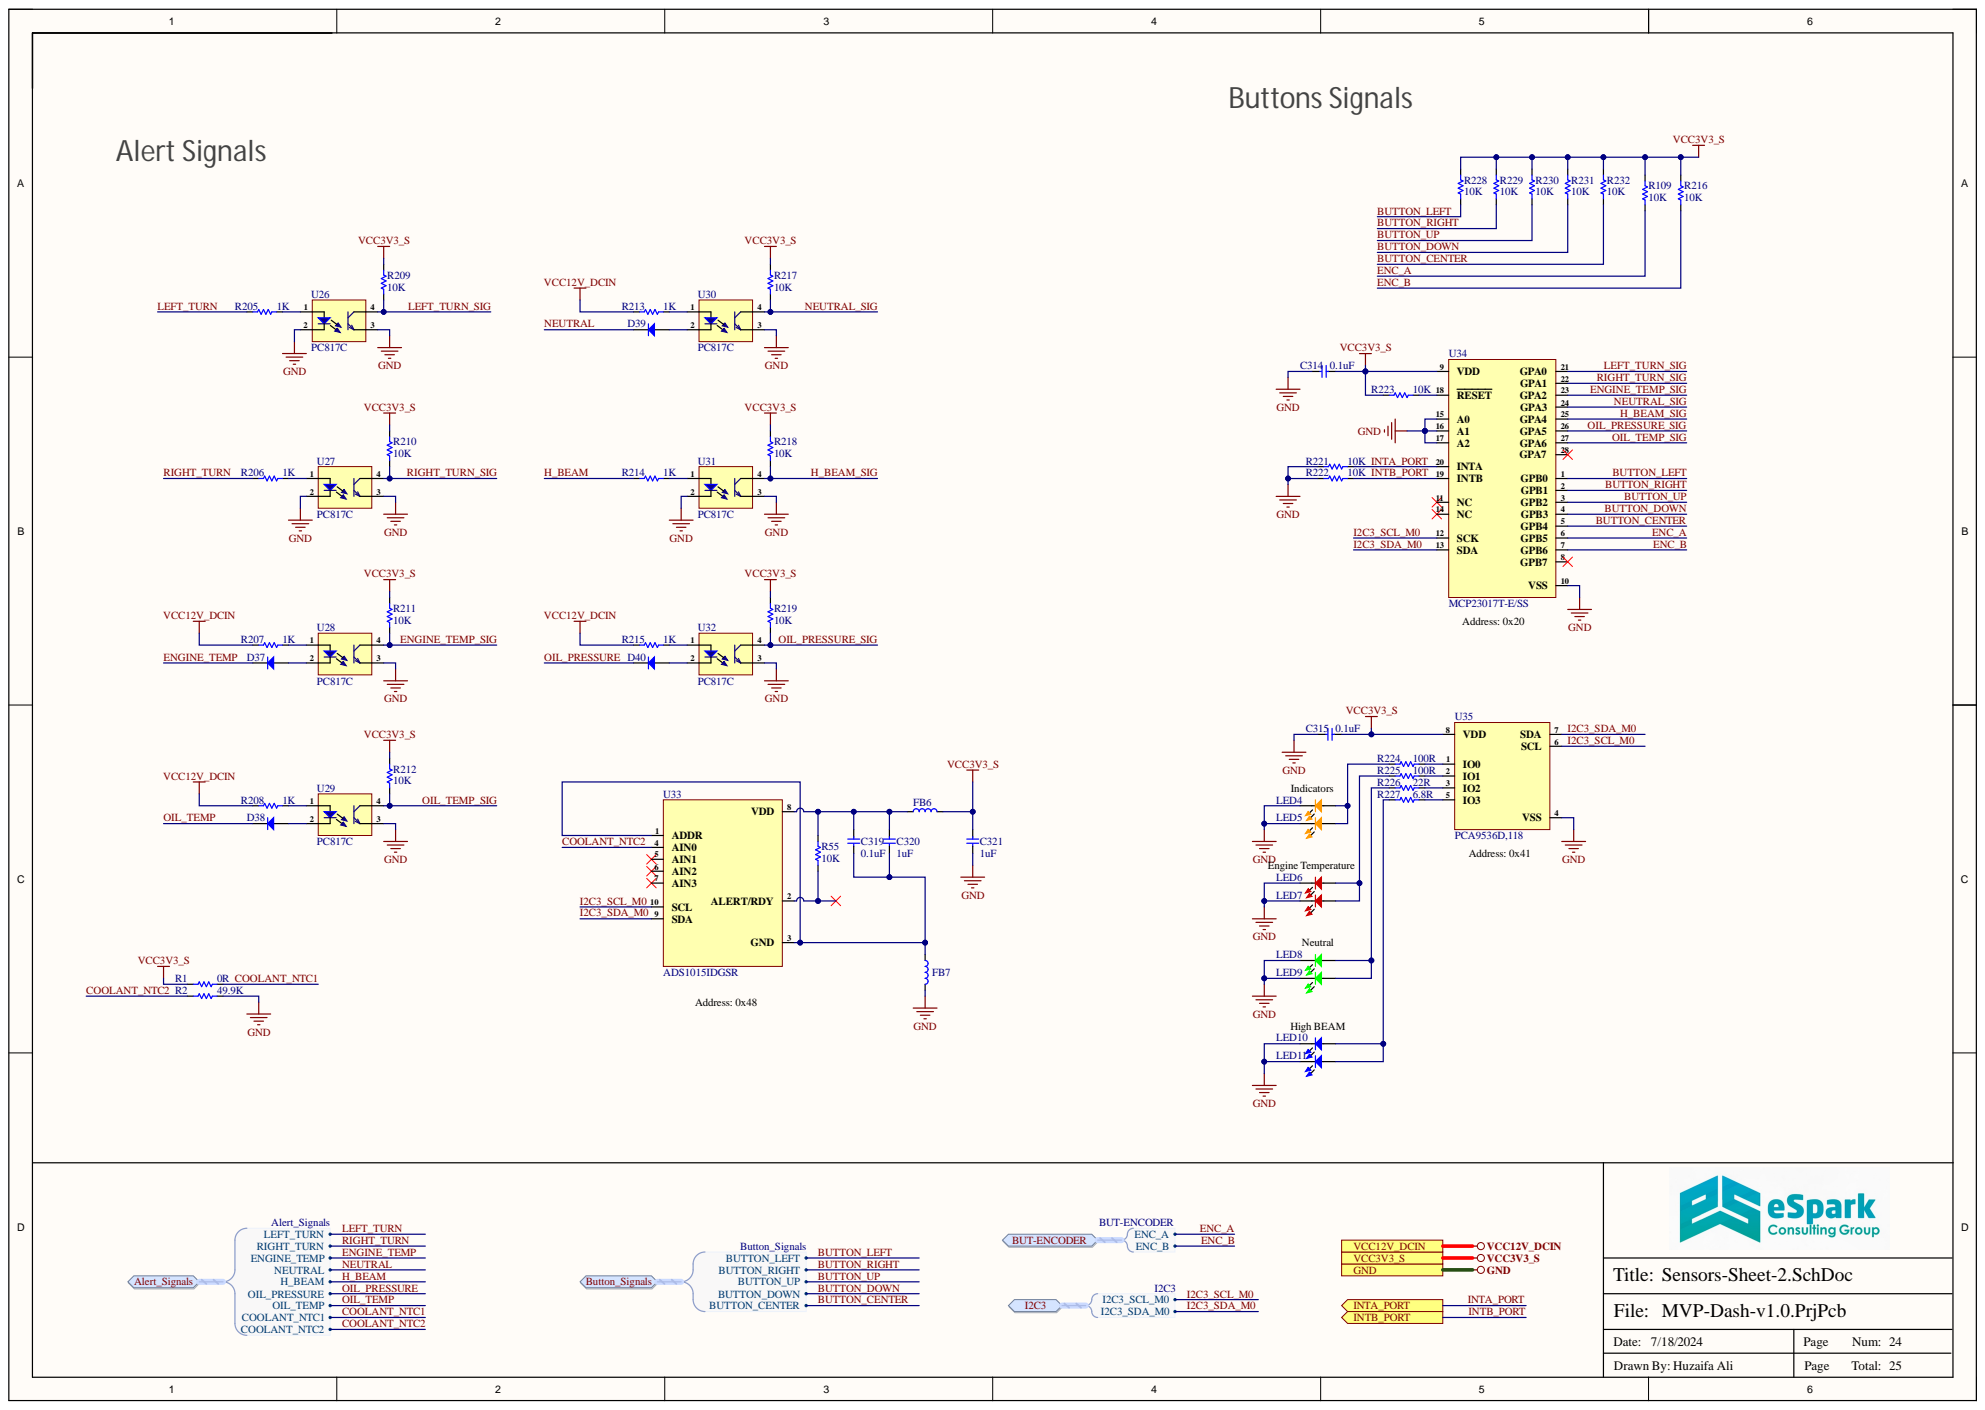
[picture p94: page 24]

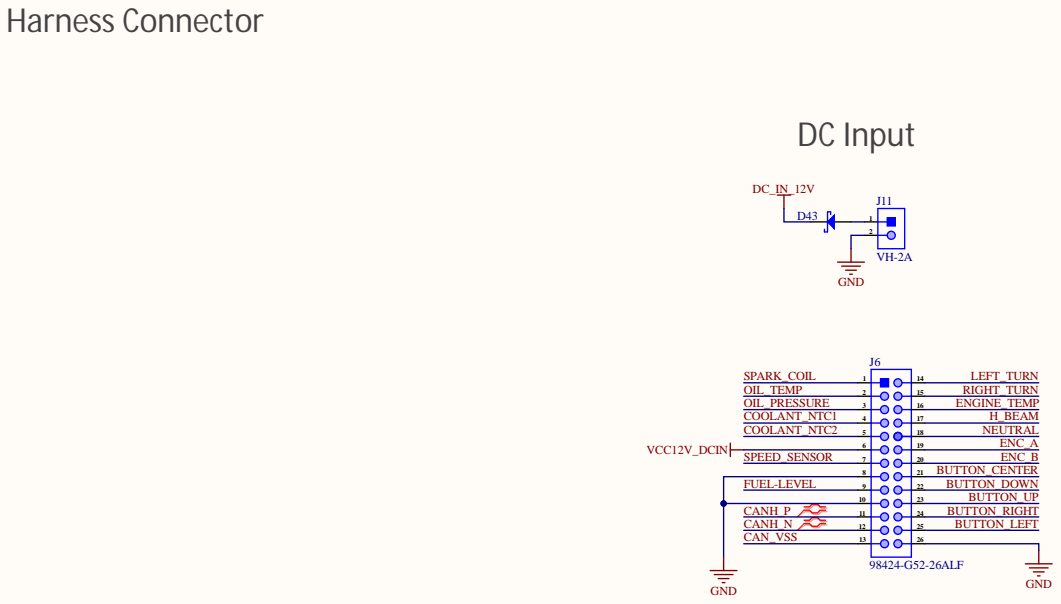
[picture p95: page 25]

C | GND | C
