eSpark-Consulting-Group/alastair-barones-salpha/Design-Files/MVP-Dash-v1.0/PDF/MVP-Dash-v1.0.pdf

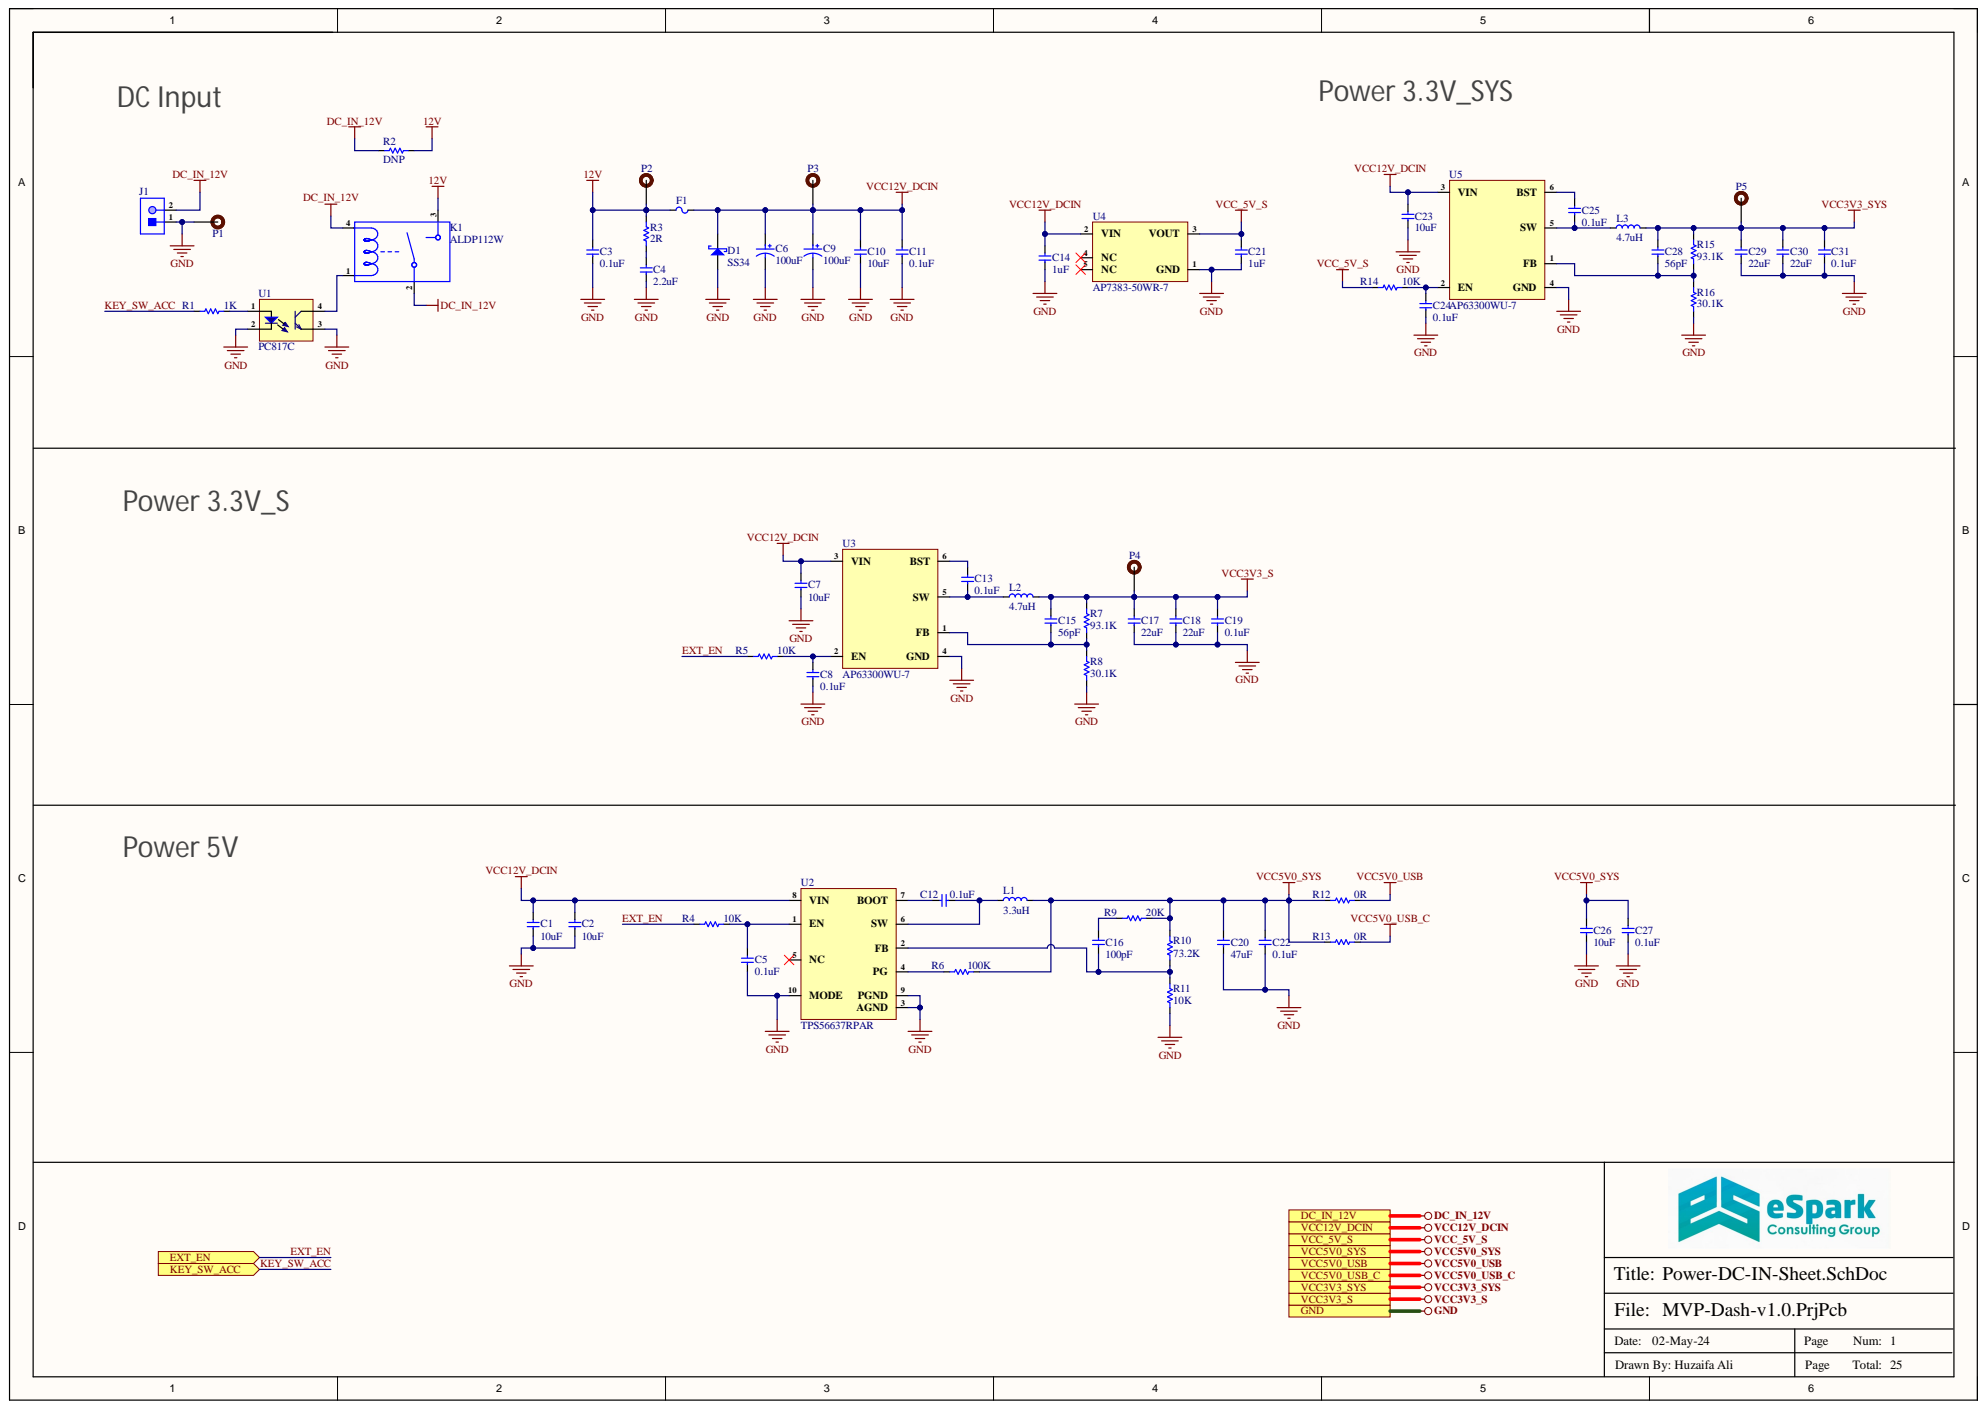
[picture p96: page 1]

Power-DC-IN-Sheet.SchDoc

Date: 02-May-24 | Page Num: 1

Drawn By: Huzaifa Ali | Page Total:

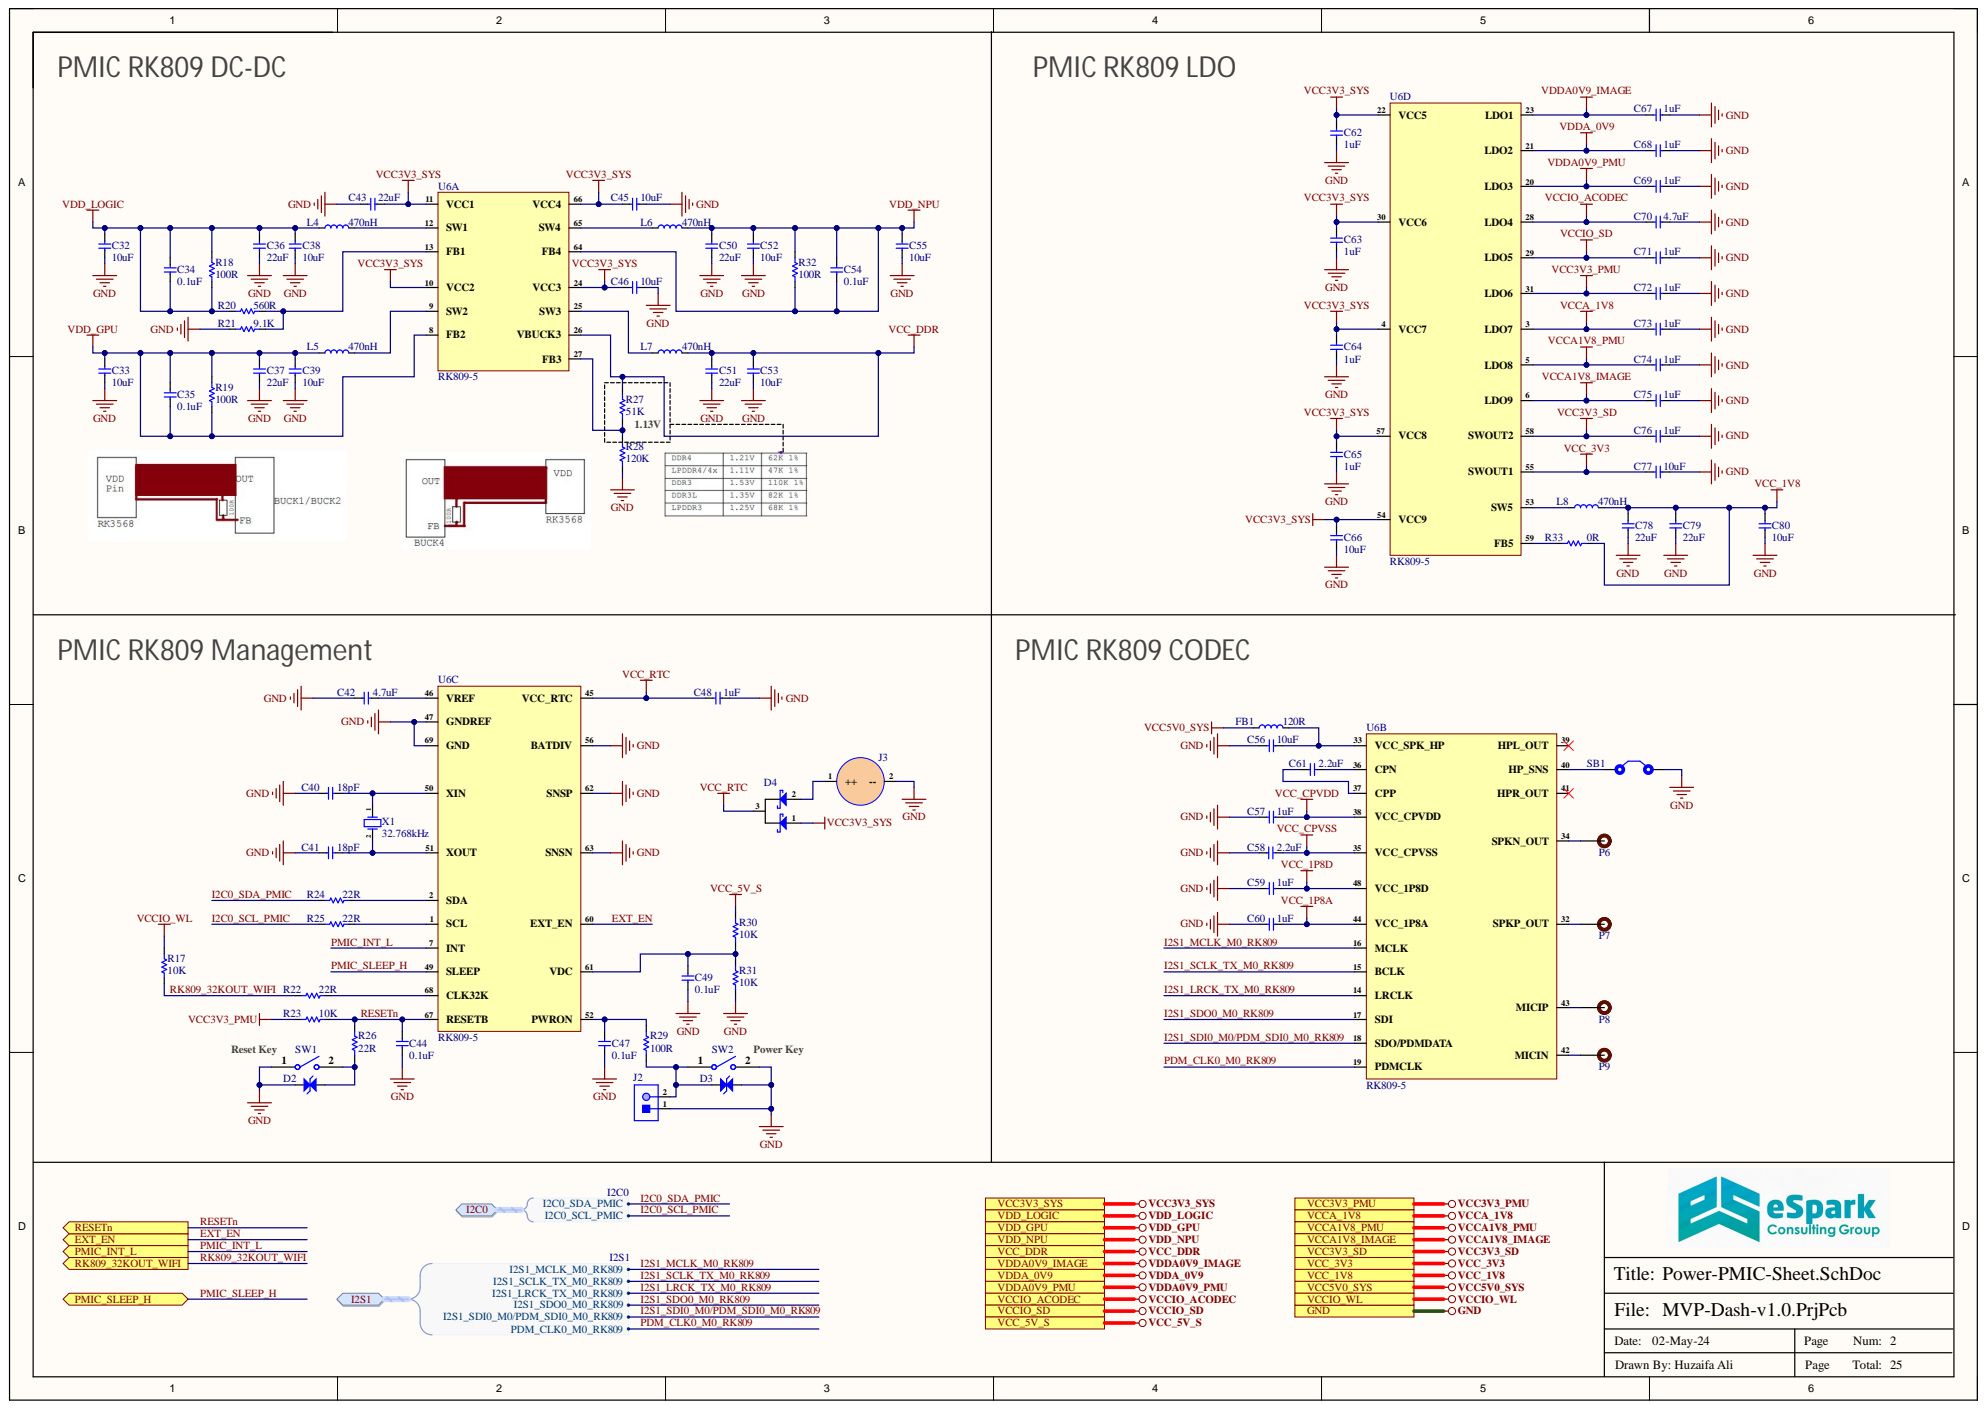
[picture p97: page 2]

Power-PMIC-Sheet.SchDoc

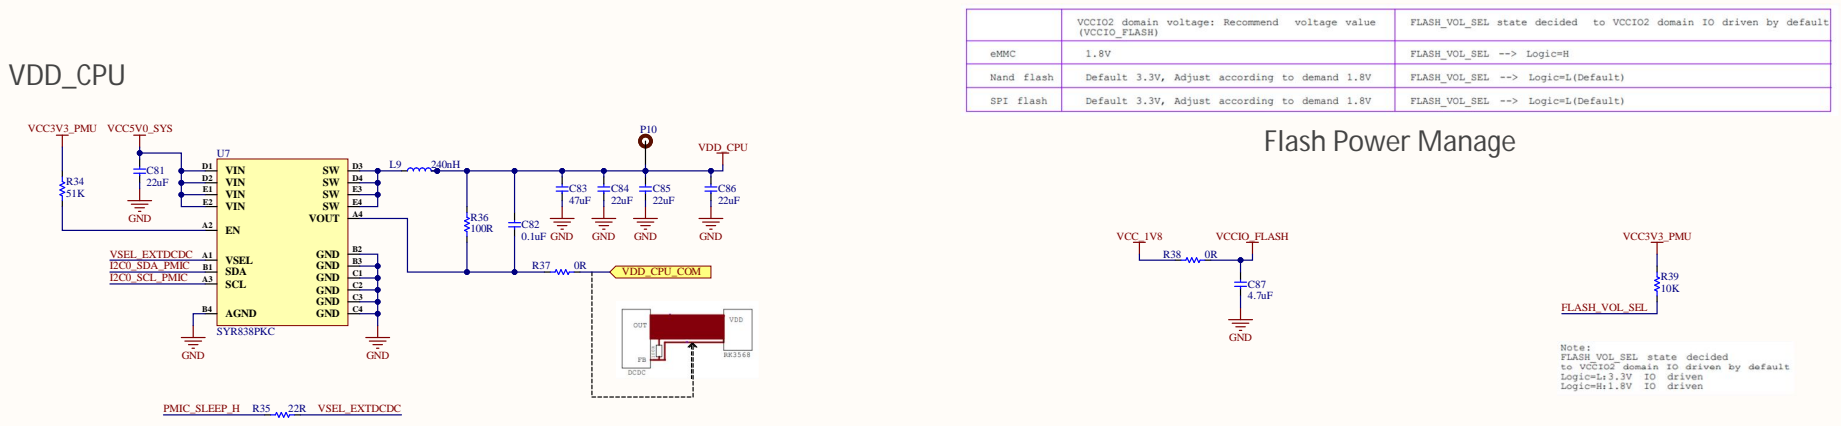
[picture p98: page 3]

Power-Others-Sheet.SchDoc

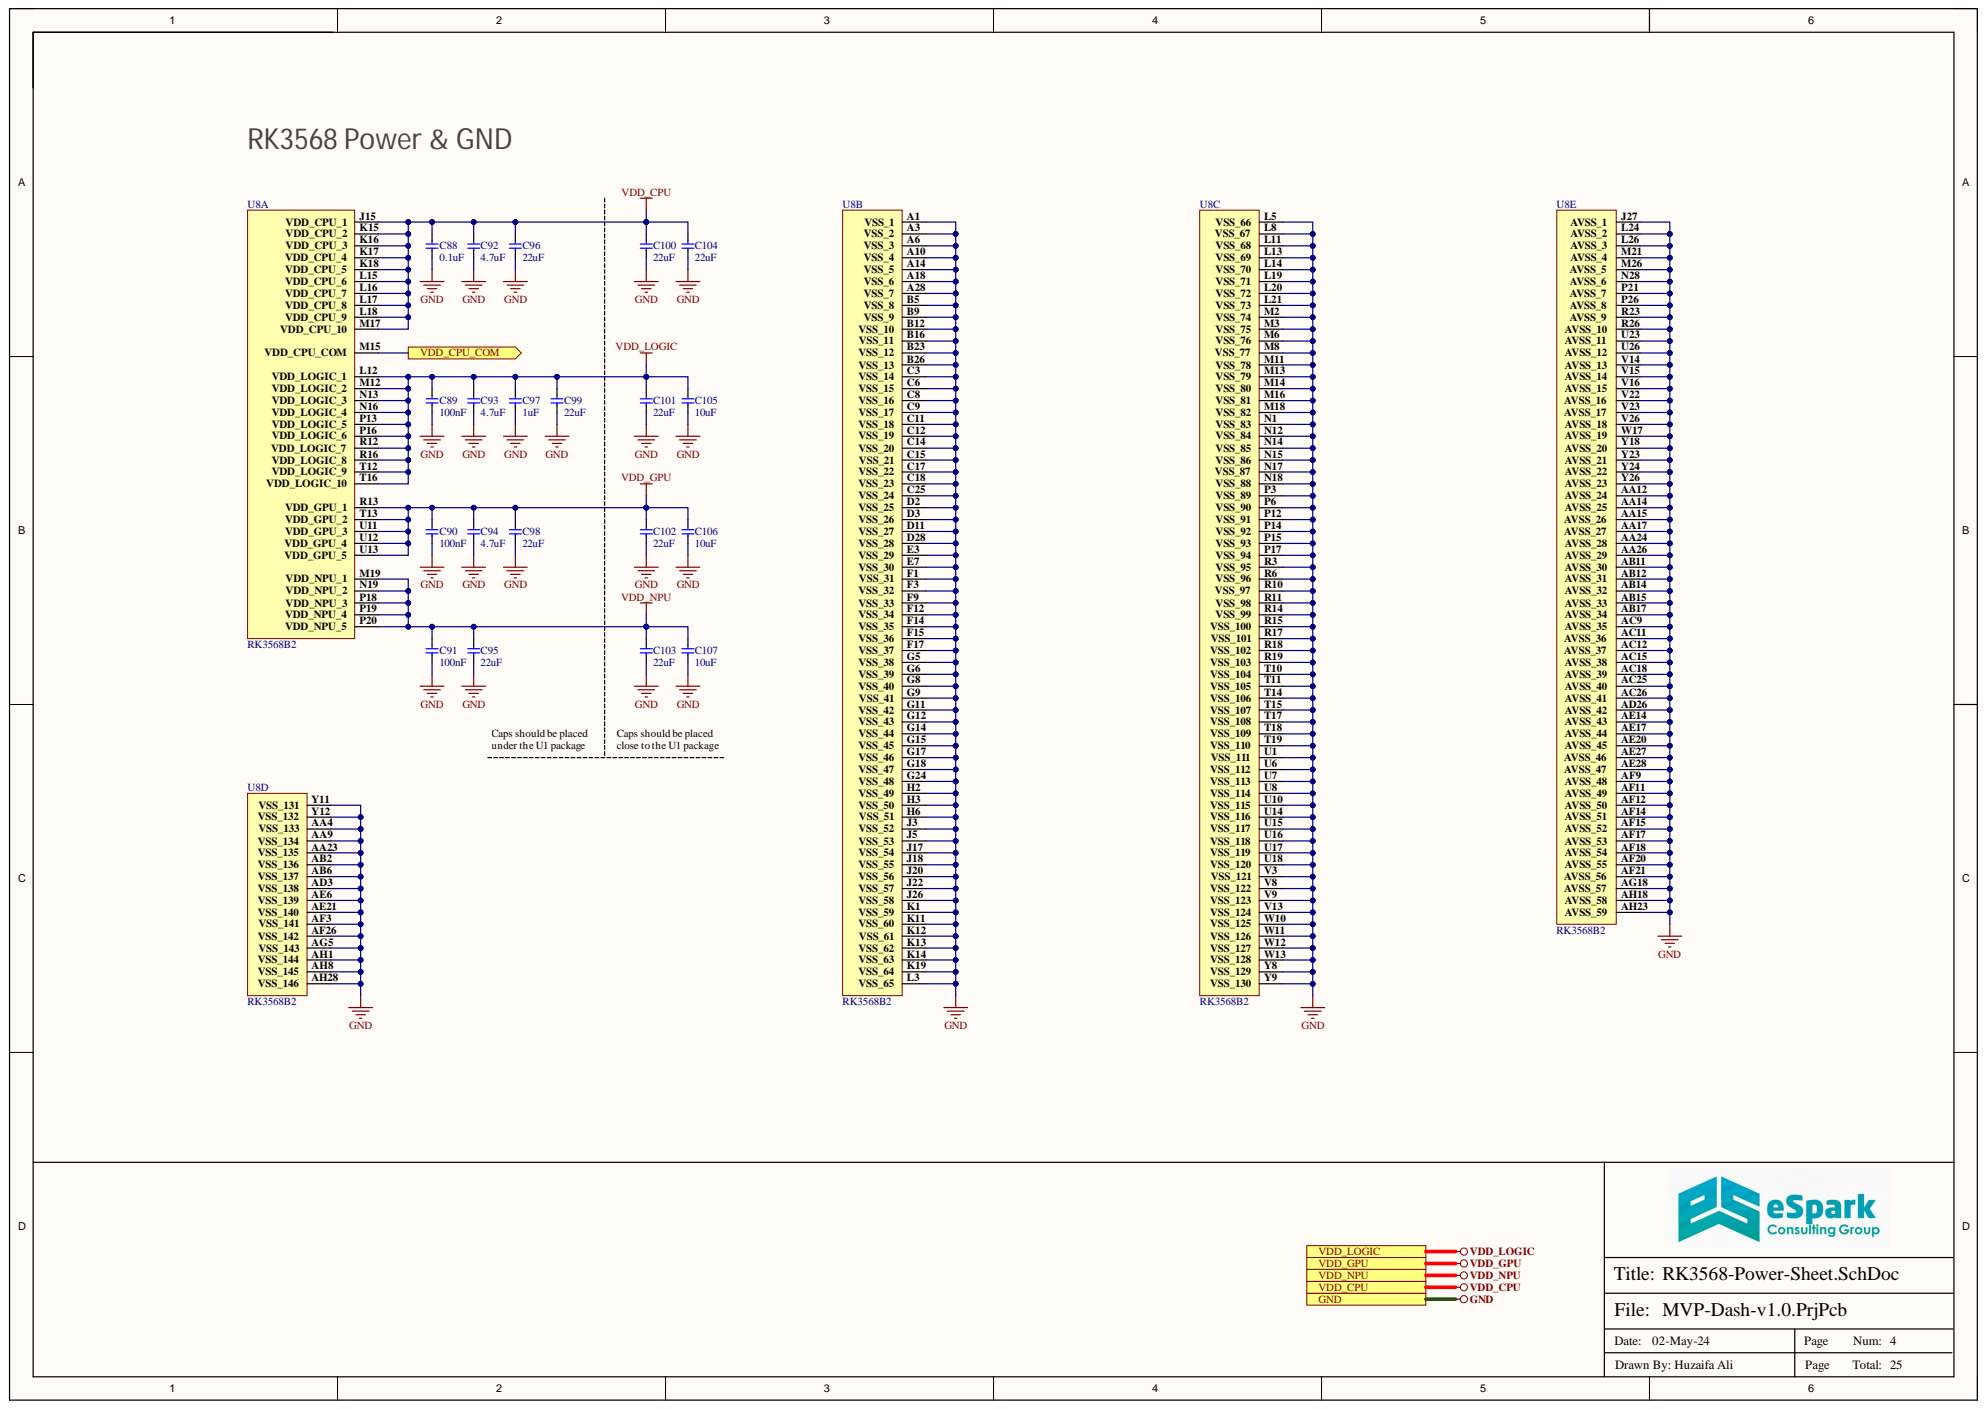
[picture p99: page 4]

Caps should be placed
under the U1 package

close to the U1 package

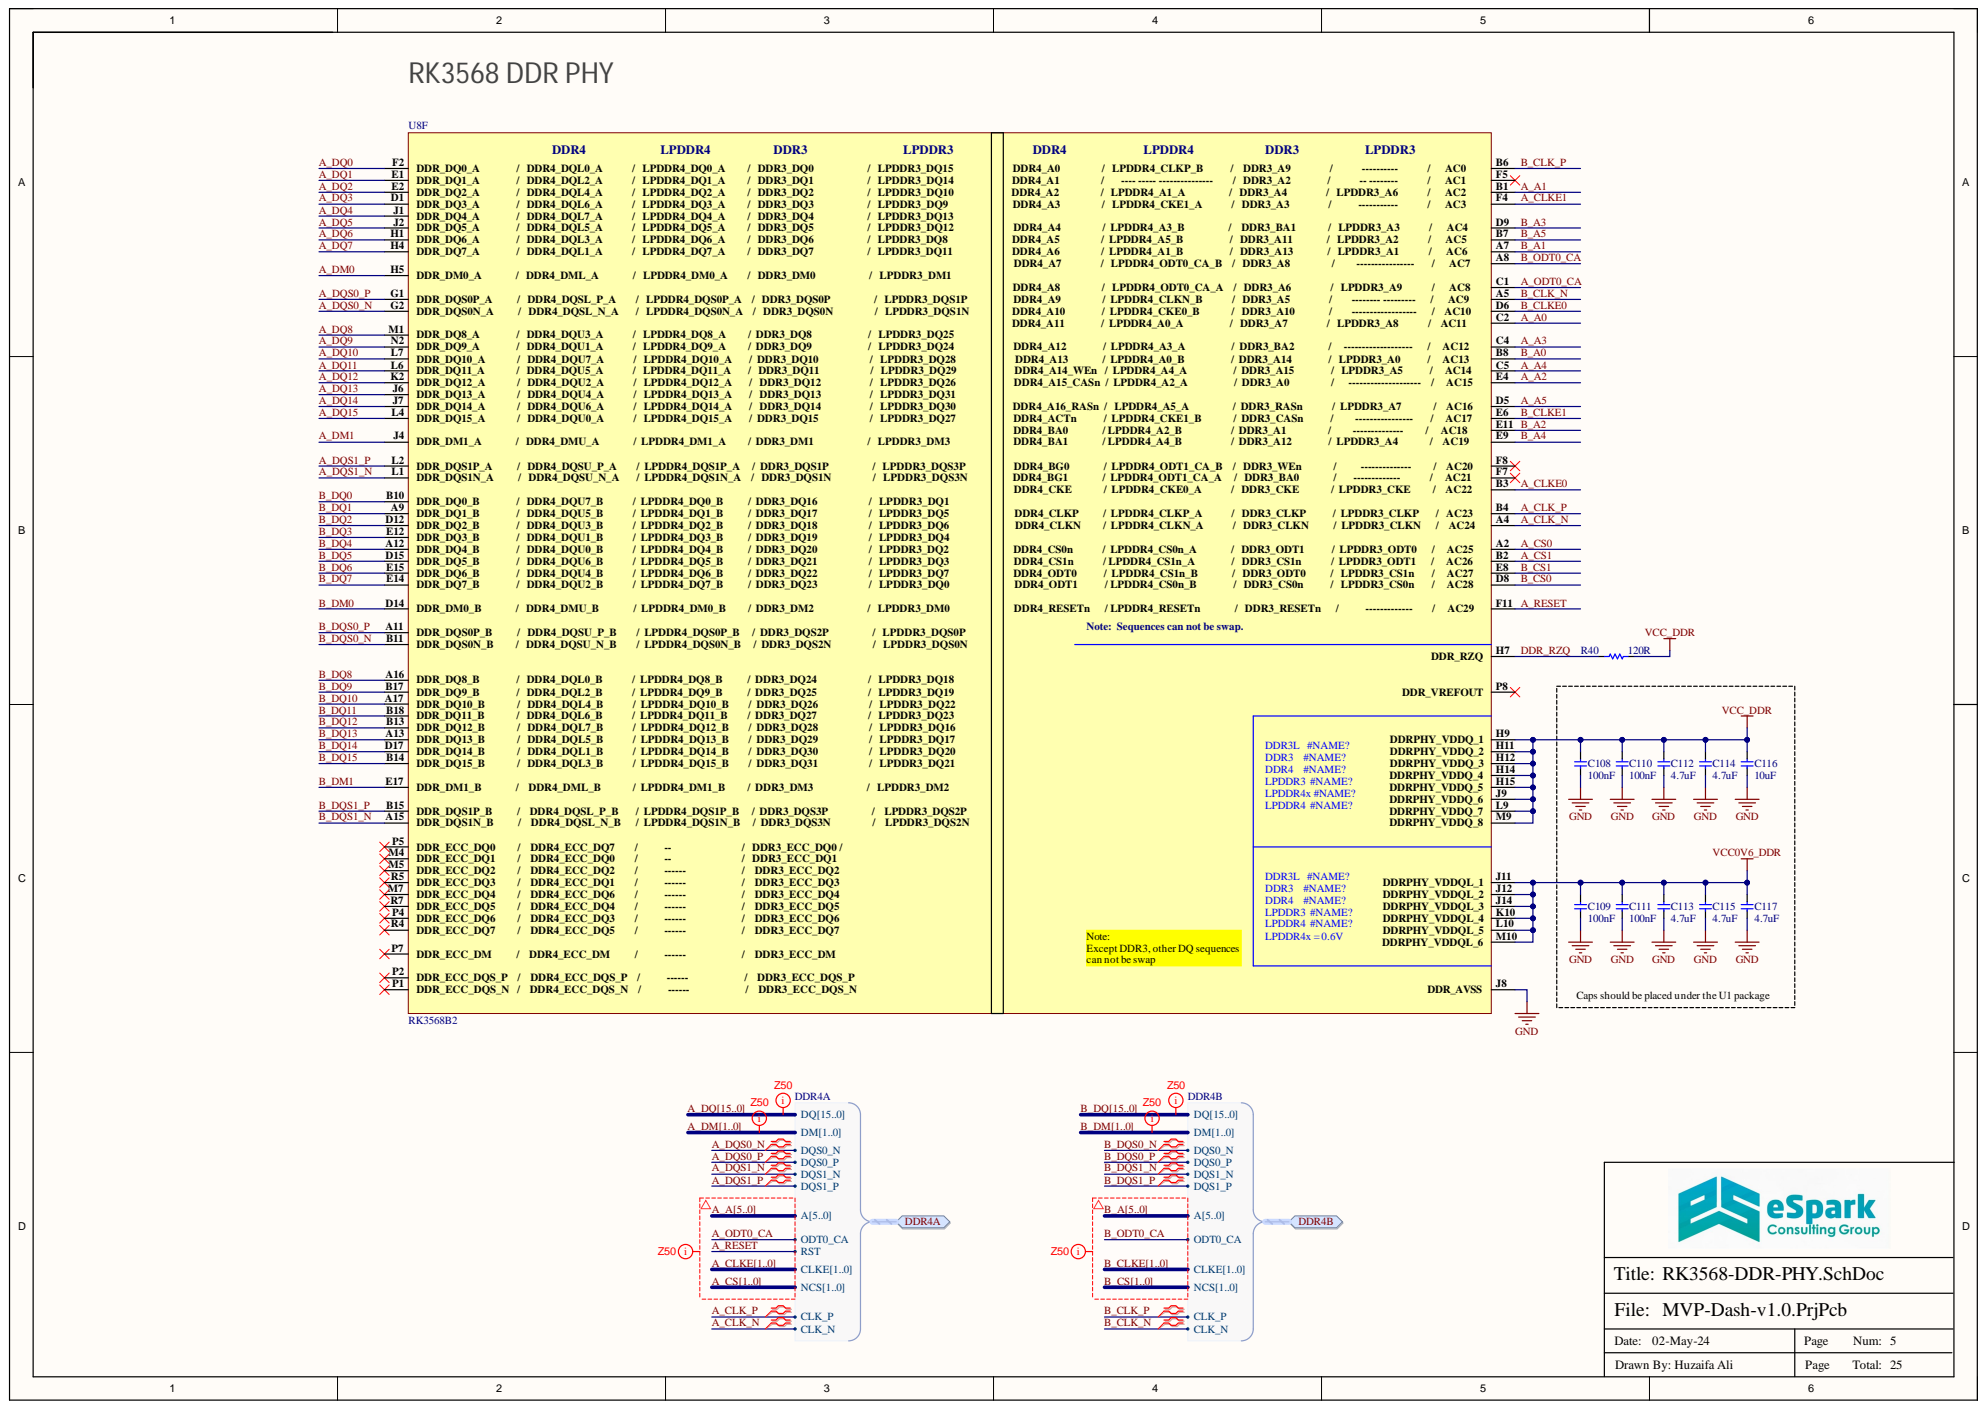
[picture p100: page 5]

Note: Sequences can not be swap.

Caps should be placed

Date : 0 2-M a y-2 4 | P a g e Nu m : 52

Drawn By: Hu z aifa Ali | P a g e T ota l :

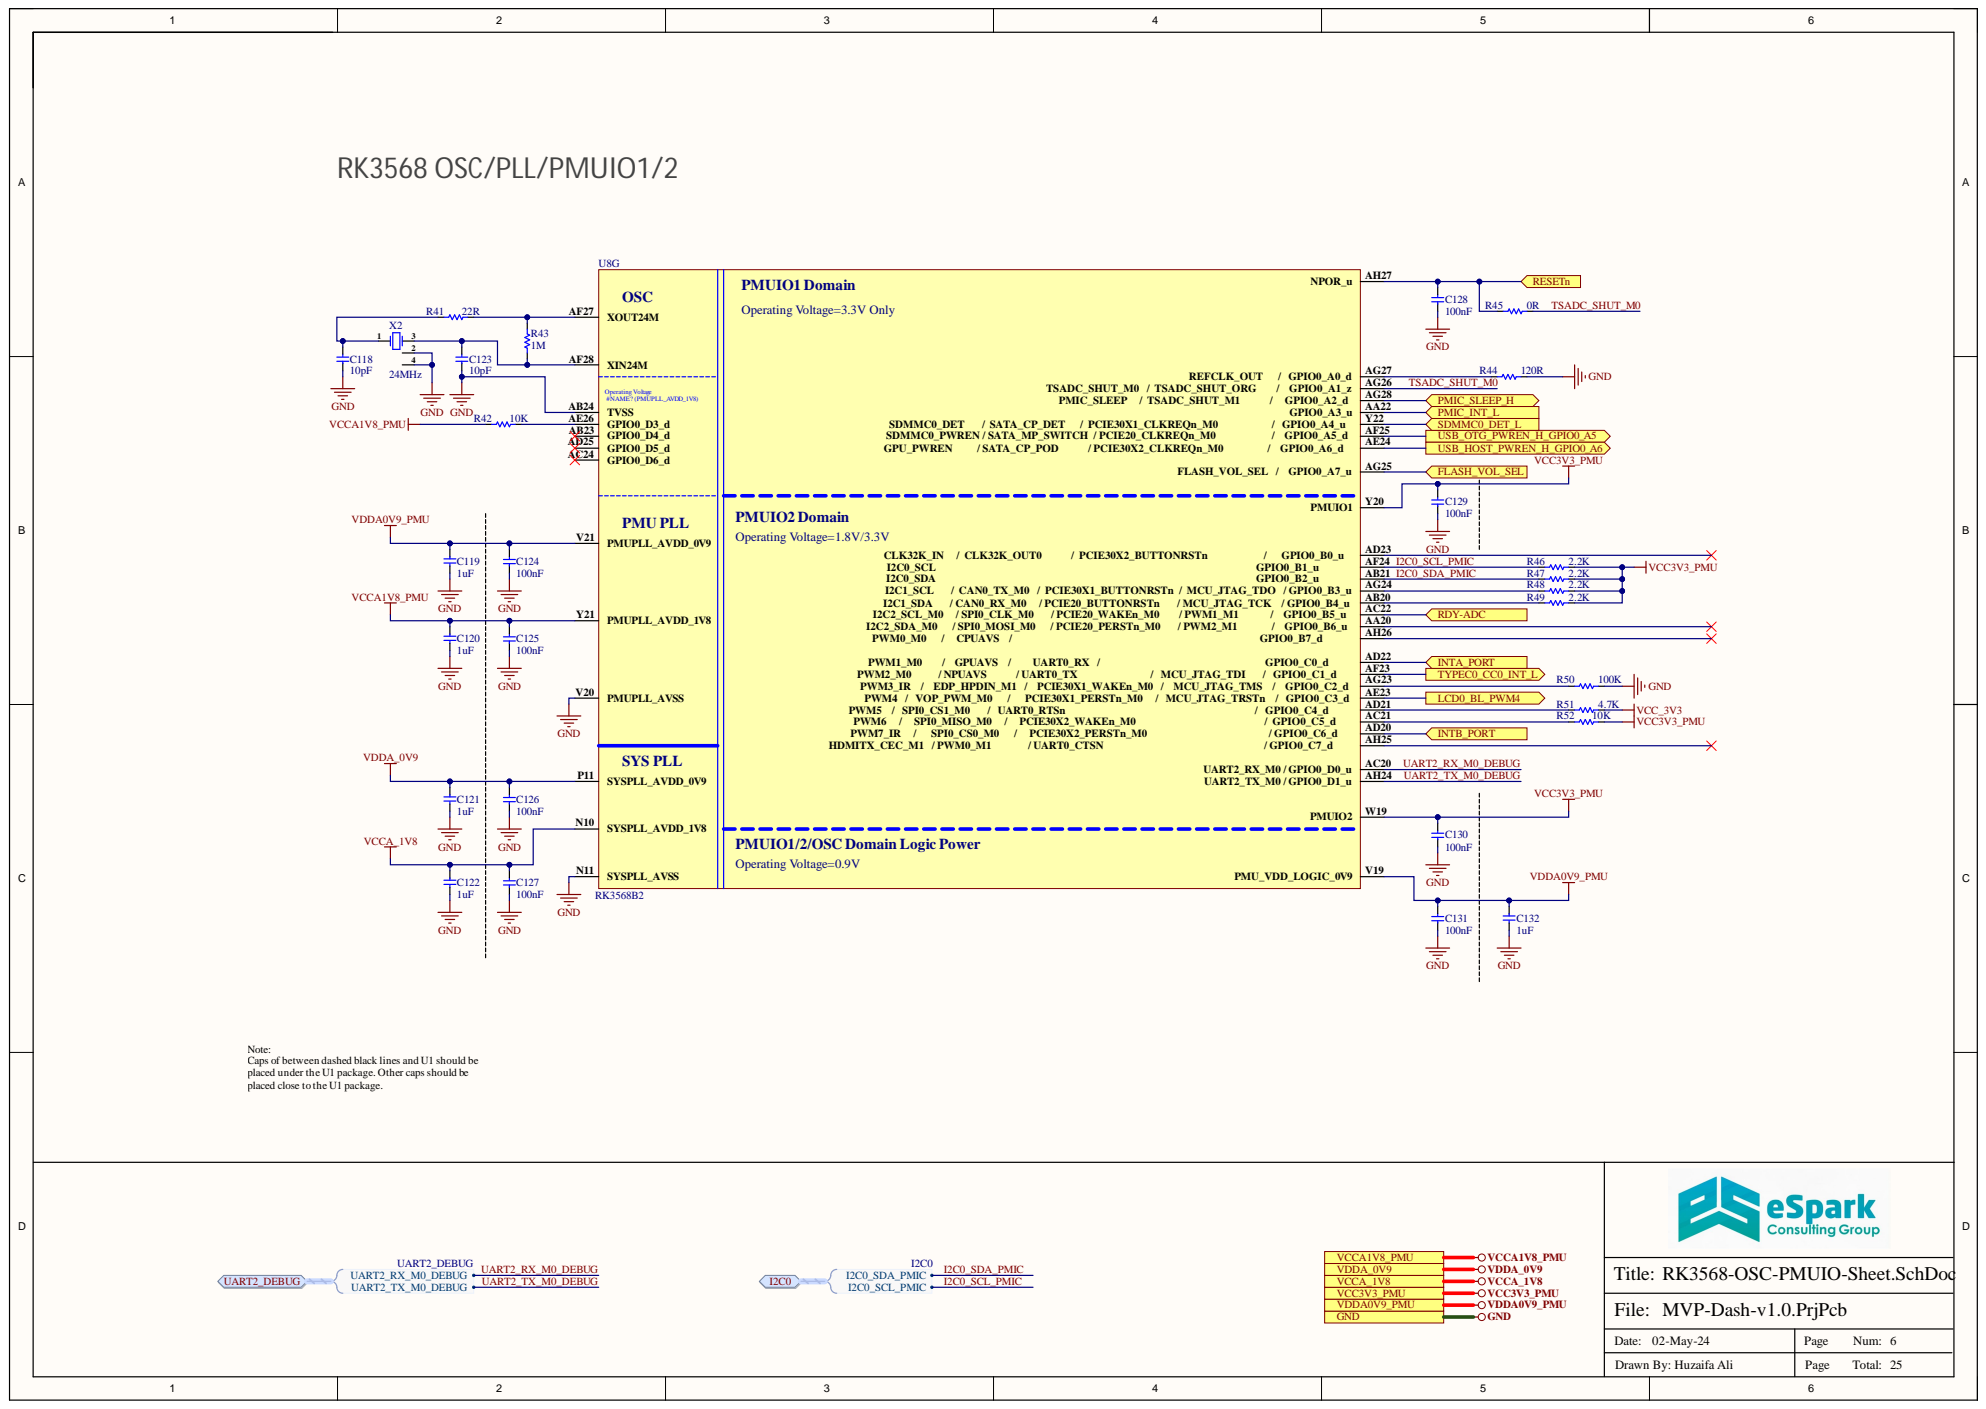
[picture p101: page 6]

PMUIO1/2/OSC Domain Logic Power
Operating Voltage=0.9V

Note:
Caps of between dashed black lines and U1 should be
placed under the U1 package. Other caps should be
placed close to the U1 package.

RK3568-OSC-PMUIO-Sheet.SchDoc

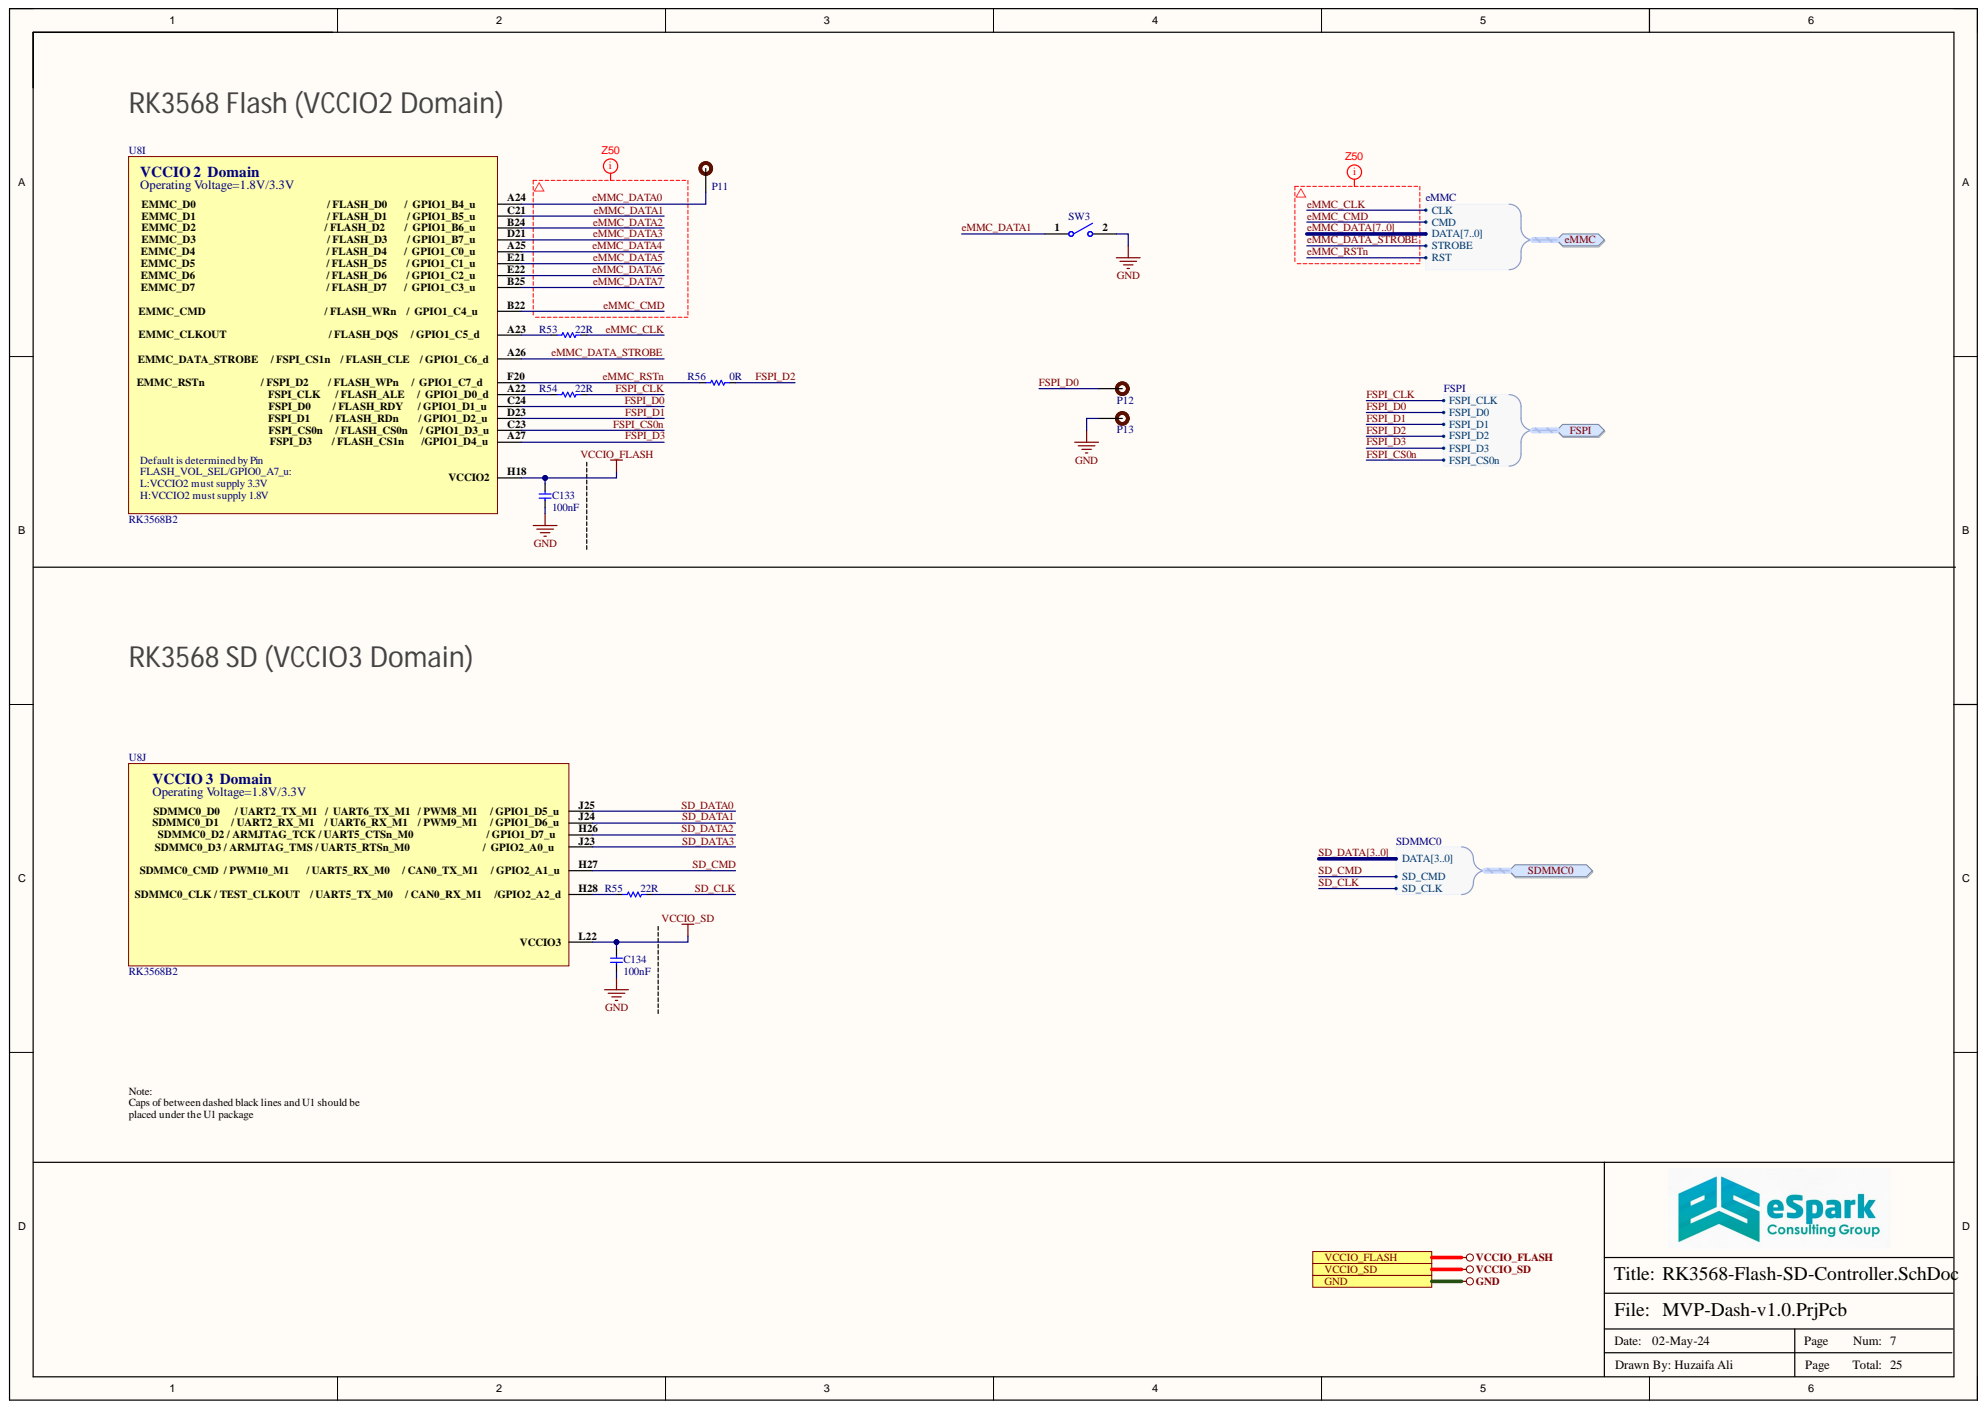
[picture p102: page 7]

VCCIO 2 Domain Operating Voltage=1.8V/3.3V

VCCIO 3 Domain Operating Voltage=1.8V/3.3V

Note:
Caps of between dashed black lines and U1 should be
placed under the U1 package

RK3568-Flash-SD-Controller.SchDoc

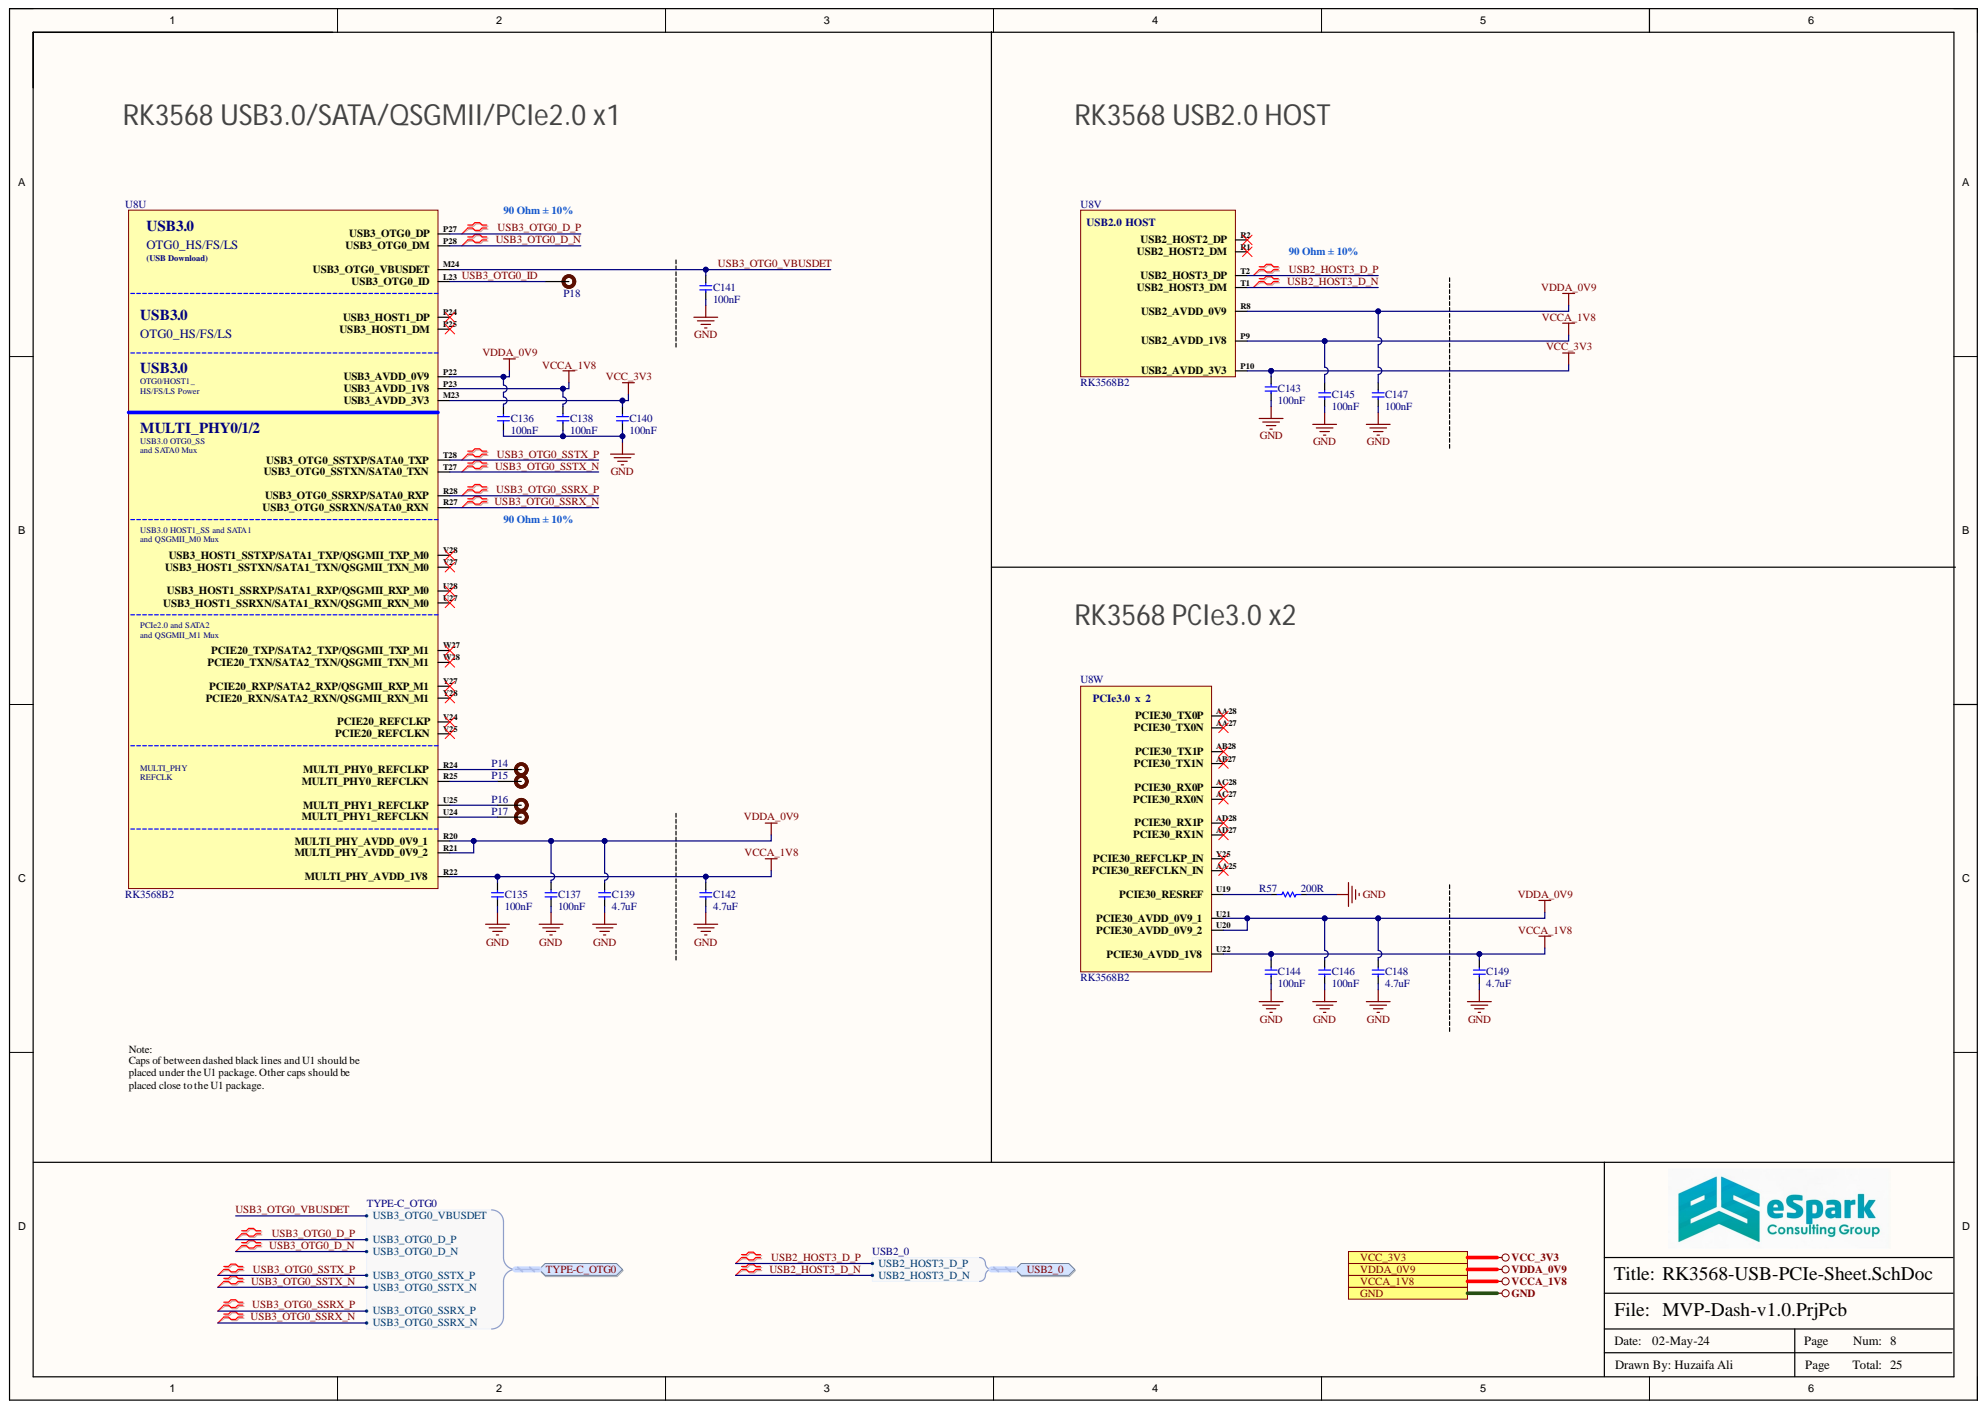
[picture p103: page 8]

HS/FS/LS Power

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

RK3568-USB-PCIe-Sheet.SchDoc

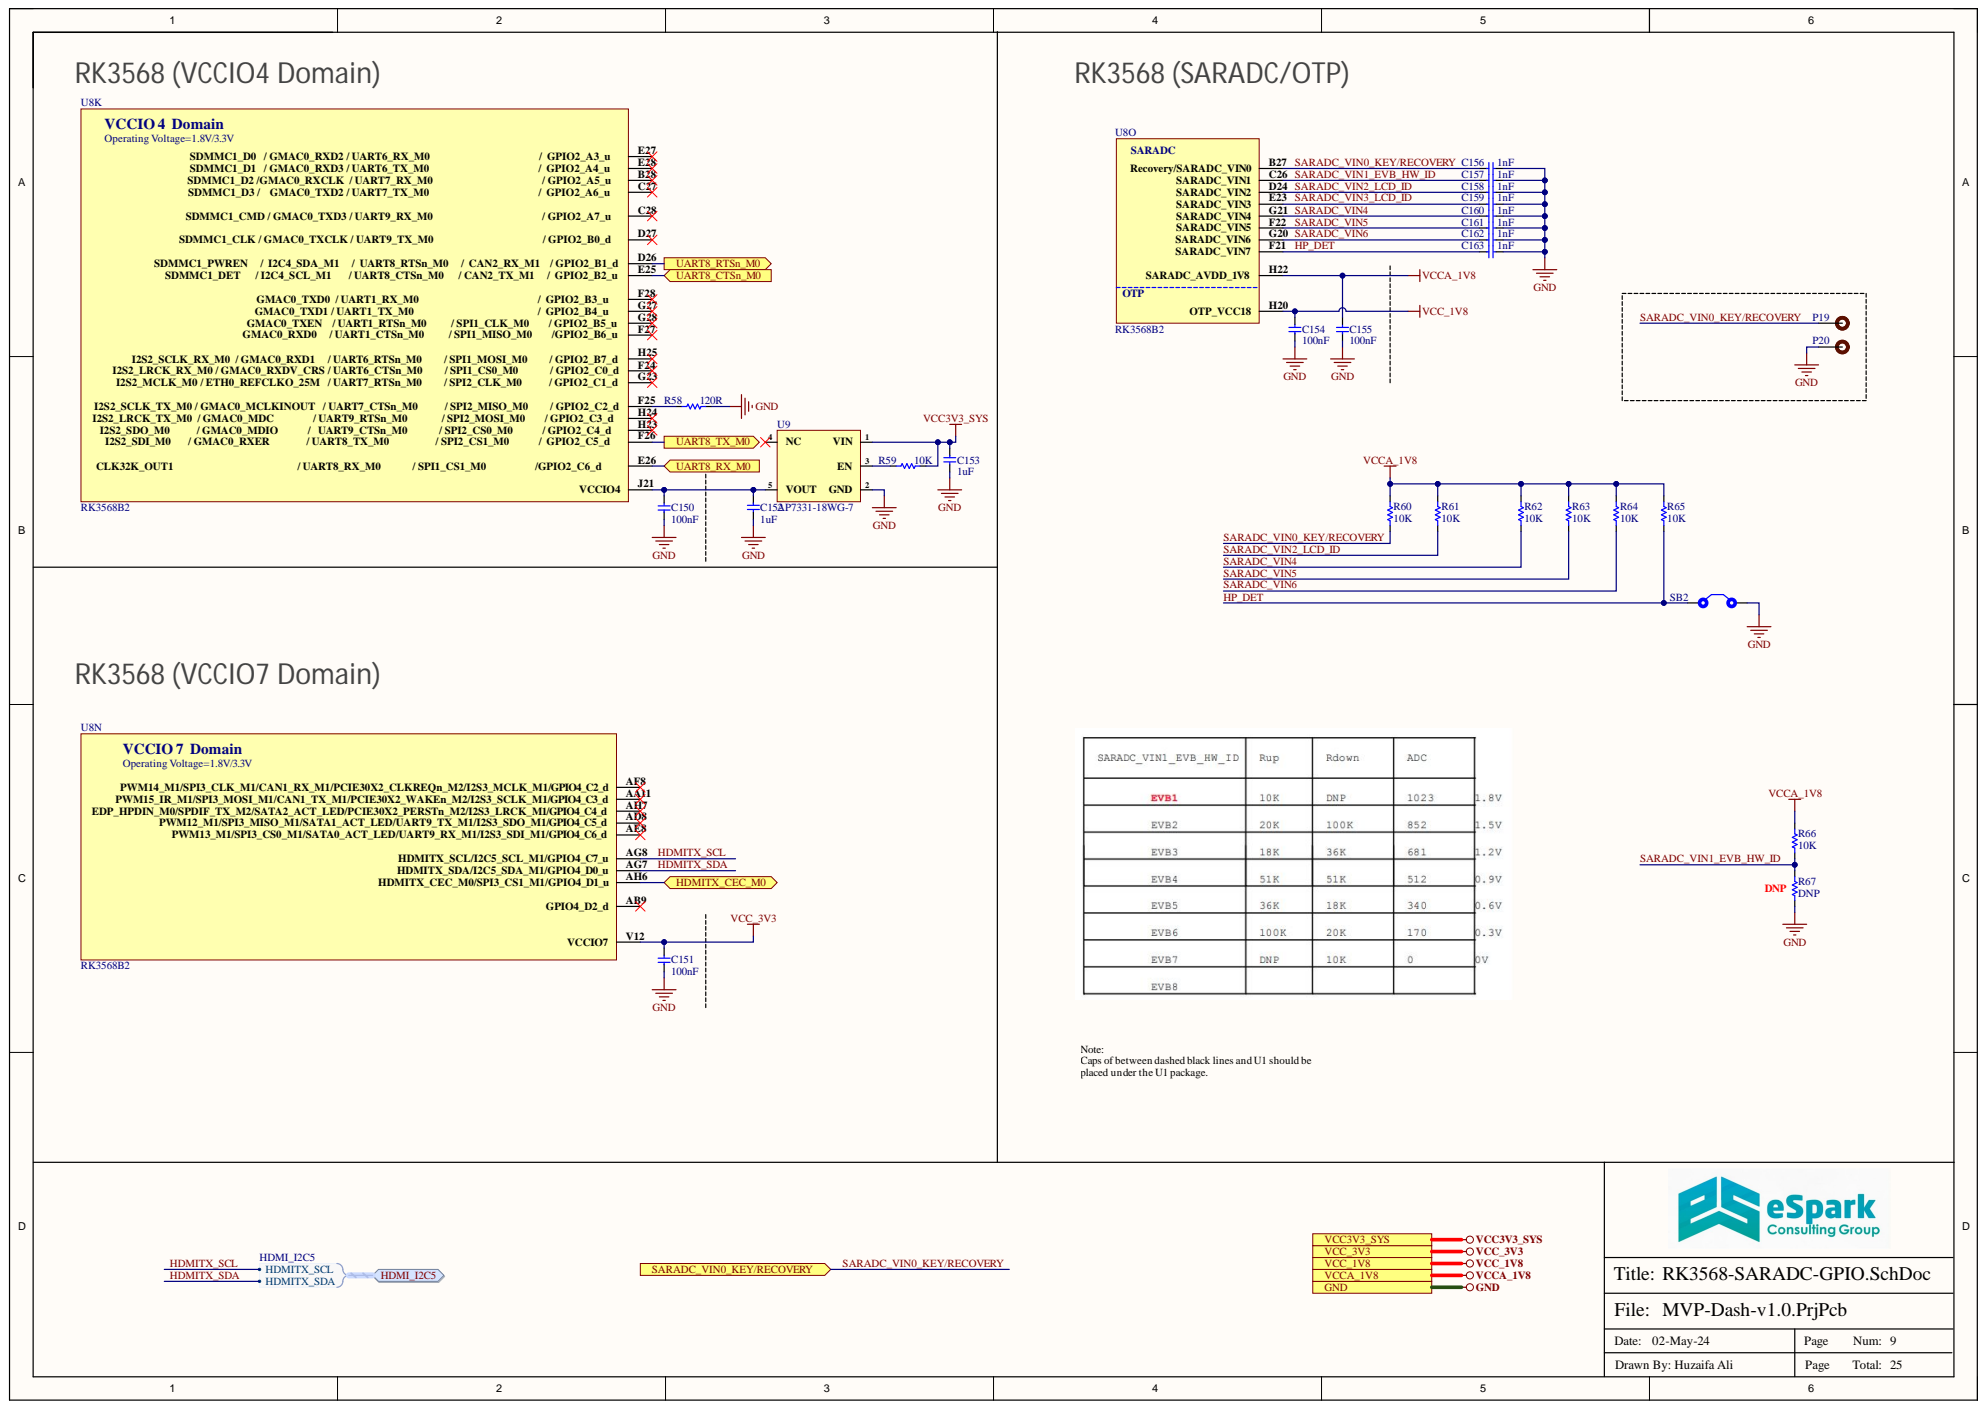
[picture p104: page 9]

VCCIO 4 Domain Operating Voltage=1.8V/3.3V

VCCIO 7 Domain Operating Voltage=1.8V/3.3V

Note:
Caps of between dashed black lines and U1 should be
placed under the U1 package.

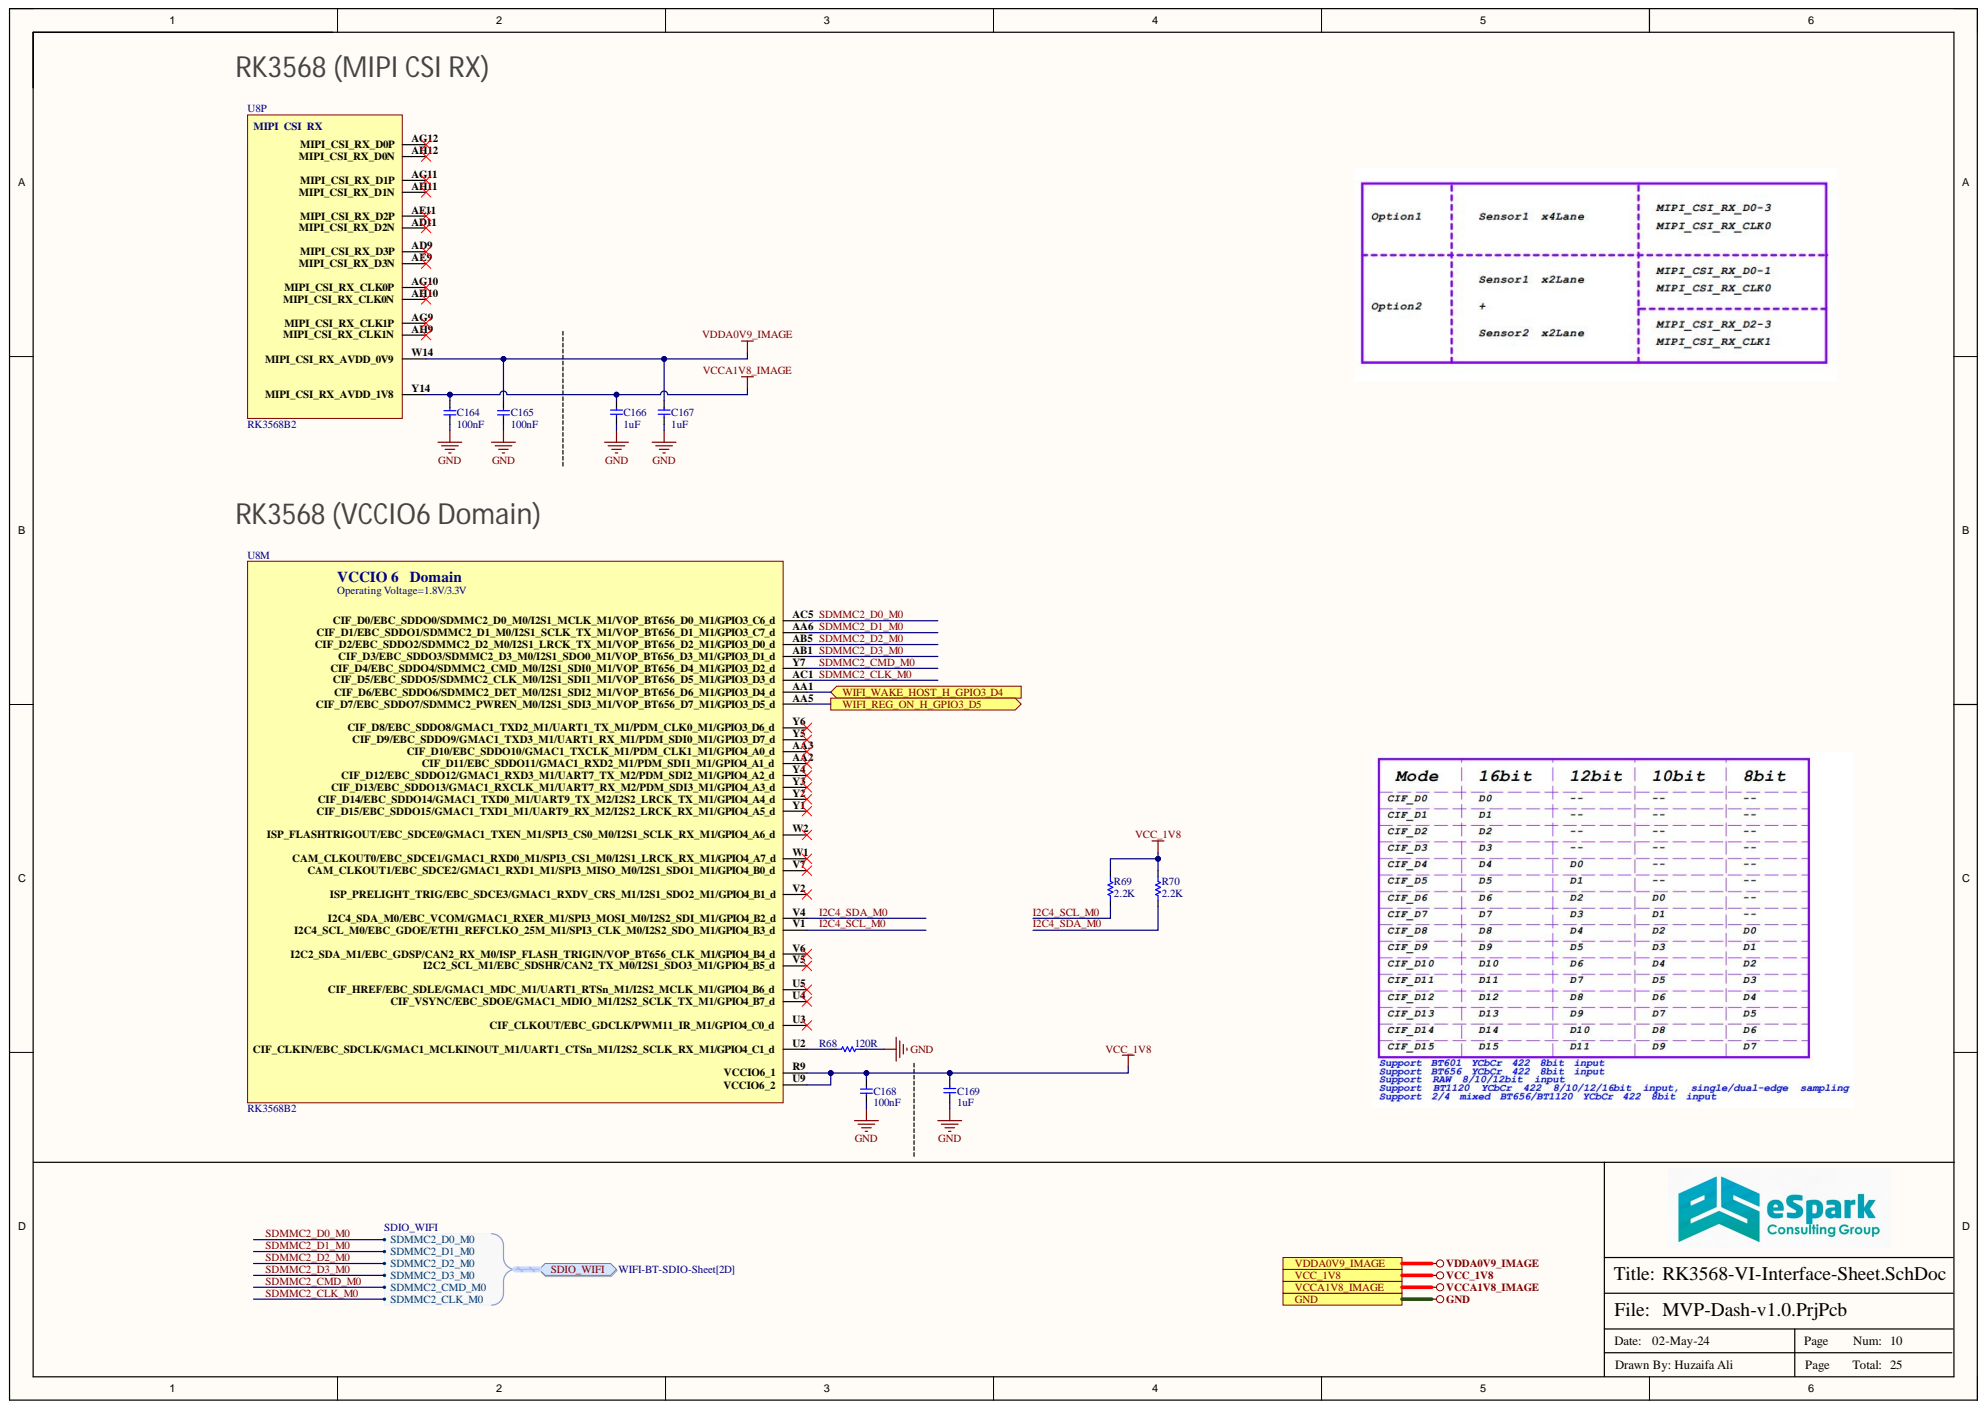
[picture p105: page 10]

VCCIO 6 Domain Operating Voltage=1.8V/3.3V

RK3568-VI-Interface-Sheet.SchDoc

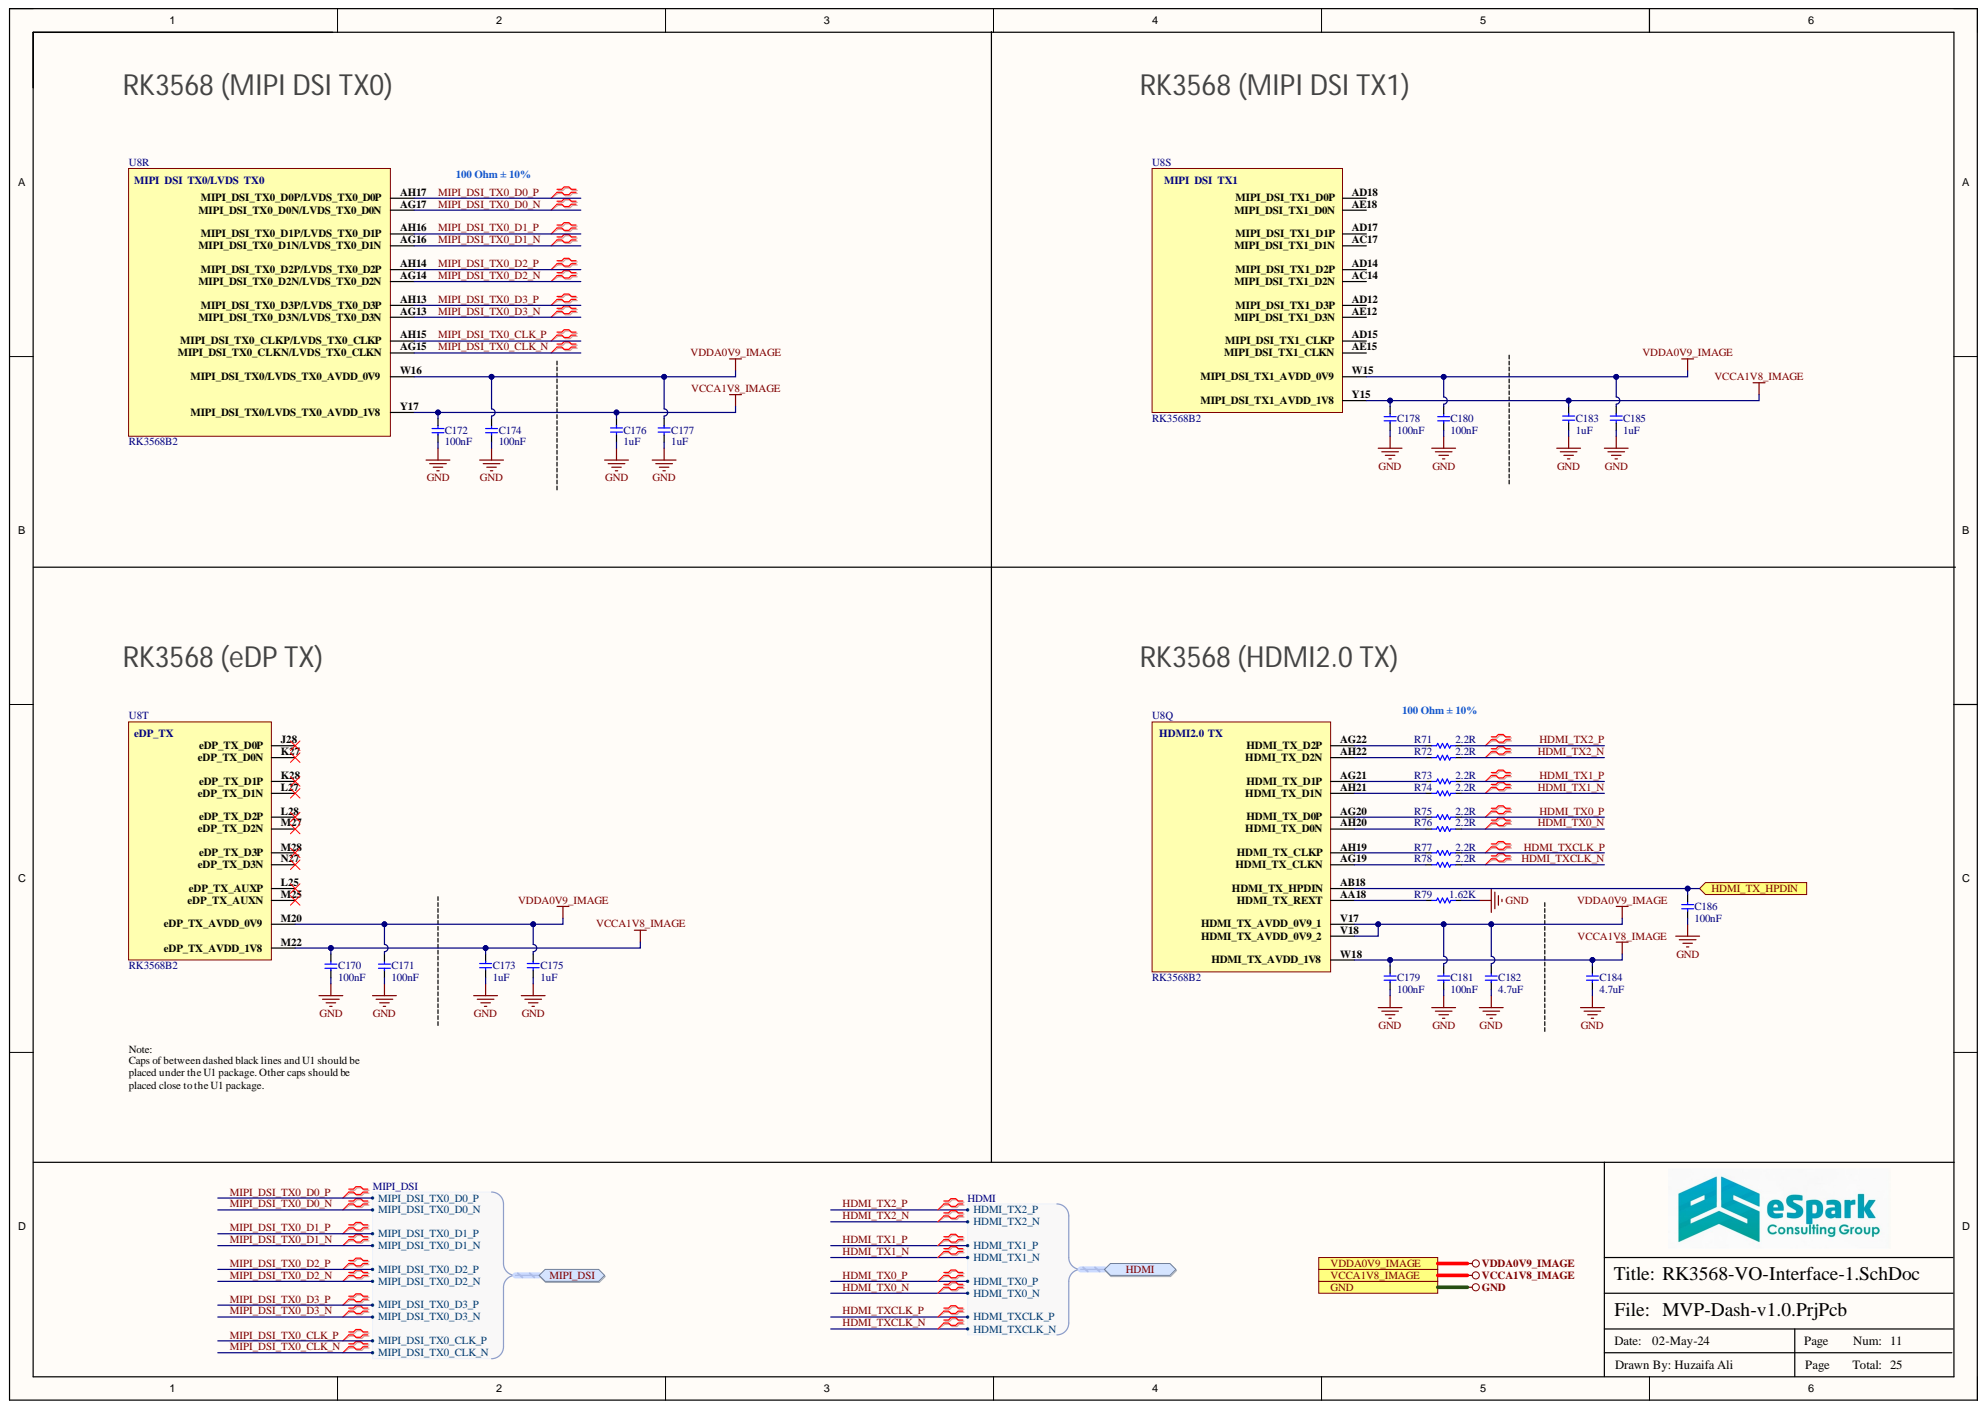
[picture p106: page 11]
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

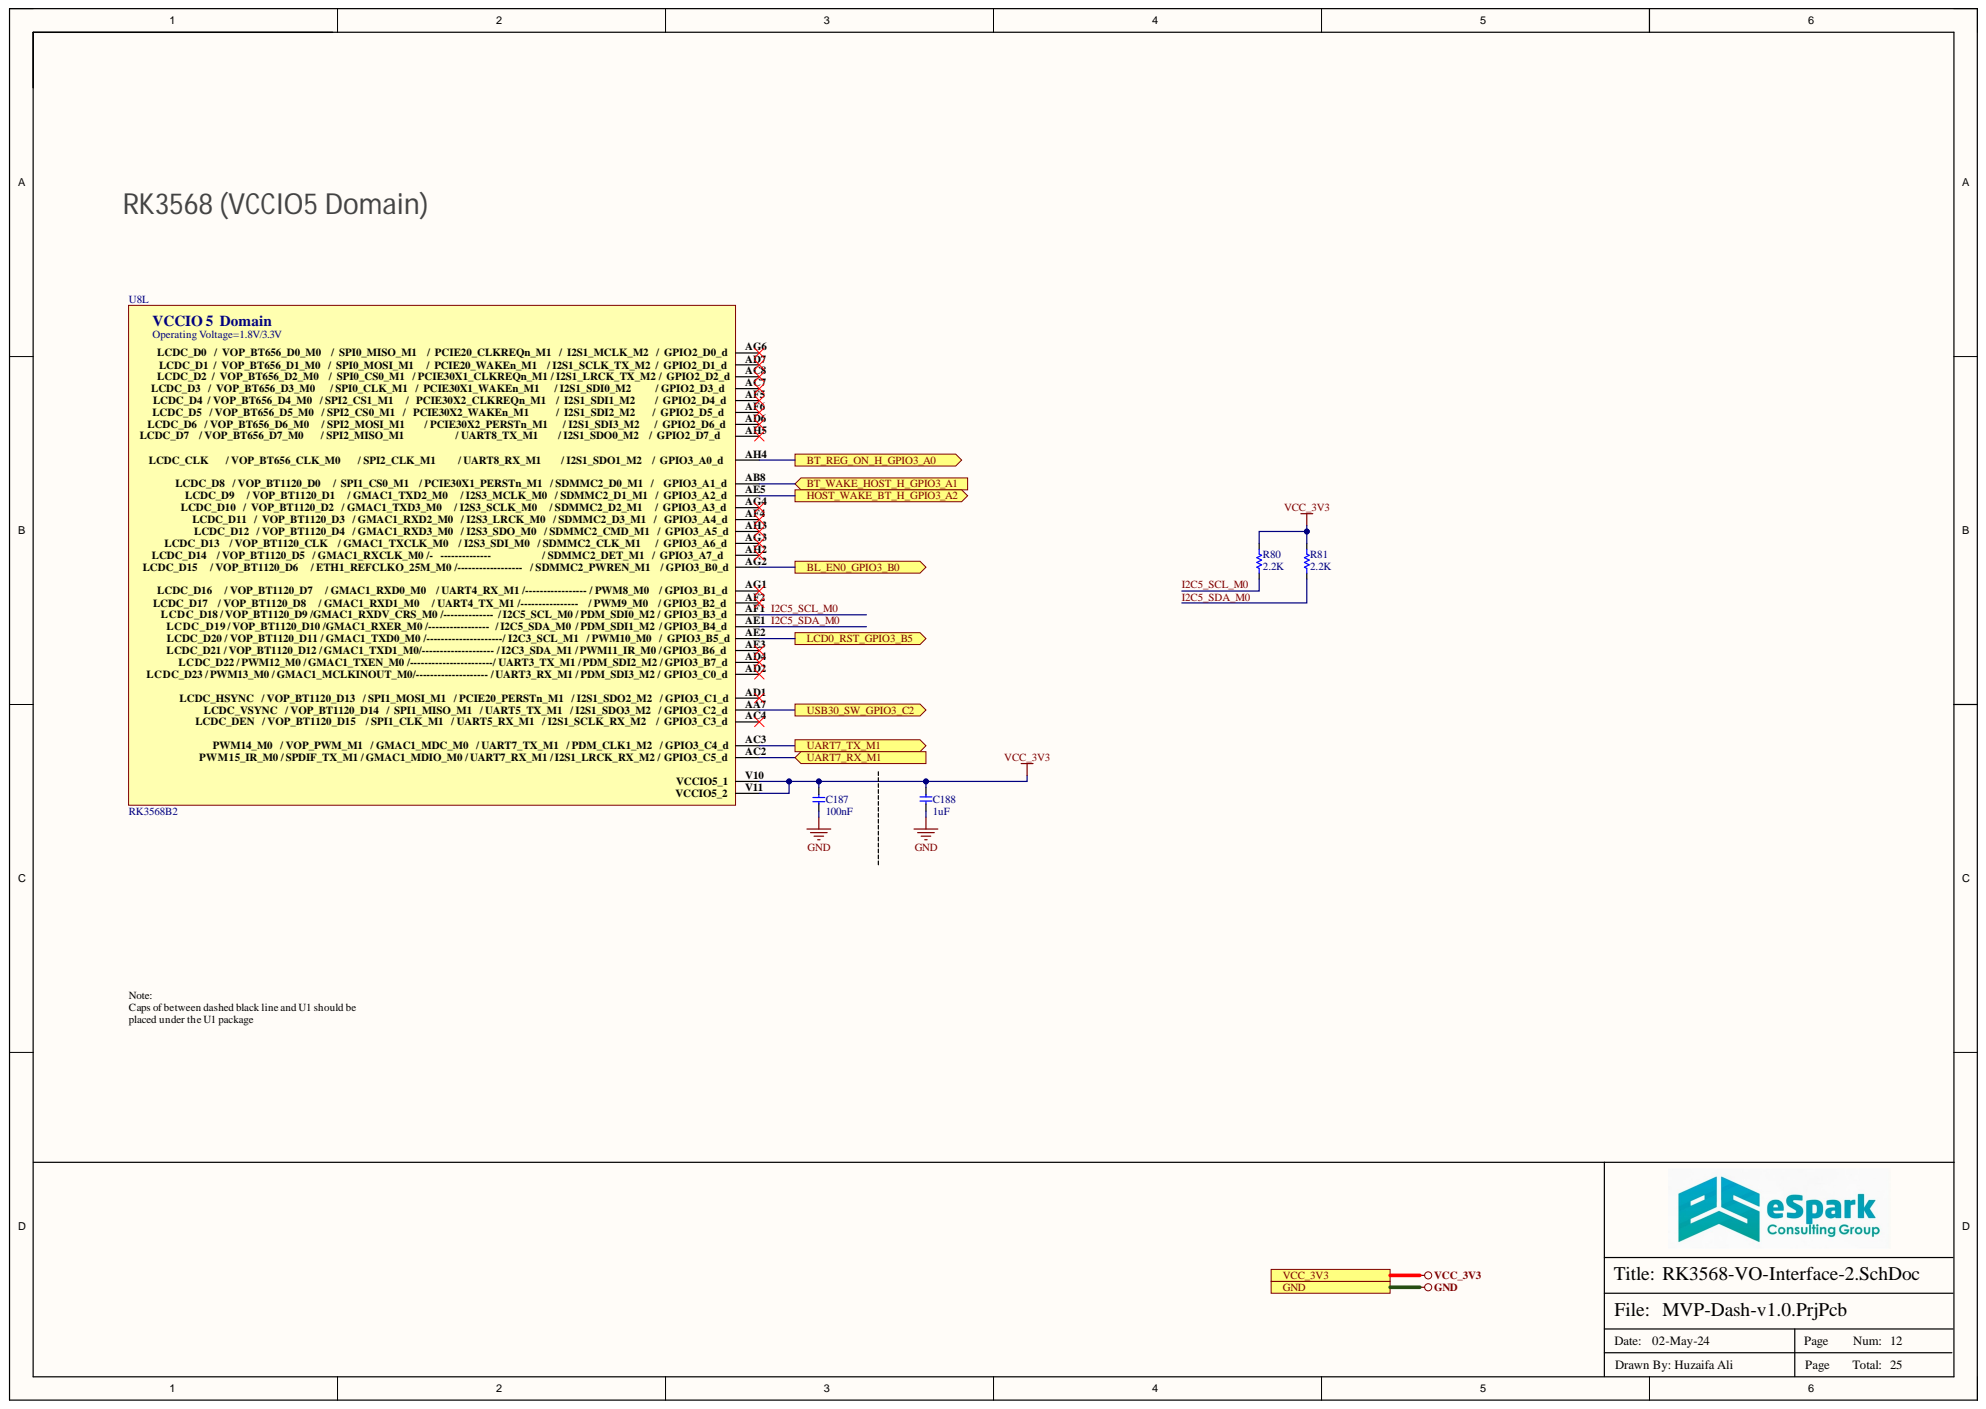
[picture p107: page 12]

VCCIO 5 Domain Operating Voltage=1.8V/3.3V

Note:
Caps of between dashed black line and U1 should be
placed under the U1 package

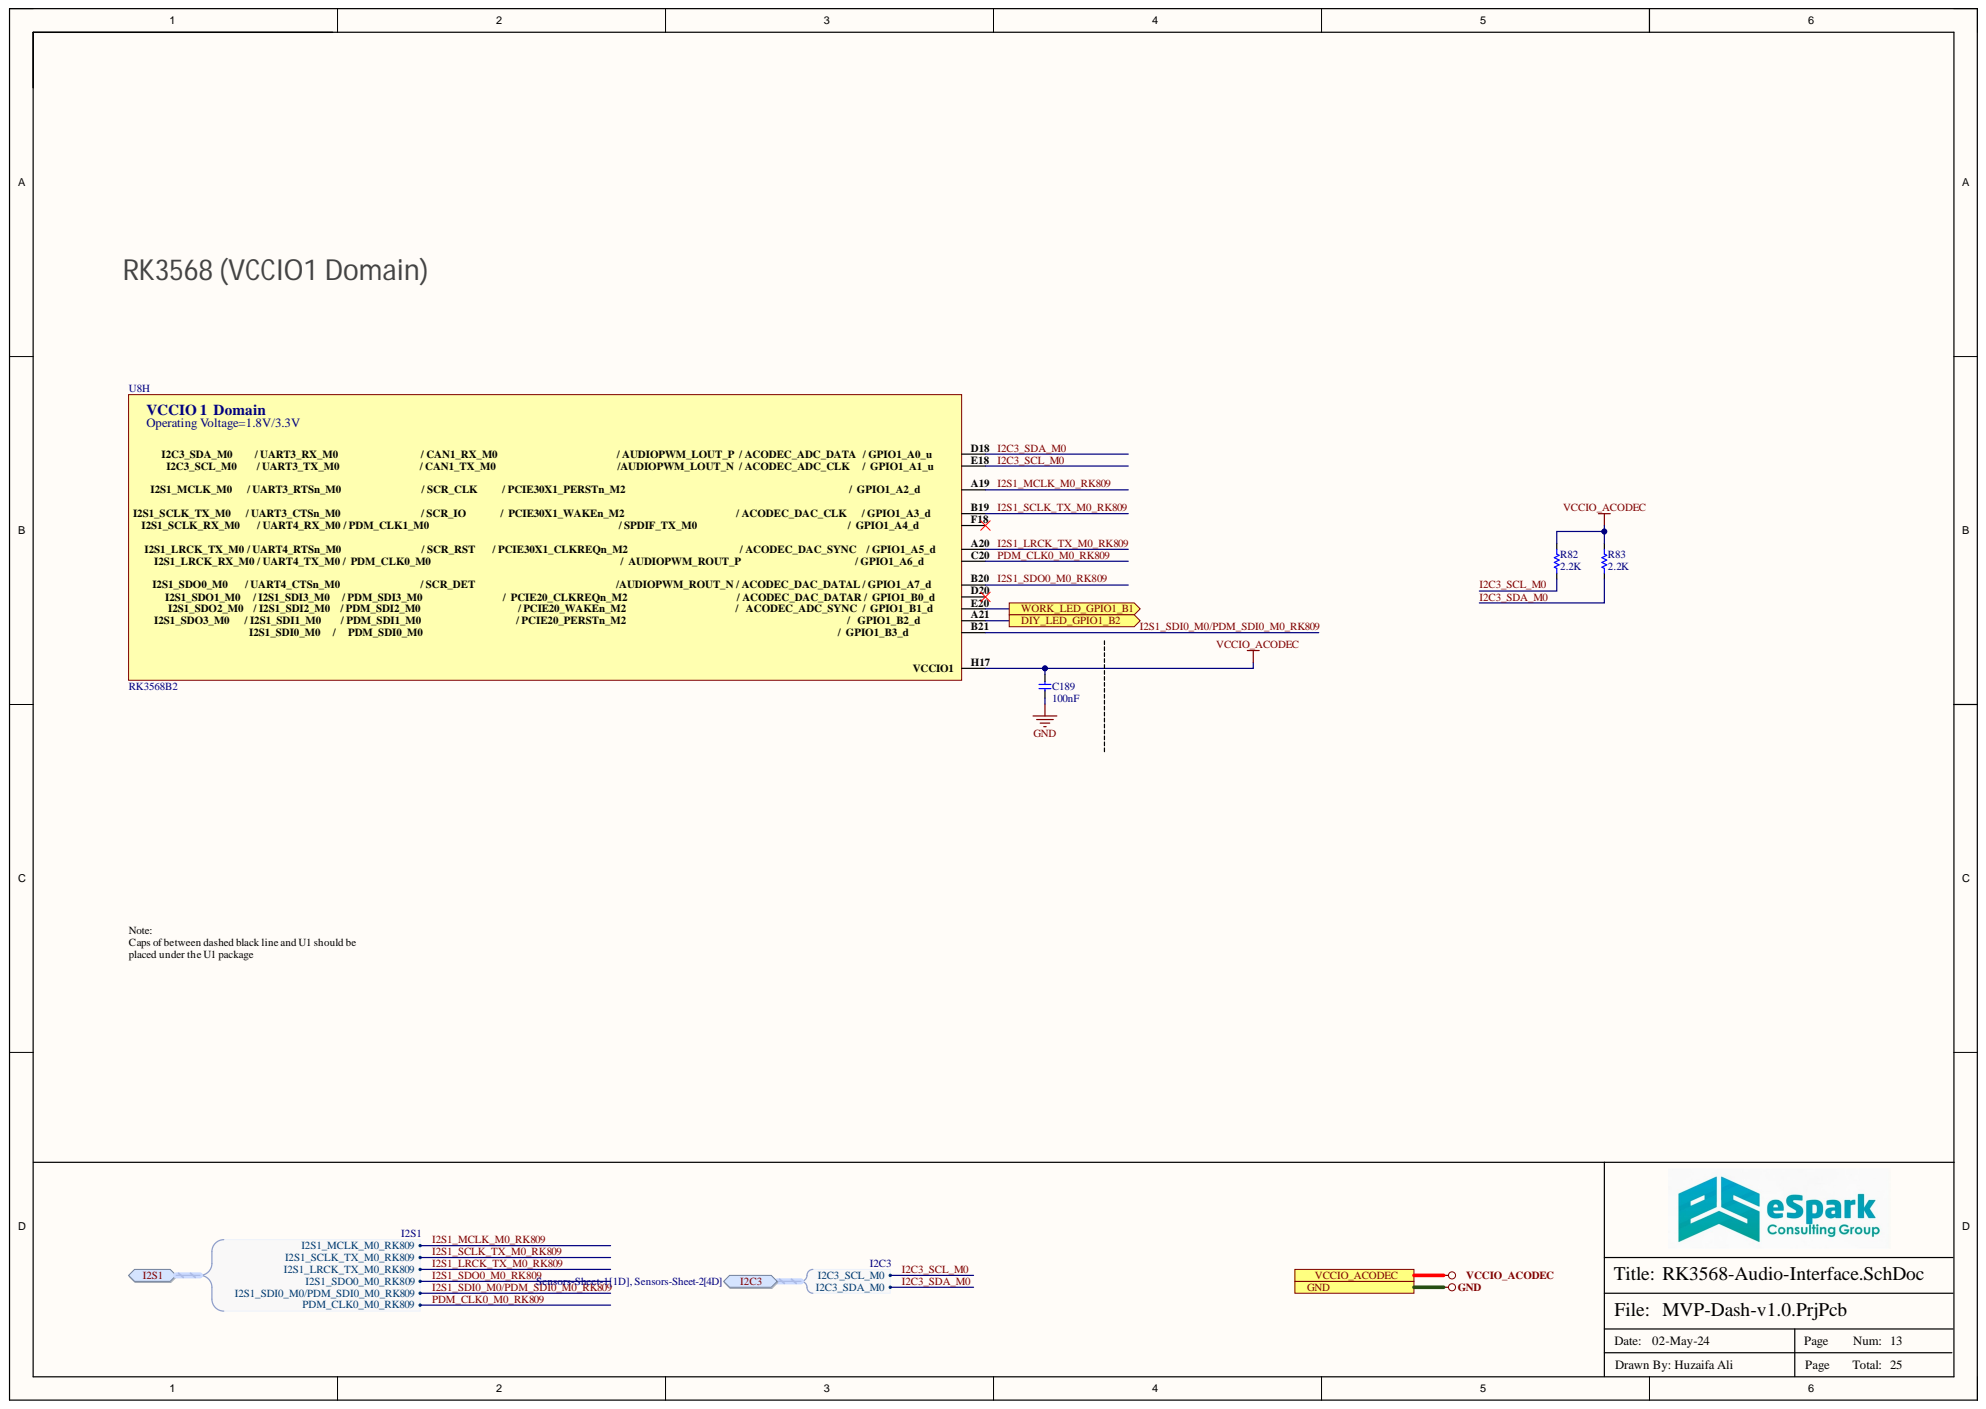
[picture p108: page 13]

VCCIO 1 Domain Operating Voltage=1.8V/3.3V

Note:
Caps of between dashed black line and U1 should be
placed under the U1 package

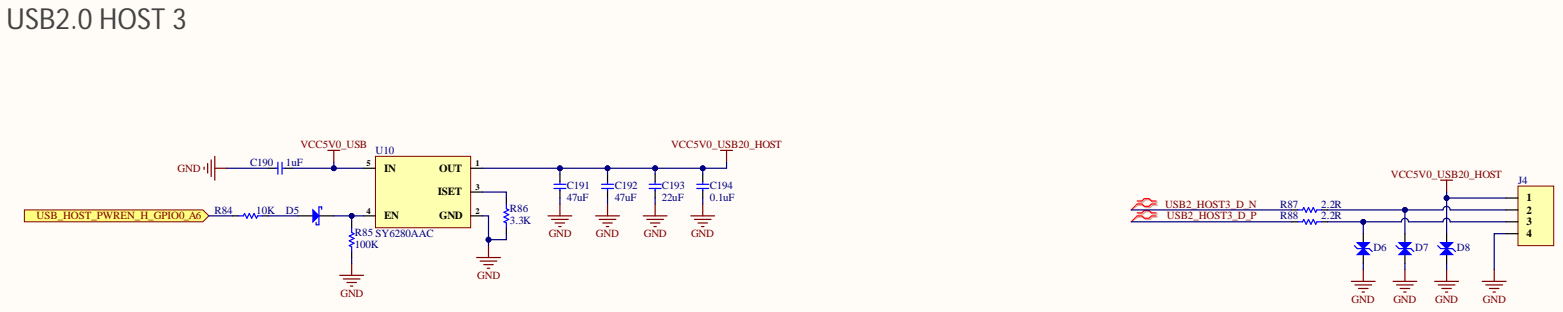
[picture p109: page 14]

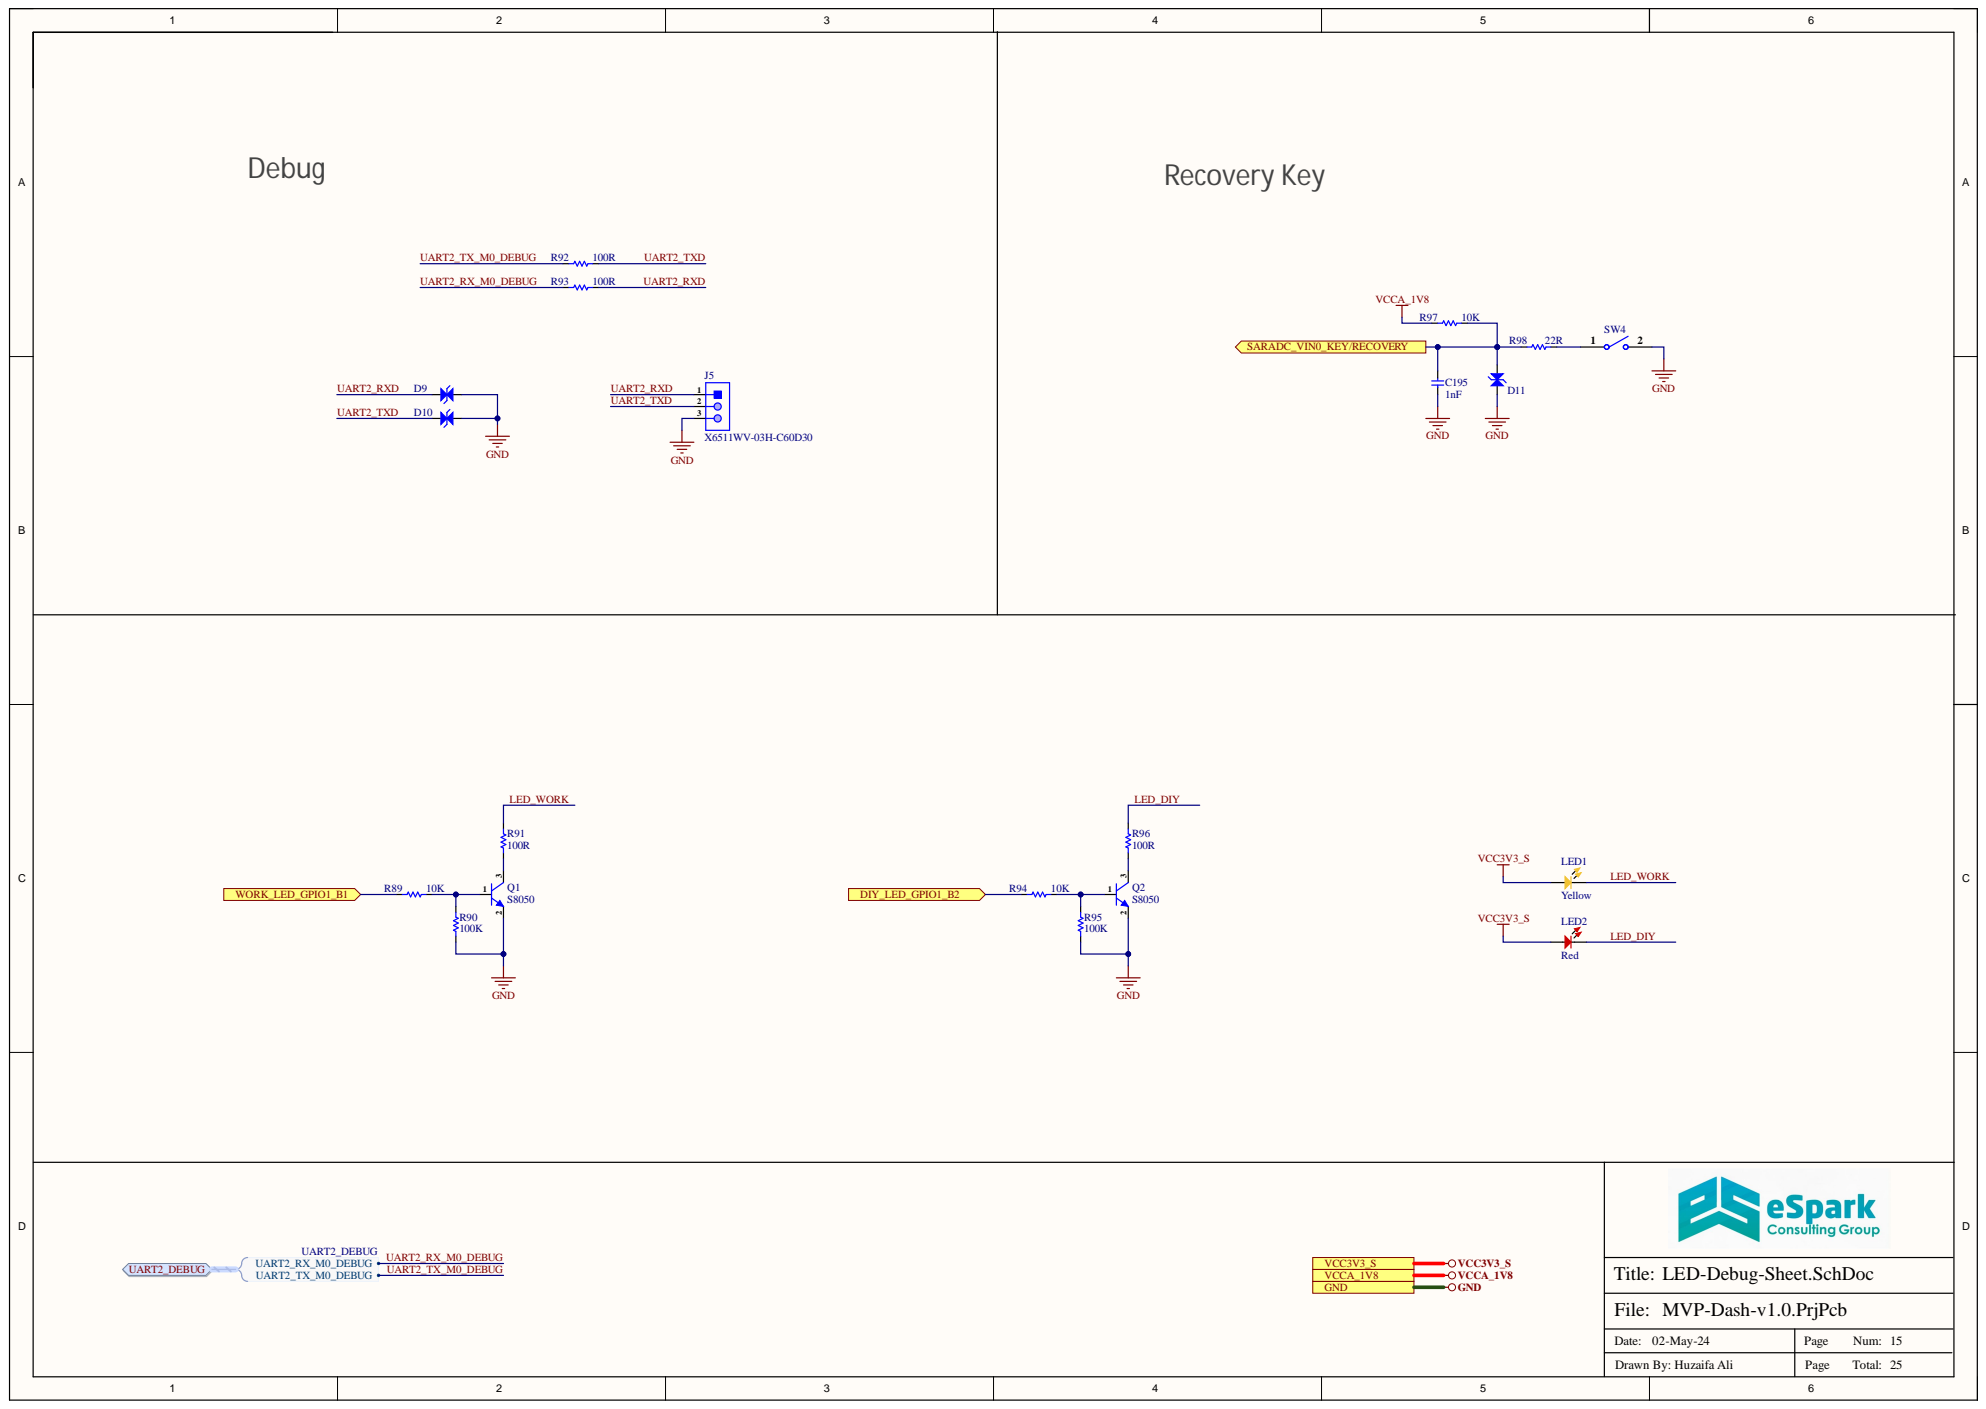
[picture p110: page 15]

LED-Debug-Sheet.SchDoc

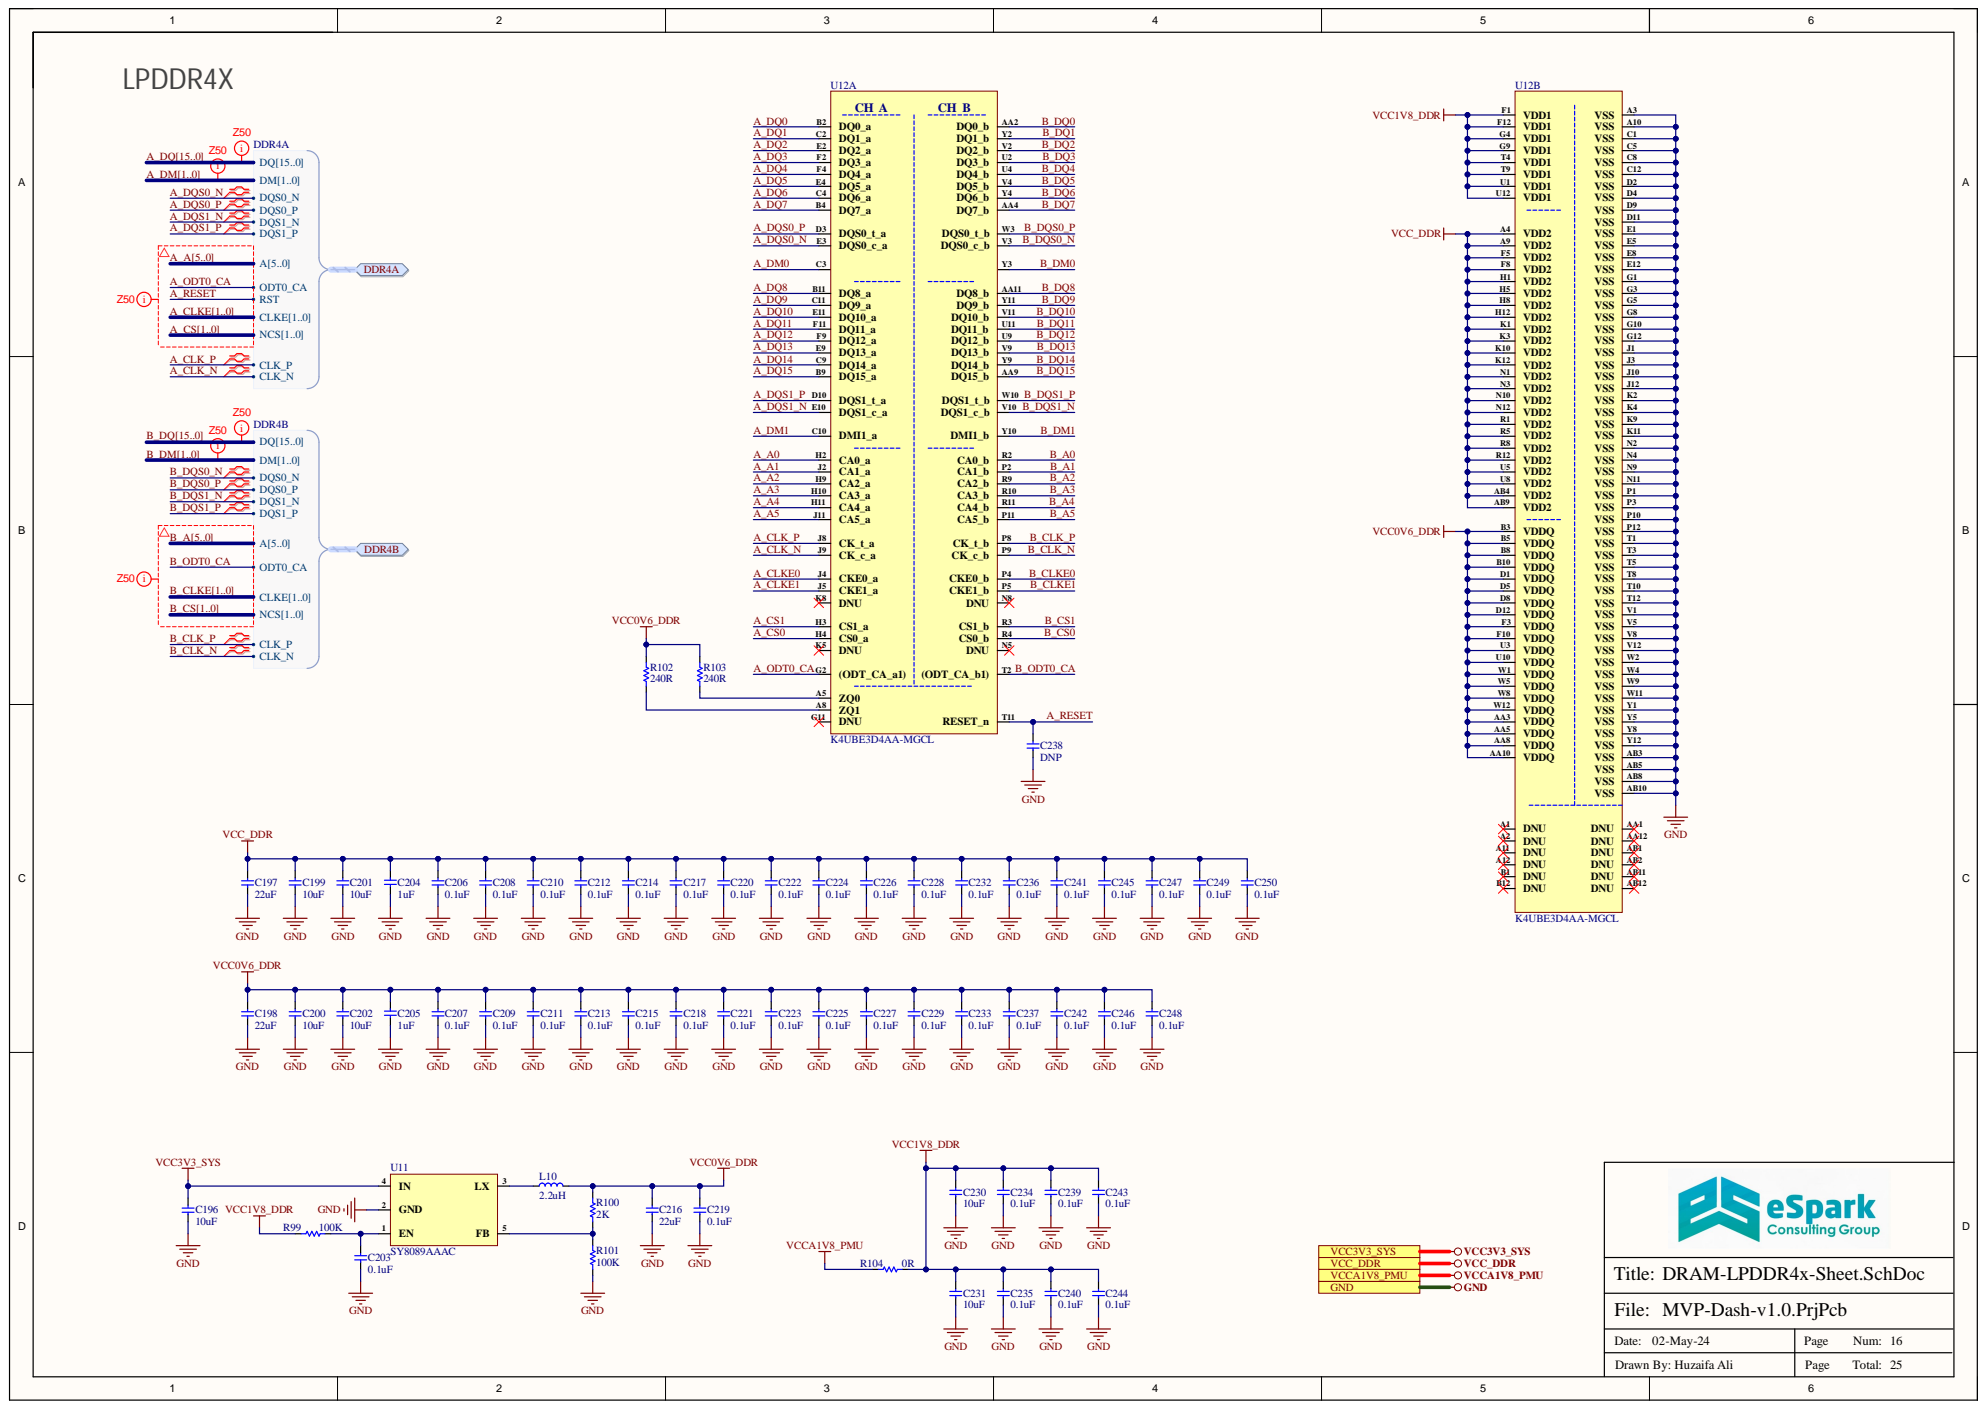
[picture p111: page 16]

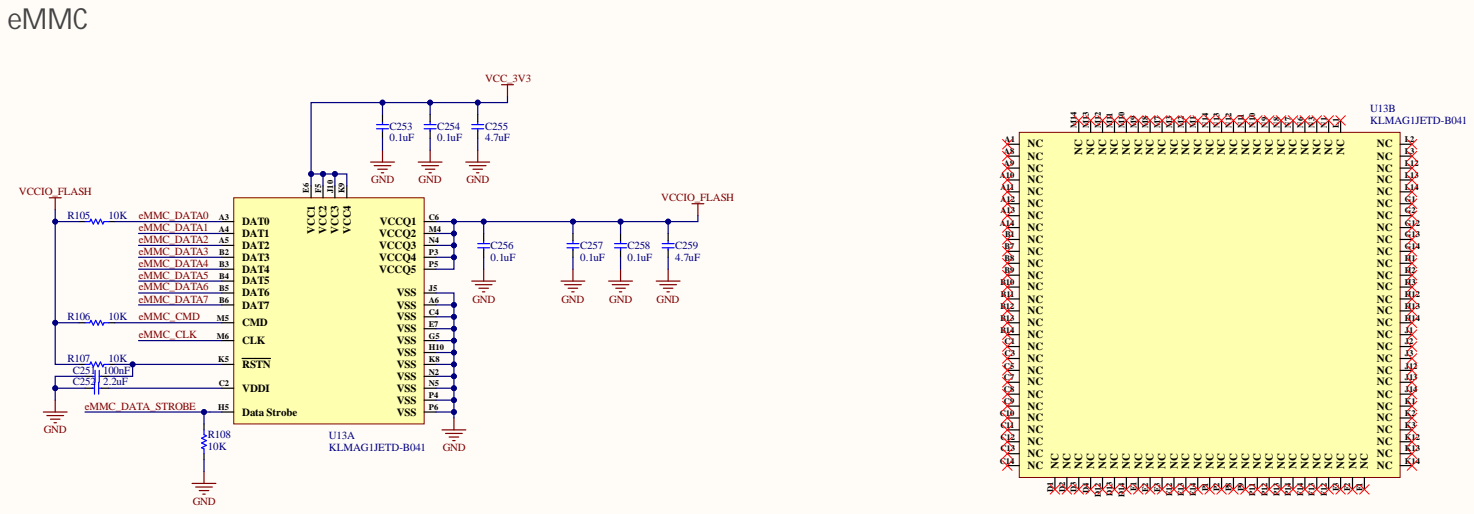
[picture p112: page 17]

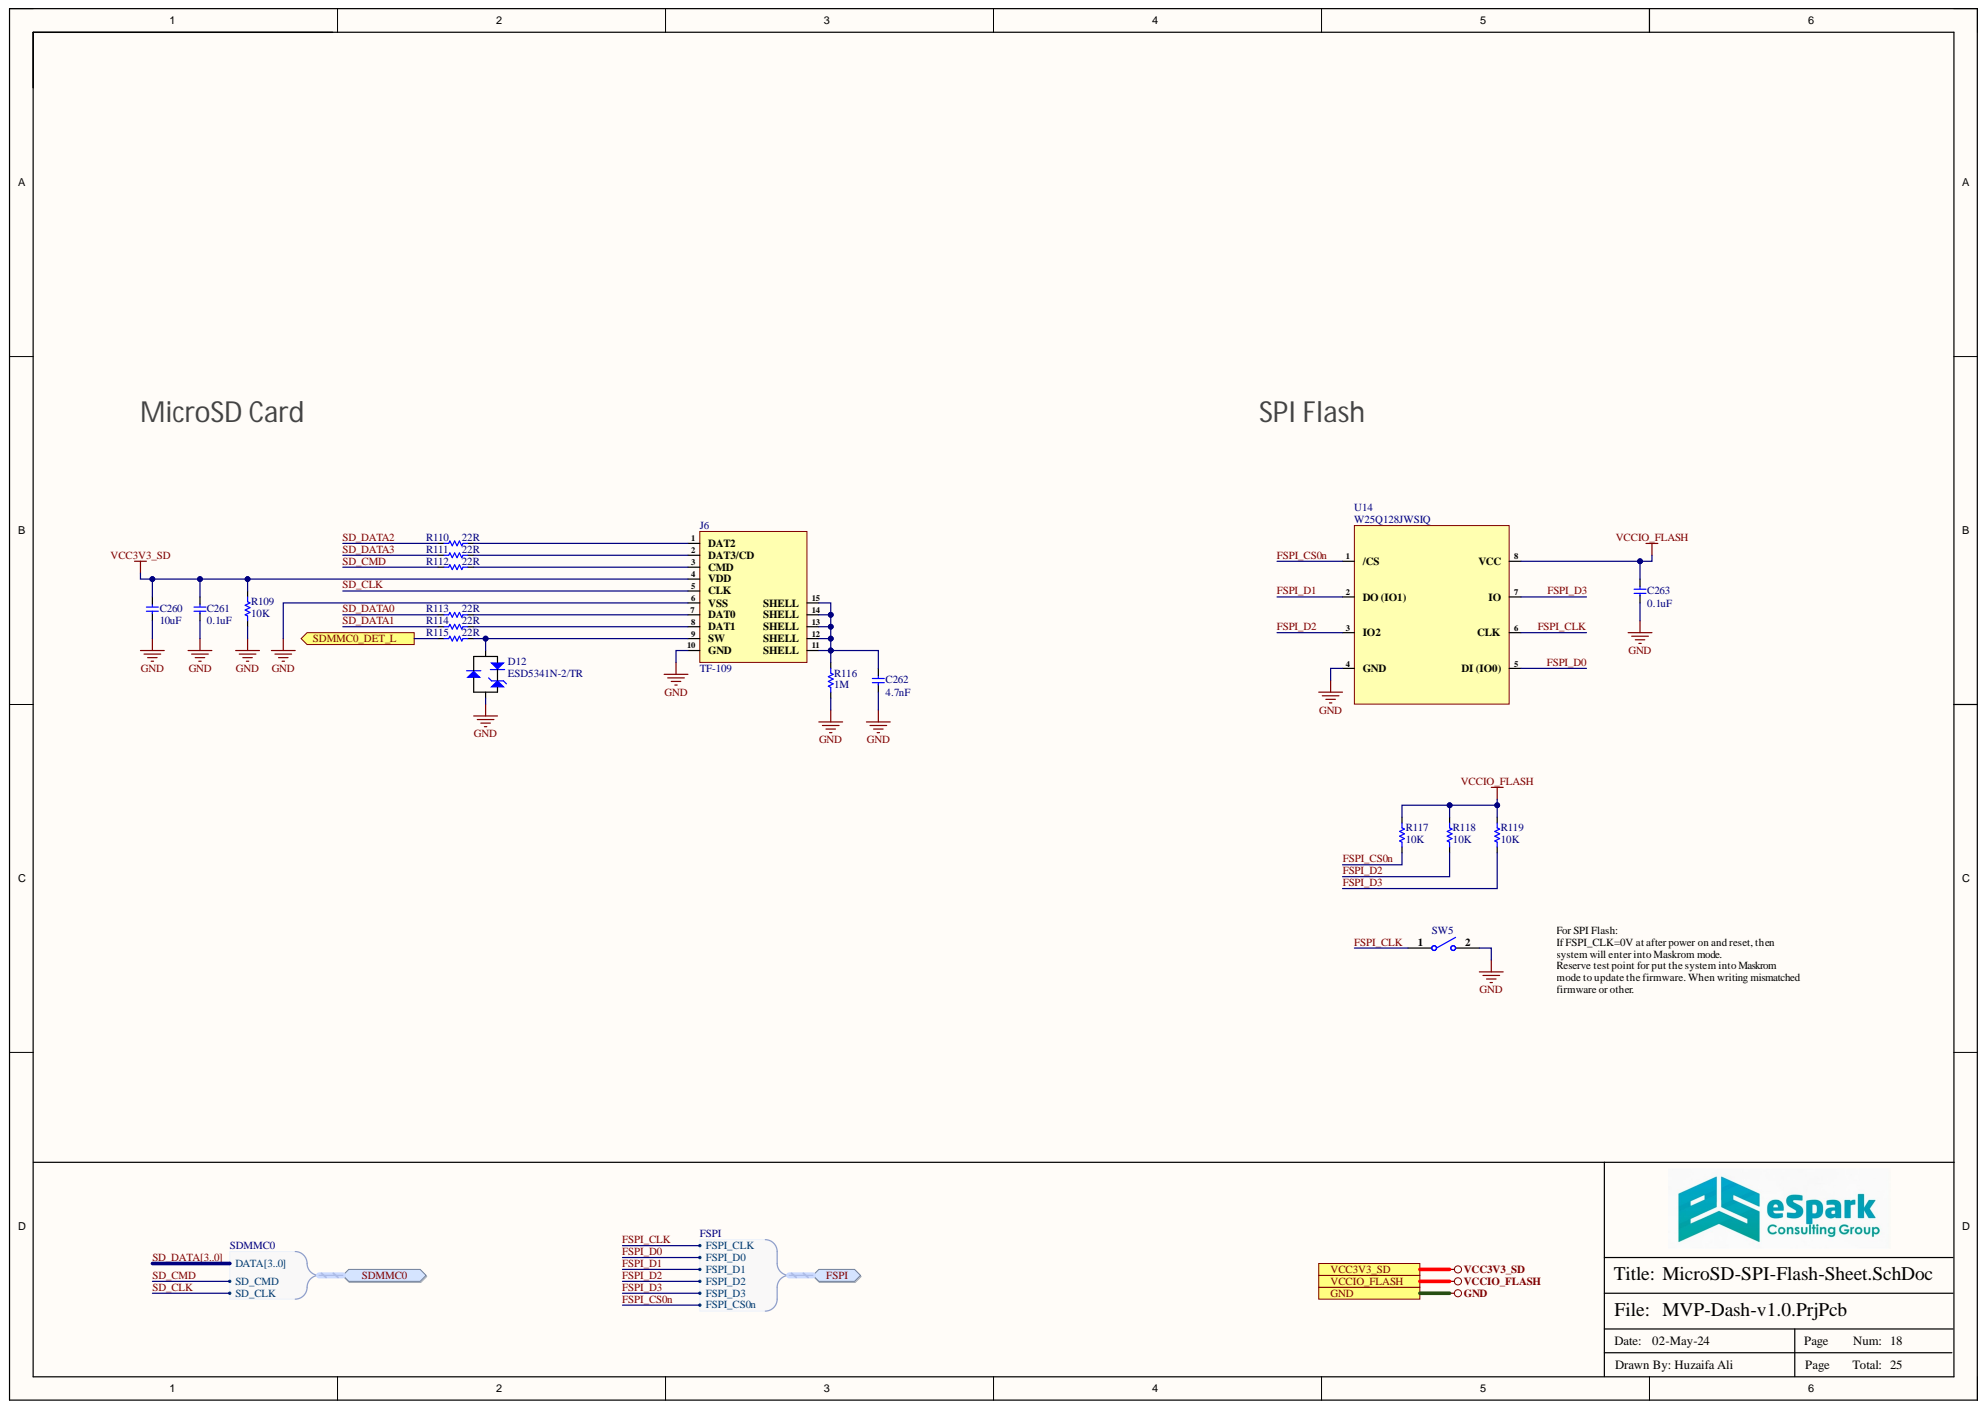
[picture p113: page 18]

For SPI Flash:
If FSPI_CLK=0V at after power on and reset, then
system will enter into Maskrom mode.
Reserve test point for put the system into Maskrom
mode to update the firmware. When writing mismatched
firmware or other.

MicroSD-SPI-Flash-Sheet.SchDoc

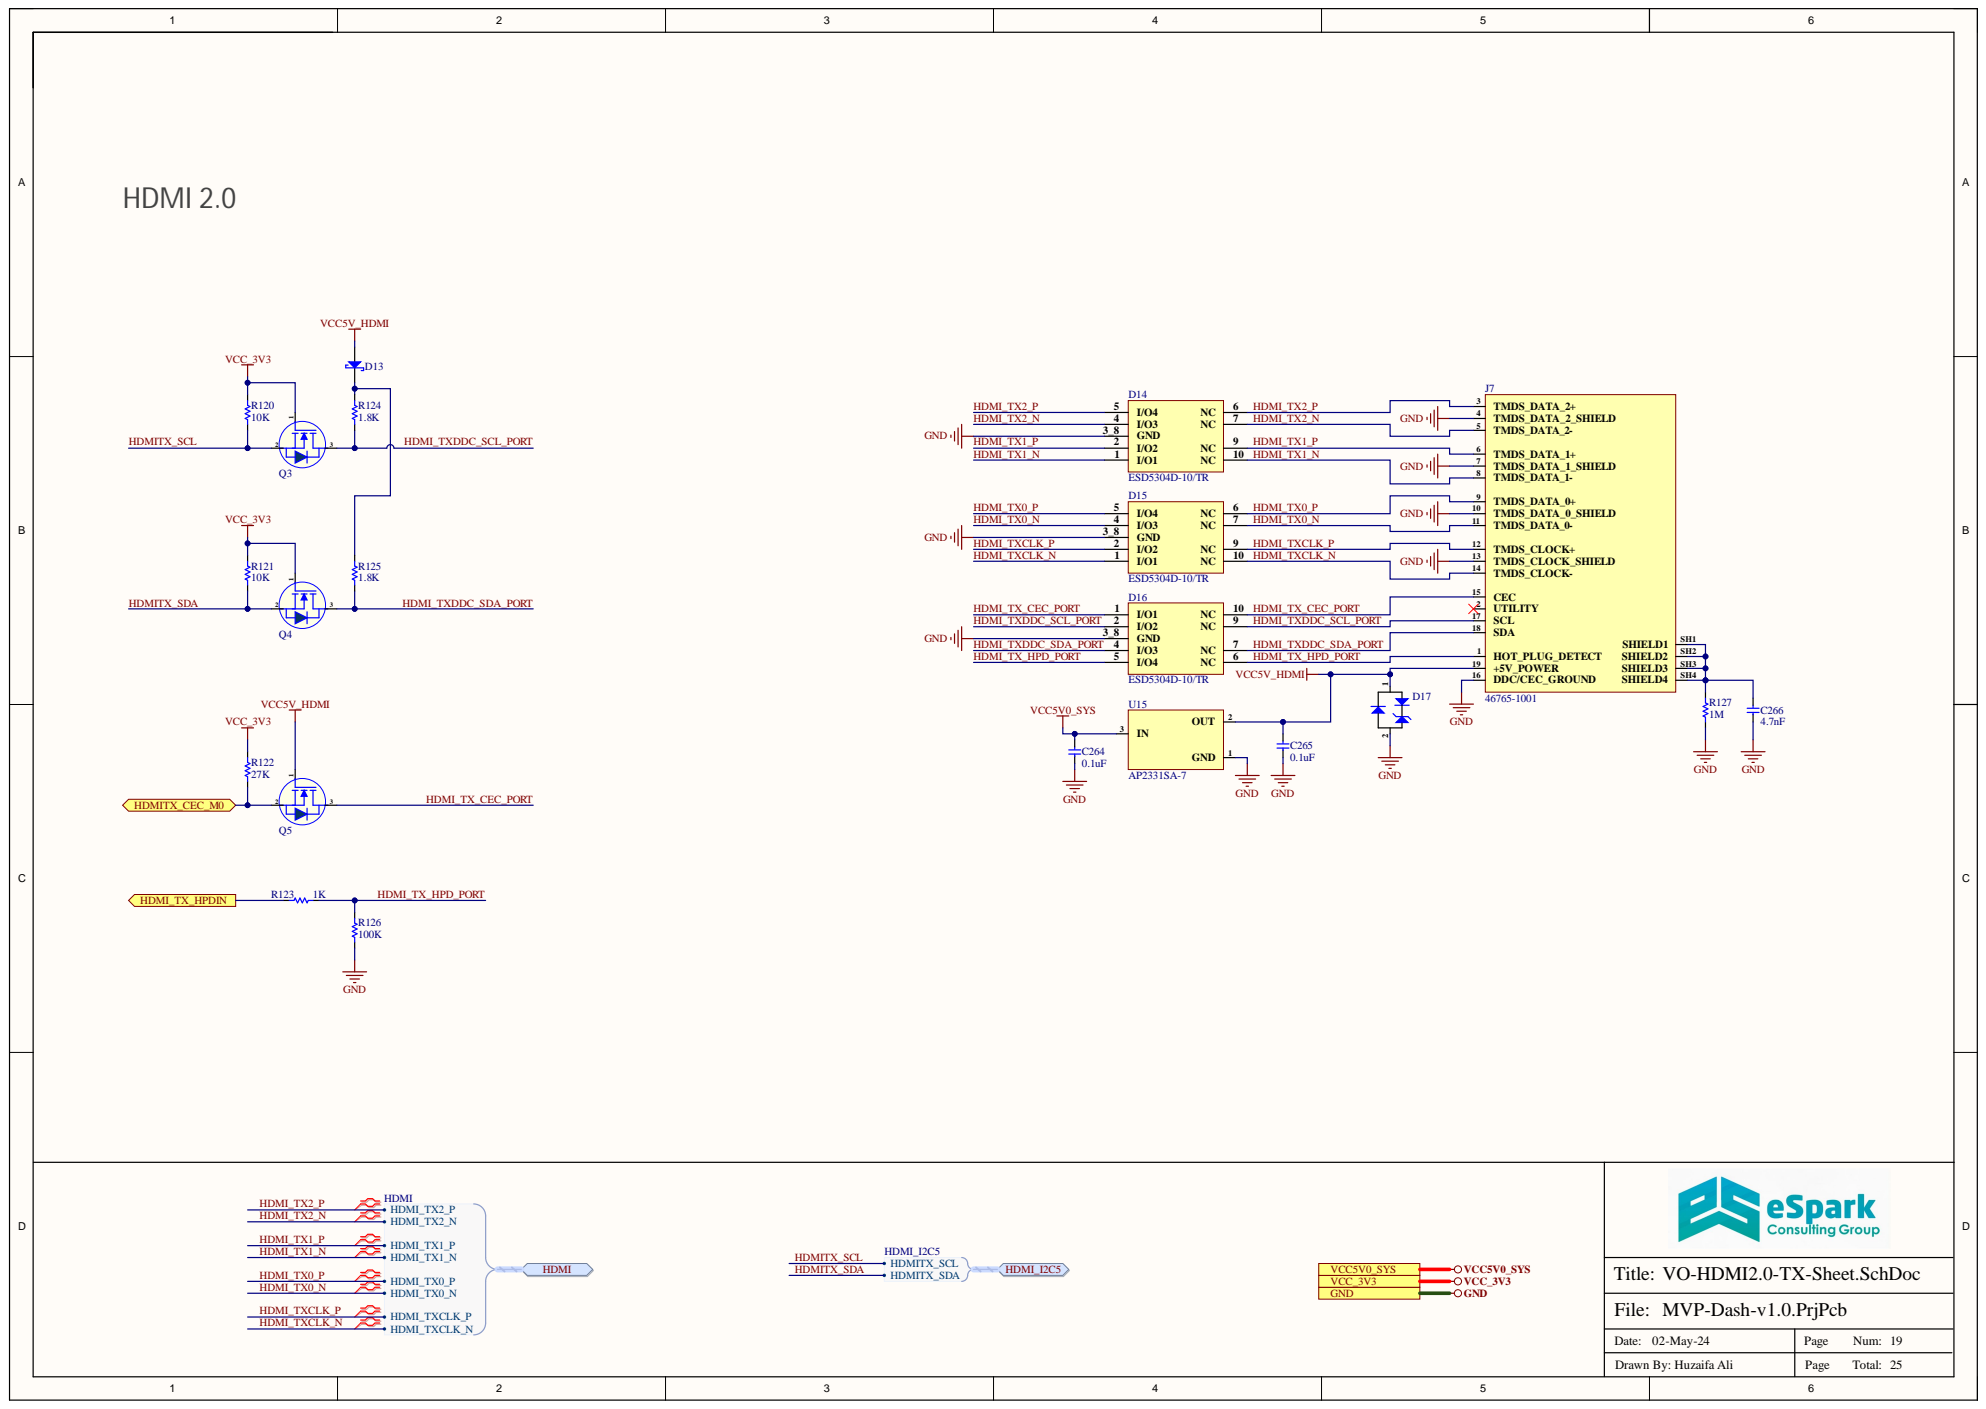
[picture p114: page 19]

UTILITY 2

SDA 18

VO-HDMI2.0-TX-Sheet.SchDoc

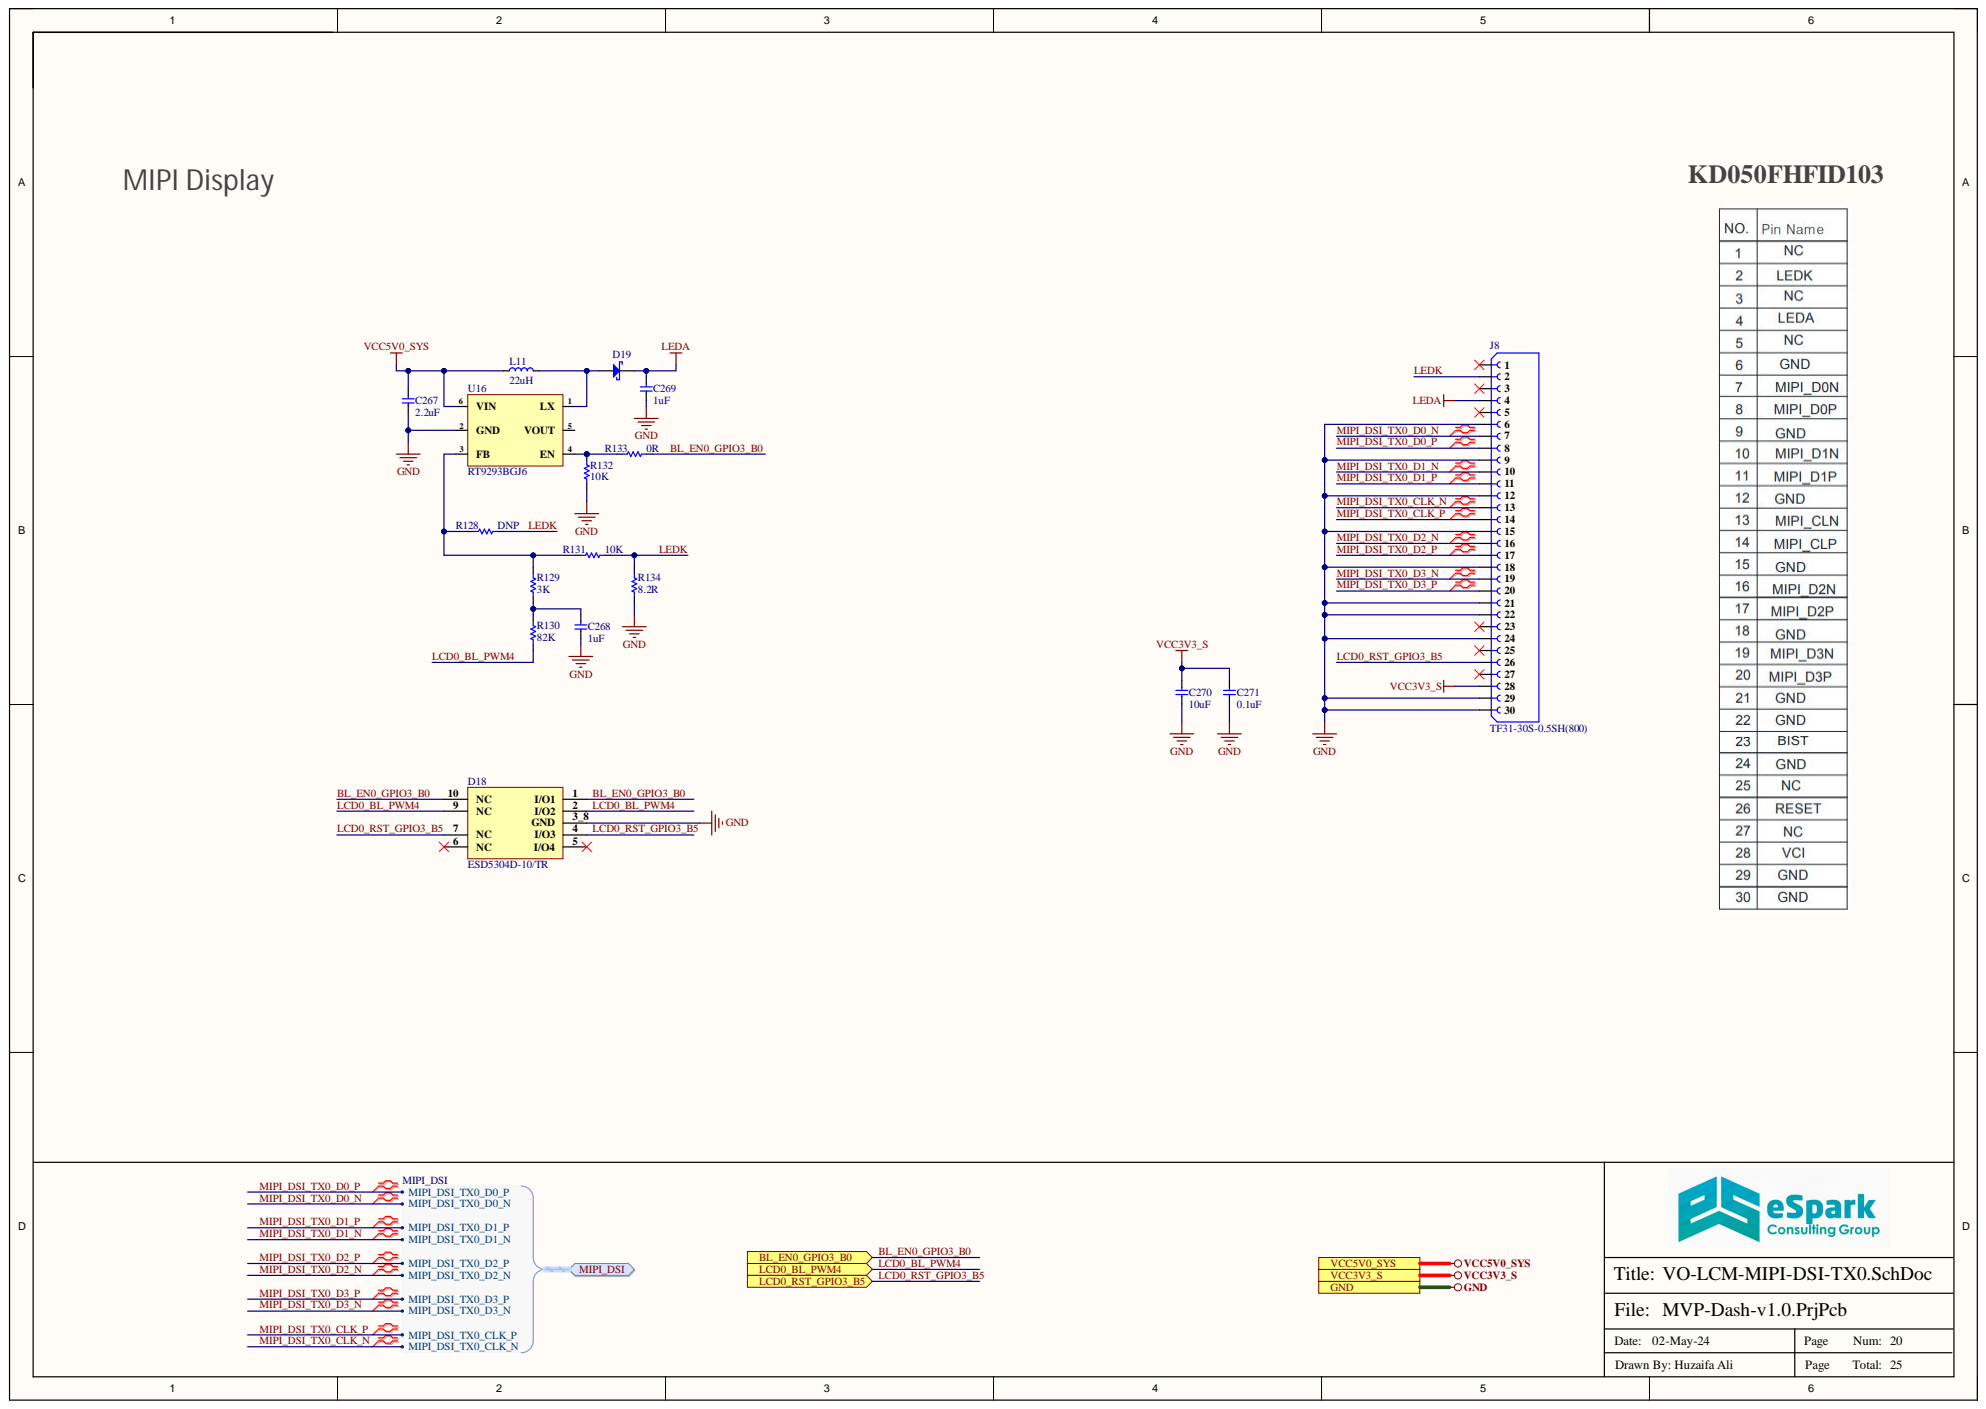
[picture p115: page 20]

VO-LCM-MIPI-DSI-TX0.SchDoc

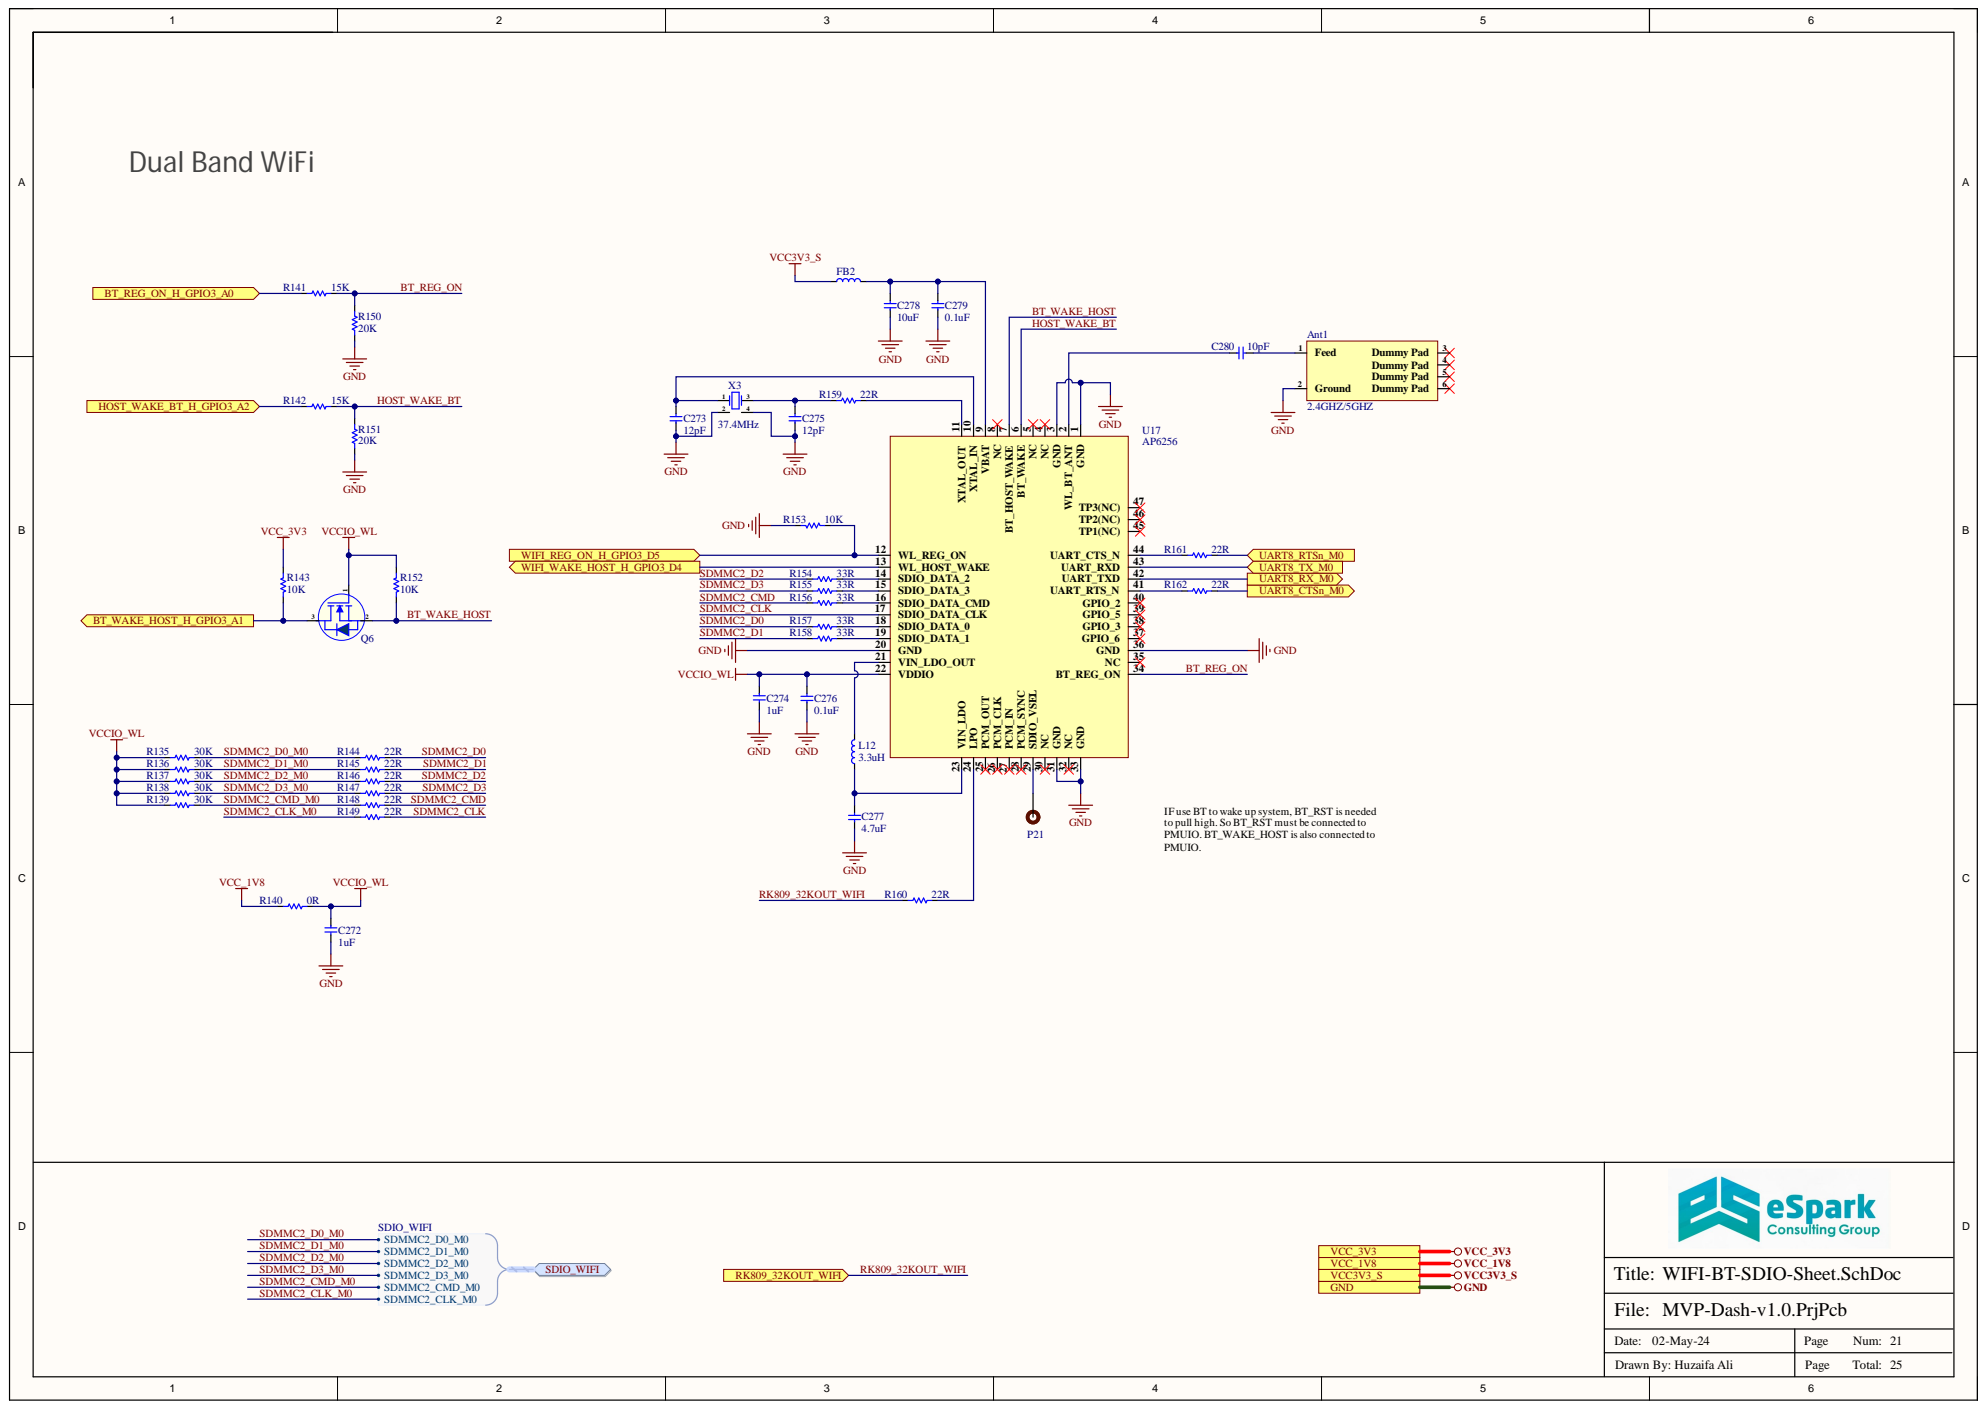
[picture p116: page 21]

GND 1 WL_BT_ANT 2 GND 3 NC 4 NC 5 BT_WAKE 6 BT_HOST_WAKE 7 NC 8 VBAT 9 XTAL_IN 10 XTAL_OUT 11

IF use BT to wake up system, BT_RST is needed
to pull high. So BT_RST must be connected to
PMUIO. BT_WAKE_HOST is also connected to
PMUIO.

WIFI-BT-SDIO-Sheet.SchDoc

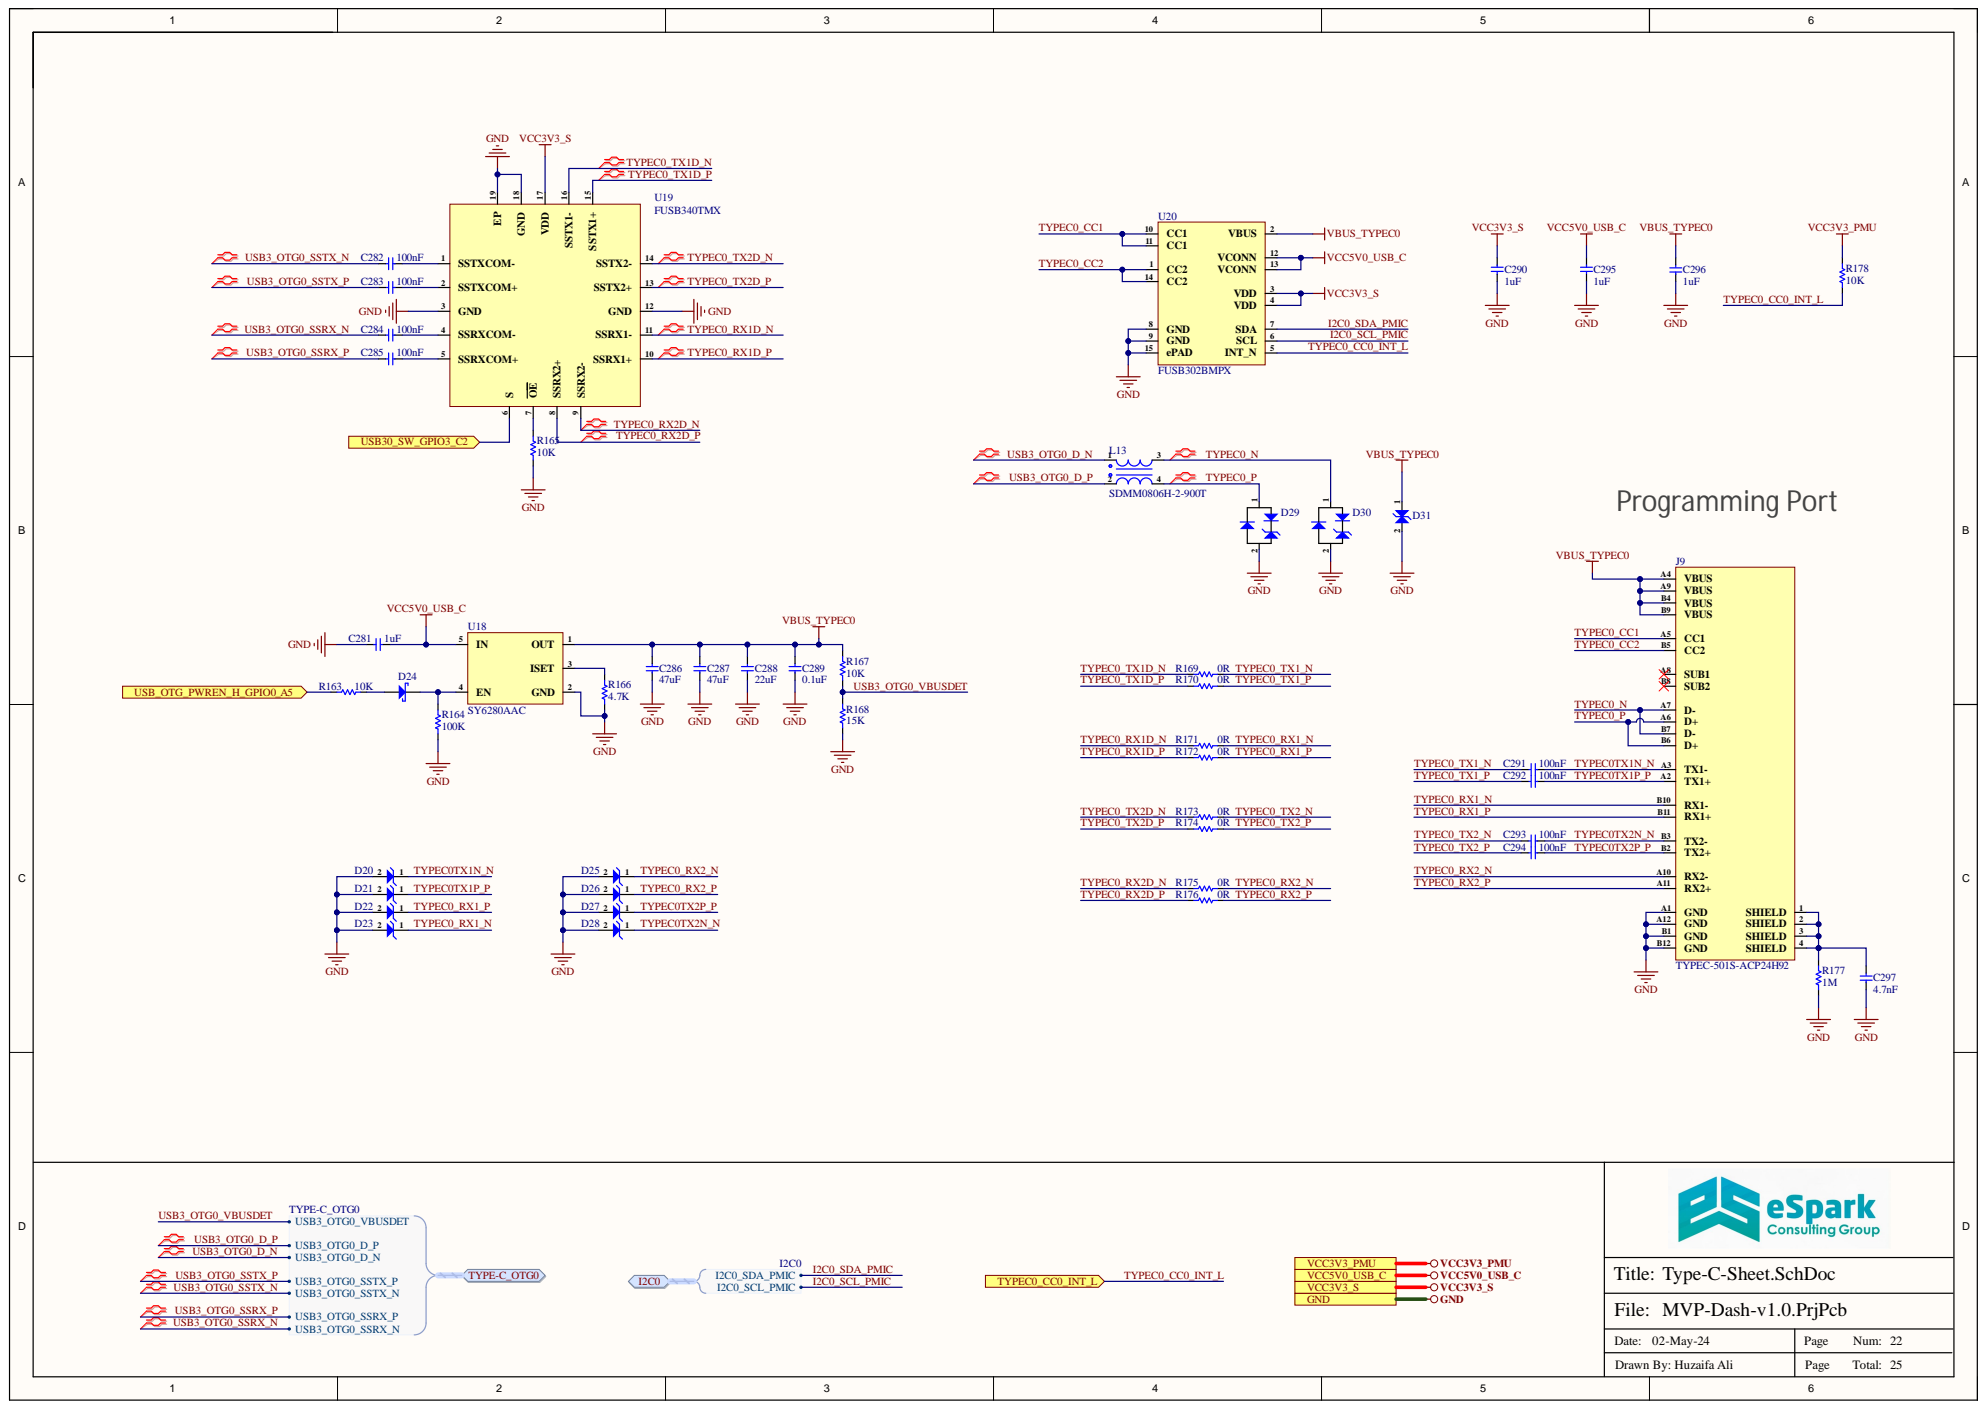
[picture p117: page 22]

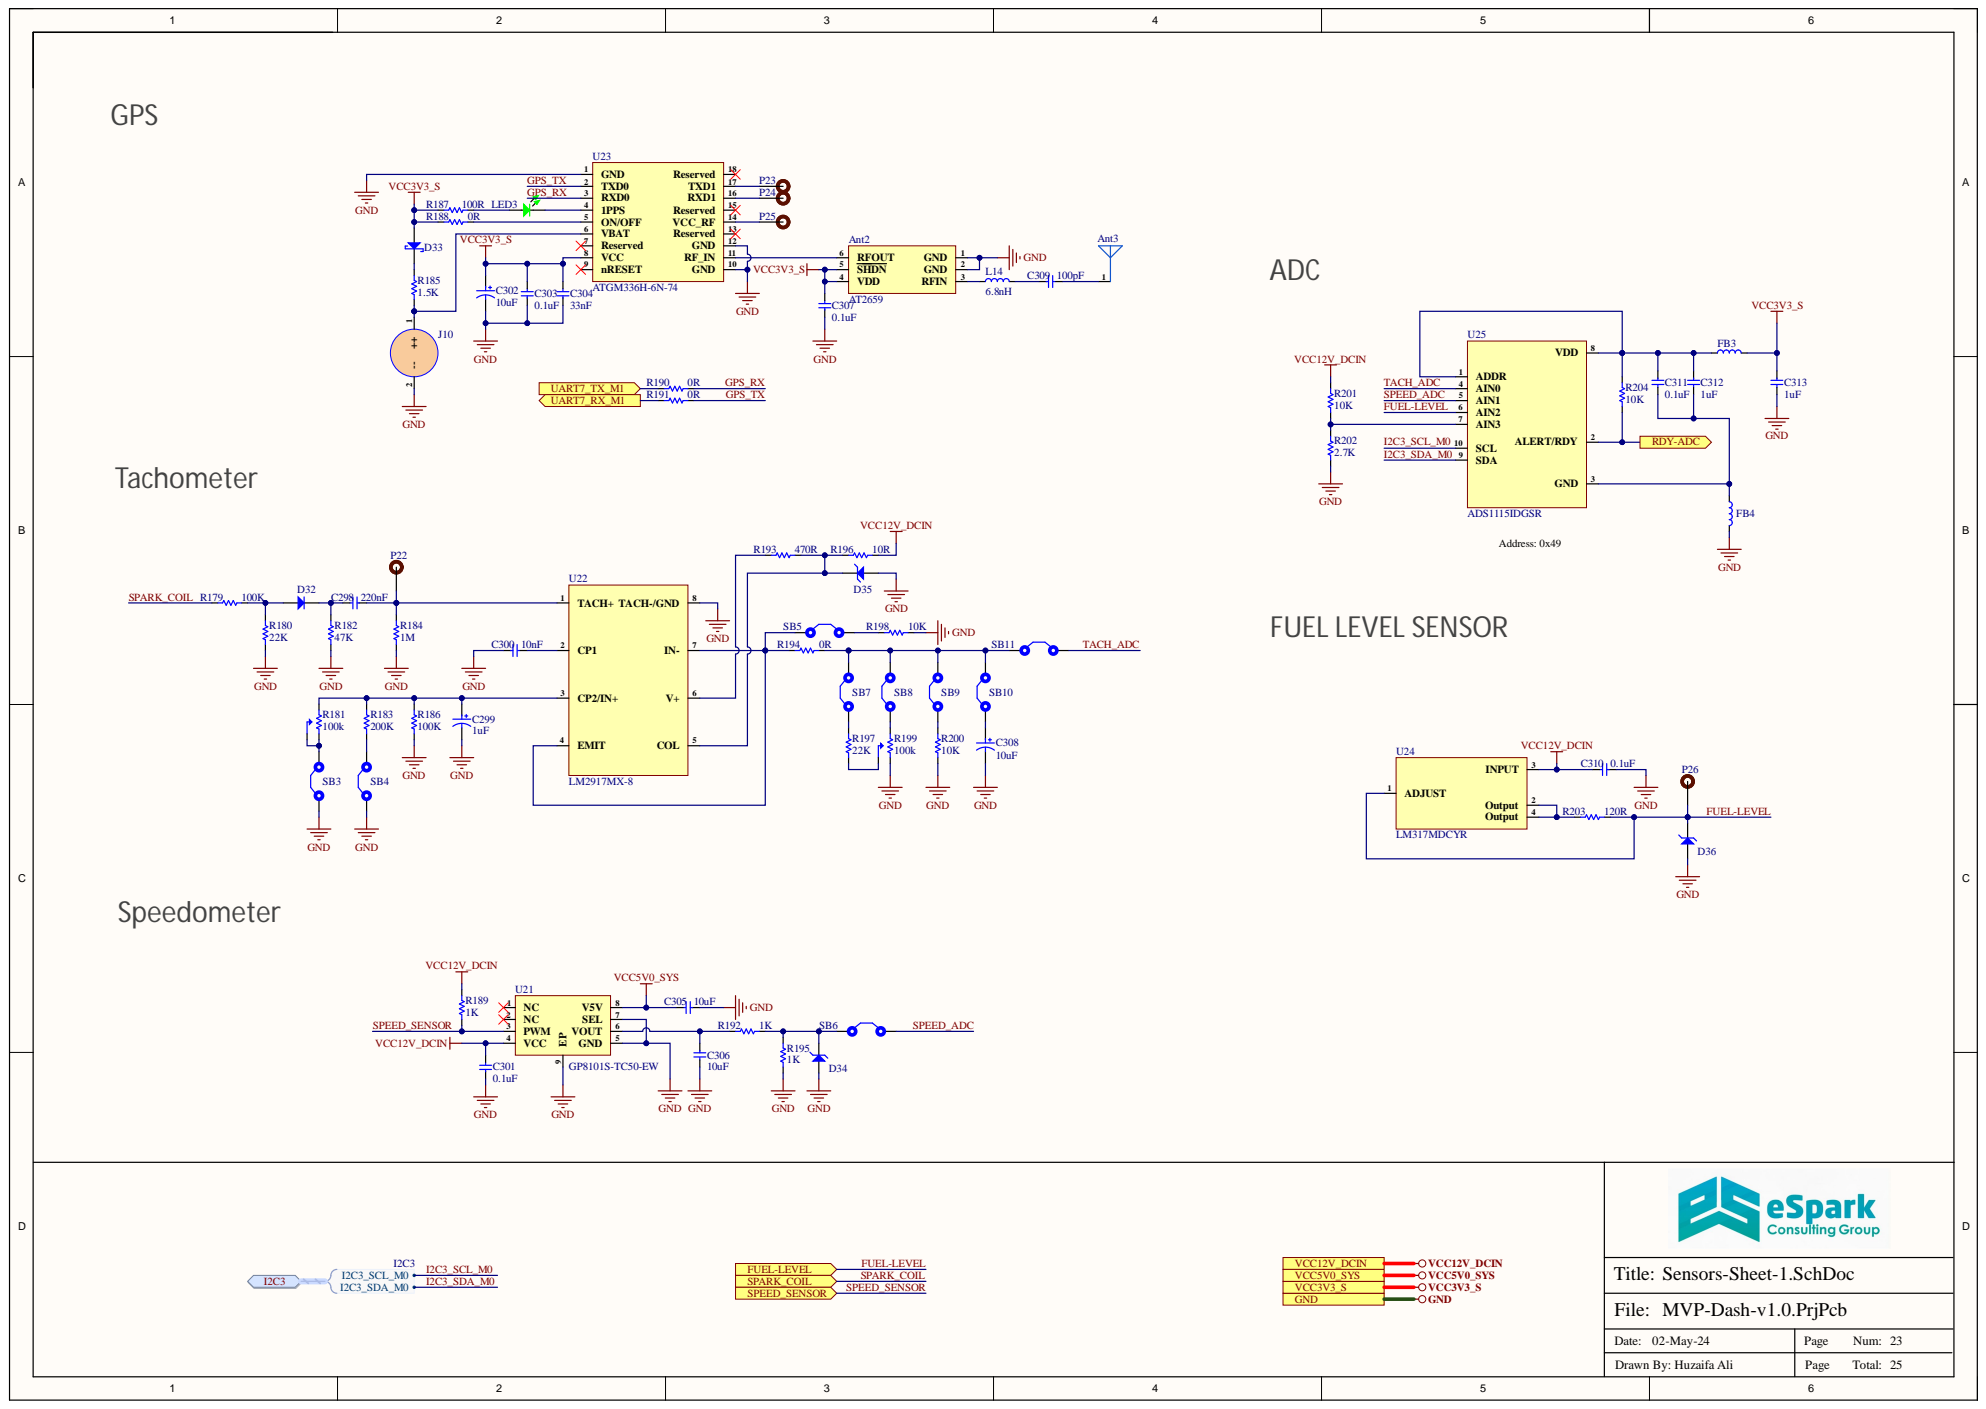
[picture p118: page 23]

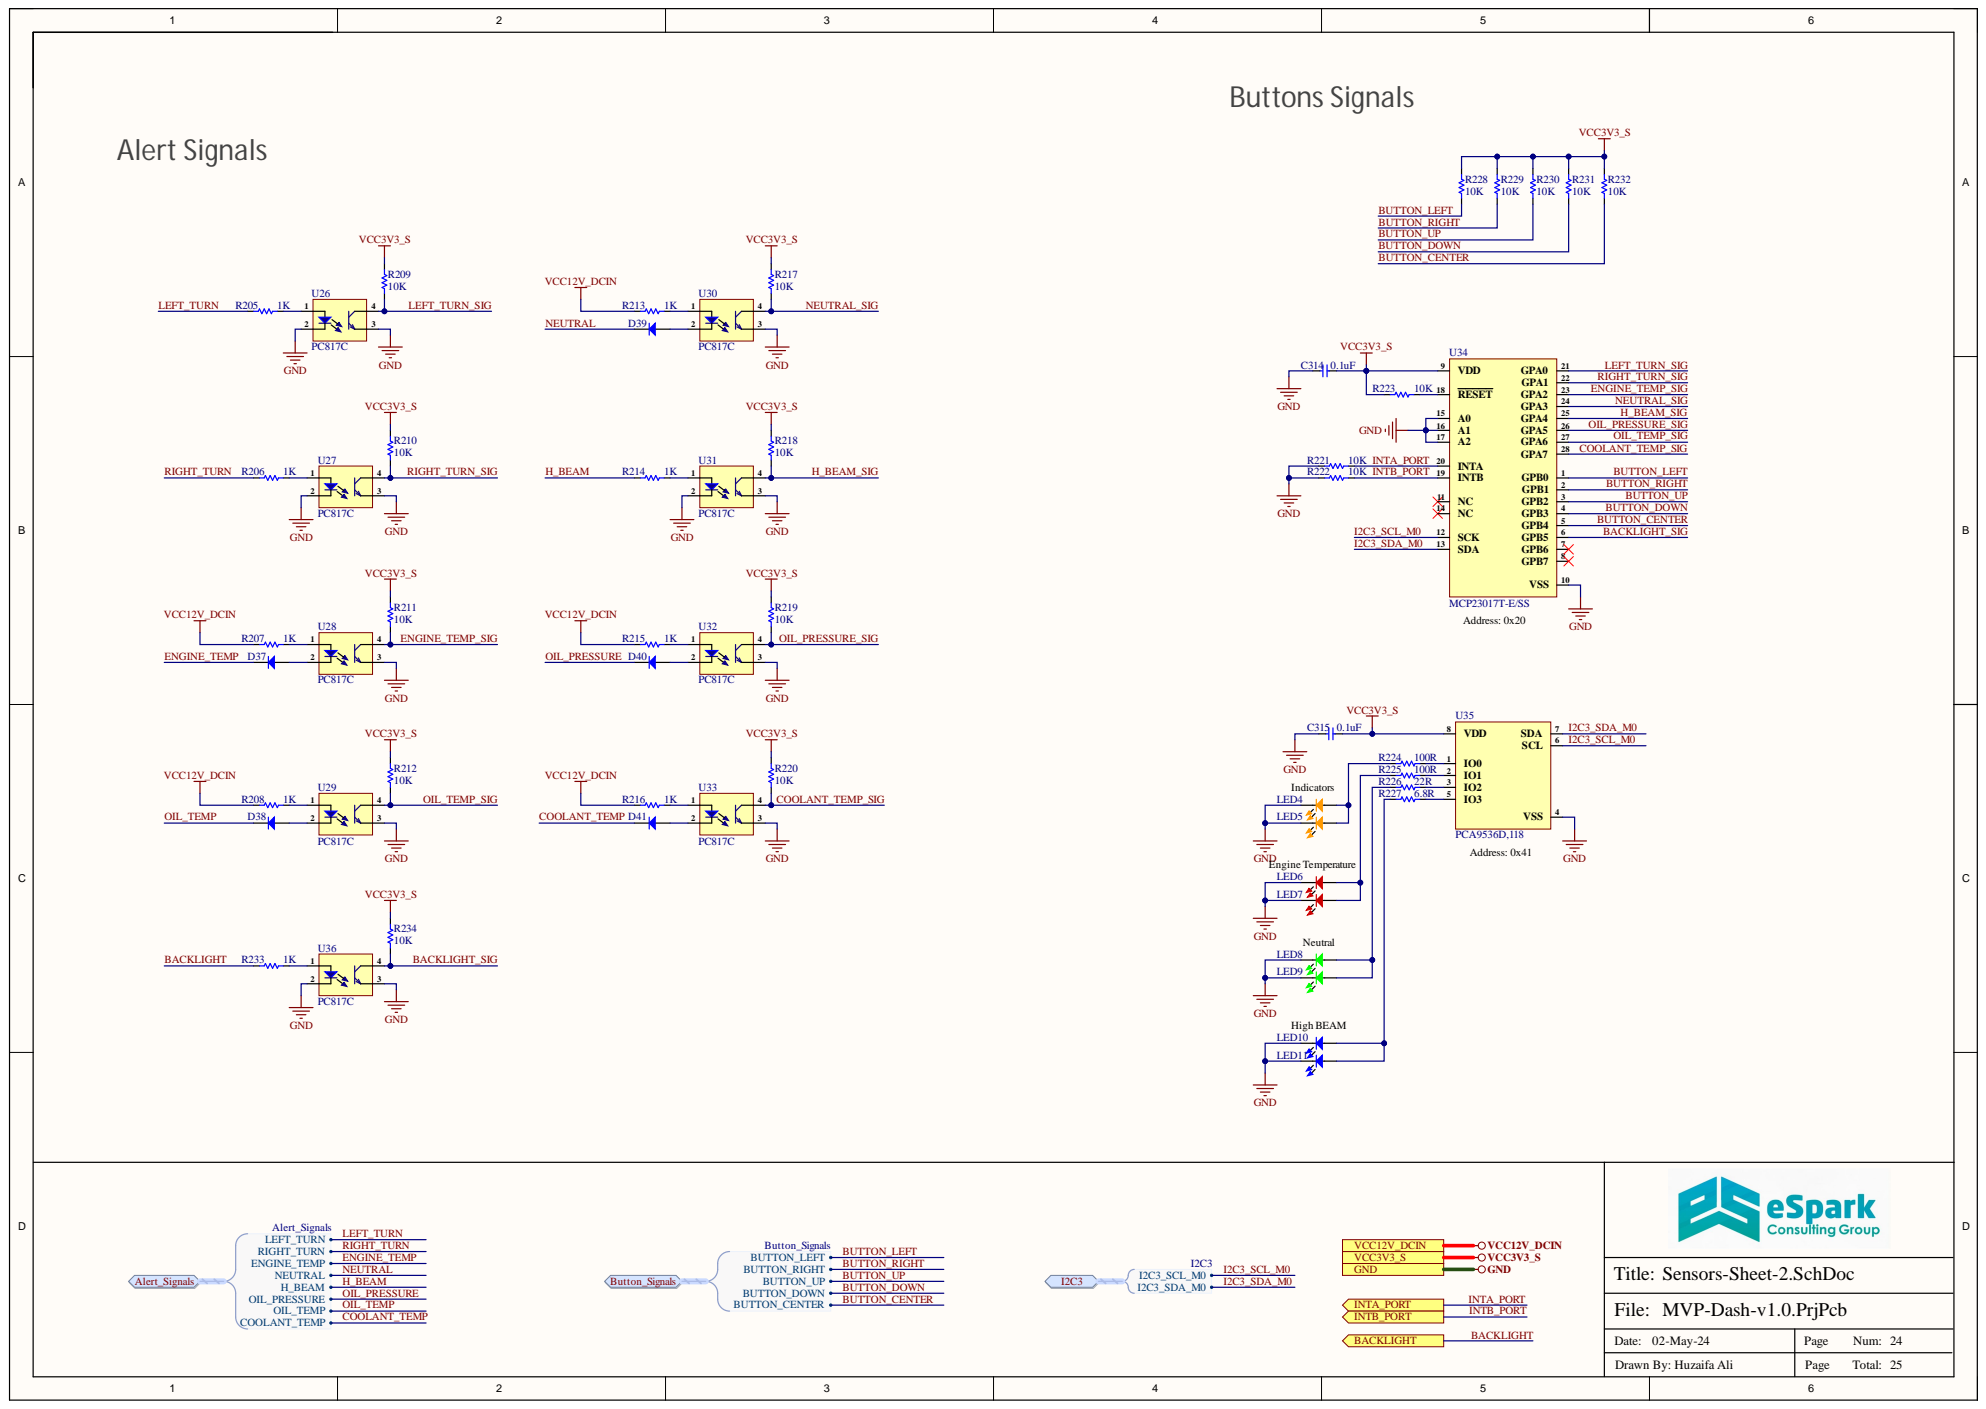
[picture p119: page 24]

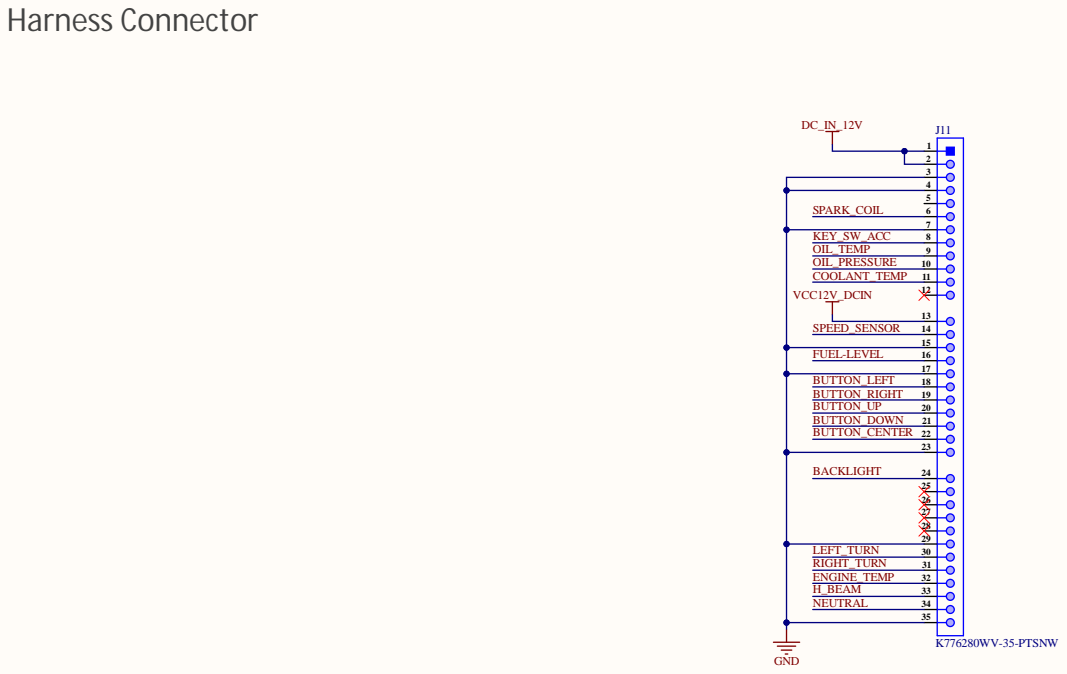
[picture p120: page 25]

SPARK_COIL | 5

FUEL-LEVEL | 16 17

BUTTON_LEFT BUTTON_RIGHT BUTTON_UP BUTTON_DOWN BUTTON_CENTER | 18 19 20 21 22 23

BACKLIGHT | 24 25
