eSpark-Consulting-Group/alastair-barones-salpha/Design-Files/Pukk-Sensor-Module-v1.0/Deliverables/_Schematics/Pukk-Sensor-Module-v1.0.pdf

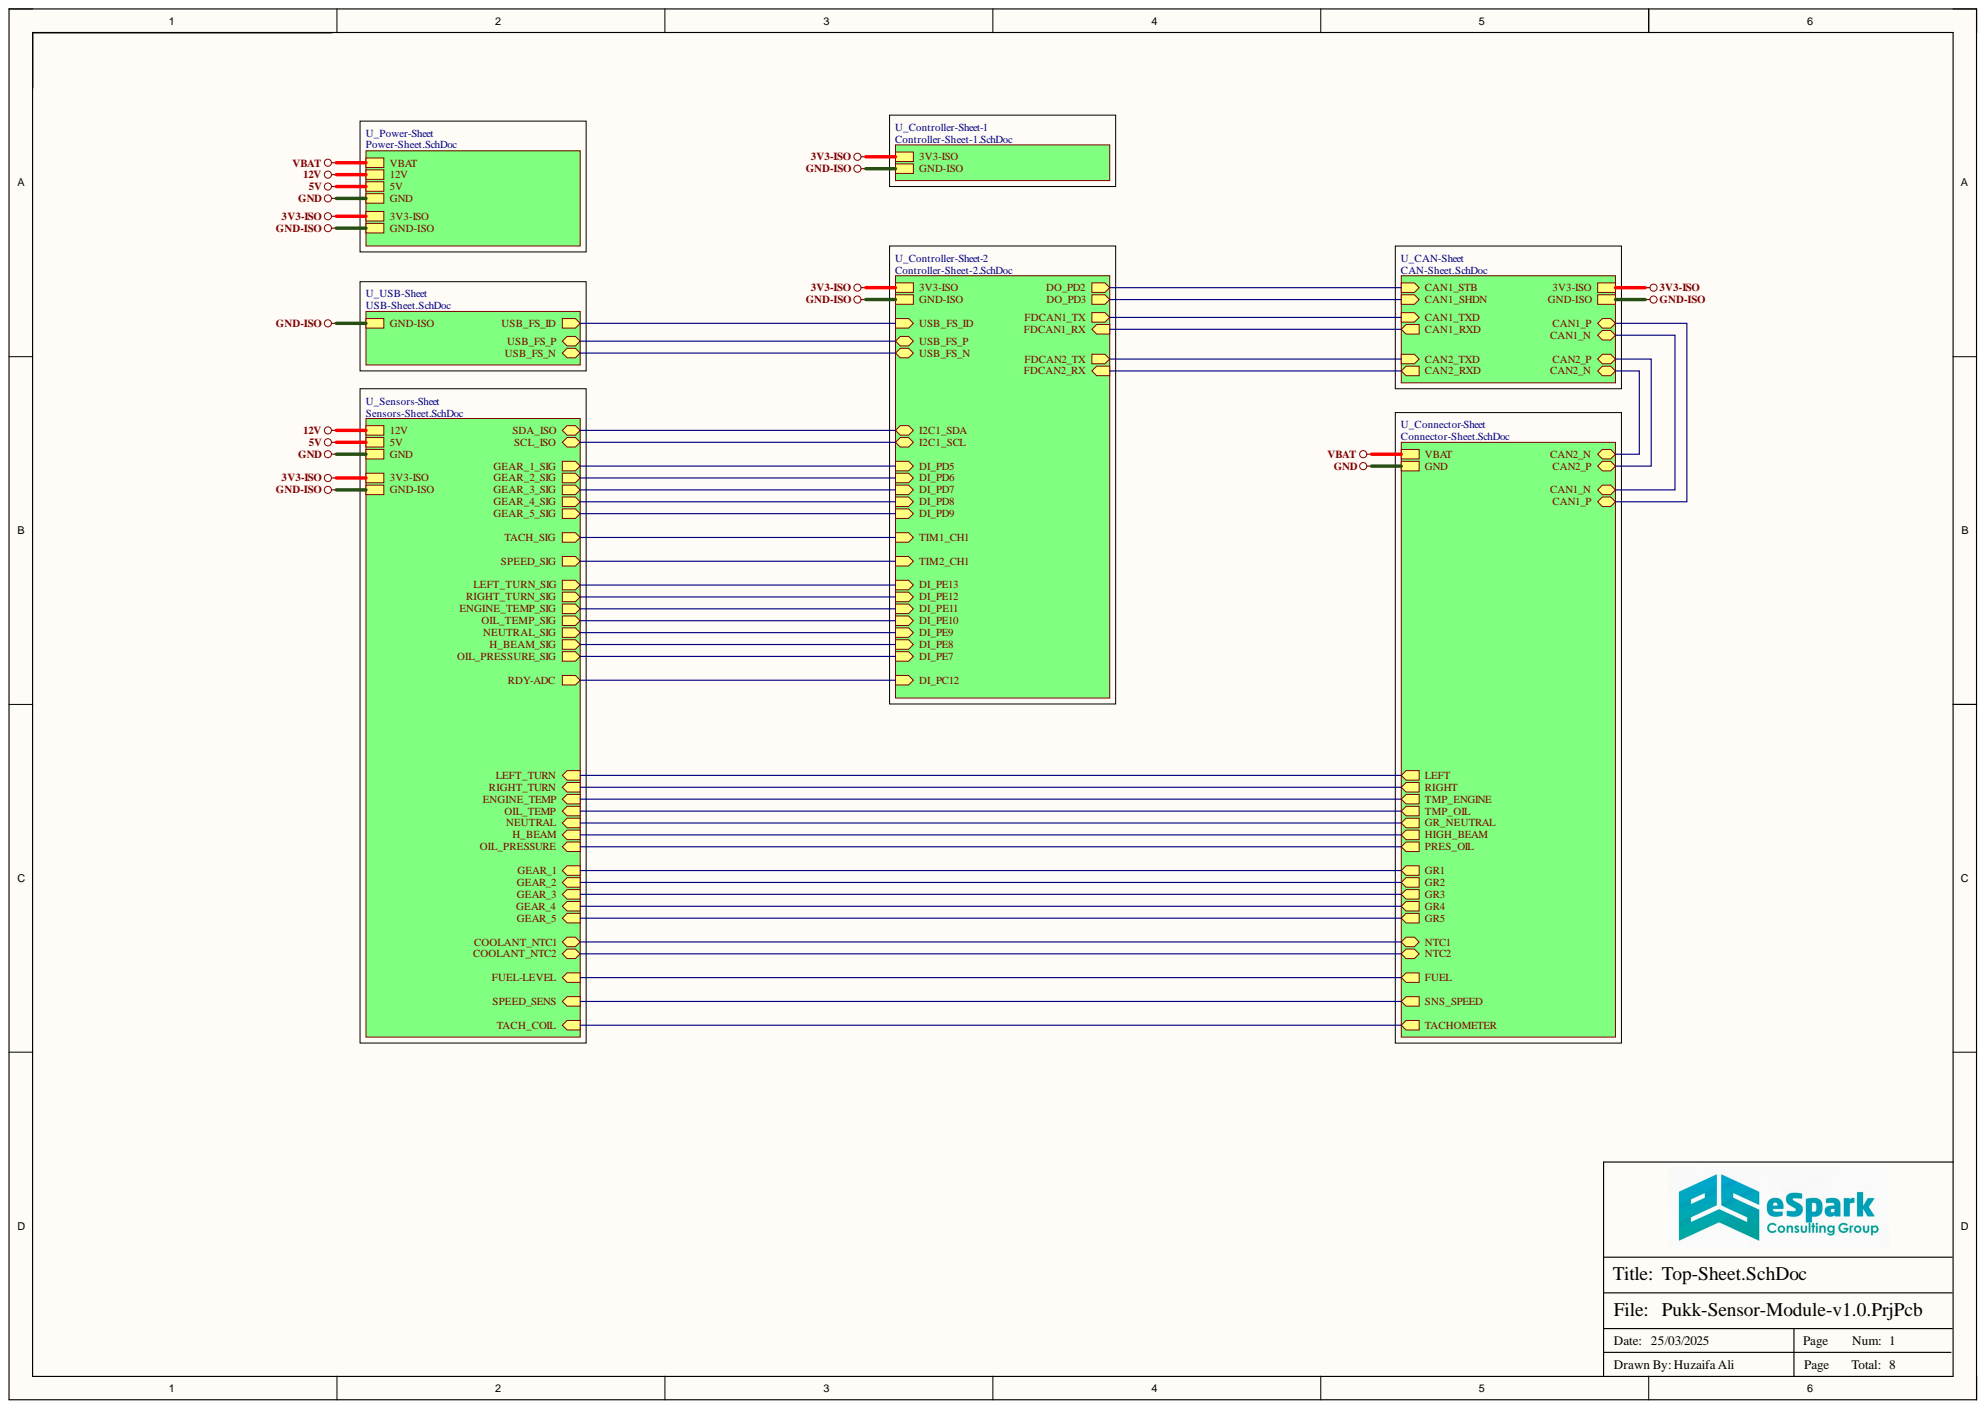
[picture p133: page 1]

Pukk-Sensor-Module-v1.0.PrjPcb

Date: 25/03/2025 | Page Num: 1

Drawn By: Huzaifa Ali | Total:

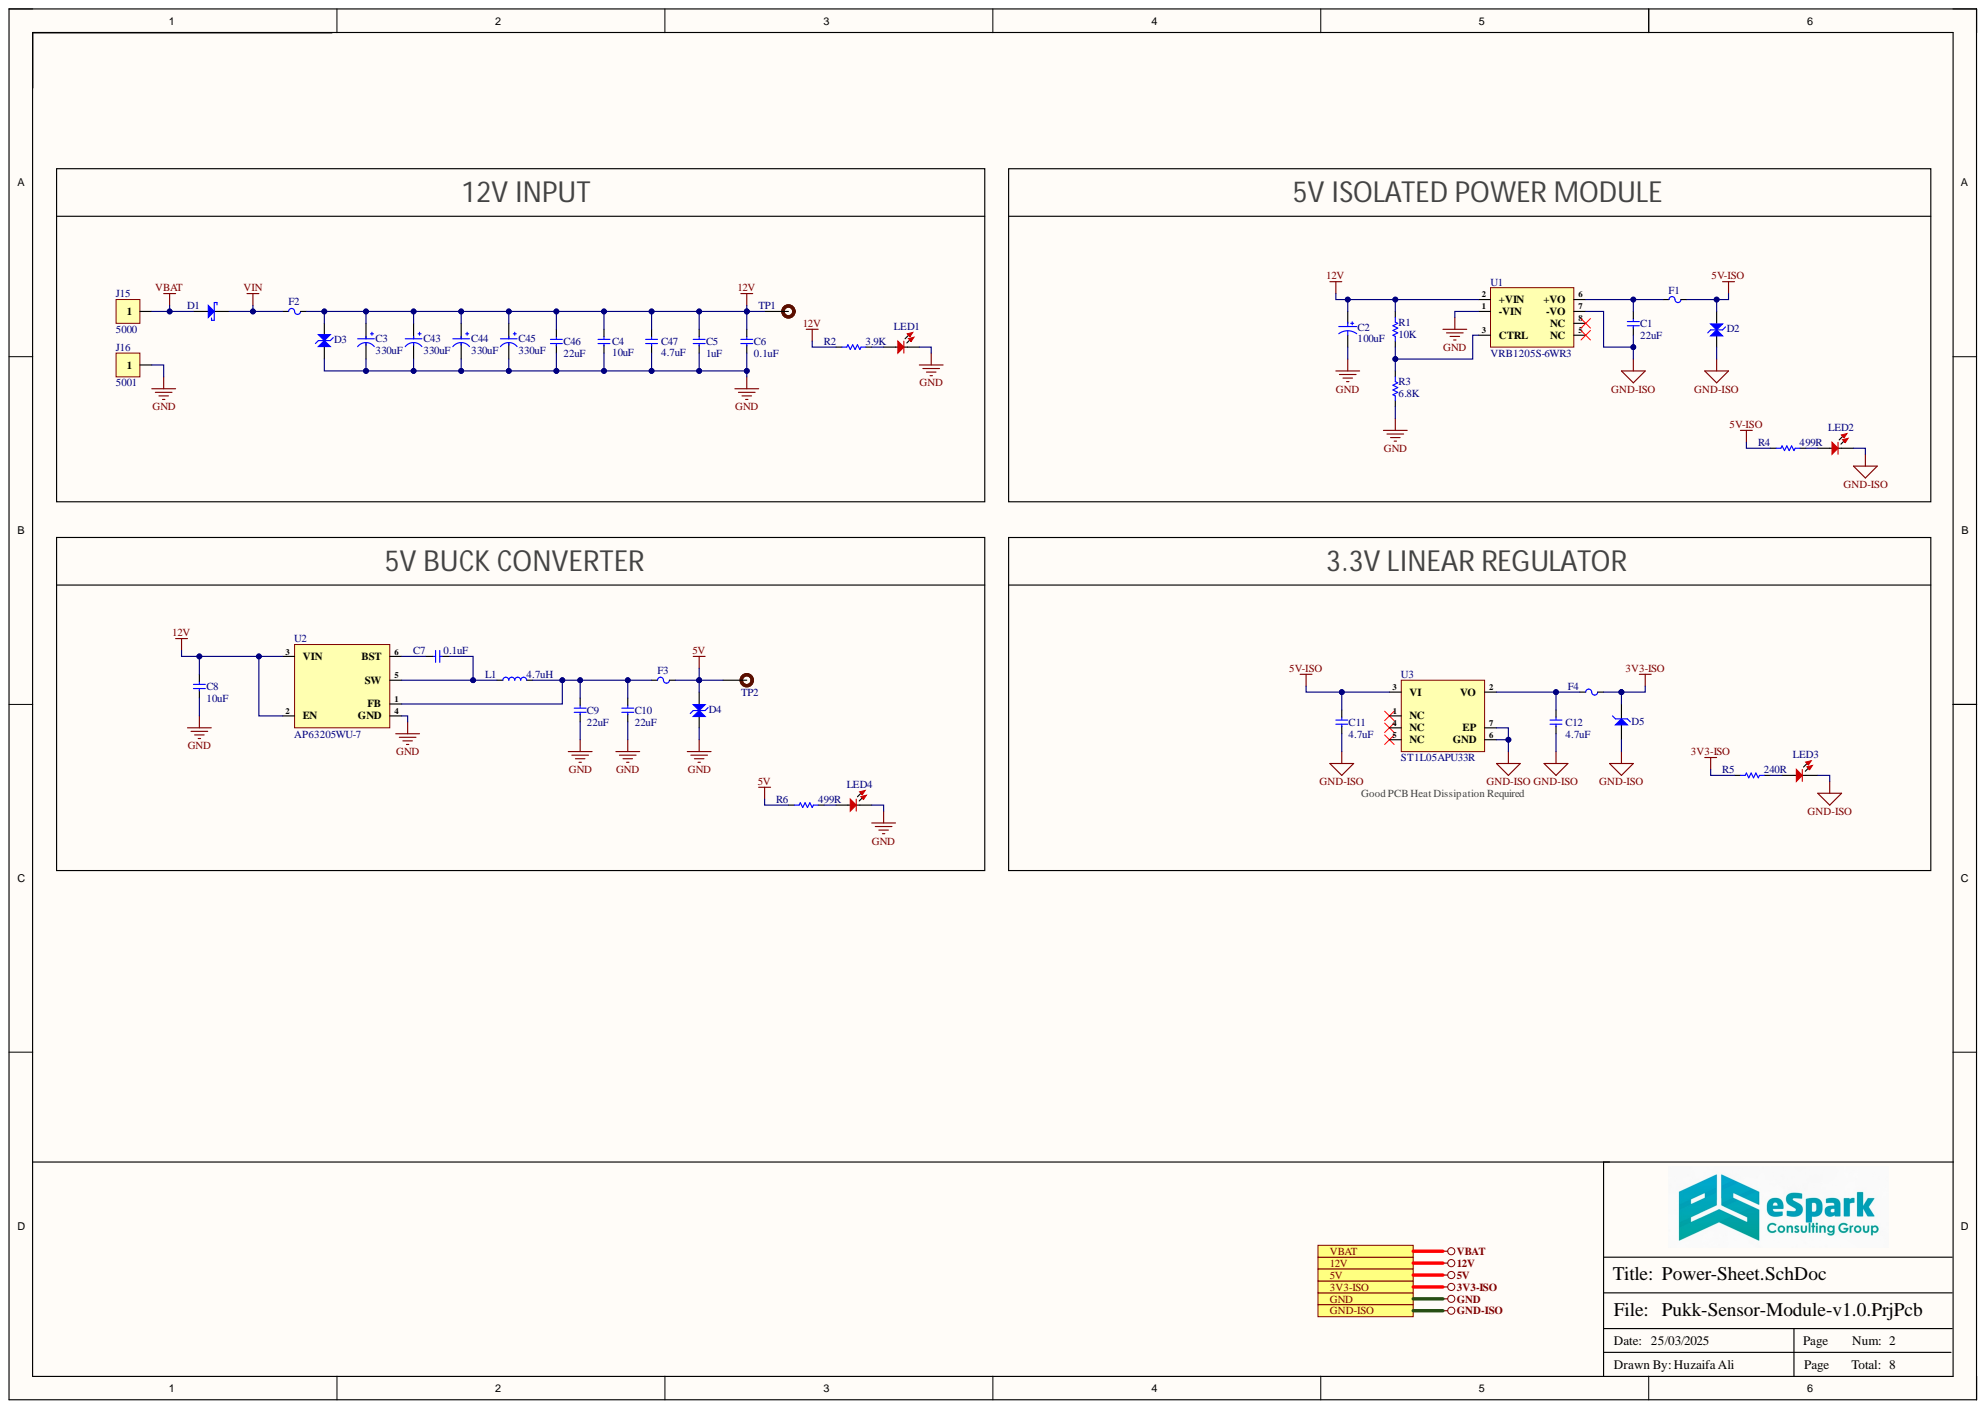
[picture p134: page 2]

Good PCB Heat Dissipation Required

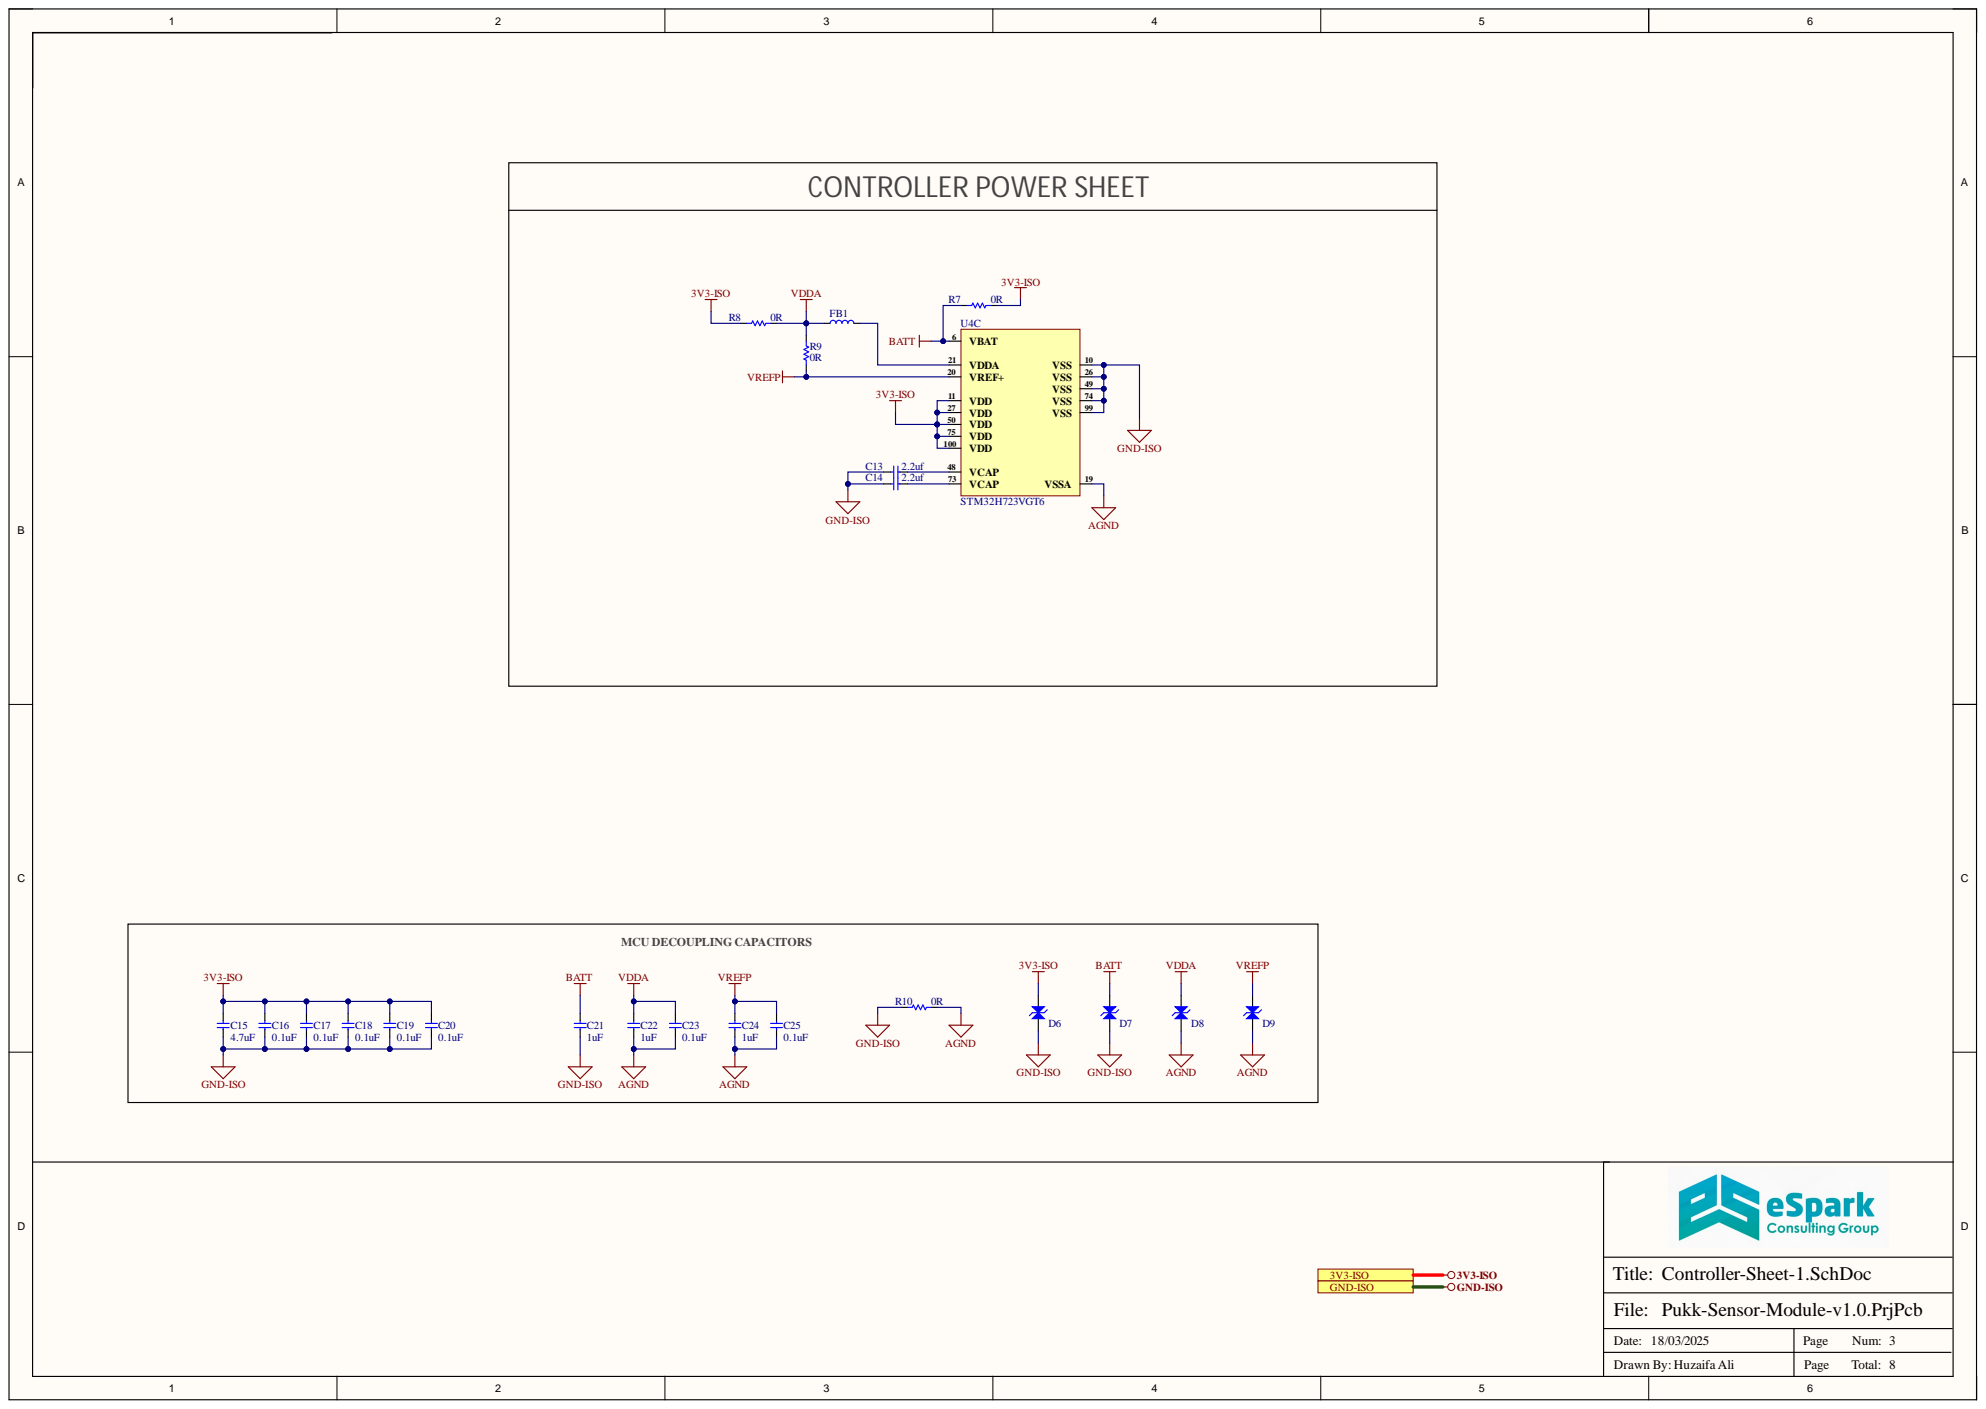
[picture p135: page 3]

VDD 27

VDD 75

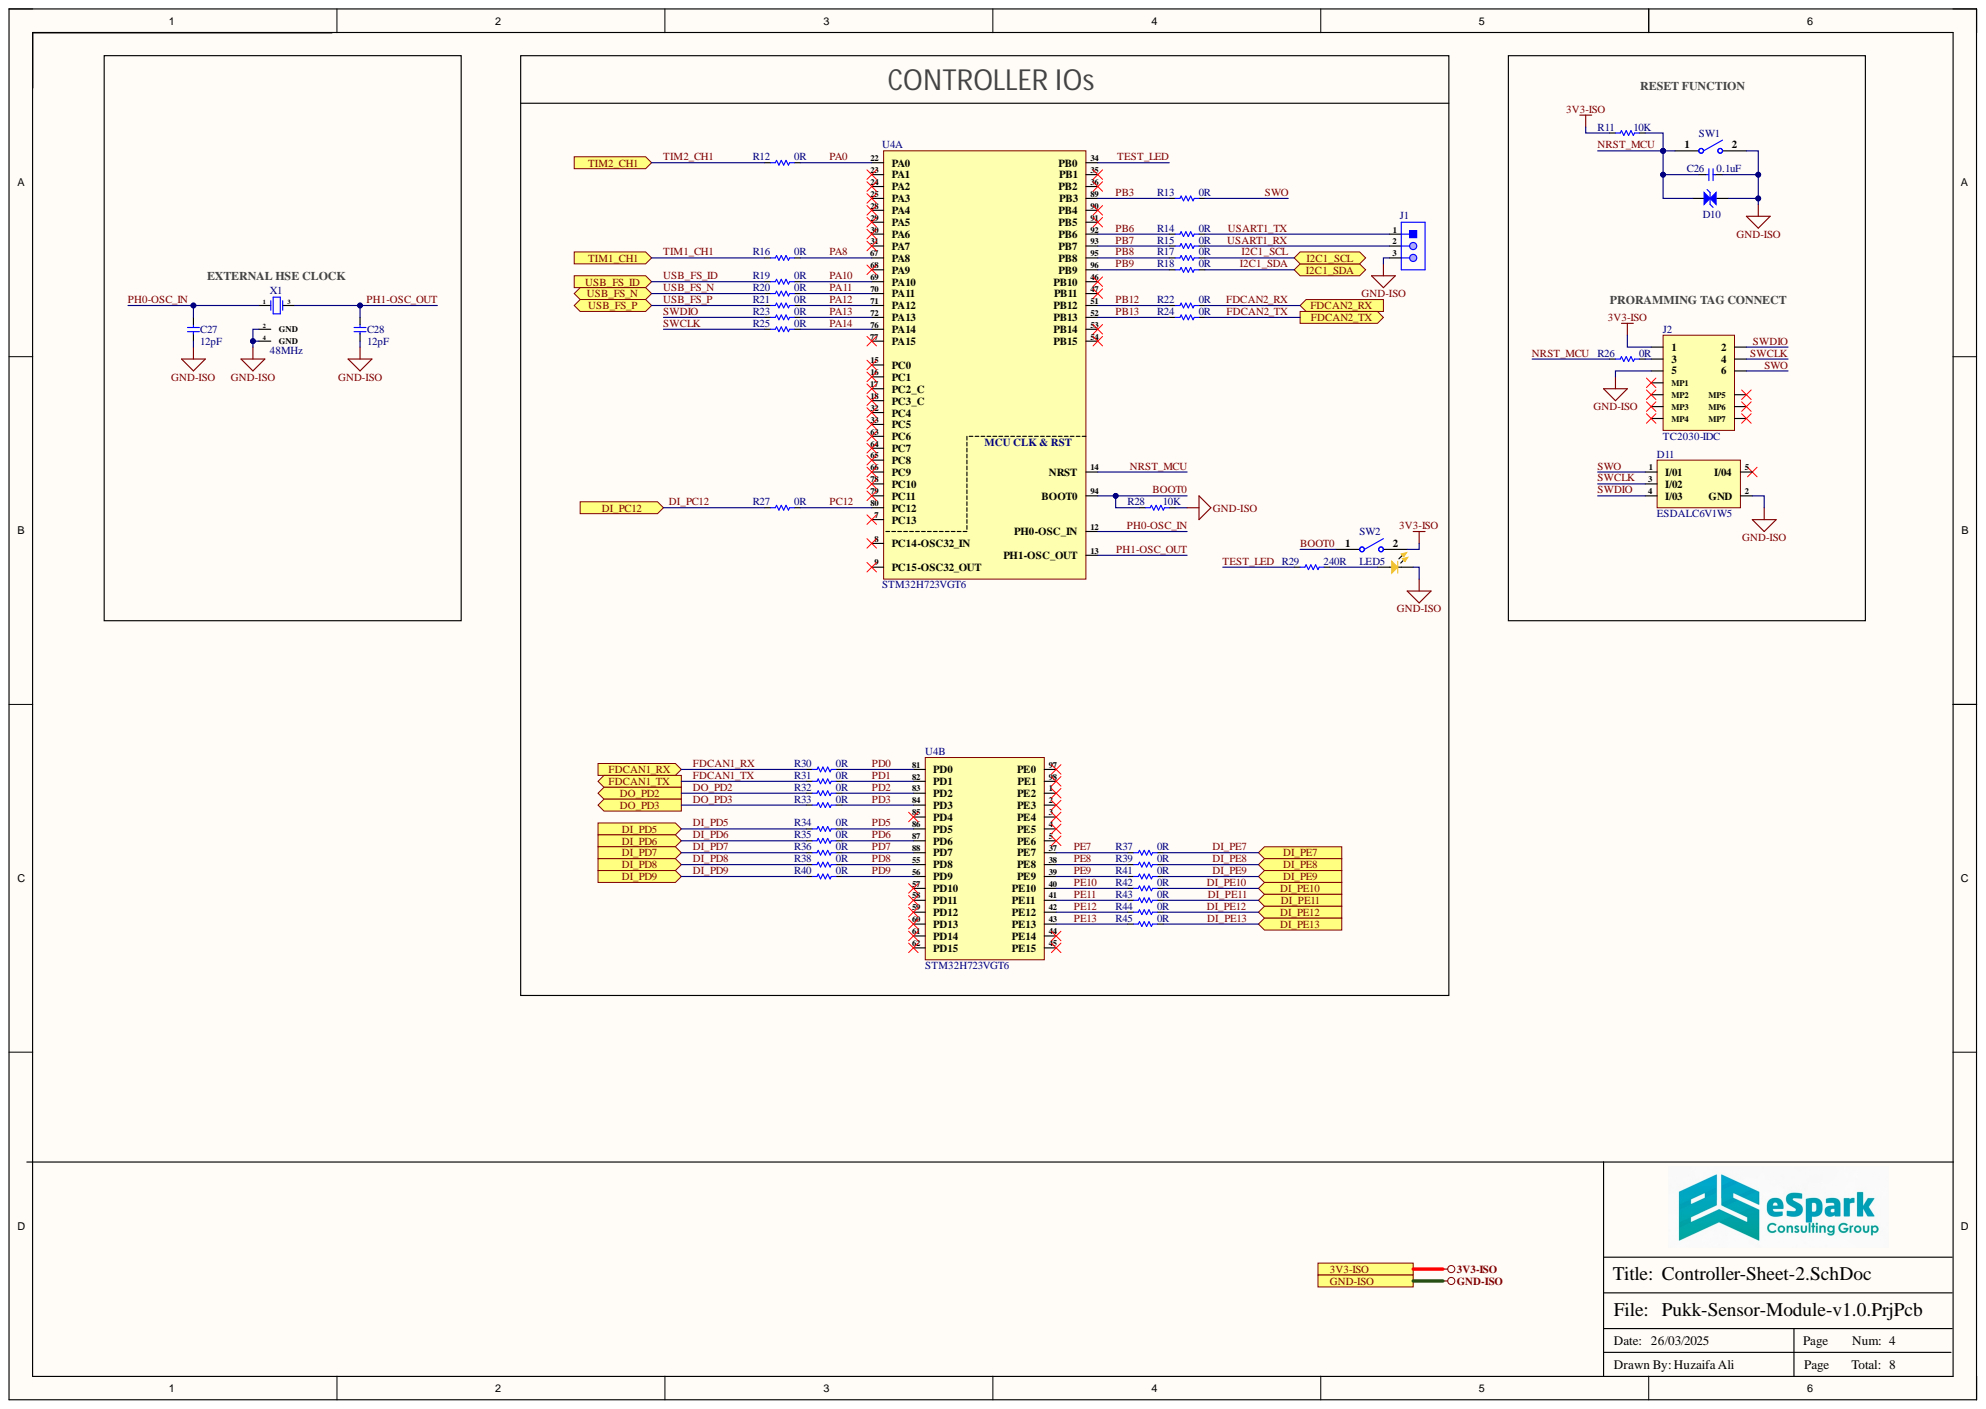
[picture p136: page 4]

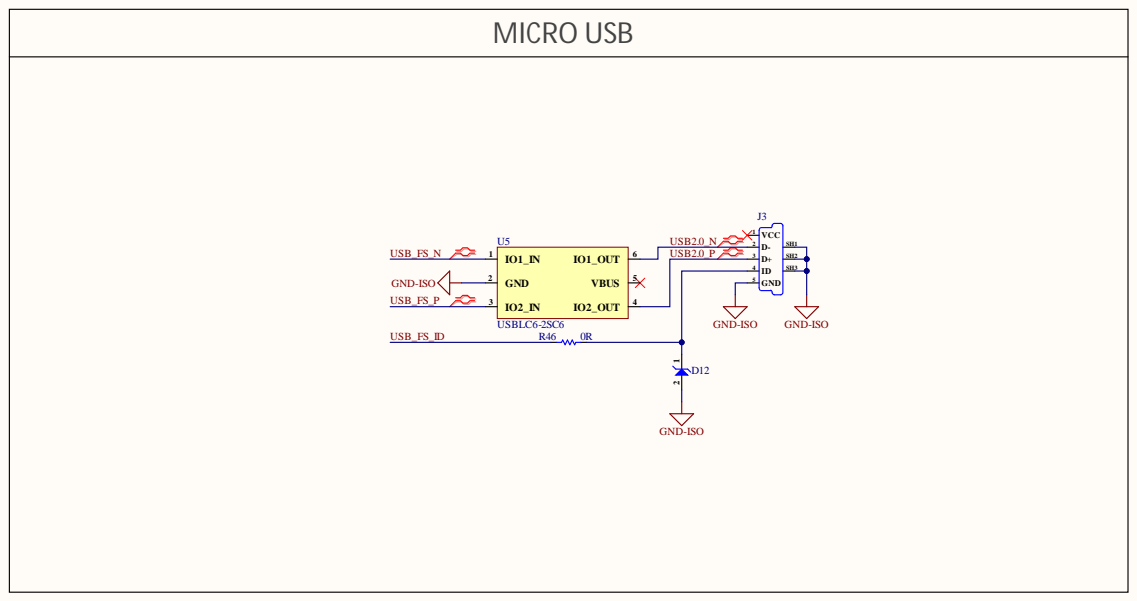
[picture p137: page 5]

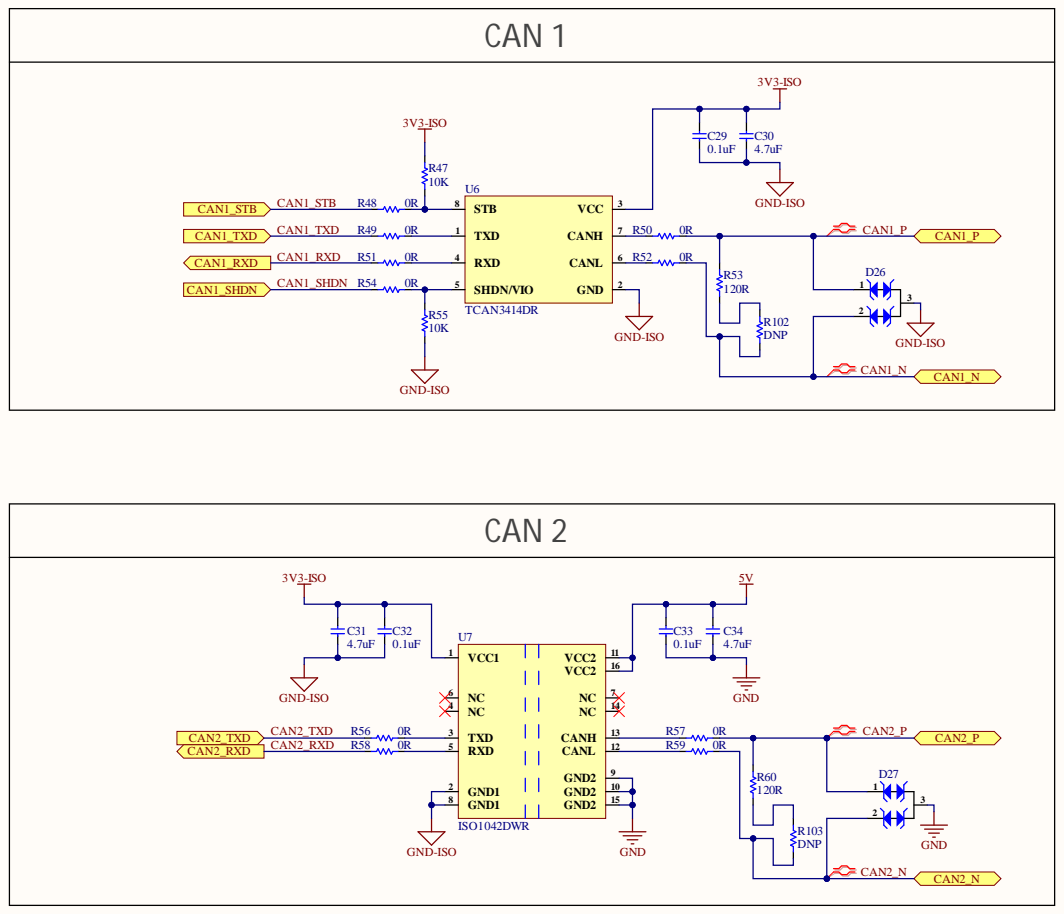
[picture p138: page 6]

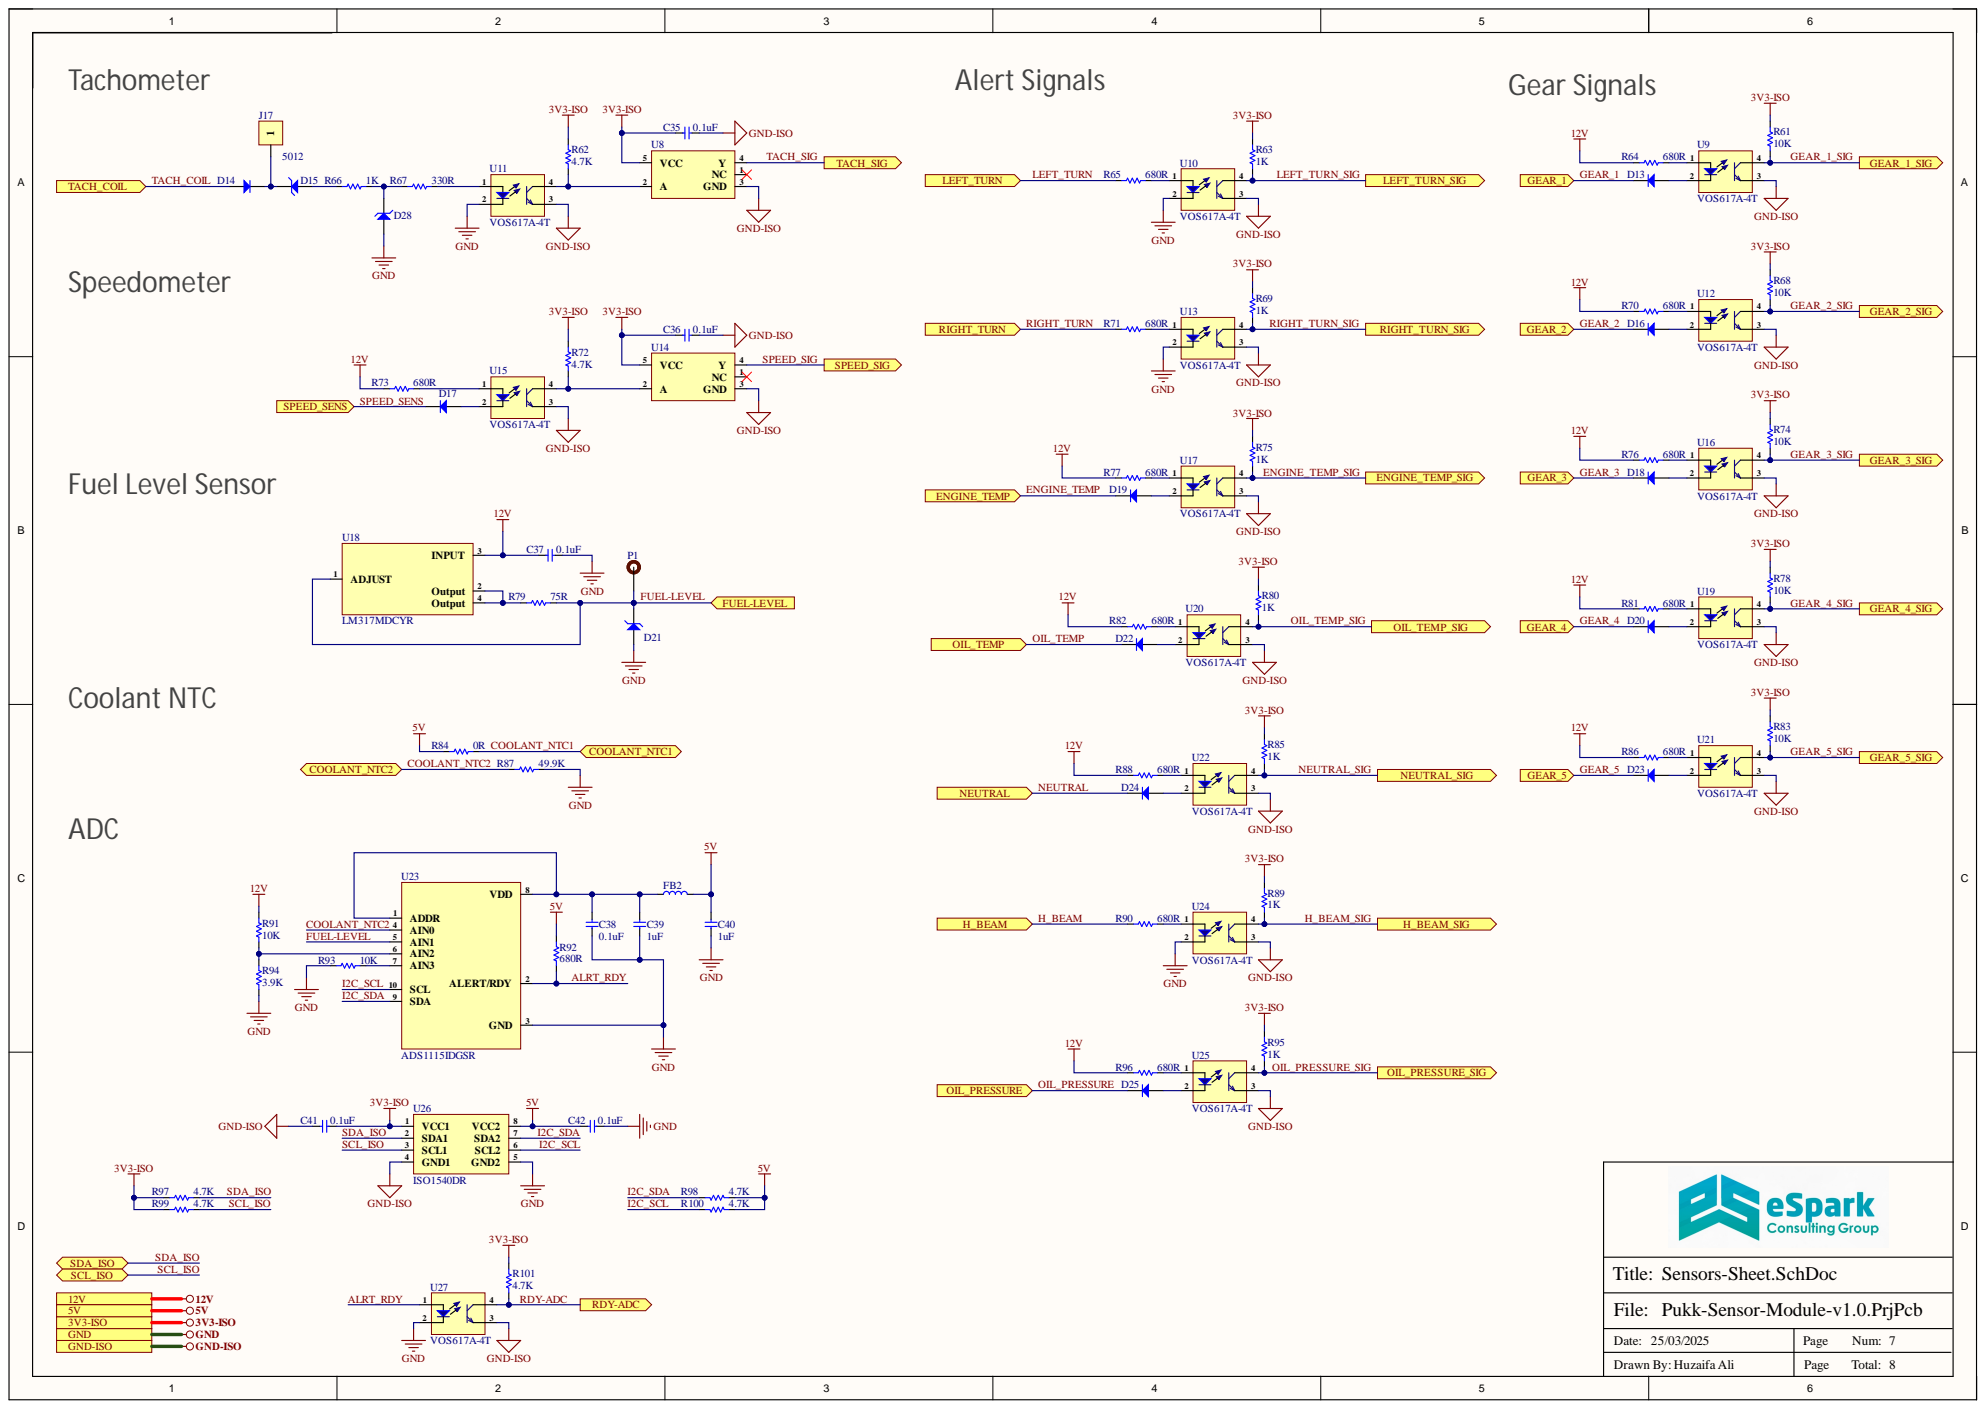
[picture p139: page 7]

AIN0 4

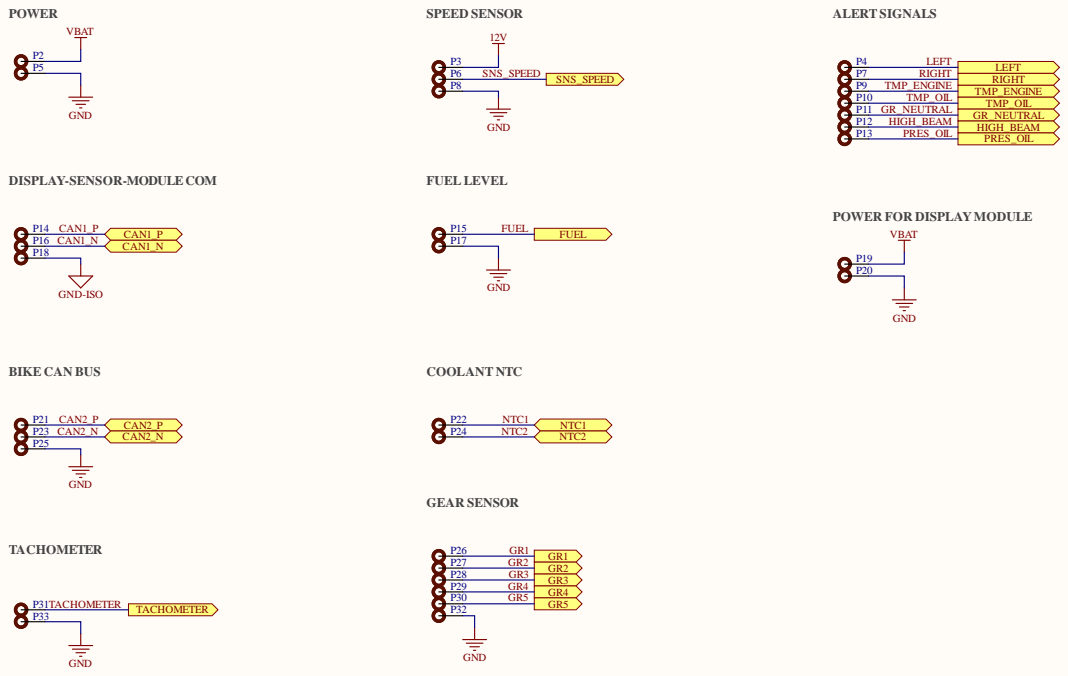
[picture p140: page 8]

DISPLAY-SENSOR-MODULE COM

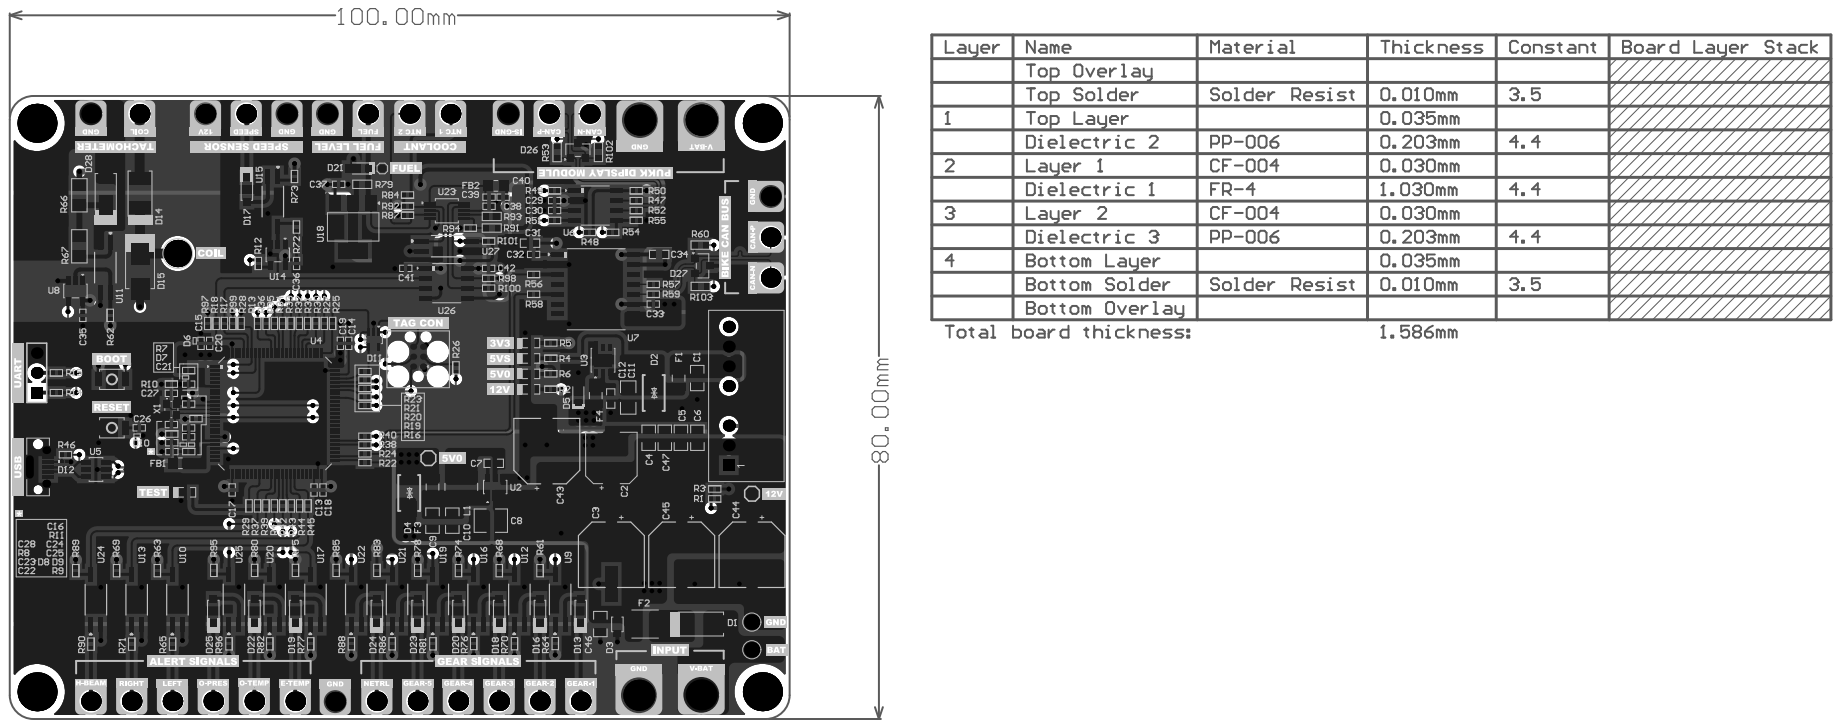
[picture p141: page 9]
