eSpark-Consulting-Group/alastair-barones-salpha/Design-Files/Pukk MVP Controller Module-v1.0/Pukk MVP Controller Module.pdf

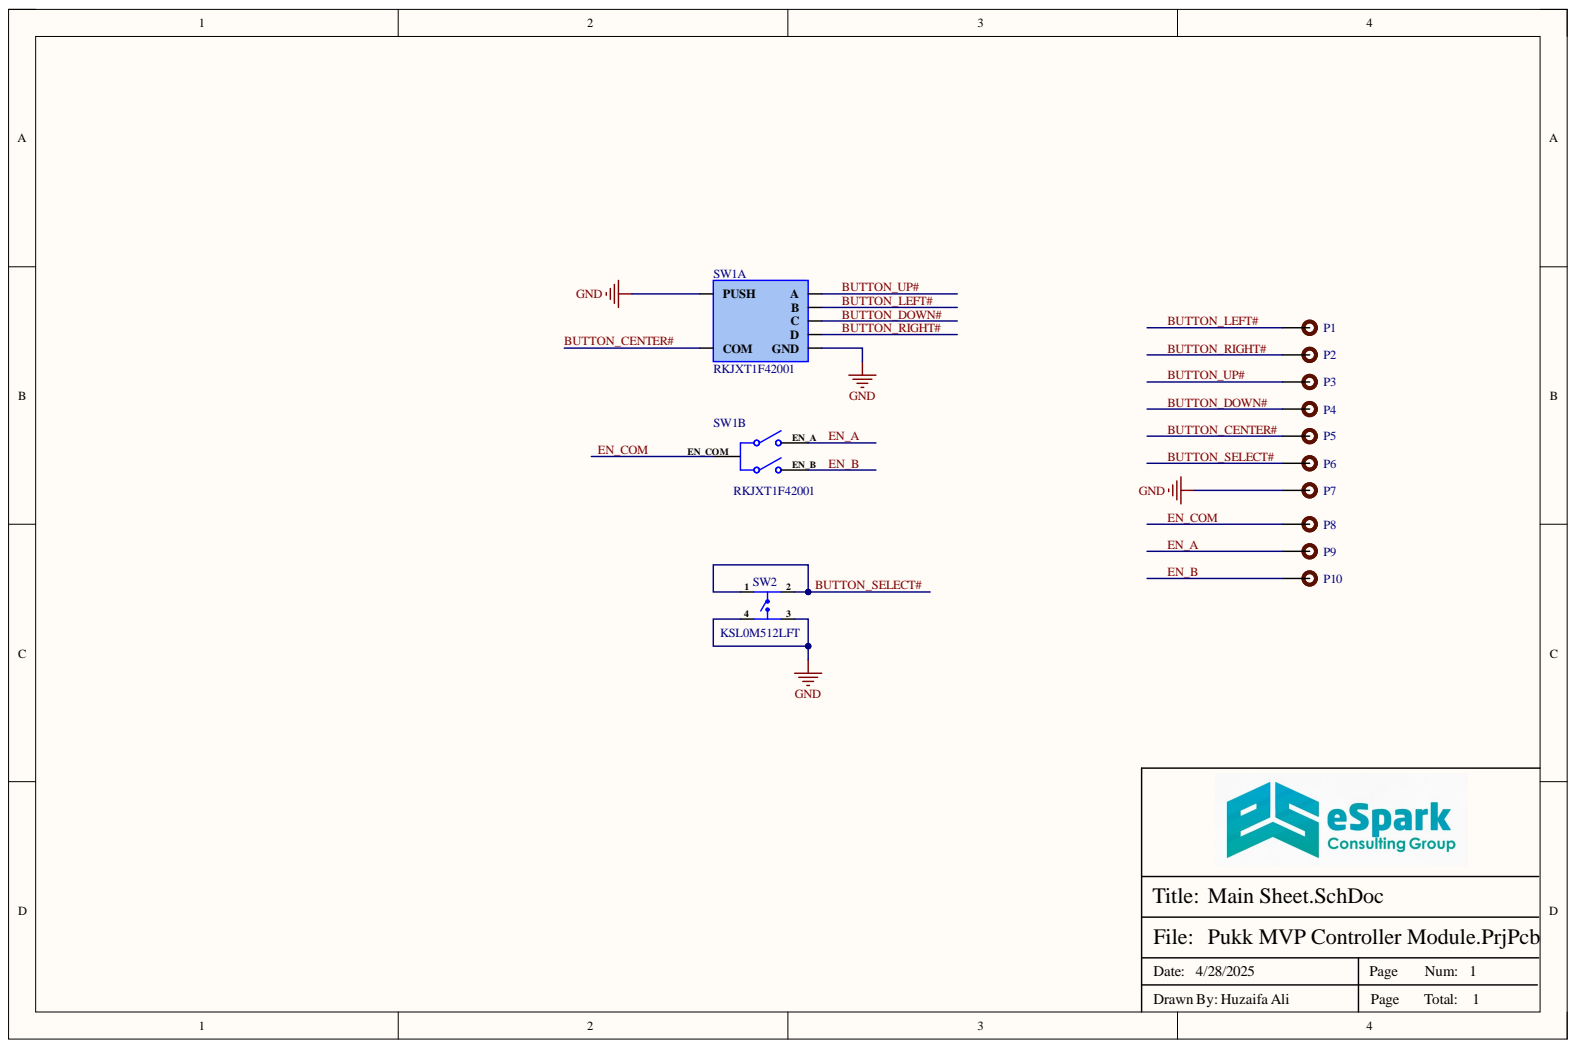
[picture p142: page 1]

Pukk MVP Controller Module.PrjPcb

Dat e : 4 / 2 8 / 2 0 2 5 | Pag e N u m : 11

D raw n B y : H uzai fa A l i | Pag e To t al :

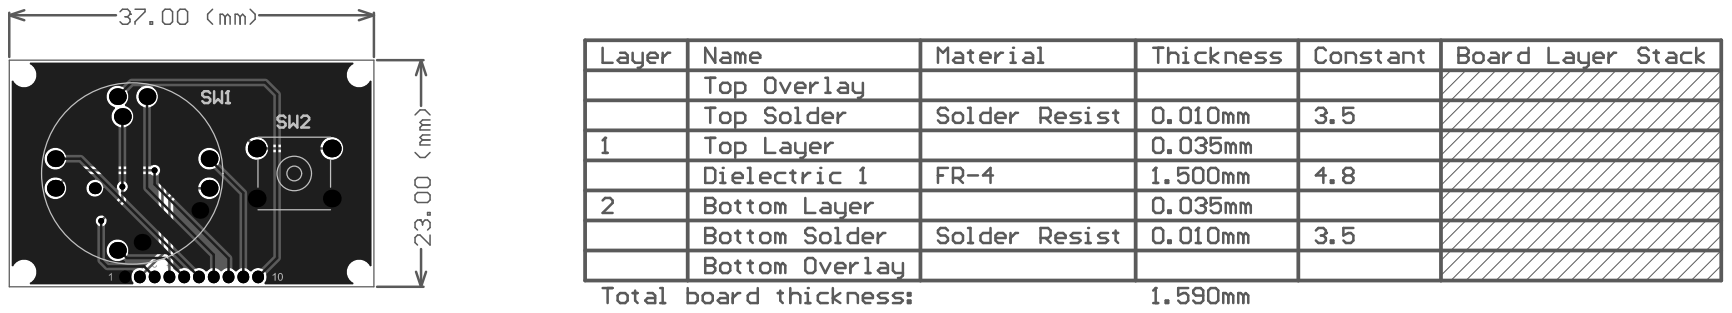
[picture p143: page 2]
