eSpark-Consulting-Group/alastair-barones-salpha/docs/References/ACE-6X56W-Wiring.pdf

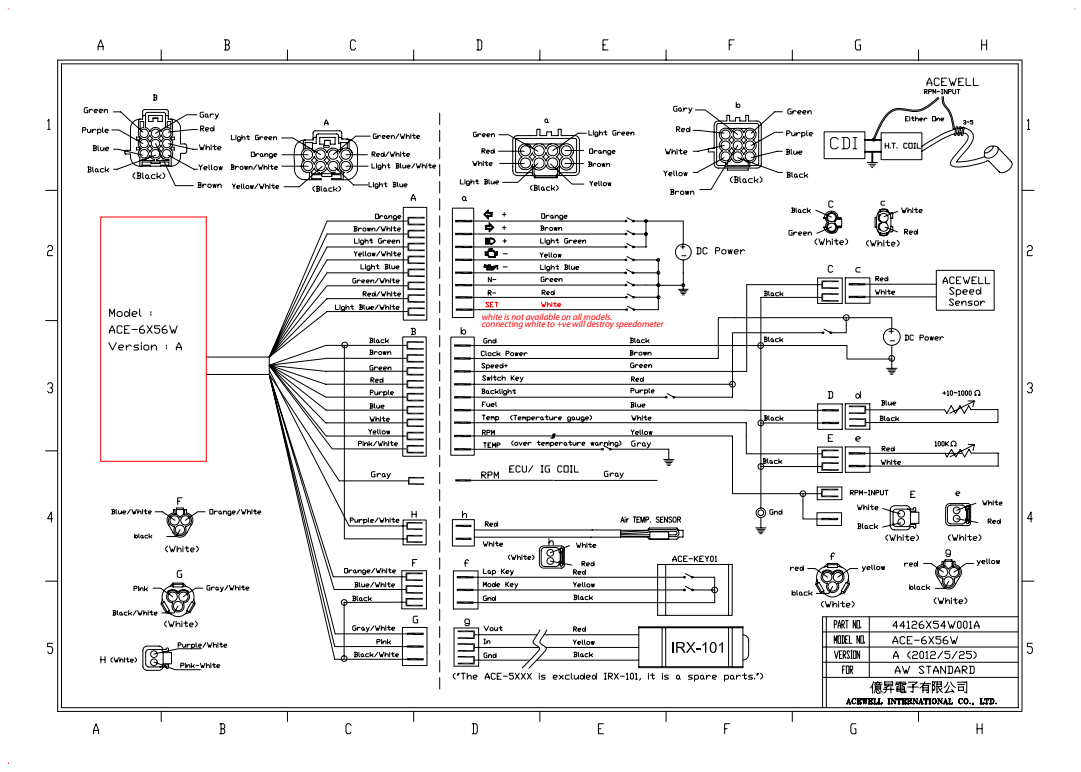
[picture p144: page 1]

white is not available on all models.
connecting white to +ve will destroy speedometer
