eSpark-Consulting-Group/alastair-barones-salpha/Design-Files/Pukk-Display-Module-v1.0/Deliverables/_Schematics/Assembly File.pdf

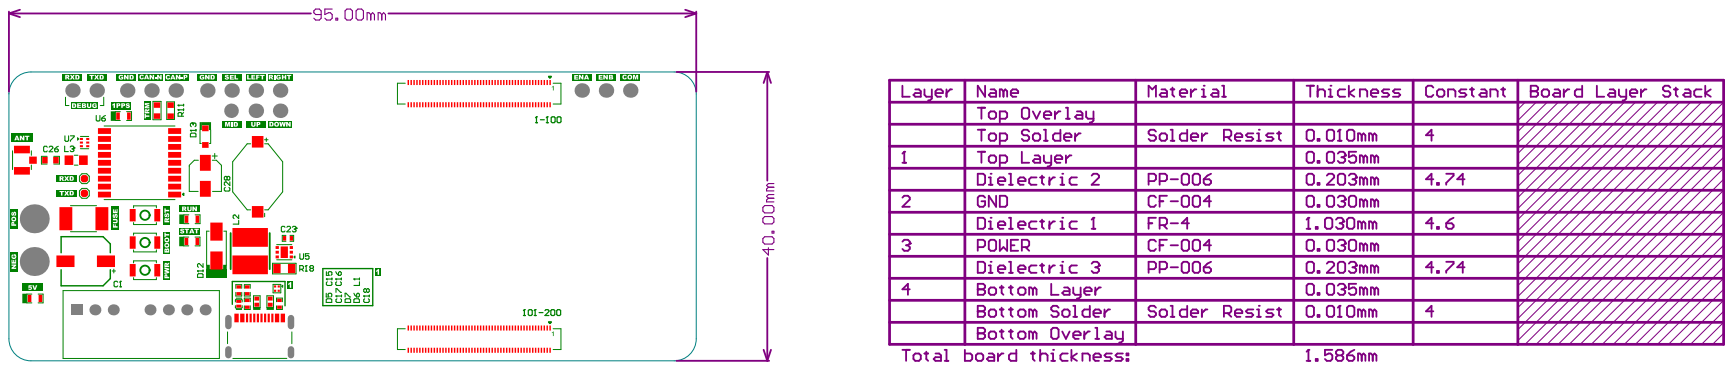
[picture p145: page 1]

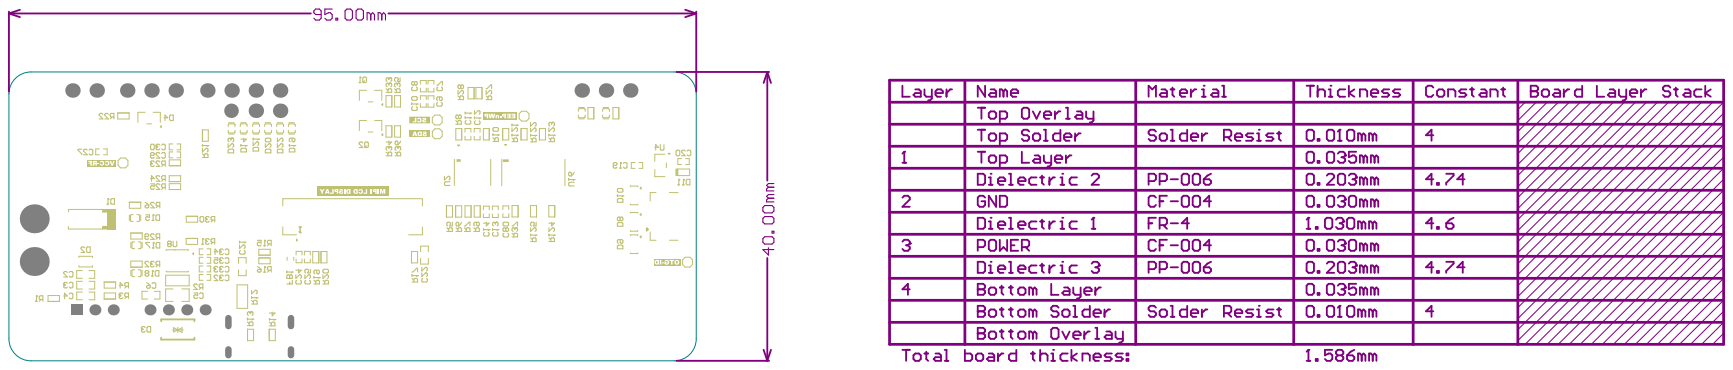
[picture p146: page 2]

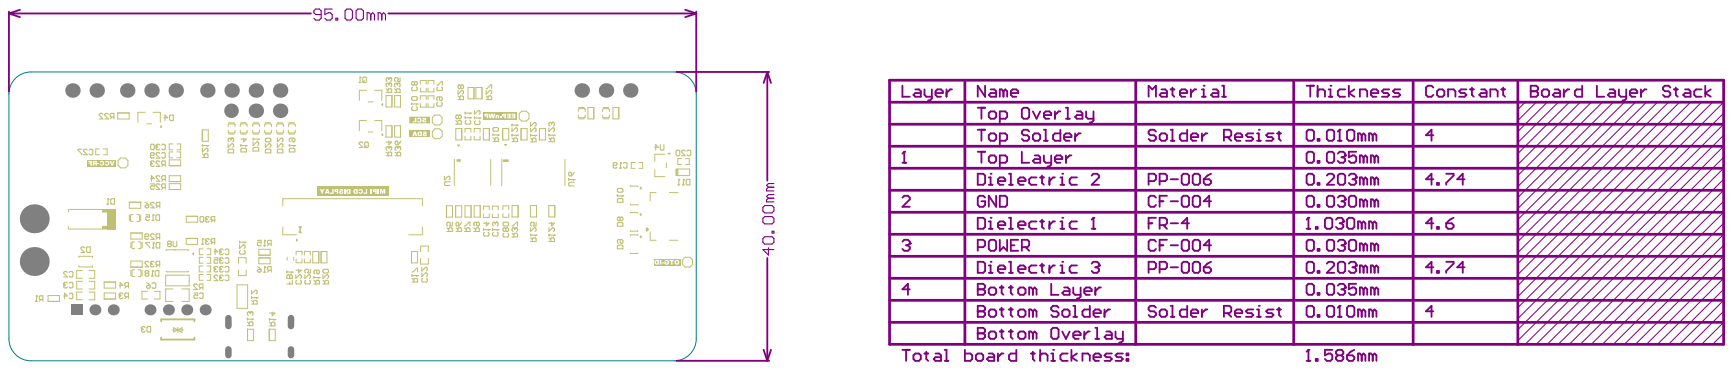
[picture p147: page 3]

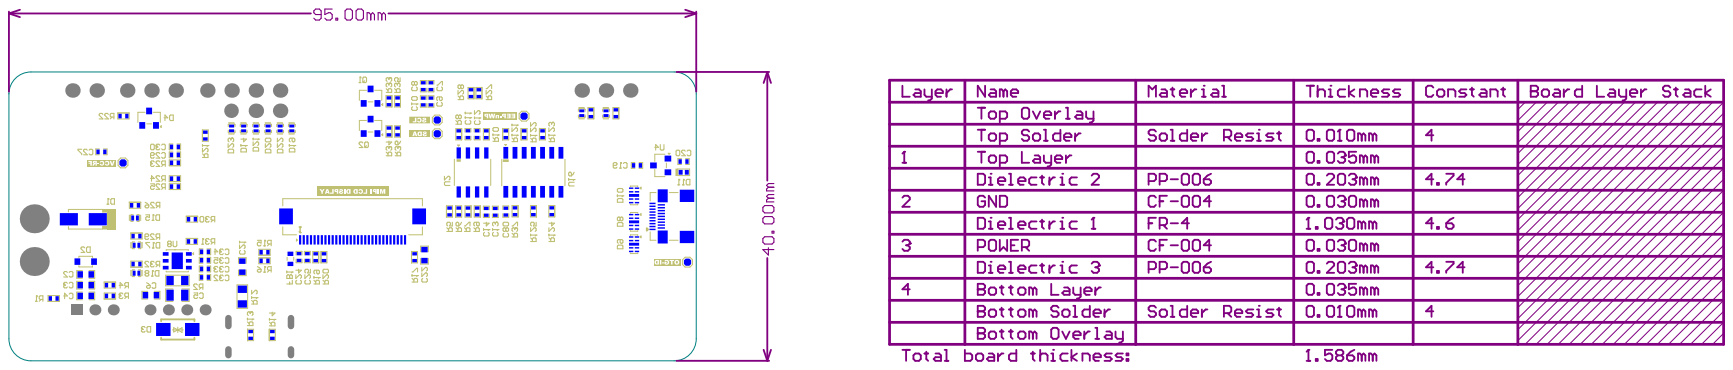
[picture p148: page 4]
