eSpark-Consulting-Group/alastair-barones-salpha/Design-Files/Pukk MVP Controller Module-v1.0/Deliverables/Schematics/Assembly Drawing.pdf

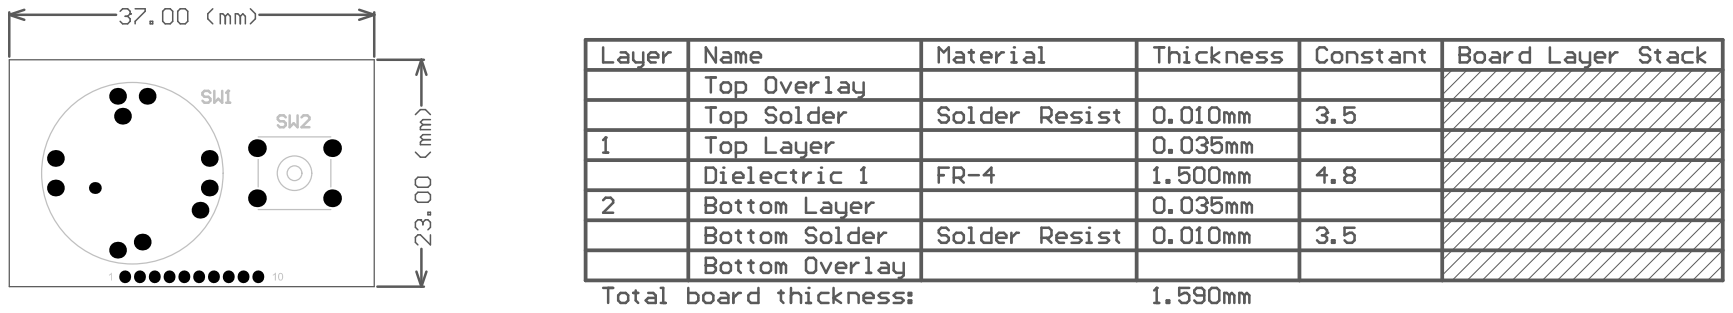
[picture p149: page 1]

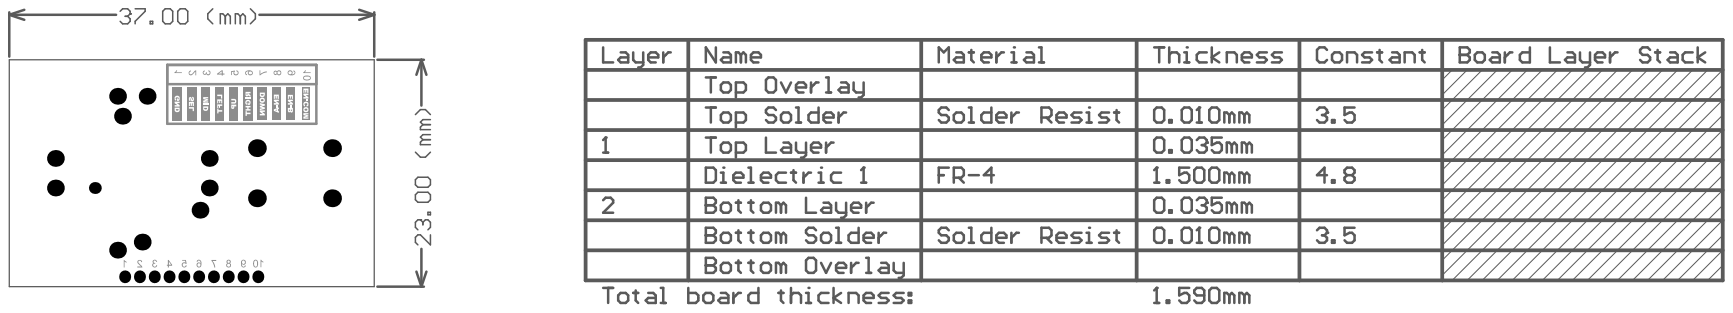
[picture p150: page 2]
