eSpark-Consulting-Group/alastair-barones-salpha/Design-Files/Pukk-Sensor-Module-v1.0/Deliverables/_Schematics/Assembly File.pdf

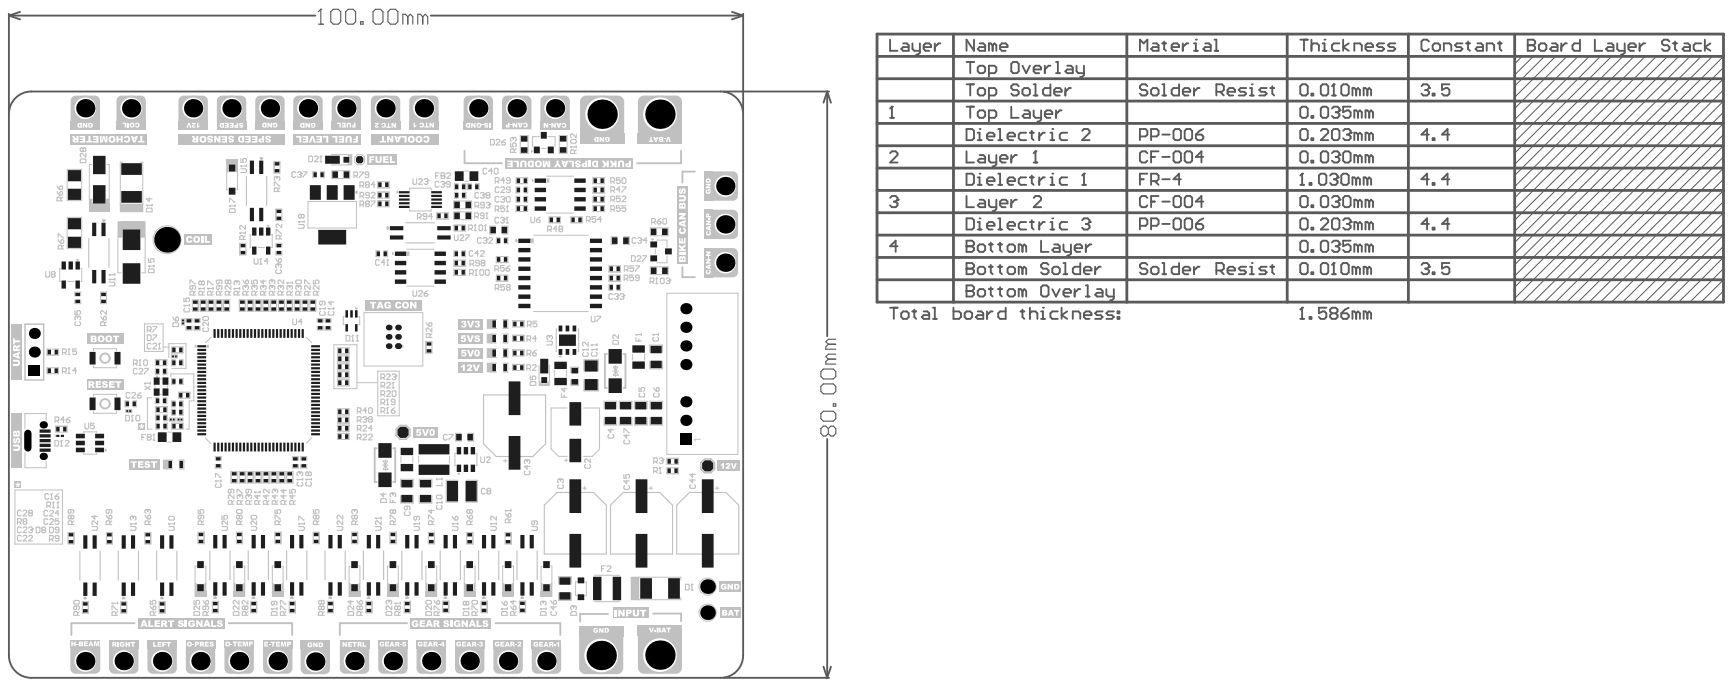
[picture p151: page 1]

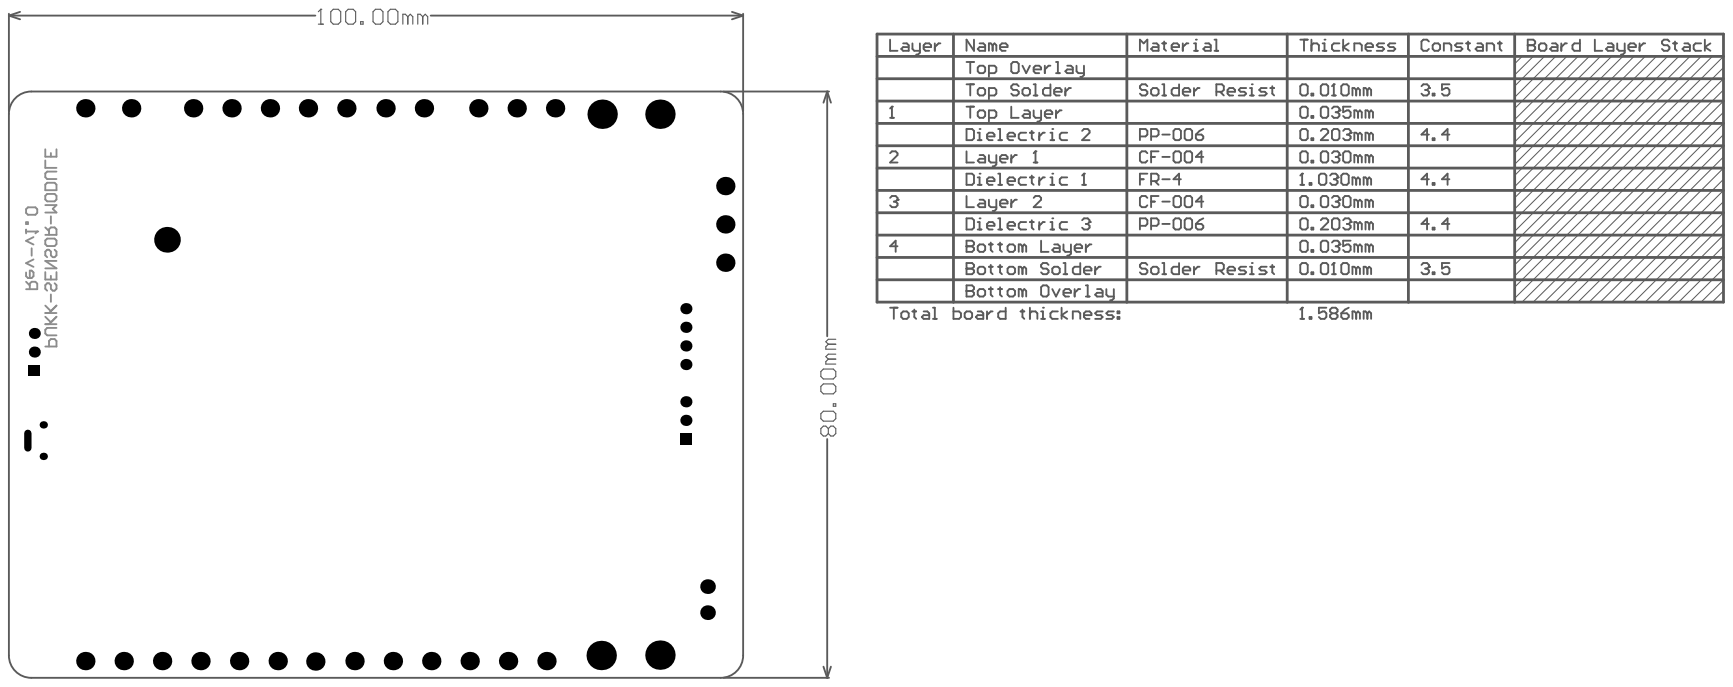
[picture p152: page 2]
