eSpark-Consulting-Group/alastair-barones-salpha/Design-Files/MVP-Dash-v1.0/Deliverables/Assembly Drawings/Assembly Drawings.pdf

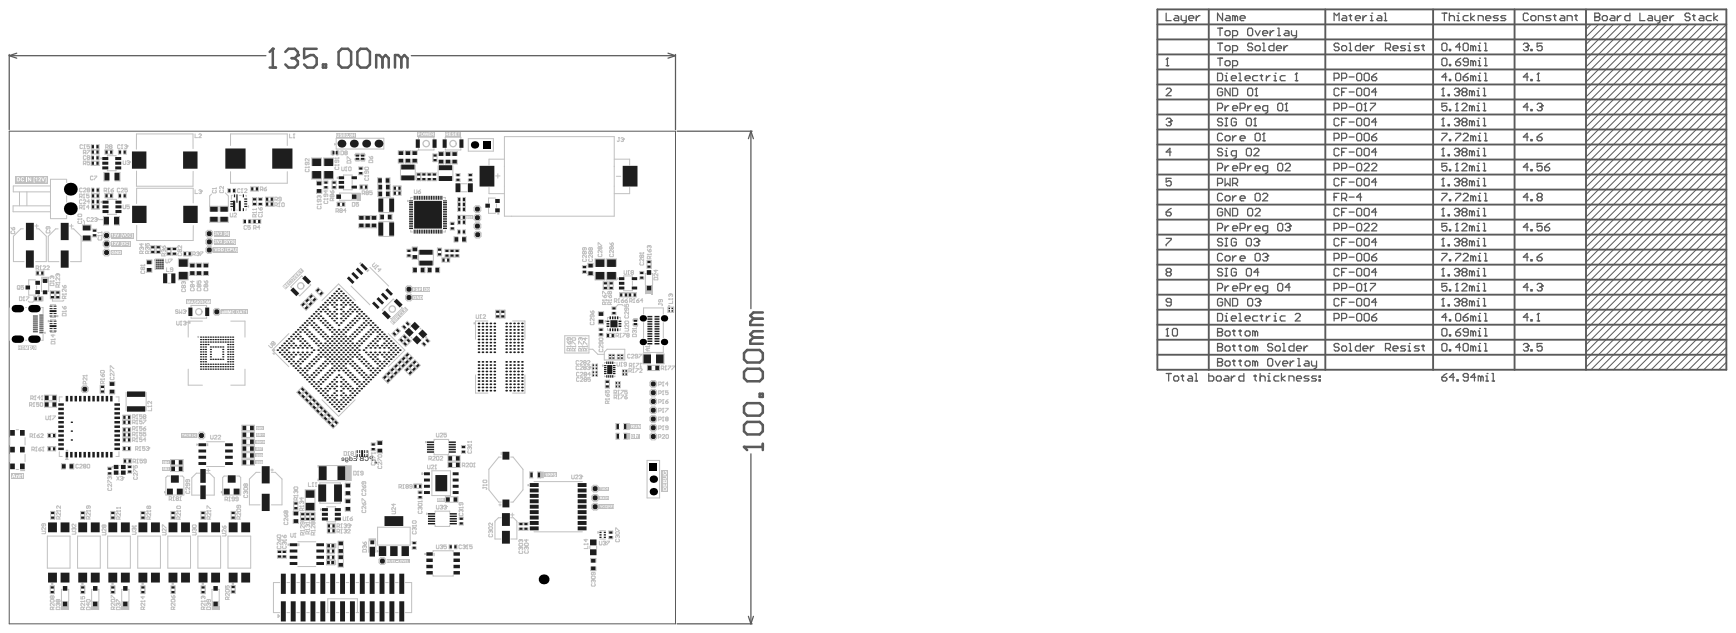
[picture p153: page 1]

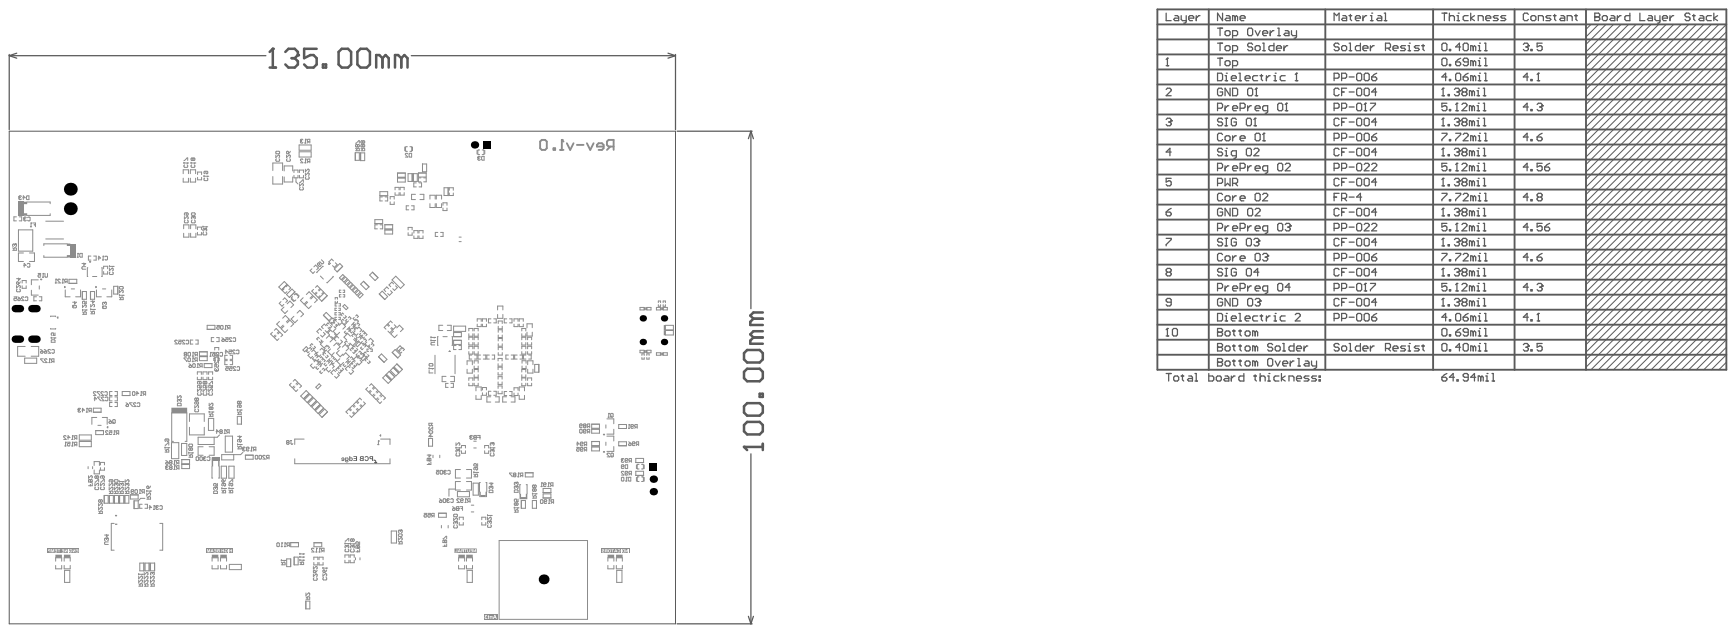
[picture p154: page 2]

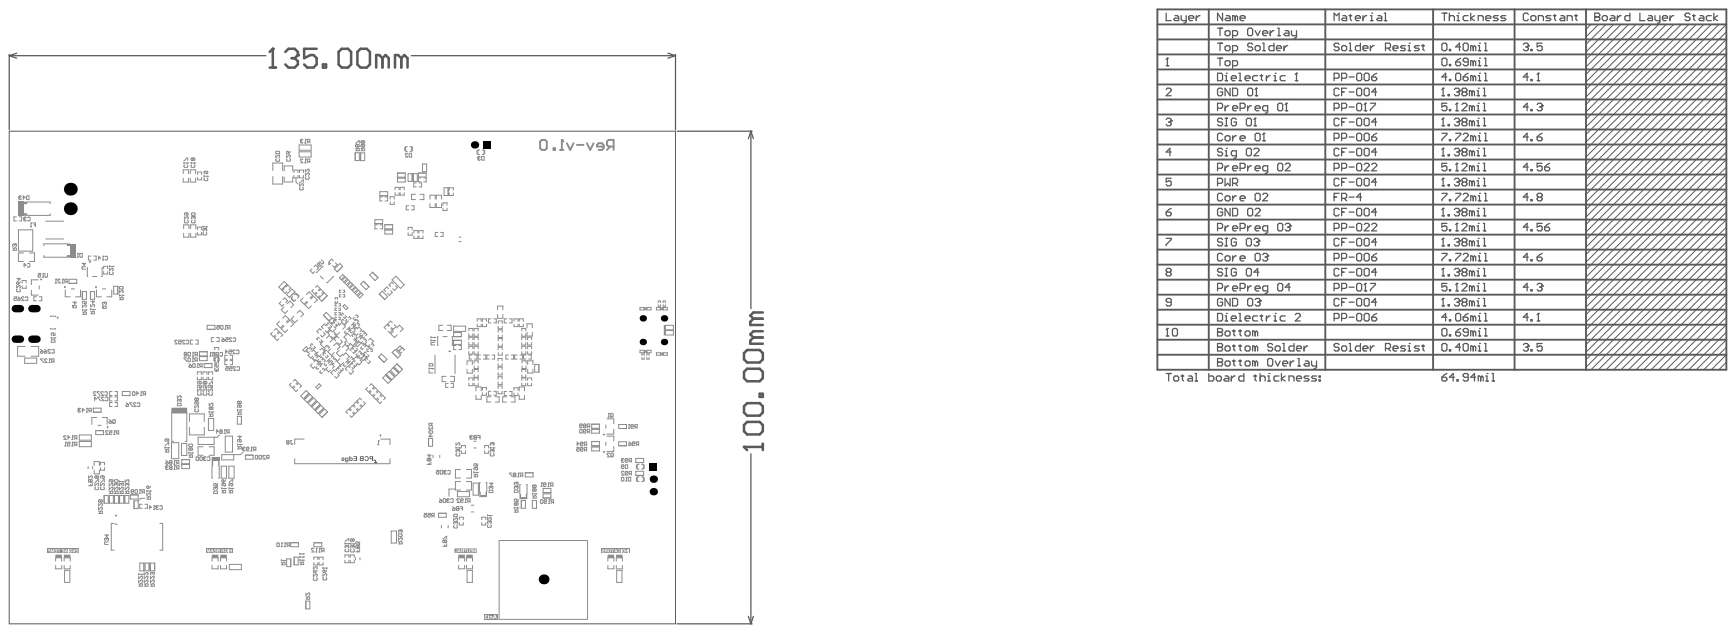
[picture p155: page 3]

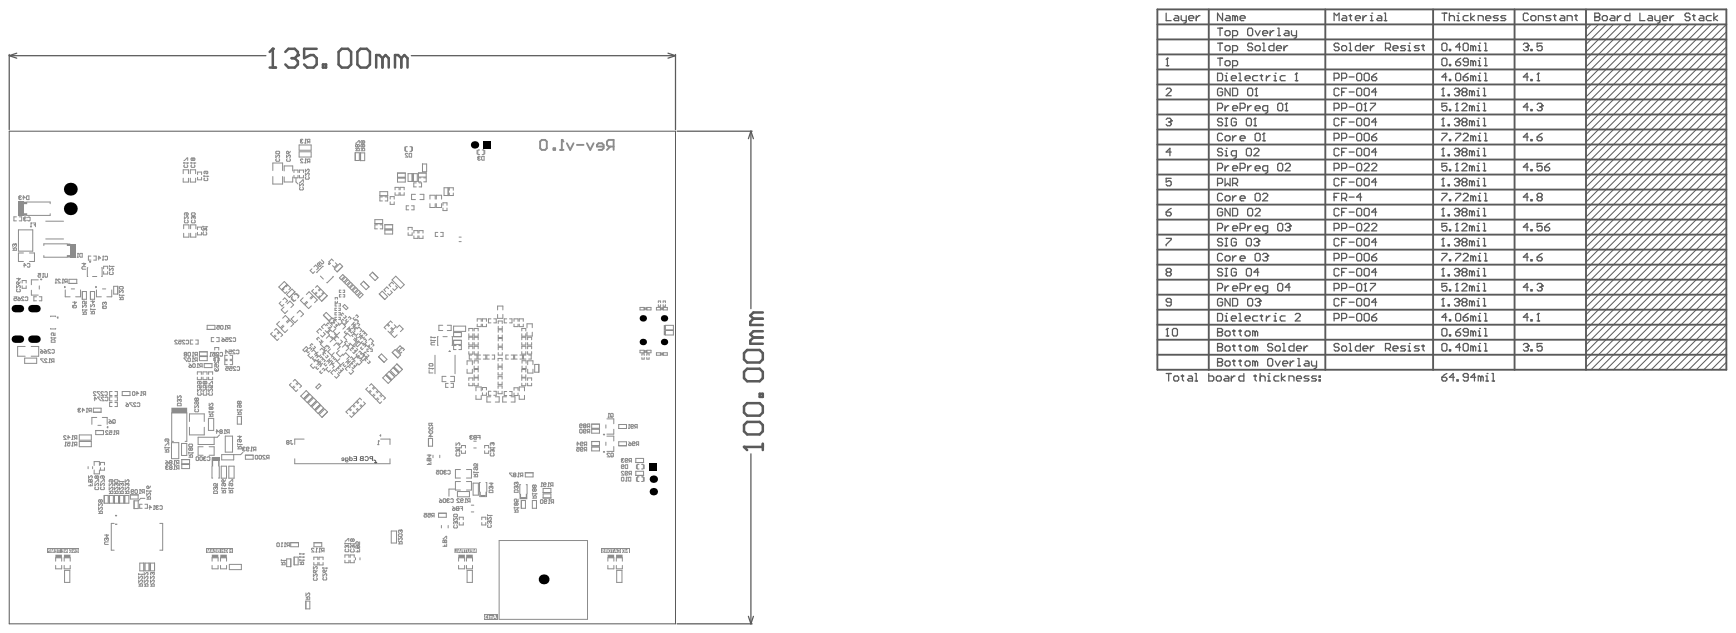
[picture p156: page 4]

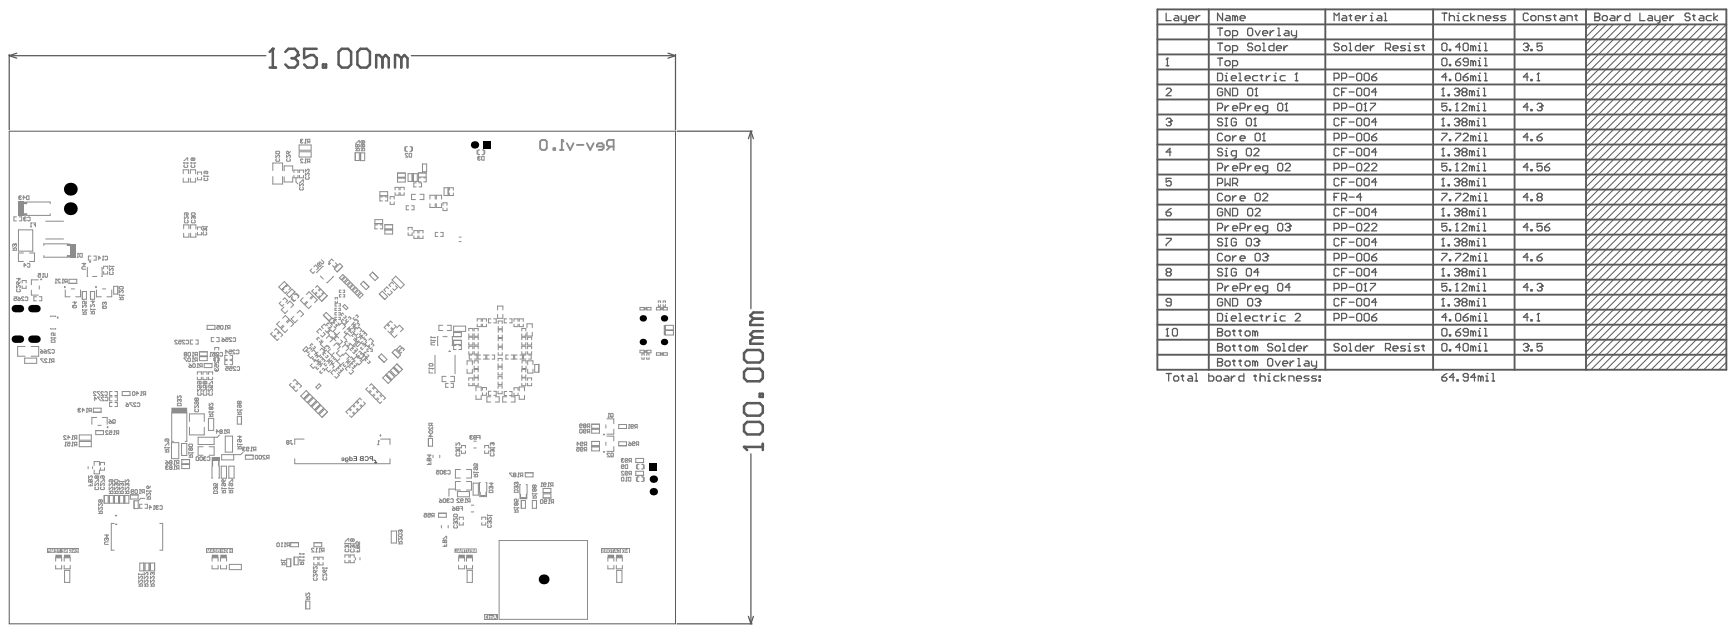
[picture p157: page 5]

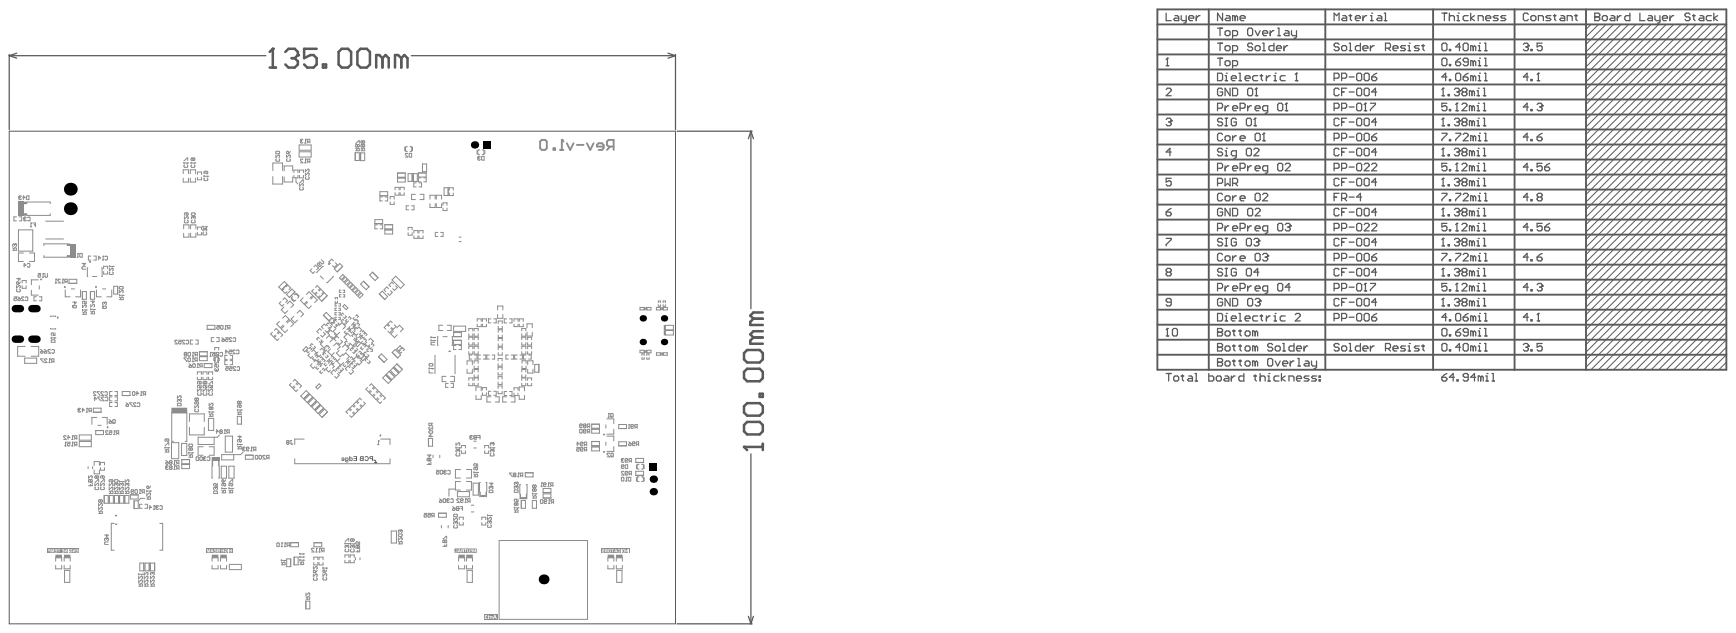
[picture p158: page 6]

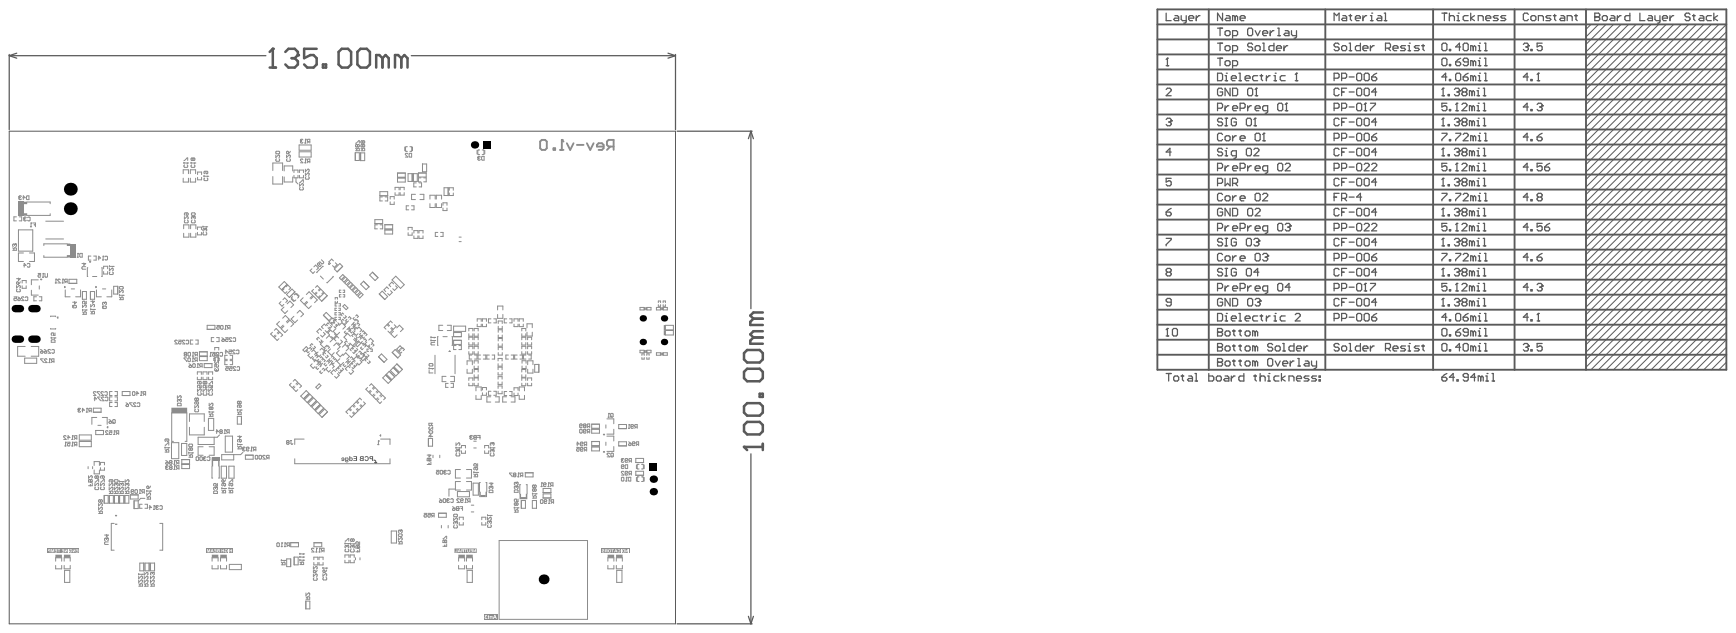
[picture p159: page 7]

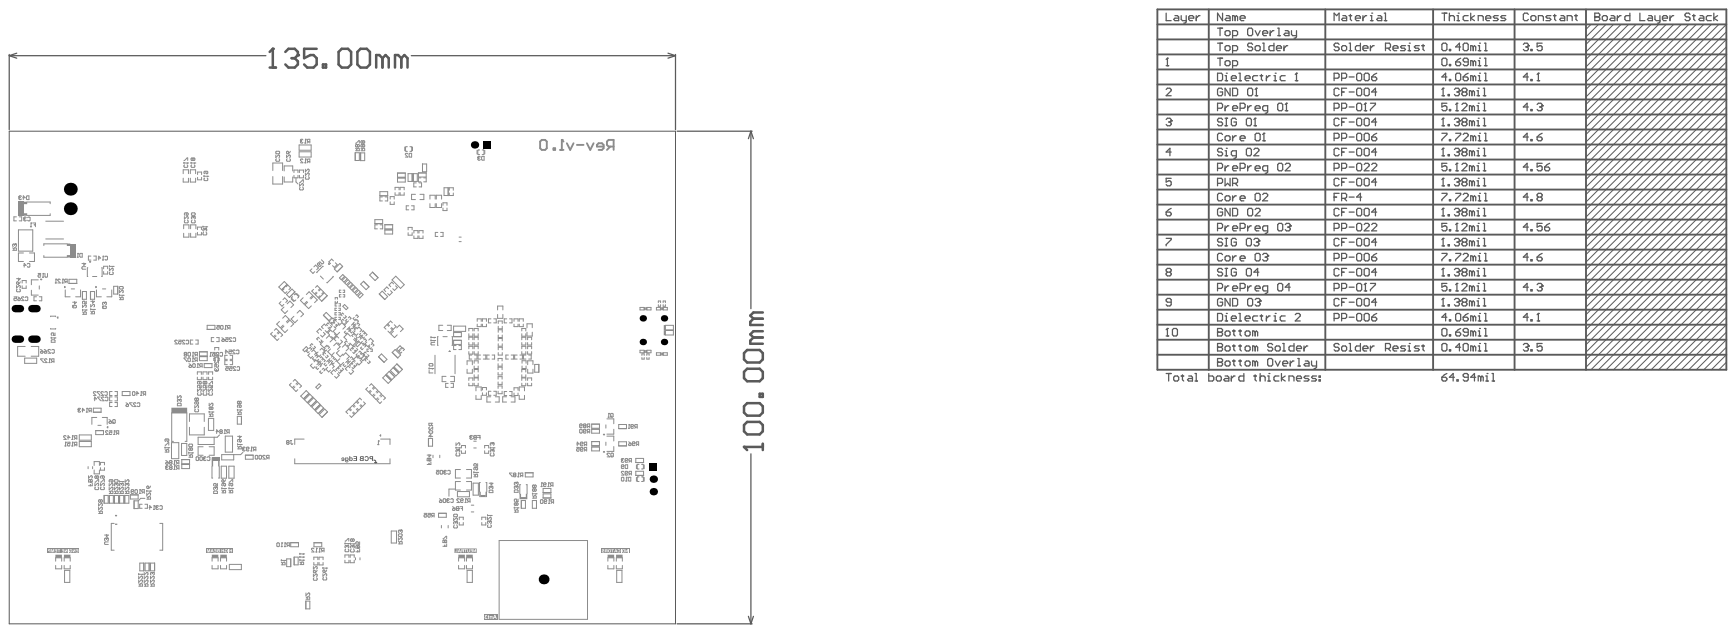
[picture p160: page 8]

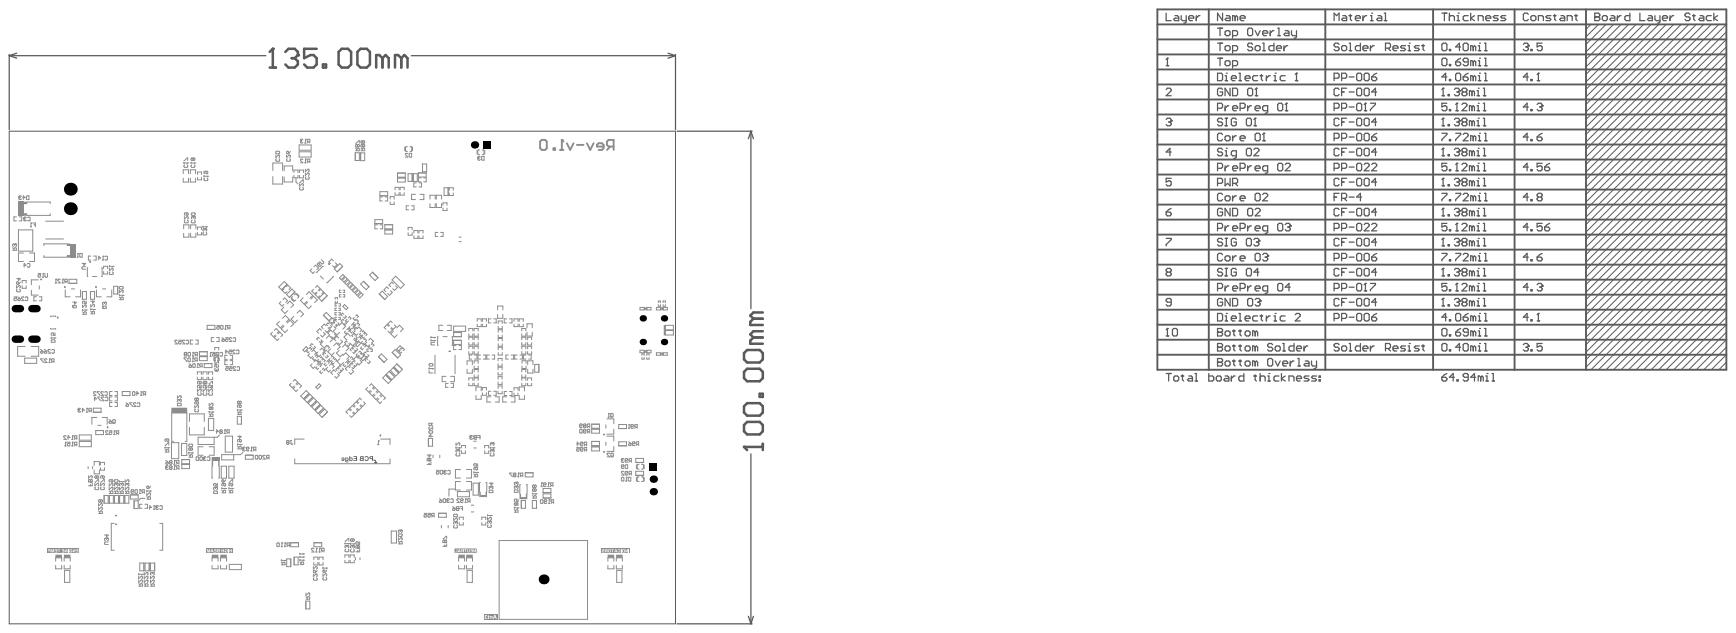
[picture p161: page 9]

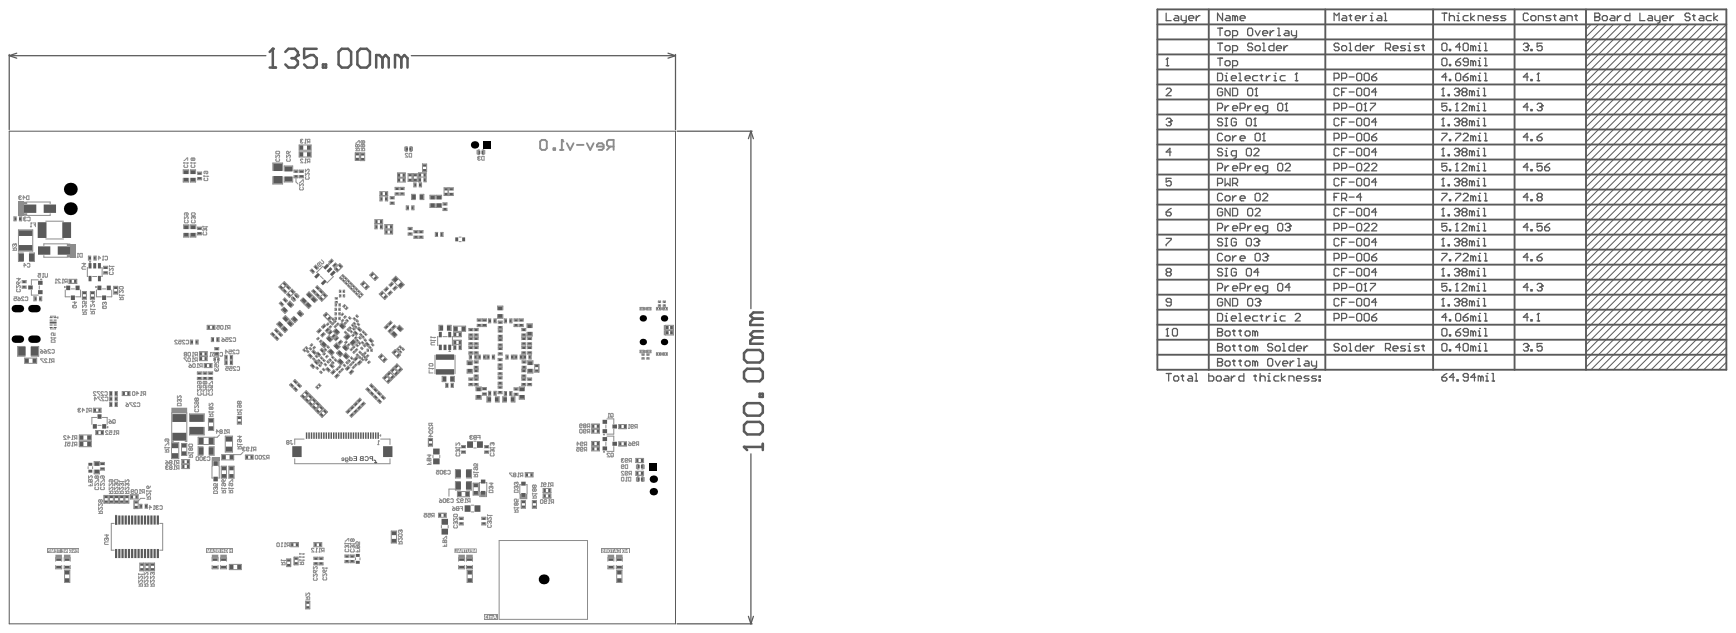
[picture p162: page 10]
