eSpark-Consulting-Group/alastair-barones-salpha/Design-Files/Breakout_Board/Breakout_Board/PDF/Breakout_Board.pdf

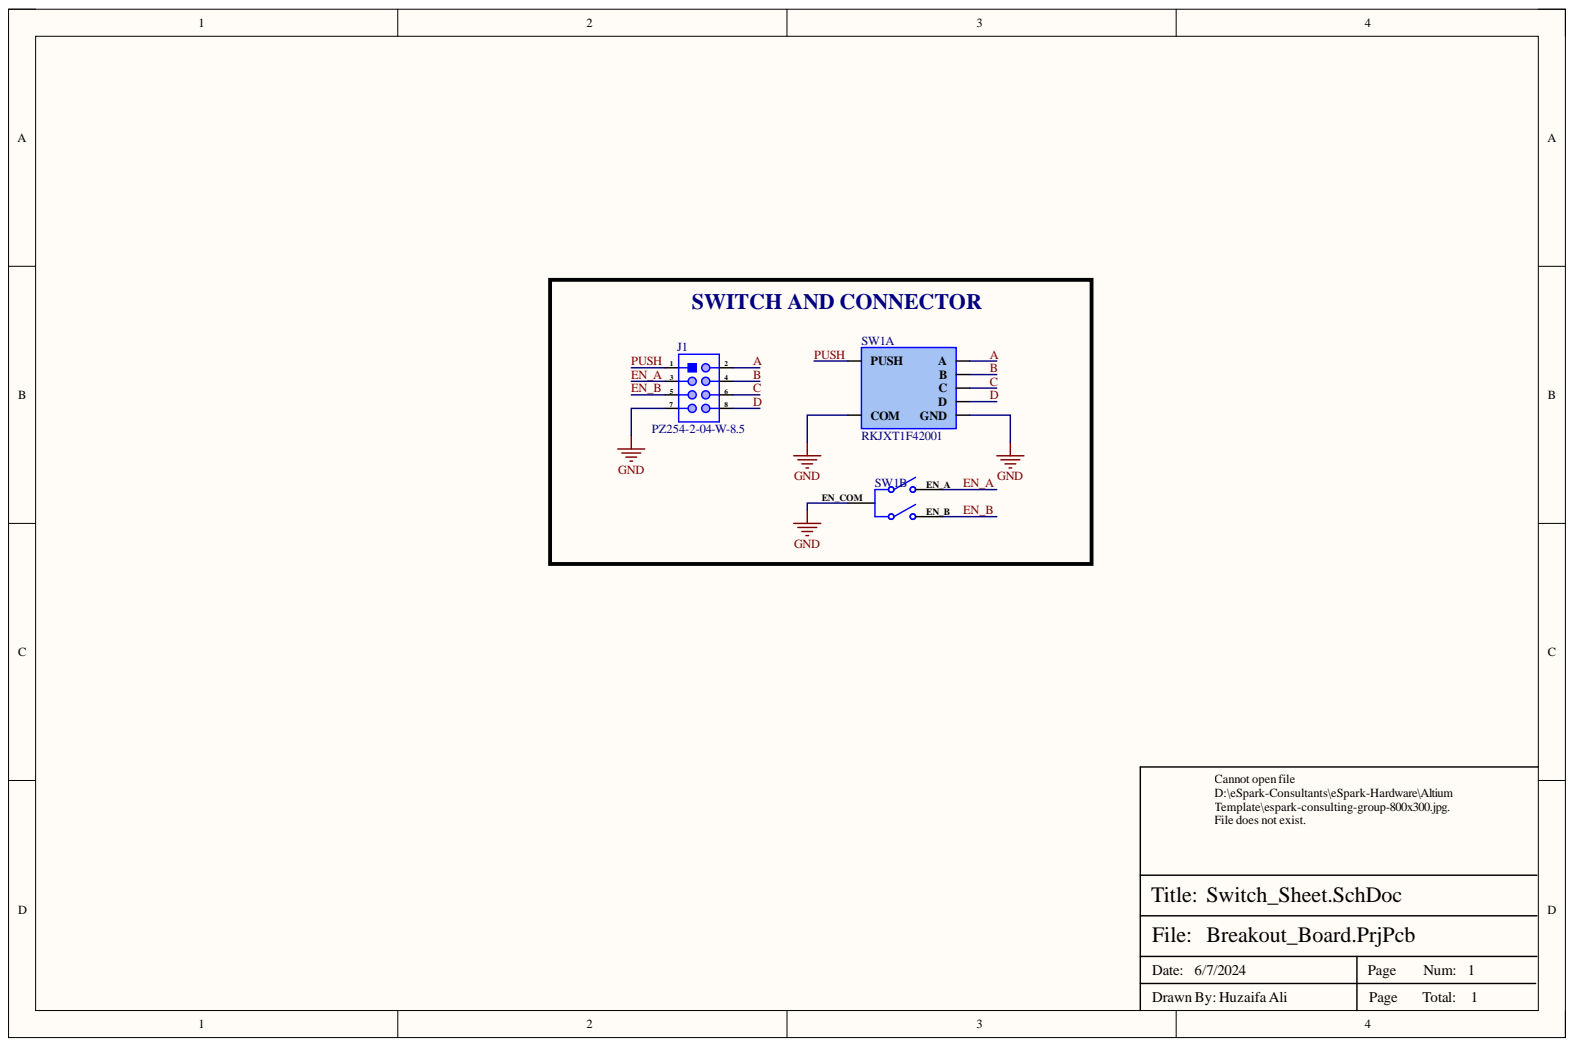
[picture p163: page 1]

Cannot open file
D:\eSpark-Consultants\eSpark-Hardware\Altium
Template\espark-consulting-group-800x300.jpg.
File does not exist.

Date: 6/7/2024 | Page Num: 1

Drawn By: Huzaifa Ali | Page Total: 1

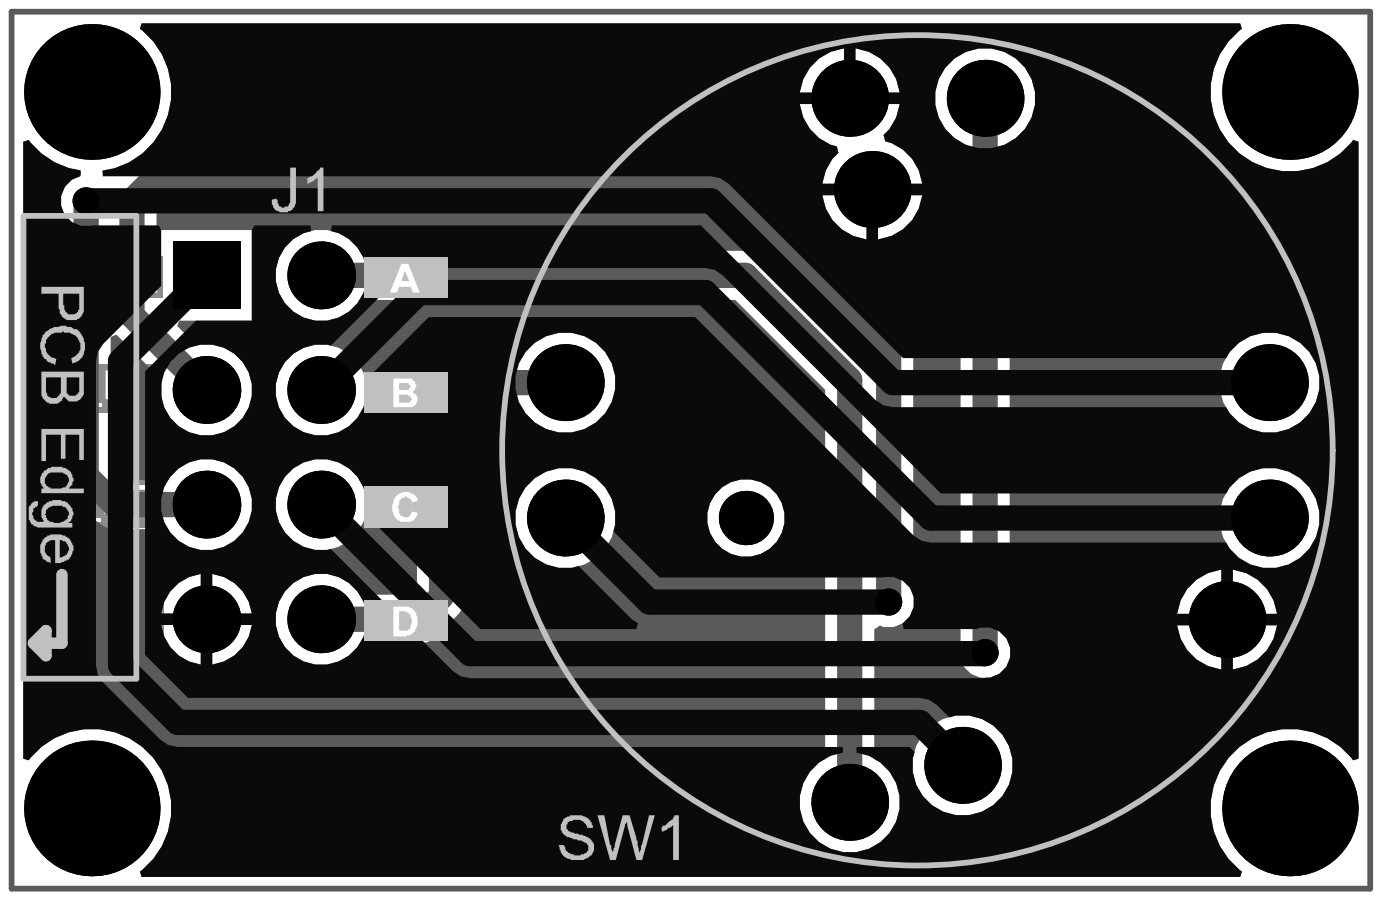
[picture p164: page 2]
