eSpark-Consulting-Group/alastair-barones-salpha/Design-Files/Display-Interface-Board-v1.0/Deliverables/Schematics/Assembly Drawing.pdf

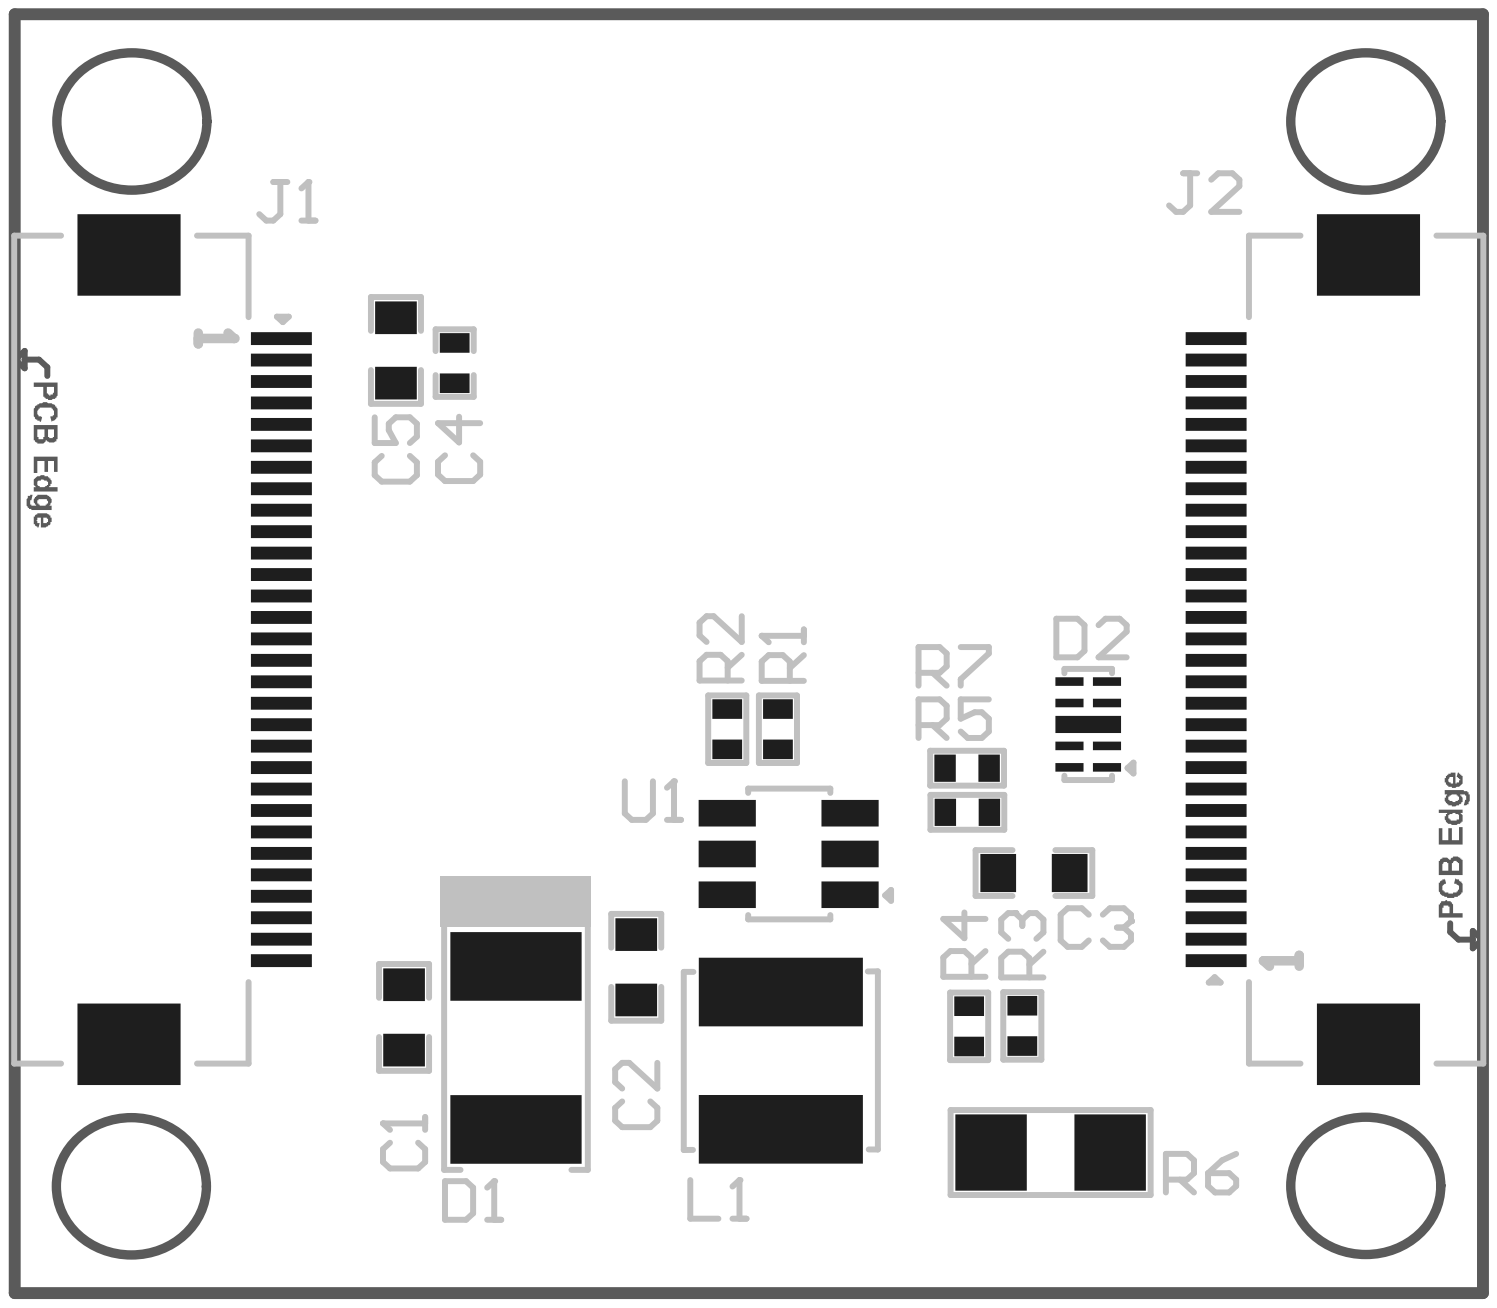
[picture p165: page 1]

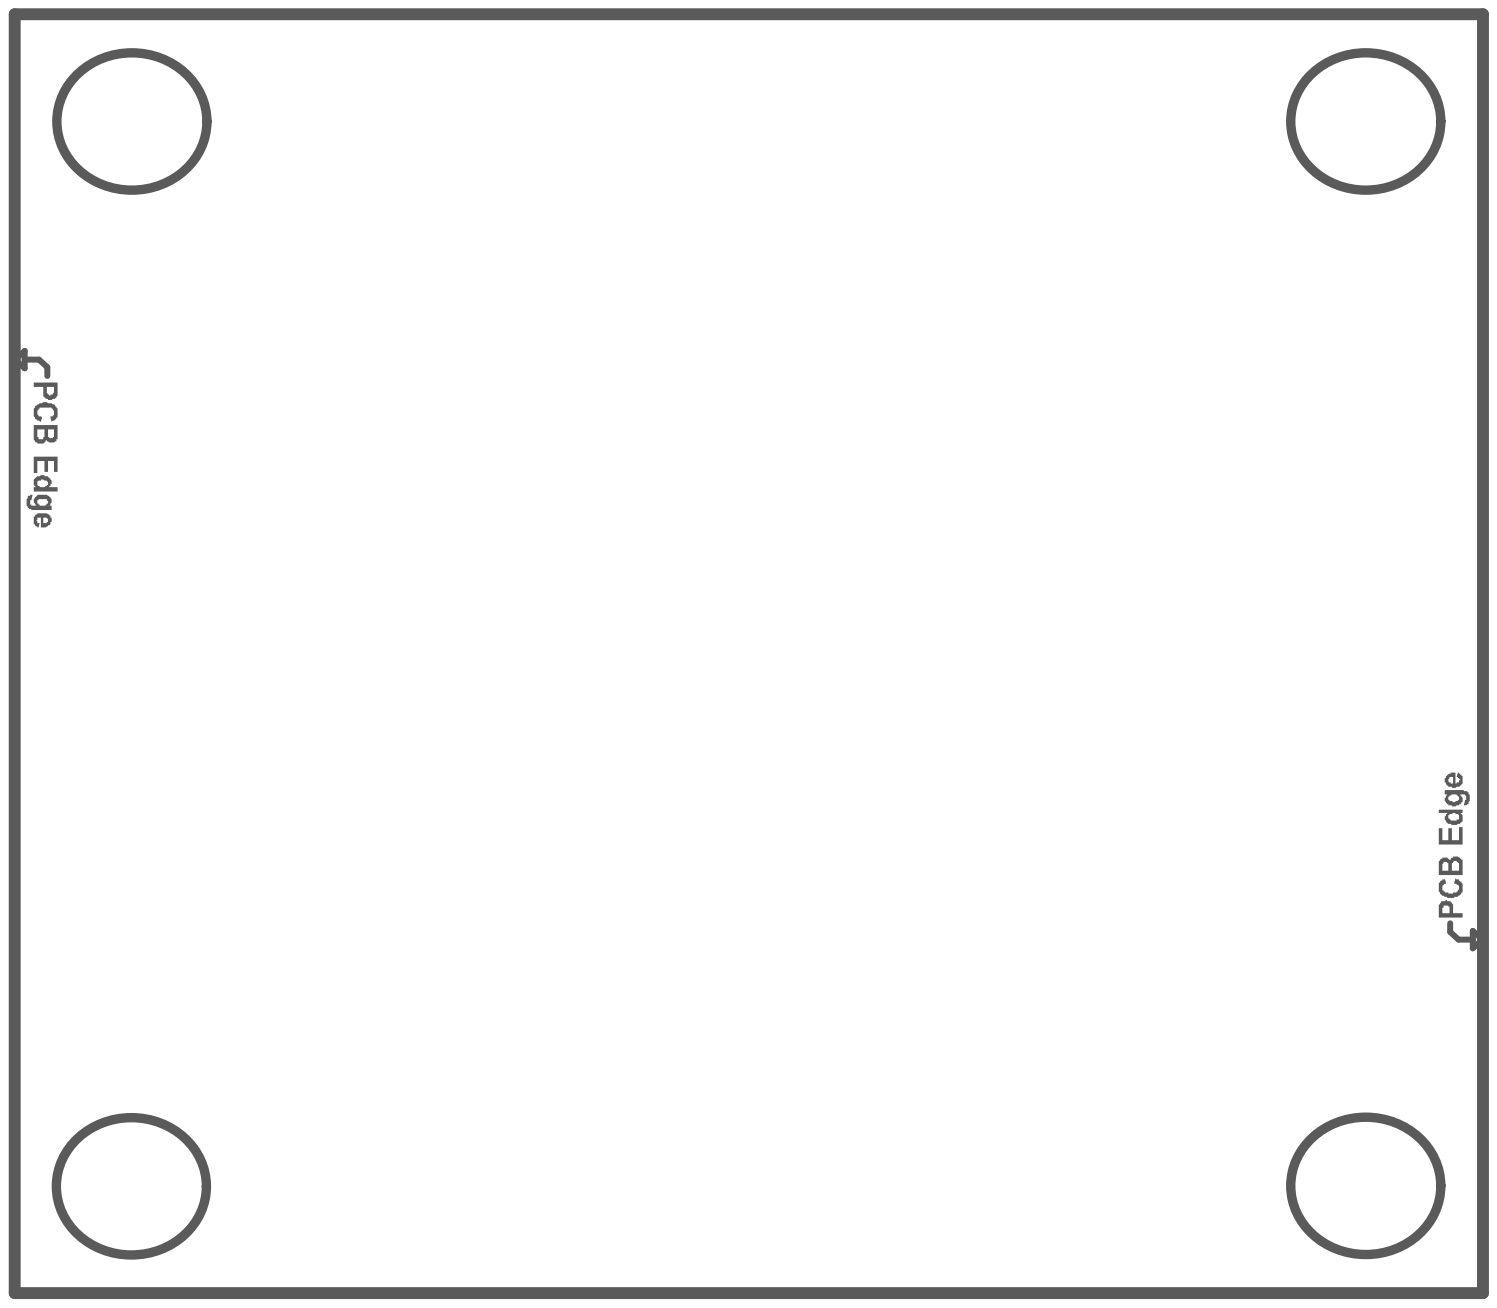
[picture p166: page 2]
