eSpark-Consulting-Group/alastair-barones-salpha/Design-Files/Display-Interface-Board-v1.0/Deliverables/Schematics/Display-Interface-Board-v1.0.pdf

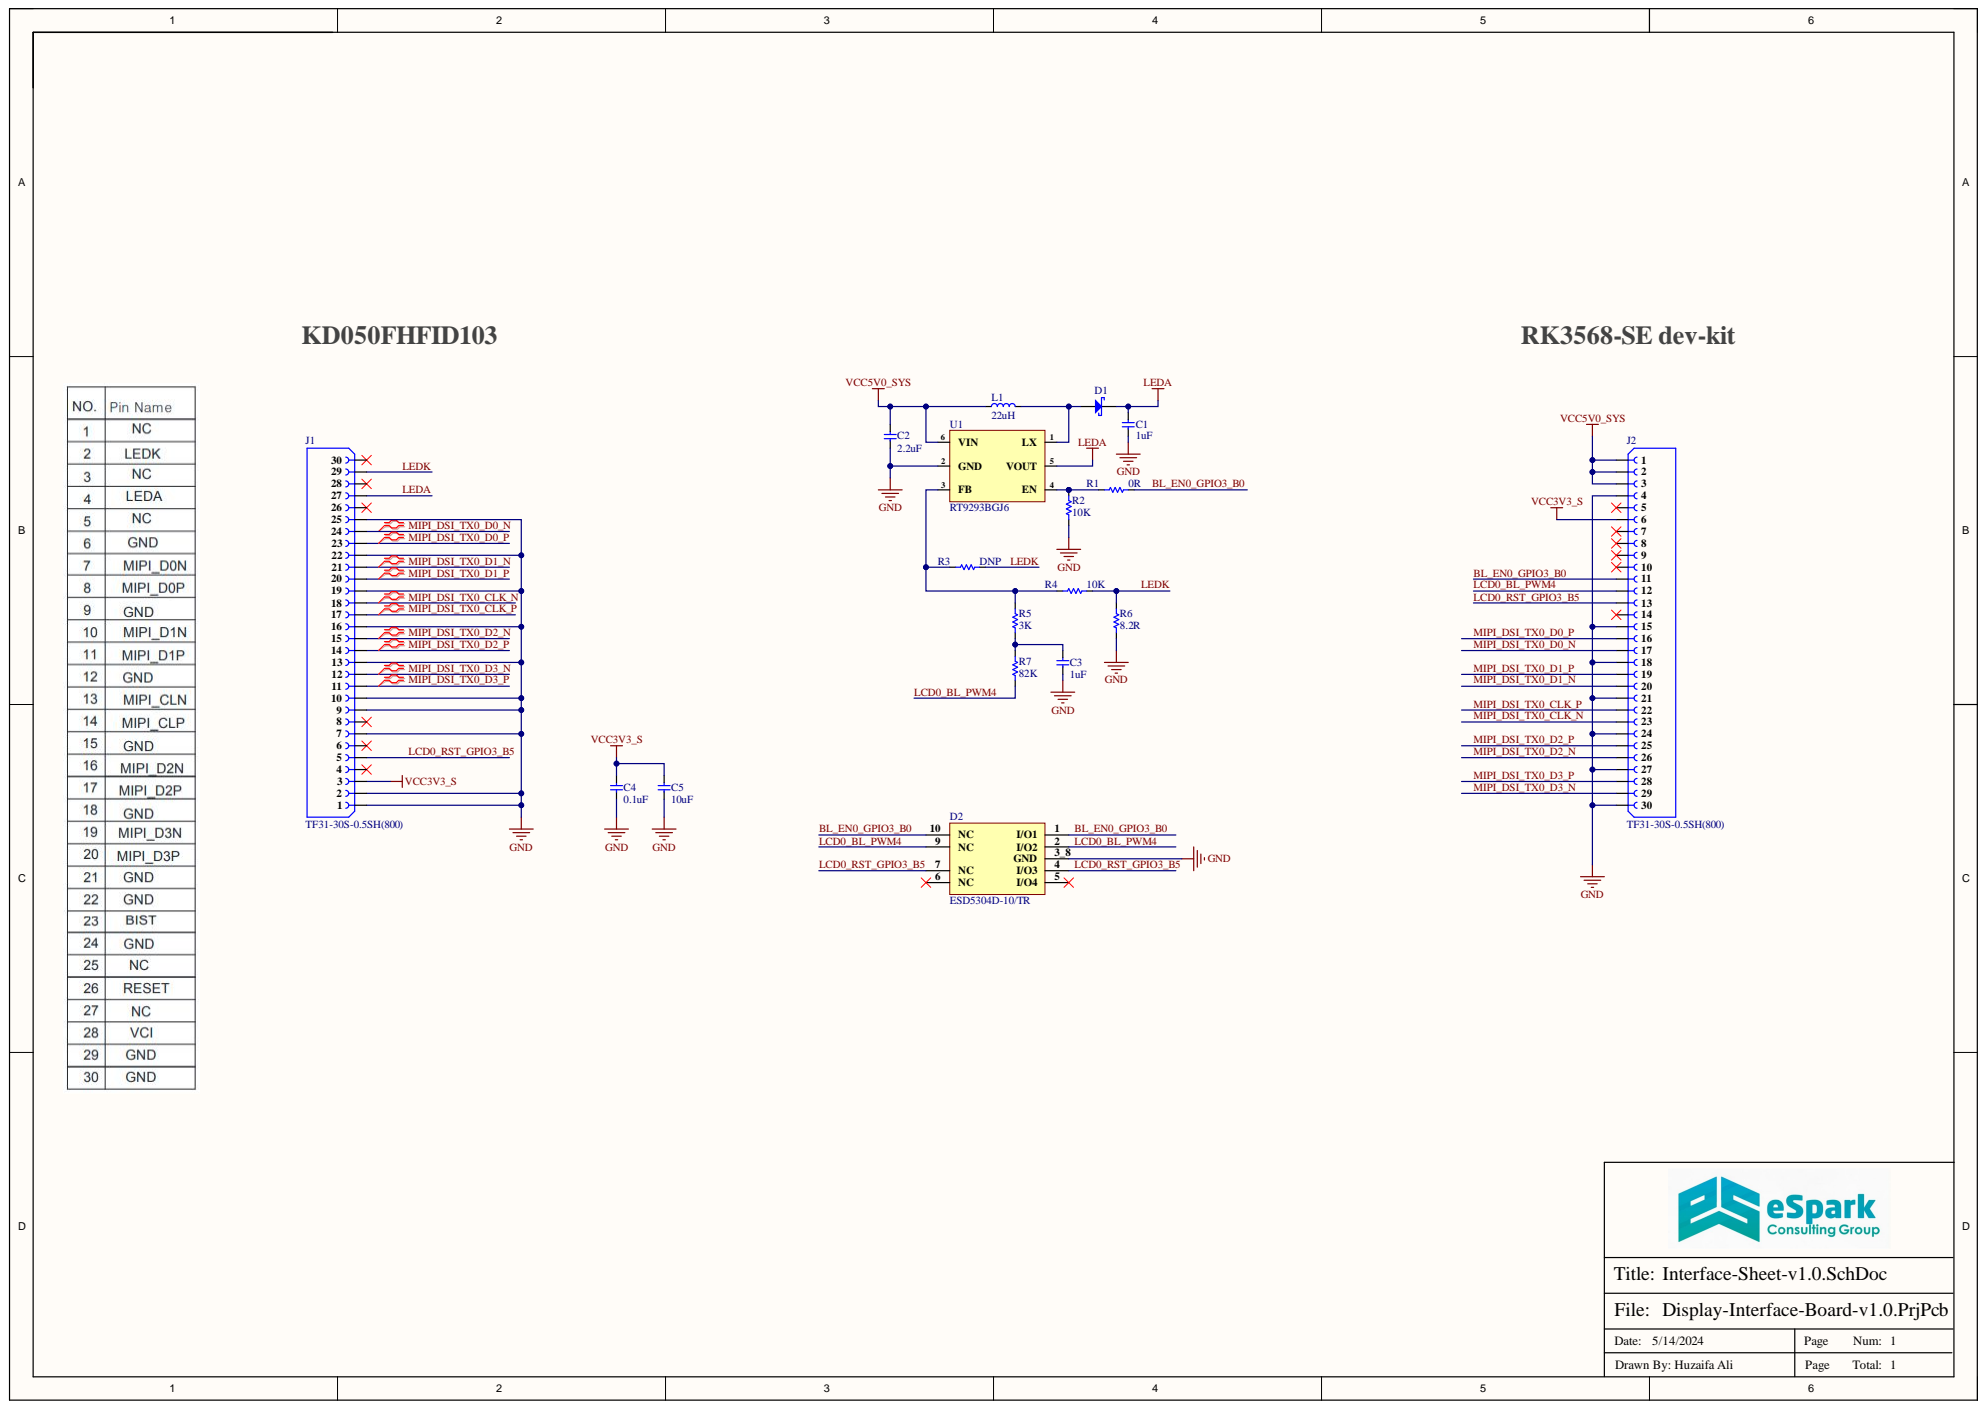
[picture p167: page 1]

Date : 5/1 4/2 0 2 4 | P a g e Nu m : 11

Drawn By: Hu z aifa Ali | P a g e T ota l :

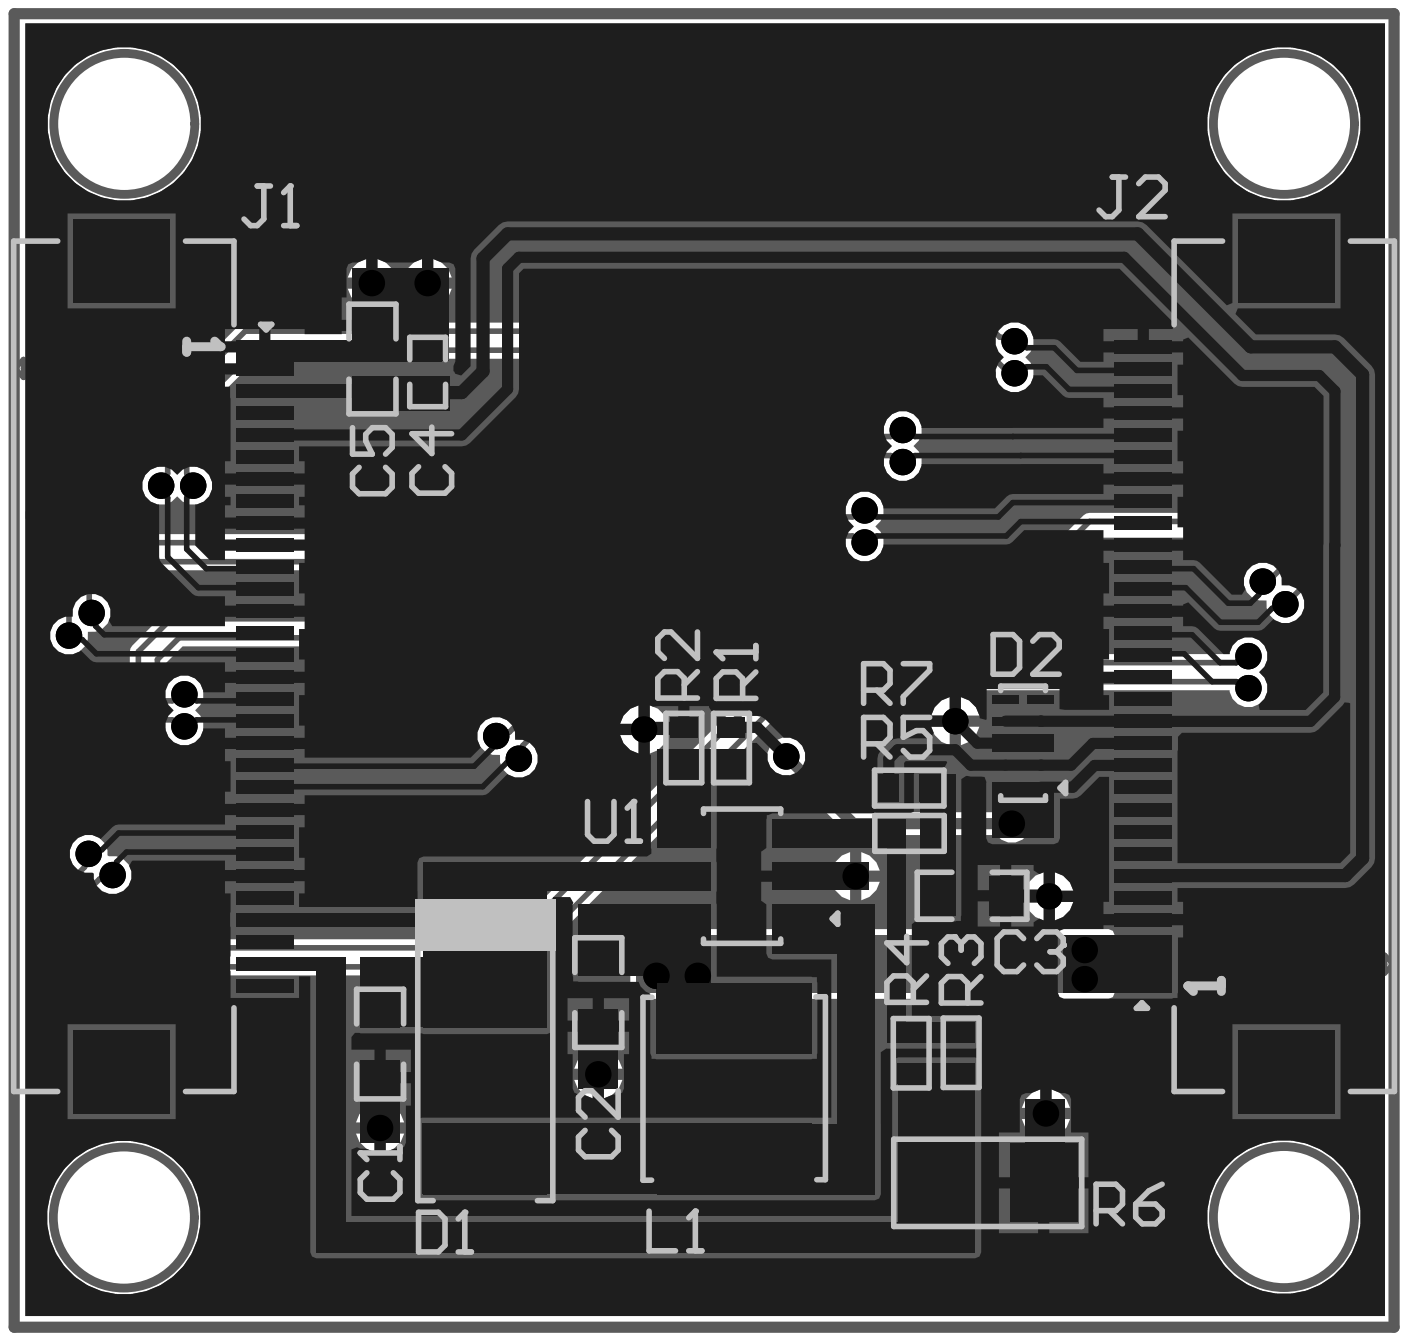
[picture p168: page 2]
