eSpark-Consulting-Group/alastair-barones-salpha/Design-Files/Breakout_Board/Breakout_Board/Deliverables/Schematic/Assembly_Drawing.pdf

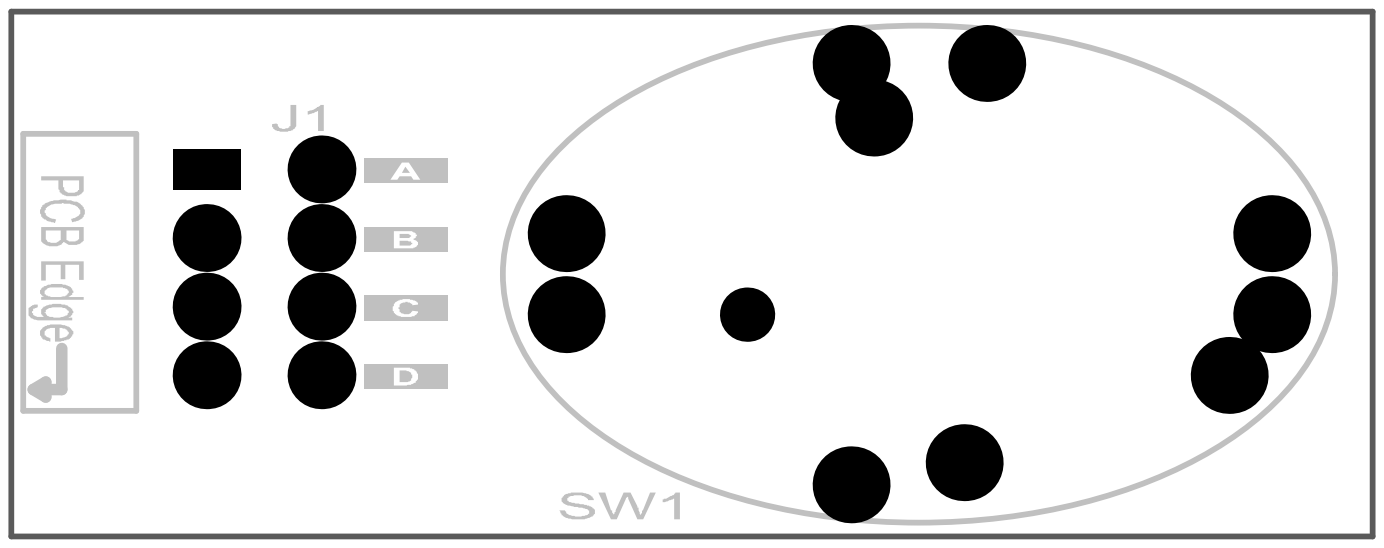
[picture p169: page 1]

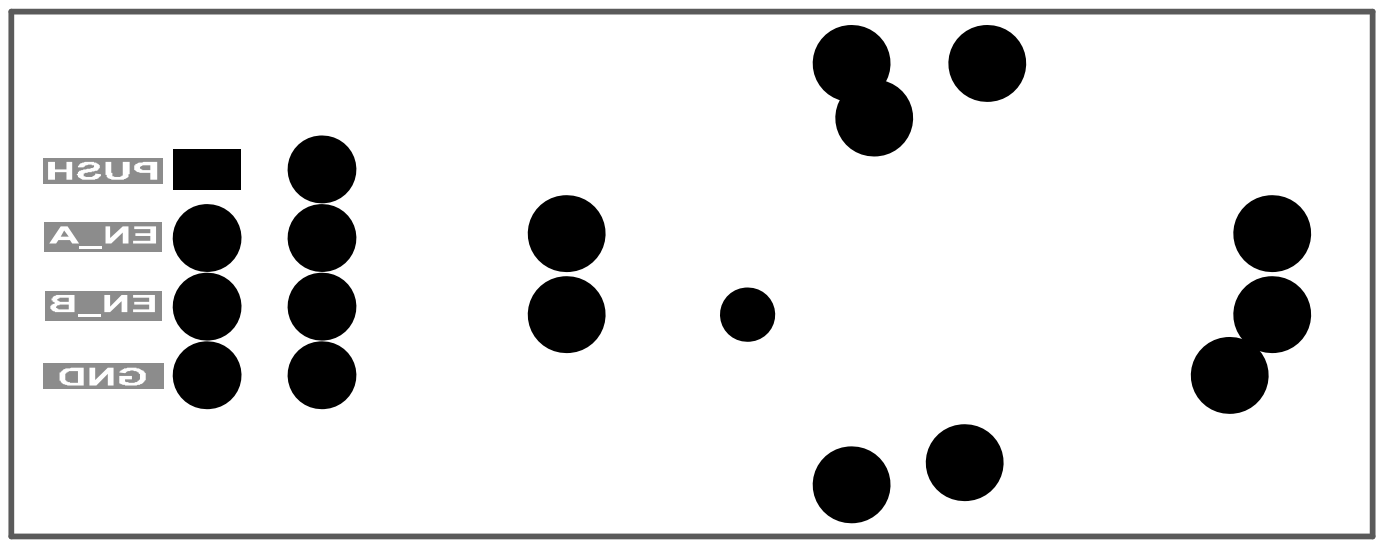
[picture p170: page 2]
