eSpark-Consulting-Group/alastair-barones-salpha/(list of files, drawings)

Other design files:
Design-Files/Breakout_Board/Breakout_Board/Breakout_Board.PcbDoc
Design-Files/Breakout_Board/Breakout_Board/Breakout_Board.PrjPcb
Design-Files/Breakout_Board/Breakout_Board/Switch_Sheet.SchDoc
Design-Files/Display-Interface-Board-v1.0/Display-Interface-Board-v1.0.PrjPcb
Design-Files/Display-Interface-Board-v1.0/Display-Interface-v1.0.PcbDoc
Design-Files/Display-Interface-Board-v1.0/Interface-Sheet-v1.0.SchDoc
Design-Files/MVP-Dash-v1.0/CAN-Bus-SPI-Flash-Sheet.SchDoc
Design-Files/MVP-Dash-v1.0/Connector-Sheet.SchDoc
Design-Files/MVP-Dash-v1.0/DRAM-LPDDR4x-Sheet.SchDoc
Design-Files/MVP-Dash-v1.0/eMMC-Sheet.SchDoc
Design-Files/MVP-Dash-v1.0/LED-Debug-Sheet.SchDoc
Design-Files/MVP-Dash-v1.0/MVP-Dash-v1.0.PcbDoc
Design-Files/MVP-Dash-v1.0/MVP-Dash-v1.0.PrjPcb
Design-Files/MVP-Dash-v1.0/Power-DC-IN-Sheet.SchDoc
Design-Files/MVP-Dash-v1.0/Power-Others-Sheet.SchDoc
Design-Files/MVP-Dash-v1.0/Power-PMIC-Sheet.SchDoc
Design-Files/MVP-Dash-v1.0/RK3568-Audio-Interface.SchDoc
Design-Files/MVP-Dash-v1.0/RK3568-DDR-PHY.SchDoc
Design-Files/MVP-Dash-v1.0/RK3568-Flash-SD-Controller.SchDoc
Design-Files/MVP-Dash-v1.0/RK3568-OSC-PMUIO-Sheet.SchDoc
Design-Files/MVP-Dash-v1.0/RK3568-Power-Sheet.SchDoc
Design-Files/MVP-Dash-v1.0/RK3568-SARADC-GPIO.SchDoc
Design-Files/MVP-Dash-v1.0/RK3568-USB-PCIe-Sheet.SchDoc
Design-Files/MVP-Dash-v1.0/RK3568-VI-Interface-Sheet.SchDoc
Design-Files/MVP-Dash-v1.0/RK3568-VO-Interface-1.SchDoc
Design-Files/MVP-Dash-v1.0/RK3568-VO-Interface-2.SchDoc
Design-Files/MVP-Dash-v1.0/Sensors-Sheet-1.SchDoc
Design-Files/MVP-Dash-v1.0/Sensors-Sheet-2.SchDoc
Design-Files/MVP-Dash-v1.0/Type-C-Sheet.SchDoc
Design-Files/MVP-Dash-v1.0/USB-Ports.SchDoc
Design-Files/MVP-Dash-v1.0/VO-HDMI2.0-TX-Sheet.SchDoc
Design-Files/MVP-Dash-v1.0/VO-LCM-MIPI-DSI-TX0.SchDoc
Design-Files/MVP-Dash-v1.0/WIFI-BT-SDIO-Sheet.SchDoc
Design-Files/MVP-Module-Dash-v1.0/MVP-Module-Dash-v1.0.PrjPcb
Design-Files/MVP-Module-Dash-v2.0/CAN-Debug-Sheet.SchDoc
Design-Files/MVP-Module-Dash-v2.0/Connector-Sheet.SchDoc
Design-Files/MVP-Module-Dash-v2.0/HDMI-Sheet.SchDoc
Design-Files/MVP-Module-Dash-v2.0/Library-Files/PcbLib1.PcbLib
Design-Files/MVP-Module-Dash-v2.0/Library-Files/Schlib1.SchLib
Design-Files/MVP-Module-Dash-v2.0/MIPI-Display-Sheet.SchDoc
Design-Files/MVP-Module-Dash-v2.0/MVP-Module-Dash-v2.0.PcbDoc
Design-Files/MVP-Module-Dash-v2.0/MVP-Module-Dash-v2.0.PrjPcb
Design-Files/MVP-Module-Dash-v2.0/Peripherals-Sheet-1.SchDoc
Design-Files/MVP-Module-Dash-v2.0/Peripherals-Sheet-2.SchDoc
Design-Files/MVP-Module-Dash-v2.0/Power-Sheet.SchDoc
Design-Files/MVP-Module-Dash-v2.0/TC-RK3568-Sheet.SchDoc
Design-Files/MVP-Module-Dash-v2.0/TF-Card-Sheet.SchDoc
Design-Files/MVP-Module-Dash-v2.0/Top-Sheet.SchDoc
Design-Files/MVP-Module-Dash-v2.0/USB-Sheet.SchDoc
Design-Files/MVP-Module-Dash-v2.0/WiFi-Sheet.SchDoc
Design-Files/Pukk MVP Controller Module-v1.0/Main Sheet.SchDoc
Design-Files/Pukk MVP Controller Module-v1.0/Pukk MVP Controller Module-v1.0.PrjPcb
Design-Files/Pukk MVP Controller Module-v1.0/Pukk MVP Controller_PCB-v1.0.PcbDoc
Design-Files/Pukk MVP Controller Module/Pukk MVP Controller Module.PrjPcb
Design-Files/Pukk-Display-Module-v1.0/CAN_SHEET.SchDoc
Design-Files/Pukk-Display-Module-v1.0/GPS_INTERFACE_SHEET.SchDoc
Design-Files/Pukk-Display-Module-v1.0/HDMI2.0_SHEET.SchDoc
Design-Files/Pukk-Display-Module-v1.0/JOYSTICK_BUTTON_SHEET.SchDoc
Design-Files/Pukk-Display-Module-v1.0/MIPI_DISPLAY-SHEET.SchDoc
Design-Files/Pukk-Display-Module-v1.0/MISCELLANEOUS_SHEET.SchDoc
Design-Files/Pukk-Display-Module-v1.0/POWER_SHEET.SchDoc
Design-Files/Pukk-Display-Module-v1.0/Pukk-Display-Module-v1.0.PcbDoc
Design-Files/Pukk-Display-Module-v1.0/Pukk-Display-Module-v1.0.PrjPcb
Design-Files/Pukk-Display-Module-v1.0/radxa_CM3J_SHEET-1.SchDoc
Design-Files/Pukk-Display-Module-v1.0/radxa_CM3J_SHEET-2.SchDoc
Design-Files/Pukk-Display-Module-v1.0/TYPE-C_INTERFACE_SHEET.SchDoc
Design-Files/Pukk-Sensor-Module-v1.0/CAN-Sheet.SchDoc
Design-Files/Pukk-Sensor-Module-v1.0/Connector-Sheet.SchDoc
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
