eSpark-Consulting-Group/alastair-barones-salpha/(commit log)

2024-03-20 #3 In Progress. Multiple Sheets added
    [MVP-Dash-v1.0.PrjPcb, Power-DC-IN-Sheet.SchDoc, Power-Others-Sheet.SchDoc, Power-PMIC-Sheet.SchDoc, RK3568-DDR-PHY.SchDoc, RK3568-Power-Sheet.SchDoc]
2024-03-21 #3 DDR, DC-IN sheet added
    [Power-DC-IN-Sheet.SchDoc, RK3568-DDR-PHY.SchDoc]
2024-03-26 #3 In Progress
    [MVP-Dash-v1.0.PrjPcb, Power-DC-IN-Sheet.SchDoc, Power-Others-Sheet.SchDoc, Power-PMIC-Sheet.SchDoc]
2024-03-27 #3 DDR-PHY, OSC-PMUIO, Flash-SD sheets added
    [MVP-Dash-v1.0.PrjPcb, Power-Others-Sheet.SchDoc, Power-PMIC-Sheet.SchDoc, RK3568-DDR-PHY.SchDoc, RK3568-Flash-SD-Controller.SchDoc, RK3568-OSC-PMUIO-Sheet.SchDoc, RK3568-Power-Sheet.SchDoc, RK3568-USB-PCIe-Sheet.SchDoc]
2024-03-28 #3 USB, SARADC-GPIO, VI, VO Interface sheets added
    [MVP-Dash-v1.0.PrjPcb, Power-PMIC-Sheet.SchDoc, RK3568-Flash-SD-Controller.SchDoc, RK3568-OSC-PMUIO-Sheet.SchDoc, RK3568-SARADC-GPIO.SchDoc, RK3568-USB-PCIe-Sheet.SchDoc, RK3568-VI-Interface-Sheet.SchDoc, RK3568-VO-Interface-1.SchDoc]
2024-03-29 #3 VO interface 2, Audio, USB sheets added
    [MVP-Dash-v1.0.PrjPcb, Power-DC-IN-Sheet.SchDoc, RK3568-Audio-Interface.SchDoc, RK3568-OSC-PMUIO-Sheet.SchDoc, RK3568-USB-PCIe-Sheet.SchDoc, RK3568-VO-Interface-1.SchDoc, RK3568-VO-Interface-2.SchDoc, USB-Ports.SchDoc]
2024-04-01 #3 USB, LED-Debug, LPDDR4x, eMMC sheets added
    [DRAM-LPDDR4x-Sheet.SchDoc, LED-Debug-Sheet.SchDoc, MVP-Dash-v1.0.PrjPcb, MicroSD-SPI-Flash-Sheet.SchDoc, RK3568-DDR-PHY.SchDoc, RK3568-Flash-SD-Controller.SchDoc, RK3568-OSC-PMUIO-Sheet.SchDoc, RK3568-SARADC-GPIO.SchDoc]
2024-04-03 #3 HDMI, SD-SPI flash sheets added.
    [MVP-Dash-v1.0.PrjPcb, MicroSD-SPI-Flash-Sheet.SchDoc, RK3568-OSC-PMUIO-Sheet.SchDoc, RK3568-SARADC-GPIO.SchDoc, RK3568-VO-Interface-1.SchDoc, VO-HDMI2.0-TX-Sheet.SchDoc, VO-LCM-MIPI-DSI-TX0.SchDoc, eMMC-Sheet.SchDoc]
2024-04-03 #3 MIPI Display, WiFi sheet added
    [MVP-Dash-v1.0.PrjPcb, Power-PMIC-Sheet.SchDoc, RK3568-OSC-PMUIO-Sheet.SchDoc, RK3568-SARADC-GPIO.SchDoc, RK3568-VI-Interface-Sheet.SchDoc, RK3568-VO-Interface-1.SchDoc, RK3568-VO-Interface-2.SchDoc, VO-HDMI2.0-TX-Sheet.SchDoc]
2024-04-05 #3 Sheet added
    [MVP-Dash-v1.0.PrjPcb, RK3568-OSC-PMUIO-Sheet.SchDoc, RK3568-USB-PCIe-Sheet.SchDoc, RK3568-VO-Interface-2.SchDoc, Type-C-Sheet.SchDoc, VO-LCM-MIPI-DSI-TX0.SchDoc, WIFI-BT-SDIO-Sheet.SchDoc]
2024-04-08 #3 Multiple working in different sheets
    [RK3568-DDR-PHY.SchDoc, RK3568-Flash-SD-Controller.SchDoc, RK3568-USB-PCIe-Sheet.SchDoc, RK3568-VI-Interface-Sheet.SchDoc, Type-C-Sheet.SchDoc, VO-HDMI2.0-TX-Sheet.SchDoc, VO-LCM-MIPI-DSI-TX0.SchDoc]
2024-04-15 #3 Sensors addition in progress
    [MVP-Dash-v1.0.PrjPcb, Primary-Sensors-Sheet.SchDoc]
2024-04-18 #3 Circuits in sensors sheet added
    [Primary-Sensors-Sheet.SchDoc, Type-C-Sheet.SchDoc]
2024-04-24 #3 Sensors and other Sheets edited.
    [MVP-Dash-v1.0.PrjPcb, Power-DC-IN-Sheet.SchDoc, Primary-Sensors-Sheet.SchDoc, RK3568-Audio-Interface.SchDoc, RK3568-VO-Interface-2.SchDoc, Sensors-Sheet-1.SchDoc, Sensors-Sheet-2.SchDoc, Type-C-Sheet.SchDoc]
2024-04-25 #3 Schematic Complete. Top sheet remaining
    [Connector-Sheet.SchDoc, DRAM-LPDDR4x-Sheet.SchDoc, LED-Debug-Sheet.SchDoc, MVP-Dash-v1.0.PrjPcb, MicroSD-SPI-Flash-Sheet.SchDoc, Power-DC-IN-Sheet.SchDoc, Power-Others-Sheet.SchDoc, Power-PMIC-Sheet.SchDoc]
2024-04-25 #3 PDF added. Comments added in some sheets.
    [MVP-Dash-v1.0.PrjPcb, RK3568-OSC-PMUIO-Sheet.SchDoc, Sensors-Sheet-1.SchDoc, Sensors-Sheet-2.SchDoc]
2024-04-25 #3 Header added. PDF updated
    [Power-PMIC-Sheet.SchDoc]
2024-05-02 #3 Gear Selection circuit removed. Oil pressure, oil temp, coolant temp, light read signals added
    [Connector-Sheet.SchDoc, DRAM-LPDDR4x-Sheet.SchDoc, LED-Debug-Sheet.SchDoc, MicroSD-SPI-Flash-Sheet.SchDoc, Power-DC-IN-Sheet.SchDoc, Power-Others-Sheet.SchDoc, Power-PMIC-Sheet.SchDoc, RK3568-Audio-Interface.SchDoc]
2024-05-06 #4 In Progress
    [Client_BOM.xlsx, eSpark_BOM.xlsx]
2024-05-07 #4 Client and eSpark BOM Completed with LCD Peripheral
    [Client_BOM.xlsx, eSpark_BOM.xlsx]
2024-05-07 #4 Peripheral added.
    [Client_BOM.xlsx, eSpark_BOM.xlsx]
2024-05-09 #5 In Progress
    [Display-Interface-Board-v1.0.PrjPcb, Interface-Sheet-v1.0.SchDoc]
2024-05-10 #5 Interface Board Complete.
    [Display-Interface-Board-v1.0.PrjPcb, Display-Interface-v1.0.PcbDoc, Interface-Sheet-v1.0.SchDoc]
2024-05-10 #5 Schematic & PCB Complete.
    [Display-Interface-Board-v1.0.PrjPcb, Display-Interface-v1.0.PcbDoc, Interface-Sheet-v1.0.SchDoc]
2024-05-10 #3 U16 VOUT-pin 5 Connected to LEDA
    [VO-LCM-MIPI-DSI-TX0.SchDoc]
2024-05-16 #5 JLC BOM and Deliverables Created.
    [3D Step.step, Centroid File.csv, DWG.DWG, DXF.DXF, Display-Interface-Board-v1.0.PrjPcb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]
2024-05-20 #6 Placement in Progress
    [MVP-Dash-v1.0.PcbDoc, MVP-Dash-v1.0.PrjPcb]
2024-05-22 #6 in progress
    [MVP-Dash-v1.0.PcbDoc]
2024-05-31 #3 CAN bus added. Connectors changed.
    [CAN-Bus-SPI-Flash-Sheet.SchDoc, Connector-Sheet.SchDoc, MVP-Dash-v1.0.PrjPcb, MicroSD-SPI-Flash-Sheet.SchDoc, Power-DC-IN-Sheet.SchDoc, RK3568-Flash-SD-Controller.SchDoc, RK3568-OSC-PMUIO-Sheet.SchDoc, Sensors-Sheet-2.SchDoc]
2024-06-03 #3 Coolant NTC temperature sensor circuit added
    [Connector-Sheet.SchDoc, MVP-Dash-v1.0.PrjPcb, Sensors-Sheet-1.SchDoc, Sensors-Sheet-2.SchDoc, VO-LCM-MIPI-DSI-TX0.SchDoc]
2024-06-07 #7 Breakout board generated(sch pcb deliverables al done)
    [Breakout_Board.DWG, Breakout_Board.DXF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]
2024-06-10 #3 Connector changed. Encoder pins added
    [Connector-Sheet.SchDoc, Sensors-Sheet-2.SchDoc]
2024-06-11 #6 Placement Completed
    [MVP-Dash-v1.0.PcbDoc, RK3568-Flash-SD-Controller.SchDoc]
2024-06-20 #6 PCB Design is in progress
    [MVP-Dash-v1.0.PcbDoc]
2024-07-03 #6 design in progress
    [MVP-Dash-v1.0.PcbDoc]
2024-07-03 #6 Design In-progress
    [MVP-Dash-v1.0.PcbDoc]
2024-07-04 #6 In-progress
    [MVP-Dash-v1.0.PcbDoc]
2024-07-08 DDR Routing in progress
    [MVP-Dash-v1.0.PcbDoc]
2024-07-19 #3 Impedance profile added for CAN BUS Differential
    [CAN-Bus-SPI-Flash-Sheet.SchDoc]
2024-07-19 #6 Progress update
    [MVP-Dash-v1.0.PcbDoc]
2024-07-19 #3 MIPI differential impedance added in schematic
    [VO-LCM-MIPI-DSI-TX0.SchDoc]
2024-07-23 #6 DDR Delay Matching in progress
    [MVP-Dash-v1.0.PcbDoc]
2024-07-26 #6 Clearing Power
2024-07-29 #3 Differential symbols impedance updated and Net labels changed
    [Type-C-Sheet.SchDoc, VO-HDMI2.0-TX-Sheet.SchDoc]
2024-07-29 #6 DRC and Finishing remaining
    [MVP-Dash-v1.0.PrjPcb]
2024-07-31 #6 Rev# added and Deliverables created.
    [Centroid File.csv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]
2024-07-31 #6 Client BOM added
    [Client_BOM.xlsx]
2024-07-31 #6 Updated Client BOM
    [Client_BOM.xlsx]
2024-07-31 BOM generated and Deliverables added in designfile_folder
    [Breakout_Board.DWG, Breakout_Board.DXF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]
2024-08-01 J4 marked DNP #4
    [Client_BOM.xlsx]
2024-08-02 #4 Mating connector receptacle and pin part# updated in eSpark and Client BOM
    [Client_BOM.xlsx, eSpark_BOM.xlsx]
2024-08-28 #6 Impedance profiles screenshots added in Gerber File folder
2024-11-05 #9 In Progress... All required sheets added. Wiring interconnections remaining
    [CAN-Debug-Sheet.SchDoc, Connector-Sheet.SchDoc, HDMI-Sheet.SchDoc, LED-Debug-Sheet.SchDoc, MIPI-Display-Sheet.SchDoc, MVP-Module-Dash-v1.0.PrjPcb, PcbLib1.PcbLib, Peripherals-Sheet-1.SchDoc]
2024-11-07 #9 Complete. PDF Generated
    [CAN-Debug-Sheet.SchDoc, Connector-Sheet.SchDoc, HDMI-Sheet.SchDoc, MIPI-Display-Sheet.SchDoc, MVP-Module-Dash-v1.0.PrjPcb, Peripherals-Sheet-1.SchDoc, Peripherals-Sheet-2.SchDoc, Power-Sheet.SchDoc]
2024-11-08 #10 in Progress
    [CAN-Debug-Sheet.SchDoc, Connector-Sheet.SchDoc, HDMI-Sheet.SchDoc, MIPI-Display-Sheet.SchDoc, MVP-Module-Dash-v2.0.PcbDoc, MVP-Module-Dash-v2.0.PrjPcb, PcbLib1.PcbLib, Peripherals-Sheet-1.SchDoc]
2024-11-11 #10 Placement in Progress
    [MVP-Module-Dash-v2.0.PcbDoc, Power-Sheet.SchDoc]
2025-03-11 #11 Basic push for client view
    [CAN-Sheet.SchDoc, Controller-Sheet-1.SchDoc, Controller-Sheet-2.SchDoc, Controller-Sheet-3.SchDoc, Power-Sheet.SchDoc, Pukk-Sensor-Module-v1.0.PrjPcb, Sensors-Sheet.SchDoc, USB-Sheet.SchDoc]
2025-03-17 #11 Top sheet in progress
    [CAN-Sheet.SchDoc, Connector-Sheet.SchDoc, Controller-Sheet-1.SchDoc, Controller-Sheet-2.SchDoc, Controller-Sheet-3.SchDoc, Power-Sheet.SchDoc, Pukk-Sensor-Module-v1.0.PrjPcb, Sensors-Sheet.SchDoc]
2025-03-17 #11 Complete. PDF generated
    [CAN-Sheet.SchDoc, Connector-Sheet.SchDoc, Controller-Sheet-1.SchDoc, Controller-Sheet-2.SchDoc, Power-Sheet.SchDoc, Sensors-Sheet.SchDoc, Top-Sheet.SchDoc, USB-Sheet.SchDoc]
2025-03-17 #11 VBAT netlabel issue fixed. PDF updated.
    [Controller-Sheet-1.SchDoc]
2025-03-17 #12 SCH IN PROGRESS
    [CAN_SHEET.SchDoc, GPS_INTERFACE_SHEET.SchDoc, HDMI2.0_SHEET.SchDoc, JOYSTICK_BUTTON_SHEET.SchDoc, MIPI_DISPLAY-SHEET.SchDoc, MISCELLANEOUS_SHEET.SchDoc, POWER_SHEET.SchDoc, Pukk-Display-Module-v1.0.PrjPcb]
2025-03-18 #11 Test points esd added. PDF updated
    [CAN-Sheet.SchDoc, Controller-Sheet-1.SchDoc, Controller-Sheet-2.SchDoc, Power-Sheet.SchDoc, Sensors-Sheet.SchDoc]
2025-03-18 #13 Placement in-progress
    [Pukk-Sensor-Module-v1.0.PrjPcb, Pukk-Sensor-PCB.PcbDoc]
2025-03-18 #12 In Progress
    [CAN_SHEET.SchDoc, GPS_INTERFACE_SHEET.SchDoc, HDMI2.0_SHEET.SchDoc, JOYSTICK_BUTTON_SHEET.SchDoc, MIPI_DISPLAY-SHEET.SchDoc, MISCELLANEOUS_SHEET.SchDoc, POWER_SHEET.SchDoc, Pukk-Display-Module-v1.0.PrjPcb]
2025-03-19 #11 Capacitors added at power input. PDF updated.
    [CAN-Sheet.SchDoc, Power-Sheet.SchDoc]
2025-03-19 #12 Schematic Design Completed
    [GPS_INTERFACE_SHEET.SchDoc, JOYSTICK_BUTTON_SHEET.SchDoc, POWER_SHEET.SchDoc, Pukk-Display-Module-v1.0.PrjPcb, radxa_CM3J_SHEET-1.SchDoc, radxa_CM3J_SHEET-2.SchDoc]
2025-03-19 #11 Diode added in sensor sheet.
    [Sensors-Sheet.SchDoc]
2025-03-20 #12 PCB Design in progress
    [CAN_SHEET.SchDoc, MIPI_DISPLAY-SHEET.SchDoc, POWER_SHEET.SchDoc, Pukk-Display-Module-v1.0.PcbDoc, Pukk-Display-Module-v1.0.PrjPcb, TYPE-C_INTERFACE_SHEET.SchDoc, radxa_CM3J_SHEET-1.SchDoc]
2025-03-20 #13 Placement in the final stages.
    [Pukk-Sensor-PCB.PcbDoc]
2025-03-24 #11 Connector changed to test pads. GPIOs swapped as per PCB request.
    [Connector-Sheet.SchDoc, Pukk-Sensor-Module-v1.0.PrjPcb, Top-Sheet.SchDoc]
2025-03-24 #13 In-progress
    [Pukk-Sensor-PCB.PcbDoc]
2025-03-24 #11 R67 resistor updated.
    [Sensors-Sheet.SchDoc]
2025-03-24 #13 Placement Completed
    [CAN-Sheet.SchDoc, Power-Sheet.SchDoc, Pukk-Sensor-PCB.PcbDoc]
2025-03-24 #13 completed
    [Pukk-Sensor-PCB.PcbDoc]
2025-03-25 #11 Corrected GND and changed from connector to resistor.
    [CAN-Sheet.SchDoc]
2025-03-25 #13 Routing in Progress
    [CAN-Sheet.SchDoc, MISCELLANEOUS_SHEET.SchDoc, Power-Sheet.SchDoc, Pukk-Display-Module-v1.0.PcbDoc, Pukk-Sensor-Module-v1.0.PrjPcb, Pukk-Sensor-PCB.PcbDoc]
2025-03-26 #13 Routing Completed
    [Controller-Sheet-2.SchDoc, Pukk-Sensor-Module-v1.0.PrjPcb, Pukk-Sensor-PCB.PcbDoc, USB-Sheet.SchDoc]
2025-03-27 #13 Design Completed
    [Pukk-Sensor-PCB.PcbDoc]
2025-03-27 #13 Deliverables Generated
    [Centroid File.csv, Pick Place for Pukk-Sensor-PCB.csv, Pukk-Sensor-Module-v1.0.PrjPcb, Pukk-Sensor-PCB.DWG, Pukk-Sensor-PCB.DXF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]
2025-03-28 #15 Client and JLCPCB BOM added.
    [Client-BOM-Pukk-Sensor-Module-v1.0.xlsx, JLCPCB-BOM-Pukk-Sensor-Module-v1.0.xlsx]
2025-04-03 #12 Routing in Progress
    [HDMI2.0_SHEET.SchDoc, JOYSTICK_BUTTON_SHEET.SchDoc, Pukk-Display-Module-v1.0.PcbDoc]
2025-04-04 #12 Routing Completed
    [Pukk-Display-Module-v1.0.PcbDoc, Pukk-Display-Module-v1.0.PrjPcb]
2025-04-07 #12 Design Completed and Deliverables generated
    [Centroid File.csv, Pick Place for Pukk-Display-Module-v1.0.csv, Pukk-Display-Module-v1.0..DWG, Pukk-Display-Module-v1.0.DXF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]
2025-04-08 #12 Centroid File Updated
    [Centroid File.csv]
2025-04-08 #12 Deliverables updated
    [Centroid File.csv, Pick Place for Pukk-Display-Module-v1.0.csv, Pukk-Display-Module-v1.0..DWG, Pukk-Display-Module-v1.0.DXF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]
2025-04-09 #17 Client and JLCPCB BOM with peripherals added.
    [Client-BOM-Pukk-Display-Module-v1.0.xlsx, JLCPCB-BOM-Pukk-Display-Module-v1.0.xlsx]
2025-04-10 #16 Battery Peripheral Link update in Client BOM
    [Client-BOM-Pukk-Display-Module-v1.0.xlsx]
2025-04-28 #18 Schematic and PCB with deliverables Completed.
    [Centroid.csv, Client-BOM-Pukk MVP Controller Module.xlsx, Client-BOM-Pukk-Display-Module-v1.0.xlsx, JLCPCB-BOM-Pukk-Display-Module-v1.0.xlsx, JLCPCB-BOM-Pukk-Sensor-Module-v1.0.xlsx, Main Sheet.SchDoc, Pick Place for Pukk MVP Controller_PCB.csv, Pukk MVP Controller Module.PrjPcb]
2025-04-28 #18 Folder name added
    [Centroid.csv, Client-BOM-Pukk MVP Controller Module.xlsx, Main Sheet.SchDoc, Pick Place for Pukk MVP Controller_PCB.csv, Pukk MVP Controller Module.PrjPcb, Pukk MVP Controller_PCB.DXF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]
2025-04-28 #12 Encoder Added in SCH and PCB and Deliverables generated
    [Centroid File.csv, JOYSTICK_BUTTON_SHEET.SchDoc, Pick Place for Pukk-Display-Module-v1.0.csv, Pukk-Display-Module-v1.0..DWG, Pukk-Display-Module-v1.0.DXF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]
2025-05-05 #18 Version no added.
    [Centroid-v1.0.csv, Client-BOM-Pukk MVP Controller Module-v1.0.xlsx, Main Sheet.SchDoc, Pick Place for Pukk MVP Controller_PCB-v1.0.csv, Pukk MVP Controller Module-v1.0.PrjPcb, Pukk MVP Controller_PCB-v1.0.PcbDoc, Pukk MVP Controller_PCB.DXF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]
2025-05-08 #19 Order Placed in JLCPCB.
    [JLCPCB-BOM-Pukk MVP Controller Module-v1.0.xlsx]
